xiaobaoaaaaaa/ESPaperPlay-V2/docs/v2/hardware/README.md

# ESPaperPlay v2 硬件设计基线

状态：已完成[r10制造整改](pcb-dfm-r10.md)，160×110mm、236个电气位置加4个机械孔，已完成布线、双内层铺地与原理图一致性核对，0未连接；尚未上电。十一页原理图为[r6模块化绘图](schematic-layout-r6.md)，电气沿用[r5充电与温控](charging-design-r5.md)，774个逻辑引脚保持，ERC为0违规。NTC仍为用户授权的Honeywell曲线假设。更新日期：2026-11-14。

[r10](pcb-dfm-r10.md)已整改64个近焊盘孔、明确11个热孔填平盖帽并补齐官方名义阻抗窗口；203位回流、27位手焊方案保持。当前文件进入板厂生产稿确认与首板准备阶段，尚未下单。r9报告保留历史。

[首批准备r11](first-batch-preparation-r11.md)按5块PCB、先焊2块、280×380×0.10mm无框钢片落实加工要求、64种备料及具体首板工作单。PCB仍r10；工厂真实回复、关键电容来料与维护固件是各阶段的后续输入，尚未对外提交。

用户已经确定复用现有 7.5 英寸屏幕，重做主板；保持 ESP32-S3-WROOM-1-N16R8，暂不增加蓝牙耳机支持。本目录把这些约束转成可用于画原理图和验证样机的设计输入。

## 已确认的范围

| 项目 | 基线 | 实现状态 |
| --- | --- | --- |
| 主控 | ESP32-S3-WROOM-1-N16R8，16 MB Flash、8 MB PSRAM | 固定型号，不迁移到 WROOM-2 |
| 屏幕 | 现有 GDEY075T7-T01、800×480、UC8179，与现有 GT911 触摸总成 | 复用屏幕与纯延长件，以原厂文档针序/机械图设计 |
| 存储 | microSD，SDMMC 4-bit 布线、独立供电、卡检测 | r2已落图；IOX P13独立控制SD_IO_EN，旧固件默认仍为1-bit |
| 音频 | 单扬声器播放、数字麦克风录音、I²S | 用户选3525腔体8Ω/2W；PUI专用声孔封装已有候选，首测48kHz/64fs，声学/贴装待验 |
| 电源 | 单节锂电、带系统电源路径的充电管理、低静态电流 3.3 V 升降压 | 新设计 |
| 电源域 | 屏幕、触摸、SD 和音频分别控制 | 新设计；旧板前三项共轨 |
| 电池管理 | ZON.CELL 755570、1S、标称3.7V、4000mAh，带保护和10kΩ NTC | 按1S/4.2V设计假设、保守容量/负载预算推进；实际CV/NTC及充电仍须验证，R108继续DNP |
| USB | USB-C 供电与 USB 设备模式，保留下载/调试入口 | 首版不提供 USB Host 供电 |
| 操作 | 独立正常电源键、两个可复用的翻页/音量键，另留 BOOT/EN | 新键位与唤醒关系见 GPIO 表 |
| PCB | 四层独立开发板、160×110mm、天线净空、测试点和测流入口 | r10近孔整改、双内层铺地及CAM复核完成；工厂生产稿与实板验证待进行 |

主机接口与内存预算按 N16R8 设计。额外存储通过 SD 提供；16 MB Flash 的分区需给双槽 OTA 和必要离线启动资源留空间，不能直接继承旧版 8 MB 字体分区。完整字体、书籍和媒体放 SD。

## 设计规格与三张设计表

- [首批准备r11](first-batch-preparation-r11.md)：具体加工要求、备料数量、工厂回复模板与两块板独立上电记录。
- [制造整改r10](pcb-dfm-r10.md)：64孔整改、全孔余量检查、11孔明确工艺及官方阻抗窗口。
- [制造装配审查r9](manufacturing-review-r9.md)：工艺能力、Gerber/钻孔回读、自装钢网修正、装配分组及制造放行条件。
- [PCB布线r8](pcb-routing-r8.md)：层叠、USB/SD路径、电源铜阻、回流孔、原生DRC及制造边界。
- [PCB布局r7](pcb-layout-r7.md)：四层独立开发板、接口朝向与机械空间、器件布局、原生检查及后续布线约束。
- [原理图模块化重排r6](schematic-layout-r6.md)：模块内部直连、主件与上下拉/去耦归组，电气与BOM保持r5。

- [2026-11-04设计假设](design-assumptions-2026-11-04.md)：电池保守预算；用户确认纯延长件，以文档针序推进，不再索取额外转接板信息。
- [中顺芯官网电池核查](battery-zoncell-2026-11-04.md)：三线系列4.2V、10–45°C、0.1C充电及175/10kΩ NTC资料；保留精确型号适配和计时验证。

- [充电与温控r5](charging-design-r5.md)：约0.7A、ITERM30mA及独立TS温控的实际原理图、模型和样机验收。
- [开发验证板电源规格](power-design-spec.md)：保留r0工程目标，加入r4反馈/保险丝预算、4000mAh电池和禁充条件。
- [KiCad原理图与当前检查](../../../hardware/devboard-r0/README.md)：十张功能页与一张索引；正式版本与机器检查结果以工程记录为准。
- [条件闭合审查r4](closure-review-r4.md)：30个MLCC候选、7个原空封装、保留的FPC延长链路、反馈/PTC/充电预算及具体剩余门槛。
- [BOM与封装审查r3（历史）](bom-footprint-review-r3.md)：保存当时215个封装、184个MPN和7个封装空缺的审查证据，不覆盖r4选择。
- [外设电路设计r2](peripheral-design-r2.md)：EPD升压/FPC、SD隔离与插座、音频时钟与缓冲，以及尚待验证的电气边界。
- [GPIO 分配与接口约束](gpio-allocation.md)：旧配置事实、新板候选引脚、保留引脚和扩展器取舍。
- [电源域与工作状态](power-domains.md)：供电结构、各状态开关、时序和软硬件契约。
- [功耗与峰值电流预算](power-budget.md)：待填预算、计算方法、测量条件和样机验收。

## 设计环境与原厂资料

- [KiCad 本机环境](kicad-environment.md)：Fedora RPM 安装、标准库配置、命令行检查与重启后的 GUI/3D 检查记录。
- [屏幕与触摸参考](panel-reference.md)：准确型号的原厂资料、接口与机械约束、资料差异及本机下载索引。
- [电源原厂资料](../../../hardware/reference/power/README.md)：电源和控制器件数据手册、修订版本、来源与文件哈希。
- [外设原厂资料](../../../hardware/reference/peripherals/README.md)：r2屏幕驱动、SD隔离/插座与音频候选的资料归档和核对边界。
- [r4闭合资料归档](../../../hardware/reference/closure-r4/README.md)：新增原厂图、精确型号来源、真实文件哈希及在线资料/下载缺口；用户商品截图单独保留。
- [旧版嘉立创工程](legacy-project.md)：原始归档、有效图页、PCB 信息与格式兼容边界。
- [旧板六页静态审查](review/README.md)：已核实的连接、优先修改项、可保留设计与待测项目；包含当前核心板 SD 适配说明。

## 第一块 PCB：开发验证板

先设计一块与最终架构等价、便于测量的开发验证板，再收紧为产品尺寸。它仍使用 N16R8 和现有屏幕，不为测试引入更大的主控或额外内存，以免掩盖资源限制。

- 留出探针与夹具空间，不受最终外壳厚度和按键排布约束；天线、功放、麦克风、开关电源的实际布局约束仍需遵守。
- 每个外设域设置可断开的连接/测流位置，允许分别验证默认状态、上电浪涌、关断漏电和信号倒灌。
- 电池、USB、SYS、主 3.3 V、各外设轨、EN/BOOT、I²C、EPD BUSY、SD 和 I²S 关键节点有标注清楚的测试点；高速支路避免过长测试引出造成信号完整性问题。
- 电源与音频元件周围预留调试替换位置，输入、主稳压和音频支路可独立检查；测试跳线不能让正常使用时绕过电池保护或短接两个电源。
- 验证 USB 插拔与充电运行、低电量瞬态、唤醒与掉电隔离、扩展器复位/总线恢复，以及 SD/音频/Wi-Fi/EPD 并发，再冻结紧凑主板布局。

在验证板前，可以用器件评估板或模块先测充电、稳压与负载开关，这是缩小选型风险的台架工作；模块连线测试不能代替最终 PCB 的功耗、信号完整性与噪声验收。当前交付范围是本地设计文档和固件工程，不包含下单、采购或 PCB 制造。

## 器件候选与尚未冻结的参数

| 功能 | 候选/约束 | 定型前必须确认 |
| --- | --- | --- |
| 充电与电源路径 | **[BQ24074](https://www.ti.com/product/BQ24074) 优先**，BQ25185备选 | r5约0.7A/9.07h和独立NTC温窗已落图；实际曲线、CV及散热待测，RTMR限制18–72kΩ |
| 主 3.3 V | [TPS63802](https://www.ti.com/product/TPS63802) 一类低静态电流升降压 | 最低电池电压时的输出、瞬态、效率、电感/电容与温升 |
| 电量计 | [MAX17048](https://www.analog.com/en/products/max17048.html) | 所选电池与补偿方法，实测荷电状态误差；它不是电池保护电路 |
| 数字功放 | [MAX98357A](https://www.analog.com/en/products/max98357a.html)，受控SYS供电 | 3525腔体8Ω/2W，首轮按输出≤0.5W预算；不加5 V音频升压，实际限幅/功耗/噪声待验 |
| 麦克风 | PUI DMM-4026-B-I2S-R候选；3.3 V、7焊盘、PCB Ø0.60mm声孔 | 专用铜环/声孔/焊膏候选已定义；贴装、声学、生命周期和供货仍待确认，首测48kHz/双32-bit槽/64fs |
| 外设开关与信号隔离 | [TPS22918](https://www.ti.com/product/TPS22918)候选；触摸四线与SD六线使用[TMUX1511](https://www.ti.com/product/TMUX1511)；屏幕/音频使用跨域缓冲 | 默认关断、浪涌、放电与供电过渡逐项验证；音频锁定有Ioff规格的Nexperia 74LVC125APW,118及TI SN74LVC1G14，不能只凭通用型号替换 |
| 低速 GPIO 扩展 | **[TCA9539](https://www.ti.com/product/TCA9539)**，16-bit带RESET | 取代TCA9534候选；GPIO42独立复位、0x74地址，先写安全锁存再方向 |
| 离线时钟 | 低功耗 RTC 可选，不作为第一版必装器件 | 离线精度目标、备份方式、专用唤醒引脚分配 |
| 电池 | 用户选755570、4000mAh、带保护和10kΩ NTC | 商品声明常温2A/低温800mA，瞬时3A时长未给；充电/NTC/保护阈值与线束待核，不批准低温满载 |

ICS-43434 的 [TDK InvenSense 产品页](https://www.invensense.tdk.com/en-us/products/microphone/ics-43434) 在本轮审查时标为 EOL；已有库存可用于参考验证，不进入新版长期默认 BOM，详见音频审查。

下一步按[最新设计假设](design-assumptions-2026-11-04.md)继续制造工艺、插拔空间和线束复核；关键MLCC资料继续核对。电池充电/NTC适配及动态/温升试验在各自阶段完成，不要求所有实测先于测试板制作。F501已选MF-MSMF200/16X-2并按1.08447A输入预算复核高温保持电流；故障保护仍待测。R602已有准确2010候选与电流/端温包络，不能当成升压电流已实测。反馈分压新增约49.34µA的3V3负载须计入P01；默认下拉R215/R223/R306/R416仍为10k，使能高时每个约330µA。

## 资料与验证边界

旧板事实来自提交 `0f6d7c349afdbbeb962a736d84036ce7f8487174` 的 [板级配置](https://github.com/xiaobaoaaaaaa/ESPaperPlay/blob/0f6d7c349afdbbeb962a736d84036ce7f8487174/components/board/include/espaperplay_config.h) 和 [硬件说明](https://github.com/xiaobaoaaaaaa/ESPaperPlay/blob/0f6d7c349afdbbeb962a736d84036ce7f8487174/docs/hardware.md)。这是固件记录，不等同于原理图审查；旧板原理图、PCB、BOM保存在独立的嘉立创EDA Pro工程中，新板原理图位于本仓库的KiCad工程。

屏幕/触摸纯延长链按原厂文档作为设计输入；接触面、方向和尺寸按图纸安排，H01做常规装配检查。供电、触摸选址时序和刷新行为在样机验证。旧版 `docs/storage.md` 的引脚表不能覆盖较新的板级配置。新板候选引脚不应复制进旧板固件，也不能据本目录直接生成生产文件。

硬件发布条件是原理图/ERC、PCB/DRC、GPIO/启动状态核对、器件规格与供货核对、样机电源和功能验证都完成。软件构建通过仅证明固件可以编译，不证明新板已经工作。
