xiaobaoaaaaaa/ESPaperPlay-V2/hardware/reference/charge-r5/README.md

# r5充电电路原厂资料

2026-11-04下载TI TLV1822、BQ24074及Vishay D/CRCW e3原厂PDF；URL、修订说明及SHA256见[sources.json](sources.json)。TLV1822D的8针定义与D0008A示例铜图已经渲染核对，0.25V/4mV表格的12V条件保留为模型限制。

Honeywell曲线复用[先前检索归档](../ntc175-2026-11-04/sources.json)：工程图由经销商镜像提供，不能因此证明电池采用该NTC。中顺芯依据仍为[三线系列官网归档](../zoncell-2026-11-04/)。本轮用户授权将该曲线作为设计假设。

候选型号和封装不等于库存、装配或充电实测结果。详见[设计报告](../../../docs/v2/hardware/charging-design-r5.md)。
