xiaobaoaaaaaa/ESPaperPlay-V2/hardware/reference/closure-r4/README.md

# r4 条件闭合资料索引

日期：2026-11-02。原厂材料保留其原版权；本目录用于开发候选核对，不是制造放行。

索引见 [sources.json](sources.json)，实际文件校验见 [SHA256SUMS](SHA256SUMS)。路径以仓库根为基准。已存在的 r3/电源/屏幕资料复用原文件，不重复保存；新下载的真实 PDF/JPG 放在 `files/`。

- HOAUC、LAILAN 是经销商托管的原厂图；Hirose 是带旧下载水印的原厂旧版图，不冒充 2024 最新版本。
- Phoenix Contact 1751248 型号页与其官方尺寸/孔位图相互对应；2.2mm 焊盘是工程选择，不是原厂孔径要求。
- TDK 精确型号页提供候选身份/规格；没有可归档的有效 DC 偏压曲线数值，因此没有声称最低有效容量已保证。
- PUI 应用指南经官方网页/文档文本核实；原始下载返回验证页面，未保存伪 PDF 或虚构原始文件哈希。
- 电池和扬声器由用户截图选定，另见 [用户资料](../user-selected-r4/selected-components.json)。商品截图不是工厂充电/保护数据表。

完整工程审查见 [r4 报告](../../../docs/v2/hardware/closure-review-r4.md)，逐位候选见 [BOM](../../devboard-r0/review-r4/bom-review.json)。
