xiaobaoaaaaaa/ESPaperPlay-V2/hardware/reference/good-display/README.md

# 大连佳显屏幕与触摸资料

获取日期：2026-11-01。对象是现有 **GDEY075T7-T01** 触摸电子纸总成，来源为大连佳显官方产品页及其指向的 CDN。

- [中文产品页](https://www.good-display.cn/blank7.html?productId=477)
- [英文产品页](https://www.good-display.com/product/483.html)
- [接口核对与待确认事项](../../../docs/v2/hardware/panel-reference.md)
- [完整来源、文件版本与检查记录](sources.json)
- [SHA-256 清单](SHA256SUMS)

| 本机原始文件 | 用途 | 定位 |
| --- | --- | --- |
| `GDEY075T7-T01.pdf` | 总成规格、EPD 接口与参考电路 | p2 版本；p4–8 机械/电气；p38 外置升压外围 |
| `GDEY075T7-T01-CAD.pdf` | 两条 FPC、尺寸、触点厚度与编号方向 | p1 |
| `TP075-Y01.pdf` | GT911 触摸层与 6Pin FPC | p1 |
| `GT911-Datasheet-English-20150625-Rev10.pdf` | 控制器通信、复位、地址选择、电气条件 | p11–12、p22 |
| `T075T7_GT911_Arduino.rar` | 厂商示例，供协议交叉检查 | 内部目录 `T075T7_Arduino_V2.3.5` |

这些 PDF/压缩包是厂商原文件，不属于 ESPaperPlay 的 MIT 授权范围。本目录通过 `.gitignore` 将原文件保留为本机参考；版本库只记录索引、来源和哈希。GT911 文档自身包含 Goodix 的再分发限制。以后克隆仓库时，可按 `sources.json` 的 `asset_url` 从官网下载；不要把下载结果重新授权为本项目代码。

在本目录运行 `sha256sum -c SHA256SUMS` 校验文件。下载需要浏览器 User-Agent / 官网 Referer 时，使用正常浏览器或等效请求头即可。

资料检查记录：

- 总成规格书实际为 13,114,117 字节、45 页，与官网显示的 4.8M 不一致。p2 标为 Rev.1.0 / 2024-03-10，PDF 修改时间为 2025-11-06；保留各字段原意，不将网页更新日期当作新修订号。
- 总成规格书有 PDF xref / `FXE3` 格式警告；未改写原文件，p6、7、8、38 已渲染并目视核对。不能只依赖复制出来的表格文本。
- 总成图纸网页更新于 2025-02-25，图签仍为 2023-05-26。触摸图纸网页也标更新于 2025-02-25，图签仍为 2023-07-12。
- `TP075-Y01.pdf` 中英文官网下载件 SHA-256 相同，仅保留一份。
- RAR5 已通过 libarchive 检查：9 个条目、解压总长 795,521 字节；均为相对路径，无链接和路径穿越。仅在临时目录解包阅读，未执行示例、未写入固件。当前系统的 7z 未包含 RAR 解码支持。
- 网站虽把压缩包分类为 ESP32 示例，内部采用 Arduino A3/A4/A5 等引脚假设，不能直接作为新 ESP32-S3 主板的接线依据。
