xiaobaoaaaaaa/ESPaperPlay-V2/docs/v2/hardware/power-budget.md

# 功耗与峰值电流预算

> 版本说明（2026-11-14）：下文是r4历史预算，包含旧R104=3kΩ/约297mA等值，不是r10现板的充电设置。当前约0.7A/30mA及独立温窗以[r5充电设计](charging-design-r5.md)为准；本批接线和验收使用[r11首板工作单](../../../hardware/devboard-r0/review-r11/first-board-checklist.md)。R108仍DNP、J105开放，实测列仍为空。历史计算保留供追溯。

> 2026-11-04补充：[电池保守预算](design-assumptions-2026-11-04.md)暂用75%可用能量系数、20–30°C、总电池电流≤1A且不另给短峰值余量。低负载例约0.869A；下文r4主轨1A/1.5A数字保留为台架能力目标，不是本阶段实物电池负载许可。

状态：预算与测量模板，保留[电源规格](power-design-spec.md)的首轮台架目标，更新至[r4条件闭合](closure-review-r4.md)。**已有十页原理图r4候选，用户已选755570/4000mAh电池与3525腔体8Ω/2W扬声器，尚无PCB样机、电流或续航实测值，制造BOM未冻结。** `待定`/`未测`不是零，也不是通过。本文区分器件计算包络、商品声明与整机测量。

## 统一计算口径

- 能量使用 Wh，功率使用 W，电流使用 A，时间使用 h；短脉冲记录另外使用 ms/µs。
- 先记录各输出电源轨的负载，再按对应效率换算到电池端；不要把 3.3 V 轨电流与电池电流直接相加。
- 持续额定值、典型平均值、瞬态峰值分别填写。数据手册条件和实测条件必须保留。
- 电池最低工作电压、允许温度范围、扬声器最大音量、Wi-Fi 发射、SD 写入和屏幕启动是峰值验证的重要组合；具体边界由器件规格与最终使用要求确定。

## 器件与电源轨预算表

| 负载/电源路径 | 供电轨 | 持续最大电流预算 | 瞬态峰值及持续时间 | 关断/待机电流 | 当前依据/状态 |
| --- | --- | --- | --- | --- | --- |
| S3 模组，含 Flash/PSRAM | 3V3_AON | 待定 A | 待定 A / ms | 未测 | 按 N16R8 模组与实际 CPU/Wi-Fi 模式核算 |
| EPD 驱动与面板 | EPD | 待定 A | 待定 A / ms | 未测 | r2已按参考电路绘制升压与输出缓冲；全刷/灰阶/上电波形待测 |
| GT911 触摸 | TOUCH | 待定 A | 待定 A / ms | 未测 | 普通扫描与实际待机模式分别测量 |
| microSD与六线隔离 | SD | 待定 A | 待定 A / ms | 未测 | 包括两颗TMUX1511和卡侧上拉；用最终卡型测启动、写入和内部整理脉冲，核对候选插座0.5 A额定值 |
| 数字麦克风与输出缓冲 | MIC | 待定 A | 待定 A / ms | 未测 | PUI DMM-4026-B-I2S-R专用声孔封装候选已定义，首测48kHz/64fs；计入Nexperia 125与TI施密特1G14，贴装/供货待核 |
| 功放与扬声器 | AMP/SYS | 待定 A | 待定 A / ms | 未测 | 已选8Ω/2W商品，首轮按音频输出≤0.5W作预算；实际限幅、效率和电流待测 |
| GPIO 扩展器与 I²C 上拉 | AON | 待定 A | 待定 A / ms | 未测 | 包含静态拉低时的电阻电流和掉电支路漏电 |
| EPD BUSY与麦克风数据返回缓冲 | AON | 待定 A | 待定 A / ms | 未测 | 两颗SN74LVC1G125保持AON供电，计入睡眠静态电流与输入状态影响 |
| 电量计/检测/可选 RTC | BAT/AON | 待定 A | 待定 A / ms | 未测 | 逐项记录供电位置，避免重复计入 |
| 主升降压损耗 | SYS→3V3 | 不作为输出负载重复相加 | 按最差输入检查 | 未测 | 按工作点效率曲线与样机测量换算 |
| 充电芯片/保护/负载开关 | USB/BAT/SYS | 按路径计算 | 待定 | 未测 | 计入静态电流、压降和各器件关断漏电 |

TPS63802 标称输出能力与静态电流可以帮助选型，但不等于整板在最低电池电压和最高温度时仍具备相同供电能力；电感饱和、限流、PCB 散热和瞬态都须核对。[候选稳压器数据](https://www.ti.com/product/TPS63802)

## r4已计算边界

以下来自[电源边界计算](../../../hardware/devboard-r0/review-r4/power/power-bounds.json)和[独立温漂复核](../../../hardware/devboard-r0/review-r4/audio_boost/independent-power-review.json)，全部是指定假设下的预算，**没有填入实测列**。

| 项目 | 当前计算 / 选择 | 适用条件与剩余验证 |
| --- | --- | --- |
| 主轨反馈 | R201=51.1kΩ / TNPW060351K1BEEA；R202=9.10kΩ / TNPW06039K10BEEA，均0.1%/25ppm；PWM包络3.2494–3.3666V | 电阻本体−40～85°C，每颗0.1%老化预算，PWM反馈±1%及保守±100nA输入偏流模型；PFM/瞬态/布局仍待测 |
| 反馈静态负载 | 精确3.3V时分压54.82µA，较旧511kΩ/91kΩ多49.34µA | 这是3V3轨负载，须计转换效率才能与电池端P01比较；不是待机实测 |
| BQ可编程输入档 | R103=1.62kΩ±1%，温漂后约0.91084–1.07947A；加5mA旁路分配为 **1.08447A** | 外阻100ppm/K、−40～85°C、未计老化；BQ电气参数只保证TJ0～125°C，不能外推负温度 |
| F501正常保持 | MF-MSMF200/16X-2；Ihold50°C=1.68A、60°C=1.48A；预算占60°C保持值73.27% | 已解决原110型号的高温正常载流不匹配；短路、TVS、高温阻值/压降及实际温升待测，默认100mA不变 |
| BQ充电与定时 | R104=3kΩ候选为0.26134–0.33043A；R105=68kΩ为6.688–11.521h，名义9.07h | 同上温漂与结温范围；4Ah÷296.67mA约13.48h，现组合不批准充电，R108保持DNP；RTMR只允许18–72kΩ |
| 电池首轮负载 | 20–30°C、主轨1A、音频输出0.5W，估算约1.592A | 假设SYS2.9V、两个效率各85%、其他电池电流50mA；2A只是商品常温连续声明，实际压降/保护/效率待测 |
| 主轨1.5A压力点 | 加相同音频估算约2.261A | 先用台架源；商品瞬时3A未给时长/保护延时，不能据此批准所选电池的100ms测试；10°C以下无满载许可 |

电池截图与边界见[用户配件清单](../../../hardware/reference/user-selected-r4/selected-components.json)。常温/低温声明不能用作充电温区；当前没有已验证的TS到MCU温度测量路径，以上限制尚不是自动执行的固件功能。

关键电容的有效容量验收为：C102在5.0V、C103在4.5V各≥4.7µF（项目保守规则）；C201在5.0V≥4µF、C202在3.6V≥7µF（TPS63802明确有效值）。准确MPN不等于偏压/温度/老化已经通过。CT改为C0G±5%；各域直接并联标称总量为EPD27.8µF、SD32.3µF、TOUCH4.9µF、MIC2.3µF、AMP32.1µF，22µF器件实际为±20%。[电容计算](../../../hardware/devboard-r0/review-r4/capacitors/calculations.json)列出正公差与温度预留情景，用于涌流试验起点；它不是所有偏压/温度组合的保证上界。EPD高压电容充电能量另计，C602按端到端应力、C610按VCOM核验。

## 工作场景预算表

每个场景最终需保存原始仪器数据和固件版本。目标电流与通过阈值必须在样机验收前填写，不能事后按测量结果调整为“通过”。

| 场景 ID | 场景 | 平均电池电流目标 | 平均实测 | 峰值实测/时长 | 占空比或每日时长 | 状态 |
| --- | --- | --- | --- | --- | --- | --- |
| P01 | 软关机：深睡、各外设轨关闭 | ≤200 µA，3.7 V/25±5°C/无USB，稳定后10 min平均 | 未测 | 未测 | 待定 | 未验证 |
| P02 | 静态阅读：触摸可唤醒、无网络任务 | 待定 | 未测 | 未测 | 待定 | 未验证 |
| P03 | 连续翻页：固定书籍、字号、刷新策略 | 待定 | 未测 | 未测 | 待定 | 未验证 |
| P04 | 全刷/灰阶单次刷新 | 待定能量/次 | 未测 | 未测 | 待定次数 | 未验证 |
| P05 | Wi-Fi 连接、TLS 建连、下载写卡 | 待定 | 未测 | 未测 | 待定 | 未验证 |
| P06 | 本地音频，指定文件/音量/扬声器 | 待定 | 未测 | 未测 | 待定 | 未验证 |
| P07 | 网络音频，指定缓冲与信号强度 | 待定 | 未测 | 未测 | 待定 | 未验证 |
| P08 | 录音到 SD，指定采样格式 | 待定 | 未测 | 未测 | 待定 | 未验证 |
| P09 | 阅读翻页 + 音频 + 网络传输 | 待定 | 未测 | 未测 | 压力测试 | 未验证 |
| P10 | USB 插入/拔出、边充边用 | 待定温升/压降 | 未测 | 未测 | 压力测试 | 未验证 |

## 计算方法

电池侧工作点功率估算：

```text
P_bat ≈ Σ(P_rail / η_path) + P_always_on_losses
I_bat ≈ P_bat / V_bat
```

每条路径只计一次损耗。若效率已经包含某静态损耗，不再重复添加。瞬态计算使用同一时刻可能出现的负载组合；并非把所有互斥功能的最大电流相加。

续航估算：

```text
E_usable = C_nominal_Ah × V_nominal × k_usable
P_average = Σ(duty_i × P_bat_i)       # Σ duty_i = 1
t_hours ≈ E_usable / P_average
```

`k_usable` 包含截止电压、温度、老化及实际电池可用容量的影响，必须给出来源；不能默认等于 1。若使用实测电池端平均功率，不再次扣除电源转换效率。

输出保持电容的初步估算：

```text
C_ideal ≥ ΔI × Δt / ΔV_allowed
ΔV_total 包括电容放电、ESR、走线和稳压器动态响应
```

该式只用于确定测试和仿真起点，不能替代稳压器稳定性要求、实际电容偏压降额及示波器测量。

线性充电热预算可用 `(V_input - V_battery) × I_charge` 估算充电支路损耗，再增加系统电源路径等损耗。系统负载占用输入功率后，实际充电电流也可能下降。所选4000mAh电池尚缺允许充电电流/温窗、CV容差和NTC曲线；现有约297mA与9.07h配置未批准，R108保持DNP。DPPM/VIN-DPM/热降流会减慢定时，不能用容量除电流预测完整CC/CV时间，也不能扩大RTMR到72kΩ以上或翻转CE绕过超时。[BQ24074资料](https://www.ti.com/lit/ds/symlink/bq24074.pdf)

整机静态预算须包含：TPS63802反馈分压（r4在3.3V时约54.82µA）、负载开关关断电流、BQ的CE/EN网络、IOX_RESET下拉、VBUS检测、I²C上拉被拉低时的电流、MAX17048模式和EXT0保留的RTC外设。MAX17048位于BAT端，不能只测3V3轨就声称得到整机功耗。新分压增加49.34µA，不降低P01≤200µA工程目标；需由样机确认剩余预算是否充足。

r2的R215/TOUCH_IO_EN、R223/SD_IO_EN、R306/AMP_SHUTDOWN、R416/AUDIO_EN均为10k下拉。各控制为3.3 V高时，每个名义消耗约330µA；按场景统计实际拉高数量，再换算电池侧功率，不把四项一律加到P01软关机。SD_IO_EN来自IOX P13，与P01端口的SD_EN独立；上电等待稳定期间只开SD电源，尚不接通信号。此处IOX P01是端口名，与场景P01不同。

## 台架记录与验收

验证顺序：可选的独立电源/音频模块台架 → 架构等价的开发验证 PCB → 紧凑产品 PCB。第一个阶段用于筛选器件，第二个阶段填写本表中的整板数据；第三个阶段改布局后至少重验电源瞬态、待机电流、RF/音频干扰和总线完整性，不能直接沿用开发板的通过结论。

测试记录至少包含：板修订、器件/BOM 修订、固件 SHA、电池或电源电压、USB 来源及电流限制、环境温度、SD 型号、扬声器负载/音量、屏幕刷新模式、Wi-Fi 条件、测量带宽与采样率。短峰值使用合适带宽的电流测量和示波器，普通万用表平均值不能证明峰值满足要求。

| 检查项 | 验收条件 | 证据 |
| --- | --- | --- |
| 供电稳态与峰值 | 全部电源轨在最终器件工作范围内，峰值组合无 brownout/复位；阈值在定型后填写 | 电压/电流波形、日志 |
| 休眠功耗 | P01/P02 满足预先确定的整机预算，各域漏电可解释 | 电池端与各支路数据 |
| 外设掉电隔离 | 关轨后没有超规格反向注入或导致 AON I²C 锁死 | 各域电压、漏电和总线恢复测试 |
| USB 切换 | 插拔 USB 不造成无意复位或数据损坏；输入限制遵守电源能力 | 供电波形、文件校验 |
| 充电与温度 | 电池/充电芯片/稳压器温度在规格内，NTC 故障路径有效 | 热测量、充电状态记录 |
| 音频/显示并发 | SD、I²S、Wi-Fi 和 EPD 并行时无供电引起的丢流/刷新错误 | P09 波形与日志 |
| 启动与恢复 | 冷启动、MCU 单独复位、欠压、I²C 错误后进入可诊断状态 | 重复测试记录 |
| SD 断电时序 | 正常关机先关闭文件/卸载；异常断电后用户数据按设计恢复 | 文件校验与故障注入记录 |

## 开发板分项执行顺序

所有项目当前均**未执行**。先无真实电池检查，再用限流电源/电子负载验证；涉及回充的BAT仿真必须能吸收充电电流，普通只供电的台式电源不能直接代替电池。

| 编号 | 场景 / 注入条件 | 通过条件（保留r0目标，加入r4约束） |
| --- | --- | --- |
| H01 | 断电检查、GPIO高阻、IOX复位；SYS/3V3注入口互锁；USB在而AON关闭 | 接口极性/封装一致；无USB绕过充电器进入BAT路径；外部注入不并联上游；VBUS检测不倒灌且AMP关闭 |
| H02 | 台架源主稳压独立测试，按3.0–4.2V电池范围及路径压降扫SYS | 主轨1A持续、1.5A/100ms脉冲；稳态±3%、瞬态±5%，同时满足接收器更严格范围；记录效率/热稳态。所选电池未获该脉冲组合许可，反馈计算通过不替代PFM/瞬态测量 |
| H03 | USB100/500/可编程档，空电池、无电池、低电池、ROM下载 | 测包含旁路支路的总输入电流；未知源不升档；无重启循环；自动恢复未通过则保留维护配置限制 |
| H04 | 充电禁用/使能，NTC开路/短路/冷热边界，定时器、重复复位 | 资料齐备且ISET/TMR重新适配后才使能；当前R108 DNP。电流/CV/温窗在电池规格内；RTMR18–72kΩ，跨重启保留故障，未知记录不自动启充；禁止用约13.48h理想比值当充满时间 |
| H05 | USB插拔、PGOOD延迟、主机配置/挂起/恢复 | 无意复位/文件损坏为零；模式遵守供电授权；仅VBUS变化不足的故障由电源维护重试恢复。记录VBUS释放延迟与漏电，沿用r1提出的≤1 s目标，分别测USB/BENCH选源和PTC动作；检测位于USB保护之后、选源之前，不将台架供电认作USB |
| H06 | EPD/TOUCH/SD/MIC/AMP分别开关，AON异常掉电、支路残电 | 浪涌不破坏AON；关轨1 s后低压支路<0.2 V；触摸/SD先隔离再关轨；测TMUX供电过渡和MIC/AMP不同衰减时的注入，不以VDD=0的Ioff代替全过程验证；引脚不超规格，AON I²C可访问 |
| H07 | GT911低/高地址复位及掉电，I²C卡死 | INT双向时序完整；触摸隔离后AON总线可恢复；不能在SD写入时直接复位全部IOX |
| H08 | 冷启动、EN、软件重启、看门狗、brownout、hold遗留 | 进入已知可诊断状态；区分异常写入中断与正常卸载，不把GPIO默认状态当保证 |
| H09 | 正常关机与SD卸载/EPD BUSY超时注入 | 成功才关轨；正常准备失败保留必要轨并恢复业务；验证文件校验 |
| H10 | 无USB软关机、插拔唤醒、充电深睡、触摸阅读待机 | 电源键释放/电平竞态无重复唤醒；充电深睡仅用于批准来源；P01≤200 µA，其余场景实测后填表 |
| H11 | 已批准温区/电源下，低电压、Wi-Fi+SD写入+EPD刷新+语音 | 无供电引起的brownout/丢流；先台架测真实同时峰值，再与所选电池连续/脉冲/保护条件比较，不能以商品3A无时长声明或1A主轨目标代替验收 |
| H12 | 各电源档持续充电+运行至热稳定 | 电芯、电源IC、电感、连接器均满足已批准温度/电流限制；热限流不被当作正常充电能力 |
| H13 | SD上电/卸载/卡检测/拔卡，400kHz初始化与4-bit 20MHz运行起点 | SD_EN开轨且稳定后才开SD_IO_EN；停止SDMMC并隔离后才断轨；卸载超时不直接断电。核对卡峰值、插座额定值、总线波形与文件完整性，速率起点不表示吞吐保证 |
| H14 | 音频48kHz、双32-bit槽、64fs=3.072MHz；静音/录音/播放及两轨异常掉电 | 核对左右槽与软件混音、麦克风稳定数据丢弃、静音和恢复；不只撤WS而保留BCLK。分别测MIC/AMP掉电注入、爆音与负载功耗，不把共用GPIO当成同步衰减保证 |
| H15 | EPD上电、全刷/灰阶与休眠，升压节点及BUSY异常 | C602测FLY−SW差分波形；包含VCOM及所有高压电容的偏压/纹波。R602验证Irms≤1A/Ipeak≤2A/端温≤110°C且服从MOS/电感等更严限制；不将此包络当已测电流，不把低压1s放电目标套到高压节点；超时不得按休眠成功关轨 |

下一步以文档定义FP24/FP6纯延长连接，并按保守电池假设完成布局；继续核对MLCC偏压数据，充电/NTC适配与各项台架记录安排在对应验证阶段。候选封装已补齐，贴装与声学仍需验证；续航目标和允许温升也仍是待确定的设计输入。没有实测前不发布续航承诺，既定目标不得在测试后反向设成“恰好通过”。
