xiaobaoaaaaaa/ESPaperPlay-V2/hardware/devboard-r0/review-r11/factory-capability-review.md

# r11 投板前：工厂能力与生产稿核对

2026-11-14。源板仍为 r10，SHA-256 `e7be650716b6b75f3b8d33ccc13a1d7717db9a022a3d4e6a25f0df748bae1a24`。本次只读检查公开能力和现有文件，没有上传设计、联系工厂、建立订单或付款。用户已决定 **5 块裸板、先焊 2 块、1 张无框钢片、胶带铰链手工定位**。这些是工程准备数量，不是订单结果。

## 新增结论

### 1. 无框钢片可以定为 280 × 380 × 0.10 mm

已在[嘉立创钢网当前计价页面](https://www.jlc-gw.com/quote-online/steelmesh)实际选择“SMT钢片（不带框）→标准尺寸”，读取到 28×38 cm 的可选规格，有效面积为 20×36 / 26×30 cm。160×110 mm 板可居中安排，按板长边沿钢片 280 mm 边时，钢片相对板框两侧各余 60 mm、上下各余 135 mm，足够安排胶带和刮刀起落区。这里的余量是排版计算，不是工厂承诺的定位精度。

选 **一张完整钢片，保留四周余料**，不要选“按PCB外形1:1切割”。只开顶层、锡膏网、不加MARK通孔，保留所有既定膏口；0.10 mm 厚度写入备注并在生产稿确认。板上有 0.5 mm 及更细间距器件，采用电解抛光作为本批工程选择。网站普通钢片和抛光的显示单价不是本项目完整报价，不据此承诺总价。

### 2. 必须阻止钢网厂再做默认膏口修改

[官方钢网制作说明](https://www.jlc.com/portal/server_guide_17856.html)明确，默认会再次处理焊盘，要求原样制作时应只提供一层 Gerber 并备注按文件 1:1 开孔。因此 r10 的单层专用钢网包是正确输入；订购时还应选择“需要确认PDF档”，核对后才放行。单凭 ZIP 正确不能保证工厂不会再次删减或缩放。

核对点：203 个回流位置、636 个膏口；U301 仅外围 40 脚；6 个 DNP、4 个手焊 SMD 接口和所有 THT 均无膏；U803 中心钢岛有四条 0.15 mm 桥。要求同时返回加工 Gerber 或可测量的矢量生产稿，不能只凭低分辨率截图接受。0.10 mm 钢片和麦克风桥宽仍需首板试印/声学验证。

### 3. 阻抗订单必须选 ±10%，随包给出表格

[国内阻抗设计说明](https://www.jlc.com/portal/server_guide_38565.html)区分“阻抗值 ±10%”与只控制线宽线隙的“无要求/±20%”，并要求随工程文件附阻抗表或图。r10 的官方计算器窗口是设计依据，不能代替这项订单选择。

| 网络组 | 信号层 | 相邻参考层 | 类型 | 设计值及允许范围 | 图上主线 W / S |
|---|---|---|---|---|---|
| USB D+/D− 对 | F.Cu / L1 | In1.Cu / L2，GND | 差分 | 90Ω ±10%（81–99Ω） | 0.26 / 0.15 mm |
| USB D+/D− 对 | B.Cu / L4 | In2.Cu / L3，GND | 差分 | 90Ω ±10%（81–99Ω） | 0.26 / 0.15 mm |
| SD CLK/CMD/D0–D3 主线 | F.Cu / L1 | In1.Cu / L2，GND | 单端 | 50Ω ±10%（45–55Ω） | 0.35 mm / 不适用 |
| SD CLK/CMD/D0–D3 主线 | B.Cu / L4 | In2.Cu / L3，GND | 单端 | 50Ω ±10%（45–55Ω） | 0.35 mm / 不适用 |

这是主线几何要求，不能把器件焊盘、局部扇出、过孔和调试支路宣称为均匀传输线；既有 SD 支路和转层仍需实测。实际测试 coupon 的层别/结构、测量结果是否随板提供也应列入确认。

需要特别核对国内生产参数：[国内层叠说明](https://www.jlc.com/portal/q6i36372.html)用于阻抗计算的外层 1 oz 铜厚为 1.6 mil（0.04064 mm），基材/走线上的阻焊厚度为 1.0/0.6 mil；r10 国际计算器记录的外层铜厚为 0.035 mm。两份模型参数并非完全相同，不能仅凭“7628/1oz”名称视为相同计算。生产稿需确认完整 `JLC04161H-7628` 或经复核的等效叠构、介质、铜截面与补偿；不擅自用默认叠层或全板改线宽。此处保留 r10 已通过的名义窗口结论，没有伪造国内模型重新计算结果。

## 裸板基本能力与文件一致性

根据[国内加工能力页](https://www.jlc.com/portal/vtechnology.html)，本板 160×110 mm、四层、1.6 mm、外 1 oz/内 0.5 oz、绿油 ENIG 与 Ø0.20 mm 机械孔均在公开能力范围；11 孔的 Ø0.20 mm 树脂填平盖帽要求也落在其孔径范围内，所选盖帽铜厚≥10µm仍是提交要求。该网页不证明本订单已被接受，也不保证只处理或只收费11孔。四层盘中孔是额外工艺，不能按六层默认免费条件估价。[盘中孔说明](https://www.jlc.com/portal/factoryVisitDetails/38630)

本轮另外从原生板只读提取了实际线宽、孔间距和 USB 槽几何，结果见 [factory-geometry-check.json](factory-geometry-check.json)。这补充检查实际最小值，不修改已有规则或代替 r10 的 DRC/CAM 回读。孔径/阻焊对位/板厚公差仍以订单确认与来料为准，尤其麦克风 Ø0.60 mm NPTH 的畅通程度。

## 工厂回复逐项判定

| 项目 | 应取得的具体回复/资料 | 不能接受的替代说法 |
|---|---|---|
| r10 文件身份 | 确认裸板与钢网分别来自本批附件，CAM 与当前板框、层序、孔数一致 | 复用 r8/r9 生产稿、把160.05×110.05当成板框 |
| 11 个 IC 热孔 | 精确对应附表；树脂填平、铜盖帽≥10µm、ENIG；明确凹陷/凸起控制和实际填孔范围 | 普通盖油、半塞油、把热焊盘盖住 |
| 扩大填孔范围 | 列明扩大至哪些 via，仍保证95个普通组件孔和7个NPTH畅通 | 按孔径把所有小孔一起堵住 |
| 普通过孔 | 按所供阻焊图盖油；承认盖油可能不完全封孔，11热孔除外 | 将本项目0.20mm设计间距说成保证100%塞油条件 |
| 阻焊 | 保留现有局部开窗、U803声孔与绿油桥；任何CAM改动供复核 | 未经核对全板缩成1:1或统一扩窗 |
| 阻抗 | 四行表、±10%订单项、真实层叠与补偿、测试方式及报告 | 只选“无要求/±20%”，却称已做阻抗保证 |
| 钢片 | 完整280×380mm、0.10mm、1张正面、1:1专用膏口、四桥、加工稿确认 | 按PCB外形裁掉定位余料、重新生成默认膏口 |
| 费用/交期 | 数量5板+1钢片，明确填孔、阻抗、ENIG、抛光、运费及适用交期 | 将网页起步价当本项目到手价 |

以上只有真实工厂订单/生产稿能够最终闭合，未将空白回复标为通过。工程输入已可整理成一次完整核对；不需要为相同问题重复创建新的 PCB 版本。
