xiaobaoaaaaaa/ESPaperPlay-V2/hardware/devboard-r0/review-r11/first-board-checklist.md

# r10 首板装配与分域上电工作单（r11 准备）

2026-11-14。对象是 r10 PCB，计划 5 块裸板、先装 2 块，采用无框钢网、胶带铰链定位和自行回流，接口/排针后手焊。**本文件是待执行步骤，未进行制板、焊接、烧录或实测。** 每块板单独复制填写[测量模板](first-board-measurements.json)，不要把第一块的结果当作第二块结果。

连接依据为当前十一页原理图重新导出的 XML：181 个网络、774 个节点，与 r6 归档连接一致。本文用 `J编号.脚号` 和电阻焊盘作探测位置；本板没有另行命名的 `TPxxx`，不要按臆造测试点接线。所有改跳帽、拆测流连接、接排线和换供电均在断电并确认残压后进行。

## 本轮发现的实际前置条件

1. 当前 [`v2/main/main.c`](../../../v2/main/main.c) 仍是 M0 启动骨架，明确不初始化外设 GPIO、总线、显示、音频或休眠；完整分域测试需要另行实现并审查维护固件。GPIO/寄存器建议见下文，不能把本工作单当成固件已实现的证明。
2. J101 提供 5 V，但 BQ24074 默认 EN1/EN2=00，输入仍受 USB100 限制。无电池时 MCU 冷启动不保证成功，不能一遇复位就把 BQ 改高档。本流程先用 J101 测空载输入路径，再改用 J102 的受限电池模拟供电启动 MCU。
3. J401–J405 是各域输出测试口，不是隔离的供电入口。仅拆 R402/R405/R408/R411/R414 后，QOD 路径仍连着负载；本流程不向这些口外部注电。
4. 关键 MLCC 有效容量、实际焊膏/回流温程和贴装可购料必须按对应审查落实。隐藏焊盘/散热孔的焊接完整性不能靠 DRC 或只看外围焊点证明。首板焊接和功能检查仍是验证工作，不是量产验收。

## 装配和断电检查

- 使用当前 [r10 钢网/查位图/BOM](../output/manufacturing/r10-review/README.md)。先在无焊膏状态试放钢网并对光检查对位，确认胶带铰链回落后不会滑移；用余板/垫板支撑钢网，不能让板翘曲。首板试印后放大检查 U101/U201/U802、U301 外围 40 脚、U803 声孔四桥及相邻细间距焊盘，有偏移、连膏或漏印则清洗重印。
- 回流 203 位，后手焊 27 位，6 位 DNP：C501、C502、J301、J302、J303、**R108**。**J105 始终开放**。U301 中心焊盘不印膏；U803 Ø0.60 mm 声孔不得堵塞。不得直接照抄通用 260°C 曲线；用实际焊膏工艺及所有器件耐温约束制定并测量板面温程。
- 用显微镜核对 IC 1 脚、D501/D601–D603 方向、MOS 管和 U803 方向，检查连锡、立碑、FPC 焊点、USB/卡座机械脚与板边干涉。先暂不插电池、屏幕、触摸、SD 卡、扬声器或 USB。
- 核实 J102.1 为电池包保护后正端、J102.2 为公共地；J103.1 为 NTC、J103.2 为地。线色不能代替通断/极性核对。屏幕和触摸纯延长链按原厂编号核对端到端通断、接触面和相邻针无短路。
- 对 VIN_5V、BAT_PROT、SYS、3V3_AON 及五路输出分别测对地电阻/二极管档的两个方向，记录等待电容充电后的值。这里没有统一的“必须大于多少Ω”或蜂鸣判据：芯片结、反馈分压和 QOD 会影响读数；稳定近零值需定位后再上电。
- 对 R101、R102、R203、R402、R405、R408、R411、R414 核实装配连续性；本基础流程均保持实装。确认 R108 焊盘未被连锡短接、J105 无跳帽。两块板均完成这一检查。

## 供电入口和测量位置

| 位置 | 真实网络/用法 |
|---|---|
| J101.1 / .2 | BENCH_5V / GND；只接已知、限流 5 V。没有 USB 支路的 F501/TVS 保护 |
| J502.1 / .2 / .3 | USB_5V_PROTECTED / VIN_5V / BENCH_5V；只能装一个跳帽，1–2 选 USB，2–3 选台架 |
| J102.1 / .2；R102.2 | 电池包正端 / GND；R102.2 是 BAT_PROT，可测到进入 BQ 与电量计的电压 |
| R101.1 / .2；J104.1 / .2 | SYS_RAW / SYS；J104 是 SYS/GND，默认只作测量 |
| R203.1 / .2；J201.1 / .2 | 3V3_REG / 3V3_AON；J201 是 AON/GND，默认只作测量 |
| J202.1 / .2 / .3 | MAIN_EN_PULL / MAIN_EN / GND；1–2 运行，2–3 关闭，开路默认关闭 |
| J203；J204.1 / .2 | J203 默认开放（自动省电模式）；J204 是 REG_PG/GND，3V3_REG 上拉 |
| J205.1…6 | AON、GND、SDA、SCL、IOX_RESET_N、VBUS_SENSE_N；不用外部开发板电源并联 AON |
| J206.1…6 | EPD_EN、SD_EN、TOUCH_EN、TOUCH_IO_EN、SD_CD_N、GND；这里**没有 SD_IO_EN** |
| J401/J402/J403/J404/J405 | 1 脚分别是 EPD_3V3/SD_3V3/TOUCH_3V3/MIC_3V3/AMP_SYS，2 脚均为 GND |
| J105.1；R109.1/R110.1 | CHG_CE_N；USB_EN1/USB_EN2，均只探测，不短接 |
| J801.1 / .2 | 扬声器 SPK_P/SPK_N，两端均非地；用差分测量，示波器地夹不得接任一端 |

除普通低压轨外，EPD 升压和飞跨电容按面板规范单独测量。C602 测的是 FLY−SW 差分；不可用接地探头地夹短接浮动节点。关断后确认储能节点释放，再接插排线。

## 分阶段上电

下列 **50 mA、300 mA 和 500 mA 是工程起始限流设置，不是器件规格或通过阈值**。供电应支持可见的 CC/CV 状态、限流和输出关闭；先在离板状态验证端子电压和极性。限流启动可能造成掉压，遇到异常先关电并判断是短路、浪涌还是限流触发，不能盲目加大电流。每步记录环境、实际供电、电流、轨电压、波形和热点；低负载下快速异常升温即停止排查。

| 步骤 | 断电时设置及操作 | 预期/记录与停止条件 |
|---|---|---|
| B01 输入路径 | 实体电池/USB/全部外设断开；J202=2–3，J203/J105 开放，R108 DNP；J502=2–3。J101 接 5.00 V、50 mA 限流后开启 | 记录 J502.2、R101.1、J104.1、J105.1。轻载且输入余量充足时 SYS_RAW 应在 4.3–4.5 V；CE_N≥1.4 V、EN1/EN2≤0.4 V。AON 无电时 PGOOD/CHG 的上拉也无电，**不能据此判状态高低**。检查无持续限流/异常温升。随后关闭、拔掉 J101 线和 J502 跳帽 |
| B02 电池路径/稳压关闭 | 保持真实电池、USB、J101 断开及 J502 拔除；J202=2–3。把台架输出设为 **3.70 V、50 mA**，接 J102.1 正/.2 负；不是把真实电池并联到电源 | 记录 BAT_PROT、SYS_RAW/SYS。SYS 随模拟电池及路径压降变化，不应套用 4.4 V 判据；3V3_AON 与外设尚不应被激活。输入未被选入，不能进行充电。记录未驱动轨的实际残压，不把主稳压关断当作主动放电保证 |
| B03 主轨，MCU 保持复位 | 关闭台架；J202 改 1–2；按住 SW301 RESET，再开启 3.70 V/50 mA。J203 仍开放 | 测 R203.1、J201.1 和 J204.1。主轨项目稳态目标 **3.201–3.399 V（3.3 V±3%）**；记录爬升/纹波。全部域使能和隔离使能应为低，五路低压输出稳定后目标<0.2 V。若限流不能建立主轨，停止定位，不把电源限流下的电压当稳态结果 |
| B04 MCU/原生 USB | 完成 B03 后断电，把限流设为 300 mA；同时按住 BOOT 与 RESET，再开启3.70V台架，先释放 RESET、随后释放 BOOT 进入 ROM 下载模式；**J502 始终拔除**，J101 仍断开。需要 USB 时再插 J501，仅用于数据及 USB 支路检测 | 在板端量 AON，无意复位为失败。确认为正常启动电流且排除短路后，可记录理由将台架限流改至 500 mA再测。USB 受电被 J502 与 BQ IN 隔离；验证 VBUS_SENSE_N 插入低、拔出高。不能宣称完整 USB 总线供电/挂起规范已通过。只用已经审查的维护固件；现有 M0 只能做自身启动检查 |
| B05 AON 控制/电量计 | 需维护固件，保持模拟电池单源供电；不接外部 I²C 主机争用 | GPIO4/6 保持低；先显式复位 IOX，再按下文写安全锁存/方向并读回。识别 0x74；MAX17048 0x36 的电压与表计比较，仅标模拟源电压，SOC 保持无效。无 BAT 供电下的 I²C/ALRT 漏电属于后续专测，不用 ACK 推断电池存在 |
| B06–B10 单域 | 每次断电插接一项负载；按下表开轨/通信/关闭，其他域关闭 | 记录电压/浪涌/稳定时间/关断残压、跨域注入和功能。先完成单域再进行组合；不能把统一固定延时当所有器件就绪判据 |
| B11 充电/真实电池 | 当前不执行；R108 DNP，J105 开放 | 真正启充需另行完成电池极性/CV/实际NTC曲线、温窗/故障/热/定时验证，并使用合适的电池模拟吸收设备或受控电池测试装置。**普通只能输出的台架不能用来吸收充电电流**；本单源 J102 方案不可直接加上 J502 跳帽变成充电测试 |

B01 的 BQ 电压、电平与电源路径依据来自 [TI BQ24074 Rev.N，§7/8.5/9.3](https://www.ti.com/lit/gpn/bq24074)；50 mA 等测试设置不来自该规格表。B03 稳态窗口和五路关断 1 s 内<0.2 V 是[项目目标](../../../docs/v2/hardware/power-design-spec.md)，不是器件实测结论；主轨瞬态项目目标另为 3.135–3.465 V，按负载端更严范围收紧，不能拿它代替稳态窗口。

## 维护固件需要实现的最小契约（当前缺失）

从新板 GPIO 映射建立独立板型，禁止复用旧板直接驱动。初始应清理遗留 hold、GPIO4 AUDIO_EN=0、GPIO6 AMP_SHUTDOWN=0，GPIO42 IOX_RESET_N 明确拉低再释放；脉宽 10 µs 仅作为项目起点，验证时实际抓取复位波形。先保证这些状态，再初始化 AON I²C。

TCA9539 地址 0x74，复位后方向均为输入，但输出锁存均为 1。因此本轮仅开放五个域控制：先写寄存器 0x02=0x00、0x03=0x00，再写 0x06=0xF8、0x07=0xF6，并逐项读回。这样 P00/P01/P02 是电源控制，P10/P13 是触摸/SD 隔离控制；P06/P07/P11 仍保持输入，USB_EN1、CHARGE_ALLOW、USB_EN2 由硬件下拉保持低。P03/P04/P05/P12 及 P14–P17 为输入。安全掩码由当前网表推导，寄存器规则依据 [TI TCA9539 Rev.C，§8.6](https://www.ti.com/lit/ds/symlink/tca9539.pdf)。初期接口不提供充电使能、高输入档或任意寄存器写命令。

| 域与探测口 | 开启顺序 | 关闭/验收 |
|---|---|---|
| TOUCH：J403、J406 | TOUCH_IO_EN=0；TOUCH_EN=1；实测轨稳定；建立 RESET/INT 选址电平，再接通信号，执行完整 GT911 时序 | 停访问→隔离→关轨；记录 0x5D/0x14 实际地址、触摸、INT、上下拉与 I²C 上升沿 |
| SD：J402 | SD_IO_EN=0；SD_EN=1；实测稳定后接通六线，400 kHz 初始化，再测 4-bit 20 MHz | 关闭文件/卸载→停总线→隔离→关轨；卸载超时保留所需供电。记录真实文件回读/校验，速率不是已验证吞吐 |
| EPD：J401、J601 | 先设 CS 高、CLK/MOSI/DC/RST 安全低态；EPD_EN=1；按面板流程启动 | 完成刷新→休眠→停 SPI→关轨；BUSY 低在断电/拔屏时表示忙或无效。高压节点不套用低压 1 s 放电目标 |
| MIC：J404 | AMP_SHUTDOWN=0，GPIO4=1 同时打开 MIC 与 AMP 供电；稳定后建立 48 kHz、双 32-bit 槽、64fs 时钟 | 验证数据有效前的启动丢弃，录音期间功放维持 shutdown；不能声称两条供电独立开启 |
| AMP：J405、J801 | 同上先静音和零数据时钟，再渐增音量；接所选 8Ω/2W 扬声器 | 首轮电输出≤0.5 W 是测试预算且需实测限幅；淡出→静音→停全部 I²S 时钟→GPIO4=0；用差分测量记录爆音/削顶。低电量不保证 2 W |

使用 MAX17048 时遵守其 [Rev.7 数据手册](https://www.analog.com/media/en/technical-documentation/data-sheets/MAX17048-MAX17049.pdf) 的电压/有效性规则，不能把模拟源读数或 I²C ACK 当电池容量验证。首板之后再实施真实电池、USB 单源启动/挂起、掉电注入、负载/温升及软关机功耗矩阵；所有测量值留空直至有记录。

## 测流与复原记录

串表或分流器必须**替代**对应测流连接，不得跨在仍装着的 0Ω 上再声称测到了该支路电流。断电拆装，并记录表档/负担电压与方向；瞬态测量优先适当分流器加差分测量，避免电流表压降引起假掉电。

R102 覆盖电池输入支路；R101 只覆盖 SYS 下游；R203 覆盖 AON 下游。五路 R402/R405/R408/R411/R414 测下游负载，不含上游负载开关自身静态电流。拆下游测流连接后 QOD 与信号路径仍可能连接负载，不能当完整隔离。若未来确需外注电，必须另审 QOD、信号及所有上游路径；主轨外注也要先处理 R203，SYS 外注先处理 R101。

每个阶段结束记录复原：R101/R102/R203 与五路测流连接状态、J502 选源、J202 主稳压、J203 开放、R108 DNP、J105 开放。没有实测证据的项目均保持 `pending`；第一块通过后第二块重复断电、输入、主轨、默认状态和各域基本功能检查，再保留一块作为未改动对照板。
