xiaobaoaaaaaa/ESPaperPlay-V2/hardware/devboard-r0/review-r10/drill-report.txt

Drill report for ESPaperPlay_Devboard.kicad_pcb
Created on 2026-11-14T20:39:47

Copper Layer Stackup:
    =============================================================
    L1 :  F.Cu                      front
    L2 :  In1.Cu                    in1
    L3 :  In2.Cu                    in2
    L4 :  B.Cu                      back

Drill file 'ESPaperPlay_Devboard-PTH.drl' contains
    plated through holes:
    =============================================================
    T1  0.200mm  0.0079"  (207 holes))
    T2  0.200mm  0.0079"  (12 holes))
    T3  0.300mm  0.0118"  (342 holes))
    T4  0.600mm  0.0236"  (4 holes)  (with 4 slots)
    T5  1.100mm  0.0433"  (91 holes))

    Total plated holes count 656

Drill file 'ESPaperPlay_Devboard-NPTH.drl' contains
    unplated through holes:
    =============================================================
    T1  0.600mm  0.0236"  (1 hole)
    T2  0.650mm  0.0256"  (2 holes))
    T3  3.200mm  0.1260"  (4 holes))

    Total unplated holes count 7
