xiaobaoaaaaaa/ESPaperPlay-V2/hardware/devboard-r0/review-r10/impedance-review-r10.md

# r10 官方名义阻抗窗口复核

2026-11-14。本轮通过 [JLCPCB 官方计算器](https://jlcpcb.com/pcb-impedance-calculator)实际取得 r9 缺失的四点结果；本计算步骤未修改 PCB，也未上传、联系厂家或下单。对照的主线宽与间距在最终r10中保持。来源与参数见 [机器记录](impedance-window-r10.json)和[界面转录](official-ui-transcription.txt)。截图在会话中目视核验，没有声称存在本地截图文件。

选择 Rigid、4层、1.6mm、外1oz/内0.5oz、mm，指定 JLC04161H-7628 标准叠层，成品1.59mm±10%。L1信号/L2参考，使用带阻焊的非共面模型，Width/Spacing Complement 不勾选。PP为0.2104mm、外铜0.035mm、内铜0.0152mm，与r9记录一致。

| 网络模型 | 目标下界及线宽 | 目标上界及线宽 | 现板主线宽 | 窗口检查 |
|---|---|---|---:|---|
| SD单端 | 45Ω → 0.4295mm | 55Ω → 0.2951mm | 0.3500mm | 位于0.2951–0.4295mm内 |
| USB差分，输入S=0.1500mm | 81Ω → 0.3195mm | 99Ω → 0.1897mm | 0.2600mm | 位于0.1897–0.3195mm内 |

USB两行输出间距均显示0.1501mm，保留这一工具换算/舍入差异，不写成完全精确的0.1500mm输出。以上是官方名义模型的线宽窗口检查；结合该模型随线宽增大阻抗下降的关系，可确认当前两种主线宽不需要仅因r9缺少端点结果而修改。现有几何到最近窗口端点的宽度余量为SD 0.0549mm、USB 0.0595mm；这不是成品阻抗裕量。

没有取得现有宽度的精确官方反求阻抗，故不赋予其新的具体Ω数值，也不把宽度差百分数当阻抗误差。官方求解容差±0.5%不等于制造公差；名义模型窗口通过不代表实际整板的90Ω±10%/50Ω±10%已由工厂保证。实际材料/阻焊/铜截面、蚀刻补偿、焊盘引出、分叉、过孔及局部参考平面仍需相应审核。L4/L3只按对称层叠作对应推断，未独立重复计算。

建议本轮移地孔与阻焊调整时维持USB主线W/S=.26/.15、SD主线W=.35，不为追逐工具50Ω/90Ω中心推荐宽度贸然重走线。后续制板资料仍指定USB差分90Ω±10%、SD单端50Ω±10%，由板厂按指定叠层/生产补偿审核。
