xiaobaoaaaaaa/ESPaperPlay-V2/hardware/devboard-r0/review-r9/process-review.md

# r9 制造工艺与叠层审查（r8 PCB 只读）

审查日：2026-11-11。r9 是对 r8 源板的制造和自行装配审查，正式 PCB 保持不变；本记录及配套 CAM/钢网资料为 review-only，尚非制造放行。对象：`hardware/devboard-r0/ESPaperPlay_Devboard.kicad_pcb`，SHA-256 `1a4556d866cc1352a2c45b674c94d2f233edf28c3e003bd96c8f6caf1e630681`。装配方式：用户钢网回流，接口/排针手焊。本记录不是厂商签核、报价或订单；未上传 CAD，未联系厂商。

## 结论

基本板材、钻孔和线路几何可采用常规四层 FR4 工艺；没有必须升级 HDI、盲埋孔或六层的证据。现有 CAD 孔分布本身并不等同于“23 个孔全部必须树脂塞孔”。真正未闭合的是：11 个 IC 焊区内孔的焊膏/堵孔方案，以及 44 个贴近 SMT 焊盘的普通过孔；它们不能靠 KiCad 的 tented 标记保证不吸锡。U301 模块 EPAD 可独立降低装配复杂度，见下文。

JLC 官方计算器已给出同一标准叠层的目标线宽，消除了 r8 仅用闭式公式的来源缺口。但这是通用横截面计算，尚未取得对本板实际几何的工厂阻抗承诺。

## 设计实测与工艺能力

原生几何清单见 [native-process-inventory.json](native-process-inventory.json)，官方来源见 [process-sources.json](process-sources.json)。本次以只读 `pcbnew` 提取线路、过孔、PTH/NPTH 与孔间距。孔尺寸采用 CAD 标称值，未模拟钻偏、电镀或成品孔径误差。铜间距/板边距离援引项目规则及 r8 原生 DRC，未在此重复实现完整 DRC。

| 项目 | r8 实测/设计值 | 官方公开能力 | 判断 |
|---|---:|---:|---|
| 外形/层数 | 160×110 mm，4L | 4L 常规最大 663×593 mm | 普通尺寸，适合独立板 |
| 板厚/铜厚 | 1.6 mm，外 1 oz，内 0.5 oz | 可选；板厚通常 ±10% | 指定叠层，勿只填写“1.6 四层” |
| 最窄线 | 0.18 mm，共 23 段 | 多层 1 oz 0.09 mm | 有制造余量 |
| 铜净距 | 项目最小 0.15 mm，r8 DRC 无错误 | 线距 0.09 mm；普通 pad-to-track 0.10 mm | 可行，实际阻焊桥由装配审查覆盖 |
| 小孔 | 205 个 via：D0.45/d0.20 mm，焊环 0.125 mm | 推荐孔 ≥0.20；外径至少大 0.10，推荐大 0.15 mm | 常规；不是 0.15 mm 非常规孔 |
| 大孔 | 344 个 via：D0.60/d0.30 mm，焊环 0.15 mm | 同上 | 常规 |
| 最小 via 孔边距 | 0.272150 mm，USB_VBUS 两孔 | 最小 0.20 mm | 通过；也高于项目 0.25 mm 规则 |
| 普通组件 PTH | 95 个，最小焊环 0.20 mm | 多层建议 0.20、极限 0.15 mm | 最小值在 USB 壳体槽孔 |
| PTH-PTH 孔边距 | 含模块孔最小 0.789949 mm | 插件孔最小 0.45 mm | 通过 |
| USB 壳体槽 | 2×0.60×1.40、2×0.60×1.70 mm | 多层槽宽 ≥0.35，槽长 ≥0.70，建议长 ≥2×宽 | 满足 |
| NPTH | 4×3.20 mm，2×0.65 mm，麦克风 1×0.60 mm | 国际页最小 0.50 mm | 满足；麦克风孔不得被塞孔处理 |
| 铜到锣边 | 项目规则 0.30 mm，r8 DRC 无错误 | ≥0.20 mm | 应保留普通锣边而非擅改 V 割 |

来源：[国内 PCB 能力表](https://www.jlc.com/portal/vtechnology.html)、[国际 PCB 能力表](https://jlcpcb.com/capabilities/pcb-capabilities)。国内报价能力优先；不把国际页面的价格/默认项直接视为国内订单承诺。

## 官方叠层和阻抗计算

只读访问 [官方计算器](https://jlcpcb.com/pcb-impedance-calculator) 并输入几何参数，无需登录、上传或下单。2026-11-11 页面结果已由浏览器文字与截图共同核验；截图在会话工具记录中，[impedance-calculator-review.json](impedance-calculator-review.json) 保存手工转录的参数/输出，未声称本地存在截图文件。

- Rigid，4 层，1.6 mm，外 1 oz / 内 0.5 oz，单位 mm。
- 非共面、带阻焊模型；L1 为信号层，L2 为下方参考平面，无上方参考。
- 选择 **JLC04161H-7628**，工具标为标准叠层、成品厚 1.59 mm ±10%。
- 横截面：外铜 0.0350 / PP 0.2104 / 内铜 0.0152 / core 1.0650 / 内铜 0.0152 / PP 0.2104 / 外铜 0.0350 mm，与 r8 记录一致。

| 网络目标 | r8 当前尺寸 | 官网求解输出 | 当前宽度相对求解值 |
|---|---|---|---:|
| SD 单端 50 Ω | W0.3500 mm | W0.3586 mm | -2.40% |
| USB 差分 90 Ω | W0.2600 / S0.1500 mm | W0.2474 / S0.1501 mm（输入 S0.1500） | +5.09% |

此处百分数是**线宽差**，不是阻抗误差，不能把 +5.09% 换成 -5.09% 阻抗，也不能直接宣布超出 90 Ω±10%。工具的求解容差界面是 ±0.5%，并非厂商板级保证；厂商公开受控阻抗公差为 ±10%。没有反求得到当前 .26/.15 和 .35 的官方模型阻抗值；45/55 Ω 单端与 81/99 Ω 差分的四点线宽容差窗口也尚未取得。因此本次没有证明现有几何位于官方名义模型的 ±10% 窗口内，更不代表成品实测或工厂对本单签核。

建议继续保持 r8 几何供审核；制造释放时将两种网络和参考层写入阻抗表，要求按指定叠层审核现有宽度是否落入目标范围，若不满足再做局部线宽/间距修订和 DRC。勿未经几何复核把 USB 全部改成 .2474：窄引出、Type-C 并联支路、转层及相邻铜对真实信号仍有影响。SD 在 B.Cu 的段应以 L3 作参考；本叠层上下对称，模型结果可作对应依据但未单独重复计算。

r8 记录“计算器外铜按 1.6 mil”的说法来自先前工具模型描述；本次结果层叠表实际显示 1.38 mil / .0350 mm。应以这次实际界面数据更新来源说明，而不是继续称官方计算器未取到结果。

## 23 个焊区内孔的分组处理

| 区域 | 孔数 | 所有权 / 类型 | 工艺重点 |
|---|---:|---|---|
| U101 BQ24074 EPAD | 4 | native via，.20 mm | 充电器热焊盘，不能照搬模块“EPAD 可不焊”结论 |
| U201 TPS63802 PGND | 2 | native via，.20 mm | 功率回流焊盘，保留接地和散热路径 |
| U203 MAX17048 EPAD | 1 | native via，.20 mm | 按其封装装配要求审查膏口 |
| U802 MAX98357A EPAD | 4 | native via，.20 mm | 音频功放热焊盘，须控制空洞/膏量 |
| U301 WROOM-1 pad 41 | 12 | footprint PTH，d.20/D.60 mm | 模块推荐布局有 thermal via，需独立分类 |

r8 的 native via 均标作双面 tented，但 SMT 焊盘大开窗可以覆盖孔口；这是 CAD 合成掩模问题，单个 via 标记不能证明成品孔被封住。还有 44 个 via 仅铜环触及 SMT 铜、实际孔未相交，孔边至焊盘铜仅 .025001–.125 mm，不能把它们算进“23 盘中孔”，但应检查开窗合并和吸锡风险。

[国内五种过孔工艺说明](https://www.jlc.com/portal/server_guide_15544.html)区分盖油、塞油、树脂/铜浆填孔后盖帽；双面开窗孔不能油墨塞孔，半开窗可能只能半塞油、依文件评估。[国际现行帮助页](https://jlcpcb.com/help/article/pcb-via-covering)对焊盘邻近孔的塞油限制更严。因此不能预先承诺“选择普通塞油就解决 23 孔”。盖帽工艺为保留焊区内孔并提供平整可焊表面的路径，但不是凡有 thermal via 即强制的设计法则。

**可降低复杂度的具体选择：**

1. **本次 DIY 钢网省略模块 EPAD 膏口。** [Espressif WROOM-1/1U v1.8，第 41/45 页](https://www.espressif.com/sites/default/files/documentation/esp32-s3-wroom-1_wroom-1u_datasheet_en.pdf)明确 EPAD 焊接不是必须、焊接改善散热，且膏量过多影响外侧脚接合；推荐 land pattern 本身包含 thermal via。本次 DIY 钢网候选已删除 U301 的 9 个中心 EPAD 膏口，EPAD 区域 paste 面积为 0；保留所有铜、12 个热孔和外圈 GND 电气连接。正式 r8 源板没有修改；独立钢网候选仅承担印膏图设计。此方案不改变网表，但减少模块底部散热耦合，需要 Wi-Fi/CPU 连续负载温升验证。该安排不意味着其余 IC EPAD 可不焊。
2. **11 个 IC 孔保留时，按焊膏图和回流方案选择。** 可考虑避孔分窗、合适膏量和经确认的孔处理后试焊；未经试焊/工艺确认不承诺普通盖油足够可靠。若希望用较确定的平整可焊孔口降低 DIY 回流风险，选择这些孔的树脂填孔+电镀封帽，并审核实际生产稿。该选择是成本/装配风险取舍，不是电气必须项。
3. **不希望使用盖帽工艺时再做局部几何优化。** 对非必要的焊区/近焊盘孔可移到焊区外、保留短连接和足够地铜；功率芯片热孔的移除/外移须重新检查布局与热路径。不能仅为了少一种工艺删掉电源焊盘下全部地孔。

国际公开说明称 4L POFV 收费，6–20L 可默认包含；[来源](https://jlcpcb.com/blog/via-filling-guide)。尚无本项目或国内具体报价；**不建议仅为免工艺费改六层**，因为会改变叠层、阻抗、工艺和总成本。

## 拟制造规格（待装配审查合并，非已下单规格）

- 4 层 FR4；指定 JLC04161H-7628；1.6 mm；外 1 oz，内 0.5 oz；普通锣边单板 160×110 mm。
- 优先绿色阻焊；表面处理建议 ENIG，以获得回流焊盘平整度。ENIG 不等于过孔已经填平；若换 HASL，另核露铜邻近孔和细间距焊盘。
- USB 差分 90 Ω±10%，SD 单端 50 Ω±10%；指定层/参考层及现有 W/S，请工程审核，不能只凭“固定叠层”声称受控阻抗验收通过。
- 普通远离焊盘过孔可采用覆盖/塞油；23 孔按分组方案单独标识，工厂须依据最终 mask/paste 回读及 DIY 工序判断可用孔处理，不能仅按孔径或个数统一升级 POFV。若选择 POFV，使用 UUID/坐标/孔径清单确认具体孔及要求，不要笼统写“所有孔塞树脂”。保留 95 个插件孔、7 个 NPTH，尤其麦克风声孔完全贯通。
- 用户自行钢网回流：203 个普通贴片器件（含 U301 外周焊脚）回流；4 个 SMD 接口 J406/J501/J601/J701 与 23 个 THT 排针、端子、按钮后手焊。实装共 230，另 6 个 DNP 不装不印膏；U301 中心 EPAD 不印膏。钢网来自单独审查后的 paste 图，不直接使用正式 r8 原始 paste，也不把裸板资料作为工厂 PCBA 委托。
- 发布前审生产稿的层序、开窗、塞孔选择和阻抗补偿；本次没有外发文件或订单动作。

## 电阻估计边界

r8 用孔铜 20 µm；[当前国际能力页](https://jlcpcb.com/capabilities/pcb-capabilities)列平均 18 µm，而非 20 µm 保证最小值。同样圆柱模型下，.20/.30 孔单孔电阻会比 20 µm 假设高约 12%，整条路径升幅取决于孔电阻占比。这不是已发现过热，也不能用平均 18 µm 当每孔最低厚度。应将模型改为敏感性估计或取得实际工艺要求，再与温升/压降实测闭合。
