xiaobaoaaaaaa/ESPaperPlay-V2/hardware/devboard-r0/review-r8/power-routing-review.md

# r8 PCB电源布线审查

审查对象：[ESPaperPlay_Devboard.kicad_pcb](../ESPaperPlay_Devboard.kicad_pcb)，2026-11-07。21条预设电源路径全部连通；两项线宽审查例外按下述条件保留。此结论覆盖静态铜路径和已检查的局部拓扑；整板DRC见[drc.json](drc.json)，制造与热性能仍按下述条件验收。

- PCB SHA-256：`1a4556d866cc1352a2c45b674c94d2f233edf28c3e003bd96c8f6caf1e630681`。
- 原始审查规则：[power-path-rules.json](power-path-rules.json)；未为消除告警修改门限。
- 独立计算证据：[power-paths.json](power-paths.json)；USB全部VBUS焊盘补充证据：[usb-power-paths.json](usb-power-paths.json)，对应[规则](usb-power-path-rules.json)。
- 本轮电源优化UUID差分：[power-optimization-delta.json](power-optimization-delta.json)，36删除/42新增；只改电源铜，不改器件位置/值/封装或网络。优化源与输出哈希、每段宽度和理由均在差分中。

## 路径结果

按外层35µm铜、过孔孔壁20µm、板厚1.6mm估计。R20是20°C铜电阻；数值单位mΩ，也等于该路径在1A下的mV压降。1A只是归一化计算，不赋予各外设1A负载能力。窄段长度为低于该路径预定干线宽度的累计长度。

| 路径（起点→终点） | 长度 mm | 最窄 mm | 过孔数 | R20 mΩ | 窄段 mm |
|---|---:|---:|---:|---:|---:|
| USB插座→PTC（J501.A4→F501.1） | 15.133 | 0.40 | 2 | 12.866 | 2.786 |
| PTC→输入选择器（F501.2→J502.1） | 32.730 | 0.80 | 0 | 20.152 | 0.000 |
| 台架输入→选择器（J101.1→J502.3） | 59.222 | 0.80 | 0 | 36.464 | 0.000 |
| 选择器→充电输入电容（J502.2→C101.1） | 44.439 | 0.80 | 2 | 30.105 | 0.000 |
| 充电器输入局部（C101.1→U101.13） | 1.186 | 0.20 | 0 | 2.393 | 0.900 |
| 充电器SYS局部（U101.10→R101.1） | 10.900 | 0.20 | 0 | 7.999 | 0.600 |
| SYS→主稳压输入（R101.2→C201.1） | 38.023 | 0.80 | 1 | 19.840 | 5.983 |
| SYS→功放负载开关（R101.2→U405.1） | 69.985 | 0.60 | 1 | 42.507 | 0.000 |
| 电池接口→电流测量链接（J102.1→R102.1） | 9.766 | 0.80 | 1 | 5.836 | 1.918 |
| 电池链接→充电旁路（R102.2→C103.1） | 35.131 | 1.00 | 2 | 18.949 | 0.000 |
| 充电器BAT局部（C103.1→U101.2） | 1.475 | 0.20 | 0 | 2.196 | 0.600 |
| 主稳压输入局部（C201.1→U201.10） | 1.848 | 0.20 | 0 | 2.253 | 0.500 |
| 主稳压输出局部（U201.6→R203.1） | 10.273 | 0.20 | 0 | 7.441 | 0.500 |
| 3V3_AON→MCU（R203.2→U301.2） | 137.437 | 0.80 | 8 | 78.387 | 0.000 |
| 3V3_AON→EPD开关（R203.2→U401.1） | 84.984 | 0.80 | 2 | 53.095 | 0.000 |
| 3V3_AON→SD开关（R203.2→U402.1） | 108.596 | 0.60 | 4 | 61.084 | 0.000 |
| EPD开关输出→升压输入电容（R402.2→C603.1） | 33.382 | 0.60 | 0 | 26.992 | 0.000 |
| SD开关输出→卡座（R405.2→J701.4） | 56.344 | 0.60 | 2 | 49.000 | 0.000 |
| 触摸开关输出→FPC（R408.2→J406.2） | 23.760 | 0.30 | 0 | 36.180 | 0.000 |
| 麦克风开关输出→器件（R411.2→U803.3） | 28.016 | 0.20 | 0 | 44.205 | 1.492 |
| 功放开关输出→器件（R414.2→U802.2） | 11.412 | 0.30 | 0 | 12.099 | 3.325 |

## 审查例外与接受条件

1. **SYS→主稳压输入**：5.983mm累计0.8/0.9mm段超过“1.0mm干线、窄段≤3mm”的内部审查目标。保留这些段以避开USB_EN、PGOOD、CHG及相邻3V3铜；其余长中段已加宽。整段R20=19.840mΩ，在1A算例下铜降19.84mV、铜损19.84mW。该静态结果支持在现有电池端总电流≤1A预算下作为样机候选；更高台架输入电流须另测压降、局部温升和瞬态，不能直接用1A算例覆盖主稳压1.5A输出目标。
2. **AMP_SYS末端**：局部0.3mm短颈累计3.325mm，比3mm目标多0.325mm，用于释放U802.4控制信号的逃线空间；8mm级供电主干保留0.6mm。整段R20=12.099mΩ；在0.5A算例下铜降约6.05mV、铜损3.02mW。可作为已定低功耗提示音/有声书目标的样机候选；不据此承诺扬声器额定2W连续输出。
3. **USB补充审查**：21条规则固定以J501.A4为起点，因此另外逐个检查A4/A9/B4/B9至F501.1，四者均连通。A4/B9约12.866mΩ；A9/B4约14.835mΩ、最窄0.3mm、低于0.8mm的累计5.704mm，超过4mm短颈目标。该例外限于插座焊盘逃线和就近转层。以既有输入最坏边界1.08447A归一计算，最差路径铜降约16.09mV、铜损17.45mW；不含插座/PTC/选择跳线接触损失，也不声称多焊盘均流。未知USB供电仍维持既有100mA策略，高档仅用于能力已确认的源。

这些是保留可追踪告警后的工程判断，不是将规则改宽后宣称“全部通过”。样机仍需在电池/输入预算内测量负载端电压、纹波、温升及并发负载瞬态。

## 已保留的关键拓扑

- BQ24074的IN、SYS、BAT局部旁路与重复电流引脚先在本地短接，再进入干线；EP和VSS均接GND。
- TPS63802的电感两端与VIN/VOUT电容维持短局部回路；反馈从C202正极、R203之前取样，不从长距离3V3_AON负载端回取。AGND和PGND各有地连接。
- BAT_PROT主干已绕开C204正极落点；C204/MAX17048保留为安静电量计支路。预算脚本除路径节点外，还检查路径铜直接接触的禁用电量计焊盘，避免“经过焊盘铜却没有经过图节点”的漏检。
- EPD输出原被自动布线复用为负载主通路的6.2mm、0.2mm支路已升为0.6mm。
- 两内层用于GND，关键功率回路留在外层；热孔连接内层地。全板参考平面完整性、EMI和信号回流审查由整板审查另列，不由DC连通性代替。

## 焊盘内过孔和制造条件

以下7个仅为电源局部清单，并非全板总数；全板补充清单见后文。这7个GND焊盘内孔为外径0.45mm/成品孔径0.20mm。当前KiCad数据设置双面盖油，这只是阻焊属性，**不得将“仅盖油/帐篷孔”当作填孔盖镀工艺的替代**。

| 器件 | 数量 | 位置（mm） | 用途 |
|---|---:|---|---|
| U101 BQ24074 | 4 | (74.6,114.6)、(75.4,114.6)、(74.6,115.4)、(75.4,115.4) | EP散热/地回流 |
| U201 TPS63802 | 2 | (101.2,113.0)、(101.8,113.0) | PGND回流 |
| U203 MAX17048 | 1 | (70.0,138.0) | EP地连接 |

制造释放时须在制板及贴装资料中明确焊盘内过孔填孔、平整化及盖镀要求，并取得对应板厂的工艺确认；阻焊Gerber中的盖油标志不足以传达该要求。若不采用受认可的填孔盖镀工艺，应重新移孔至焊盘外并复核热/回流和DRC后再投板，不能直接将当前孔当普通过孔交付。上述孔数不证明BQ24074可以持续耗散设计压力算例约1.63–1.93W。

## 全板焊盘内钻孔补充清单

本补充独立只读检查[正式PCB](../ESPaperPlay_Devboard.kicad_pcb)，PCB SHA-256：`1a4556d866cc1352a2c45b674c94d2f233edf28c3e003bd96c8f6caf1e630681`。本次全板清单与上述电源预算使用同一冻结PCB，不将电源局部范围中的7个孔当作全板总数。完整逐孔坐标、UUID、网络、交叠面积和间隔见[vip-manufacturing-inventory.json](vip-manufacturing-inventory.json)。

按钻孔实际名义圆面与F/B面SMD铜面是否相交分类，而非以过孔中心、焊环或庭院相交代替：

| 原生对象/位置 | 数量 | 名义孔径 mm | 钻孔与SMD铜关系 |
|---|---:|---:|---|
| PCB_VIA：U101.17 | 4 | 0.20 | 全部在EP铜内 |
| PCB_VIA：U201.8 | 2 | 0.20 | 全部在PGND铜内 |
| PCB_VIA：U203.9 | 1 | 0.20 | 全部在EP铜内 |
| PCB_VIA：U802.17 | 4 | 0.20 | 全部在EP铜内；中心(87.65/88.35,64.65/65.35) |
| U301封装自带PTH、pad 41 | 12 | 0.20 | 全部与模块散热SMD铜重叠；属于PAD对象，不是PCB_VIA |

该快照合计**11个PCB_VIA钻孔交叠 + 12个模块自带PTH散热孔，共23个焊接区域内孔**。11个PCB_VIA均来自电源和音频的局部热/地连接。已将两处非散热意图的钻孔移出SMD铜：C603.2的GND孔从(178.25,141.6)移至(178.9,141.6)，R714.1的SD_D2孔从(170.5,59.11)移至(170.0,59.11)，各只延伸/调整相邻线段。正式板原生DRC为0错误、0未连，仅保留已知模块封装差异警告；SD_D2总长49.5414mm、相对CLK为−0.80624mm，满足±1.27mm目标，USB匹配不变。详见[vip-remediation-delta.json](vip-remediation-delta.json)、[drc.json](drc.json)与[signal-paths.json](signal-paths.json)。U301的12孔已嵌入封装，同样需要明确填孔盖镀/平整化工艺处置；若不采用该工艺，需要审查后的封装/布局变更，不能因其来自库封装就认定无需验证。

另有**44个PCB_VIA仅焊环铜与SMD铜搭接，钻孔圆本体未相交**，独立列在JSON的`native_vias_annular_contact_only`中，不计入上述23个孔。其名义钻孔边缘到SMD铜的最小间隔约0.025mm（五组TPS22918的GND端邻孔），最大约0.125mm；这不等于具备可制造的阻焊桥。需结合实际孔位/孔径公差、阻焊扩展及对位公差检查锡流路径，不能只靠DRC同网允许接近而免除装配审查。

全板另有95个普通连接器/按键等封装PTH焊盘及7个NPTH孔，分别用于元件插脚/固定、板安装、USB定位和麦克风声孔；不得将“填孔工艺”笼统应用到这些孔上。特别是麦克风声孔必须保持通畅。最终板已有549个原生PCB_VIA；新增148个GND回流孔后已重新运行全板清单，未新增孔-SMD交叠。后续改板仍须重跑此清单，不能直接沿用当前总数。

## 计算边界和待实测项目

- 原生连通图选择一条最低估算电阻路径；中途接入仍按整段长度收费，未合并并联电阻。结果可检查、偏保守，但不是场求解或完整电路仿真。
- 未计入器件、0Ω链接、保护MOS、焊锡、端子、焊盘扩展和GND回流电阻；分支共享干线须叠加实际同时电流，不能把表中每条路径单独的满负载算例并行套用。
- 报告附带的85°C电阻只是温度敏感性算例，不能扩展电池、芯片或整机允许温区。铜厚、孔铜与最终叠层须以制造确认值重算。
- MCU路径仍长137.437mm且含8个过孔：78.387mΩ静态估算达审查目标，但在0.5A时仅正极铜降即约39.2mV；本地去耦、Wi-Fi/SD/刷新并发、低电池brownout及负载阶跃仍须示波器实测。
- 充电约0.7A目标、DPPM/热降流、CV/终止/超时、实际NTC曲线和温窗仍按现有r5验证要求；R108 DNP、J105默认开放状态不因PCB布线审查改变。

设计依据：[电源设计规格](../../../docs/v2/hardware/power-design-spec.md)、[r5充电设计](../../../docs/v2/hardware/charging-design-r5.md)、[设计假设](../../../docs/v2/hardware/design-assumptions-2026-11-04.md)，以及[r7归档布局约束](../review-r7/)。该文档没有新增实物电流、温升、阻抗或制造合格声明。
