xiaobaoaaaaaa/ESPaperPlay-V2/hardware/devboard-r0/review-r8/signal-integrity-review.md

# R8 USB / SD 信号布线审查

本记录针对已冻结的正式 PCB：[ESPaperPlay_Devboard.kicad_pcb](../ESPaperPlay_Devboard.kicad_pcb)。测量直接读取该文件中的实际走线、焊盘和过孔，未使用自动布线器的预计线长。

- PCB SHA-256：`1a4556d866cc1352a2c45b674c94d2f233edf28c3e003bd96c8f6caf1e630681`
- 路径及逐段证据：[signal-paths.json](signal-paths.json)
- 检查工具：[analyze_signal_paths.py](../tools/analyze_signal_paths.py)
- 正式板原生 DRC：[drc.json](drc.json)，0 个错误、0 个未连接项目，保留 1 个 U301 与库封装不一致的已知警告。

六路 SD 主干满足本次采用的 **≤50.8 mm、相对 CLK 偏差 ≤±1.27 mm** 几何目标；USB 两种插向的 D+/D− 路径分别匹配。长调试支线、信号换层和未经工厂确认的阻抗仍是明确保留的限制。DRC 和线长检查不代表已完成信号完整性认证或实板验证。

## 测量方法

工具建立铜线连接图，寻找实际连通的最短中心线路径，将 MCU→串联电阻、电阻→TMUX 输入、TMUX 输出→卡座三段相加。焊盘中心到走线的接入距离计入；每次 F.Cu/B.Cu 贯通换层按名义板厚 1.6 mm 计入，经过调试排针的通孔换层也计入。

该模型不包含电阻、TMUX、ESP32 模组及连接器内部的导电路径和传播延迟，也不模拟过孔寄生、介质传播速度、蛇形耦合或实际加工公差。因此表格描述的是 **PCB 铜线与名义过孔长度**，不是完整电气传播延迟。小数位用于复核设计数据，不代表制造精度。

调试支线采用树形连接下的路径差估算：`(MCU→调试针 + 调试针→串阻 − MCU→串阻) / 2`。CMD、D3 的支线估算为零，是因为其主路径经过调试排针焊盘，不表示这些焊盘和可选排针没有寄生参数。

## SD 最终路径

| 信号 | 铜线＋名义过孔长度 / mm | 相对 CLK / mm | 主干换层次数 | J302 调试支线估算 / mm |
|---|---:|---:|---:|---:|
| CLK | 50.348 | 0.000 | 2 | 7.832 |
| CMD | 50.394 | +0.047 | 4 | 0.000 |
| D0 | 50.358 | +0.011 | 4 | 19.213 |
| D1 | 50.381 | +0.033 | 4 | 13.546 |
| D2 | 49.541 | −0.806 | 4 | 6.608 |
| D3 | 50.697 | +0.350 | 4 | 0.000 |

六路主干均连通，实际主路径上的走线段宽度均为 **0.35 mm**；最大相对 CLK 偏差为 **0.806237 mm**。最终 D2 过孔移至 `(170.0, 59.11) mm` 后重新测量，上表使用修正后的正式板数值。

D0 中段先去除不必要的绕行和两次换层；R711 小幅移动、旋转以缩短 CMD；U703 旋转后消除了卡侧 D0/D1 的不必要交叉。随后以 45° 转角补偿较短路径。CLK 蛇形段多数平行线的中心距为 0.9 mm；几何长度相等仍不能证明耦合蛇形段的传播延迟完全相等。变更记录见 [sd-optimization-delta.json](sd-optimization-delta.json) 和 [vip-remediation-delta.json](vip-remediation-delta.json)。

**D0、D1 的 J302 支线仍分别为 19.213 mm、13.546 mm。** 尝试的缩短方案未纳入正式板，本版没有把这两条支线标为已解决。J302 不装配只能去掉排针，不能去掉板上的支线铜。这些支线需要结合实际 SD 时钟、驱动强度、卡片负载及边沿测量评估；不能仅凭主干等长判定最高时钟稳定。

Espressif 建议 SDIO 避免信号换层。本板主路径仍有 **2–4 次 F/B 换层**，因此没有完整满足这一布线建议。连续内层 GND 及回流过孔用于改善参考路径，不能消除信号过孔本身的不连续性。

## USB 最终路径

| Type-C 对应触点 | D+ 到 MCU / mm | D− 到 MCU / mm |
|---|---:|---:|
| B6 / B7 | 49.866 | 49.866 |
| A6 / A7 | 56.662 | 56.662 |

两种插向分别计算的 D+/D− 路径差均小于 **0.001 mm**；这只是设计数据的数值匹配。主差分段位于 F.Cu，名义线宽/边缘间距为 **0.26/0.15 mm**；A6/A7 的重复触点各经过两只相同尺寸的过孔和等长 B.Cu 短分支。保护器件、串联电阻附近的接入及 DNP 电容支线不属于均匀传输线。这里也没有将数值等长解释为 USB 电气合规测试通过。

## 叠层、阻抗与回流

采用 JLC04161H-7628 名义 1.6 mm 叠层，层序为 F.Cu 信号 / In1.Cu GND / In2.Cu GND / B.Cu 信号；内层不布置信号。实际参考面仍受反焊盘、安装孔和封装禁布区影响，不能用“连续 GND”忽略这些几何结构。

外层到邻近地平面的介质厚度采用 0.2104 mm、名义介电常数 4.4、外层铜厚 0.035 mm。闭式微带近似得到 SD 0.35 mm 线宽约 **49.98 Ω**，USB 0.26 mm 线宽 / 0.15 mm 边缘间距约 **89.96 Ω 差分**。计算依据及原厂资料链接见 [stackup-impedance.json](stackup-impedance.json)。

这些数值未计入完整阻焊层、蚀刻梯形、相邻铜及耦合场分布，**不是工厂场求解结果、阻抗测试结果或受控阻抗承诺**。生产前仍需由厂家对实际叠层和成品线宽/间距复核；本次未取得工厂阻抗实测数据。

[ground-return-vias.json](ground-return-vias.json) 记录了 **148 个新增 GND 回流过孔**，并验证新增过孔可接入两层实际填充的内层 GND。搜索同时考虑已有 GND 过孔和 GND 通孔焊盘，以距离信号换层处 **≤2.0 mm** 作为本次工程几何目标。

唯一未达到该距离目标的记录是 `/USB_INPUT/USB_DP_PORT` 在 **(108.25, 57.6) mm** 的过孔，最近现有地回流距离为 **2.29 mm**；其余被检查的换层处满足目标。该检查只说明地回流导体的几何邻近和连接条件，不等同于回流电感、眼图、EMI 或信号完整性认证。回流增补记录中的源文件散列属于增补前的输入，正式信号路径与本页顶部的冻结 PCB 散列对应。

## 后续验证边界

首次上板应由较低 SD 时钟开始，逐步验证四线读写与连续读取、不同卡片和目标时钟的稳定性，并结合测试点观察边沿、振铃/过冲及卡电源扰动。USB 应验证两种插向的枚举和连续传输。以上工作与实际工厂阻抗确认尚未由本次布线检查完成。

## 原厂参考资料

- [Espressif ESP32-S3 PCB Layout Design — USB / SDIO](https://docs.espressif.com/projects/esp-hardware-design-guidelines/en/latest/esp32s3/pcb-layout-design.html)：USB 90 Ω、SDIO 50 Ω、SDIO 长度和匹配建议，以及避免换层和参考地要求。
- [JLCPCB 阻抗计算与叠层](https://jlcpcb.com/impedance)：JLC04161H-7628 叠层参数。
- [JLCPCB 阻抗计算器使用说明](https://jlcpcb.com/help/article/user-guide-to-the-jlcpcb-impedance-calculator)：实际计算所需的材料、铜厚、阻焊及蚀刻形状参数。
- [嘉立创原厂阻抗说明](https://www.jlc.com/portal/q6i36372.html)：工艺线宽/线距控制与阻抗精度控制的区别。
