xiaobaoaaaaaa/ESPaperPlay-V2/docs/v2/hardware/closure-review-r4.md

# 开发验证板条件闭合审查 r4

> 后续决策（2026-11-04）：[电池保守假设与纯延长连接](design-assumptions-2026-11-04.md)更新了设计依据。本文及r4 BOM/PDF保留2026-11-02审查时状态；转接件型号/照片/逐针证明不再是继续布局的前置输入，电池按保守预算推进，初装仍禁充。

日期：2026-11-02。状态：**开发板候选进一步闭合，制造BOM尚未冻结**。本轮把可由原厂资料和计算决定的型号、封装及预算落实，把仍需实物或台架证明的条件列成验收项。尚未进行PCB布局、贴装、充电或上电验证。

主控继续使用 **ESP32-S3-WROOM-1-N16R8**，复用现有GDEY075T7-T01屏幕与GT911触摸，暂不支持蓝牙耳机。[r3 BOM与封装审查](bom-footprint-review-r3.md)保留为历史记录；其7个空封装、38个空MPN和旧F501等统计不再代表r4的候选选择。

正式入口：[KiCad工程](../../../hardware/devboard-r0/ESPaperPlay_Devboard.kicad_pro)、[r4原理图PDF](../../../hardware/devboard-r0/output/pdf/ESPaperPlay_Devboard_BOM_r4.pdf)、[逐位号BOM](../../../hardware/devboard-r0/review-r4/bom-review.json)。工程目录仍保留`devboard-r0`名称。

| 检查项目 | r4实际结果 |
| --- | --- |
| 位号 / 网络 | 222个位置、178条网络；6个DNP保持 |
| 封装 | 222个位置均有候选；补齐7处空缺、变更4处既有指派；共37种，其中19种本地封装 |
| MPN / 审查条件 | 220个位置已指定；仅C501/C502调谐DNP留空；50个位置保留专项闭合条件，包括R104/R105/R108充电适配 |
| 电气 / 元数据 | 660项关键引脚检查通过；器件UUID和DNP保持 |
| 差异 | 28项显式Value变更：25个电容只调整耐压标注、容量不变，另有R201/R202/F501；仅新增J601.SH与J406.SH接GND，剥除这两节点后原网络连接分组保持 |
| 原生封装 / ERC | 222个位置、37种封装加载及编号焊盘集合匹配通过；当前ERC配置下错误/警告/排除违规均为0 |

证据：[封装/BOM检查](../../../hardware/devboard-r0/review-r4/bom-footprint-check-r4.json)、[关键引脚网表检查](../../../hardware/devboard-r0/review-r4/netlist-check-r4.json)、[允许差异清单](../../../hardware/devboard-r0/review-r4/allowed-r3-r4-delta.json)、[ERC记录](../../../hardware/devboard-r0/review-r4/erc-r4.json)。原厂资料的真实文件、来源层级与哈希见[r4归档索引](../../../hardware/reference/closure-r4/README.md)和[来源清单](../../../hardware/reference/closure-r4/sources.json)。计数包含DNP，不是采购数量；上述静态检查不验证FPC插接、MLCC偏压容量、故障保护或焊接工艺。

## 已确定的实际配件与边界

| 项目 | 用户选择及当前输入 | 尚须取得的证据 |
| --- | --- | --- |
| 电池 | ZON.CELL 755570、1S、标称3.7V，4000mAh，带保护与三线10kΩ NTC；**4.2V充电体系待电池规格确认** | 允许充电电流/温窗/CV容差，NTC参考温度、β或完整R–T及公差，保护阈值/延时，3A脉冲持续时间，真实线束极性/线径 |
| 扬声器 | 3525腔体、8Ω、商品标称2W，标称1.25mm连接器 | 实际外形/安装空间、极性与线径、阻抗公差及功率测试条件；1.25mm间距不能确定连接器家族 |
| EPD/触摸转接 | 保留当前通用0.5mm FP24/FP6转接与延长链路 | 实际端到端脚序、同/反面接点、主板侧尾端厚度/宽度/露铜与加强板长度 |

来源为[用户截图清单](../../../hardware/reference/user-selected-r4/selected-components.json)，它记录的是商品页面声明，不是原厂保证。电池截图给出10–55°C下2A、−10–10°C下800mA，以及10–45°C下瞬时3A但未给时长；“4.2～5V”模糊文字不作为电芯CV终止电压。无需再反复索要通用FPC延长件型号，后续对现有链路做实物核对。

## 原7个空封装的条件候选

| 位号 | 本轮准确候选 | 已闭合内容 | 布局/装配前保留条件 |
| --- | --- | --- | --- |
| J102/J103/J801 | Phoenix Contact **1751248 / MKDS 1/2-3.5** | 3.5mm节距、1.1mm孔、7.5×7.3mm本体及8.5mm高度；开发板使用可拆线束过渡 | 原线束可能小于端子最低0.14mm²导线范围；需合适过渡、极性标识、应力释放和拧紧支撑，不能直接夹不合规格细线 |
| J601 | HOAUC **HYCW3D-05FPC24-200B** | 24信号焊盘与2固定焊盘按原厂图重建；与旧工程铜几何相符 | 核对完整延长链路、尾端及锁扣操作空间；沿用旧脚序约定不等于实物脚序已经证明 |
| J406 | LAILAN **LAIL-FPC-CDX01-6P0.5-GW** | 6信号焊盘与2固定焊盘，闭合高度1.00±0.10mm | 同样核对链路与插入尺寸；双面接触结构不能证明转接板脚序 |
| R602 | Vishay Dale **WFMB2010R4700FEA** | 0.47Ω±1%、低电感金属板2010，原厂专用land | Kelvin取样，检查实际峰值/RMS电流和端子温度，并服从MOS、电感、二极管及面板更严格的限制 |
| U803 | PUI **DMM-4026-B-I2S-R** 专用7焊盘封装 | 明确PCB Ø0.60±0.05mm非金属声孔、GND铜环、所有铜层声孔避让和贴装候选开口 | 贴装厂确认钢网/孔公差与声学密封；真实供货及最终声道仍待核验 |

两只FPC符号新增 **SH接GND**，对应各自两块固定金属焊盘，不占用24/6个信号引脚。其余信号脚序及N16R8 GPIO分配保持；正式网表已核对只增加这两个SH连接。

[机械分项审查](../../../hardware/devboard-r0/review-r4/mechanical/review.json)包含各尾端的尺寸窗口和可复查几何。实物验收只需围绕保留的链路执行：断电逐线导通并标明两端1脚，记录主板侧接触面，测厚度/宽度/露铜和加强板长度。FP24要求的典型尾宽12.5±0.07mm、厚0.30±0.03mm、露铜4mm、加强板5mm；FP6对应3.5±0.05mm、0.30±0.03mm、露铜1.5±0.3mm、加强板至少2.5mm。0.5mm节距本身不足以放行。

## 音频与升压器件

Q601继续用Vishay Si1308EDL-T1-GE3，改用AN826专用SC70焊盘，保留1G/2S/3D；原通用焊盘短边不足原厂最小示例的问题已闭合。

R602验证包络定义为 **Irms≤1A、Ipeak≤2A、端子温度≤110°C**。含初始公差与TCR后的电阻上界约0.47672Ω，对应平均≤0.47672W、峰时瞬时≤1.90687W，低于该端子温度下2W额定，因此该包络内不借用过载脉冲曲线。原厂所示脉冲曲线只适用于33mΩ，不用于0.47Ω。这些是电阻选型的待测条件，不是系统允许的升压电流或样机测量值。[音频与升压审查](../../../hardware/devboard-r0/review-r4/audio_boost/review.json)

麦克风PCB声孔与器件Ø0.25±0.05mm声孔是不同尺寸。当前选择Ø0.60mm PCB孔、连续GND环和85%线性焊膏候选开口；钢网0.10–0.12mm、环形密封及孔公差交给贴装确认。不要水洗或超声清洗回流后的麦克风。开发板裸露声孔测试不能替代外壳声道验证。

音频仍由SYS供电，不新增5V升压。8Ω/2W是扬声器商品标称，首轮预算采用**音频输出≤0.5W的设计测试上限**，并非已实现的软件限幅或已测声功率。首测仍为48kHz、双32-bit槽、64fs；BTL扬声器两根输出均不接地。

## 30个MLCC候选与有效容量

32个原空MLCC料号中，30个默认装配位已选定以下8种TDK准确候选；C501/C502保持USB调谐DNP并留空MPN。检查日官方产品页显示Production，不构成库存/交期承诺。

| 位号 | MPN | 标称规格 / 封装 |
| --- | --- | --- |
| C402/C405/C408/C411/C414 | C1608C0G1H472J080AA | 4.7nF50V C0G±5%，0603 |
| C704 | C1608C0G1H103J080AA | 10nF50V C0G±5%，0603 |
| C303/C401/C404/C407/C410/C412/C413/C805 | C1608X7R1C105K080AC | 1µF16V X7R±10%，0603 |
| C101/C409/C603 | C2012X7R1E475K125AB | 4.7µF25V X7R±10%，0805 |
| C102/C103/C201 | C3216X5R1C106K160AA | 10µF16V X5R±10%，由0805增为1206 |
| C301/C702/C803 | C2012X7R1A106K125AC | 10µF10V X7R±10%，0805 |
| C202/C403/C406/C415 | C3216X5R1C226M160AB | 22µF16V X5R **±20%**，1206 |
| C605/C606/C610 | C2012X7R1H105K125AB | 1µF50V X7R±10%，0805 |

准确MPN、介质、公差和封装已经定义，偏压下保证容量尚未全部闭合。特别是22µF型号为±20%，X5R本体上限85°C。升高额定电压或增大封装不能直接证明有效容量。

| 位号 / 用途 | 电容资格检查电压 | 最低有效容量验收门槛 | 门槛性质 |
| --- | ---: | ---: | --- |
| C102 / BQ OUT | 5.0V | 4.7µF | 项目保守规则，依据BQ推荐标称4.7–47µF，不冒充TI明确偏压下限 |
| C103 / BAT | 4.5V | 4.7µF | 同上；BQ充电稳态最大4.23V |
| C201 / TPS63802输入 | 5.0V | 4µF | TI明确有效容量下限 |
| C202 / TPS63802输出 | 3.6V | 7µF | TI在输出>2.3V时的明确有效容量下限 |

BQ OUT稳态最大4.5V，5.0V是电容检查留量，不是实测峰值。对初始负公差后的容量，以上要求的联合保持率分别至少52.22%、52.22%、44.44%、39.77%；还须覆盖偏压下温度、老化及测试条件。典型偏压曲线不能当保证极限，X5R/X7R的±15%温度分类也不保证与偏压独立相乘。[电容审查](../../../hardware/devboard-r0/review-r4/capacitors/review.json)、[计算明细](../../../hardware/devboard-r0/review-r4/capacitors/calculations.json)

六只高压4.7µF保留Murata GRM31CR71H475KA12L。C601/C604/C607/C608/C609各节点，以及 **C602两端的 `V(EPD_FLY)−V(EPD_SW)`**，须取得启动、刷新、关断的真实应力包络后核偏压容量、峰值和纹波温升。C610接VCOM，也属于此门槛；C606只接屏内部VDD，不能接外部3V3。屏参考图的4.7µF/25V标称值不能反推出最低有效容量必须等于4.7µF。

TDK原始特性PDF下载受403限制，网页只提取到部分图轴，未取得可核验的曲线数值。来源记录明确保留这一缺口，没有编造保持率或文件哈希。[电容来源清单](../../../hardware/devboard-r0/review-r4/capacitors/sources.json)

## 主稳压、输入保护和电池预算

R201/R202改为 **51.1kΩ/9.10kΩ，0.1%、25ppm/K**，准确型号分别为Vishay **TNPW060351K1BEEA / TNPW06039K10BEEA**。在电阻本体−40～85°C、初始公差、每颗0.1%老化预算、PWM反馈±1%与保守±100nA输入偏流模型下，计算输出为 **3.2494–3.3666V**，落在3.3V±3%内。PFM纹波、线/负载瞬态及布局误差仍未通过；0.1%老化预算也不是无限寿命保证。[计算](../../../hardware/devboard-r0/review-r4/power/power-bounds.json)、[独立复核](../../../hardware/devboard-r0/review-r4/audio_boost/independent-power-review.json)

代价是在精确3.3V处，分压电流从5.48µA增为54.82µA，增加约49.34µA，需按转换效率计入电池端P01预算。不能直接从≤200µA整机目标扣成一个已测余量。

F501改为 **Bourns MF-MSMF200/16X-2**，仍用1812 Style2候选焊盘，最大高度1.60mm。50°C/60°C目录保持电流分别为1.68A/1.48A。R103=1.62kΩ、±1%、100ppm/K加入−40～85°C电阻温漂后，BQ可编程档为约0.91084–1.07947A；再加5mA未测旁路分配，PTC负载预算上界 **1.08447A**，为60°C保持值的73.27%。**BQ该电气表只保证TJ=0～125°C**，不能把外部电阻的−40°C预算延伸成BQ负温度工作保证；此组计算尚未加入电阻老化。

原F501与高档正常工作电流的高温不匹配已在目录选型层面解决，短路动作、TVS配合、高温电阻、连接器/线束温升仍需实测。**默认100mA输入档不变**，F501换型不授予电脑USB大电流权限，也不是精确电流限制。

首轮20–30°C预算假设SYS最低2.9V、主稳压和功放效率各85%、主轨1A、音频输出0.5W、其他电池电流50mA，估算电池约1.592A。主轨增到1.5A/100ms且带相同音频时约2.261A，超过商品2A连续声明；在3A脉冲时长和保护延时未确认前，该目标保留为**台架源测试**。10°C以下没有整机满载许可。上述电流是设计估算，不是真实需求或效率测量。

## 充电继续禁止

**R108 `CHG_ARM`保持DNP。** 4000mAh÷296.67mA约13.48h，而现有68kΩ TMR名义快充时间约9.07h，现有组合不批准给所选电池充电。这只是理想容量/电流比值，不是CC/CV充满时间；DPPM、VIN-DPM或热降流会按芯片规则减慢计时，不能据此跳过验证。

采用现有±1%/100ppm电阻温漂模型后，ISET范围约0.26134–0.33043A，68kΩ定时范围约6.688–11.521h，适用同样的BQ结温限制。RTMR允许范围 **18–72kΩ**；不能为4000mAh任意增大到72kΩ以上，也不能停用计时器或周期翻转CE规避超时。先取得充电温窗、允许电流、CV容差及NTC曲线，再选择ISET/TMR并记录完整充电曲线。

10kΩ NTC还缺参考温度/公差/β或R–T表，保护前后地回路也须确定。当前没有TS到MCU的已验证温度采样链路，不能声称固件已经具备电池低温满载限制。BQ参考103AT-2温窗不能自动等同于实际电芯允许温窗。

## 后续验收按具体门槛执行

| 门槛 | 所需证据 / 通过条件 |
| --- | --- |
| 延长链路与接插件 | FP24/FP6全链路导通、接触面与端部尺寸；电池/NTC/扬声器适配线极性与应力释放；FPC锁扣、microSD退卡和端子工具操作空间 |
| USB与microSD结构 | GCT USB4105-GF-A是0.95mm固定脚版本；PCB厚度/工艺需验证焊接和强度。Hirose DM3AT-SF-PEJM5的旧版准确图已核，较新图尚未取得；push-push及禁布区、退卡空间按实物核验 |
| 电容与电源动态 | 关键低压有效容量达到上表条件；高压各端应力/纹波温升有记录；负载开关涌流、关轨残压和信号倒灌通过H02/H06/H15 |
| 音频/升压工艺 | PUI声孔、铜环及钢网确认；Q601专用焊盘和R602 Kelvin布线落实；实际电流/端子温度落在包括MOS、电感在内的最严格边界 |
| 电池/充电 | 原厂或供方完整充电与NTC/保护条件，ISET/TMR重新适配，H04/H12热稳态及故障注入通过后才考虑装R108 |
| 整板验证 | 预布局和布线审查、DRC、四层回流/天线净空、H01–H15台架记录；ERC和“每颗有封装”不替代这些测试 |

台架记录与阈值入口为[电源规格](power-design-spec.md)和[功耗预算](power-budget.md)。当前可继续开发板设计与预布局审查，不生成制造放行结论。
