xiaobaoaaaaaa/ESPaperPlay-V2/docs/v2/hardware/panel-reference.md

# GDEY075T7-T01 屏幕与触摸参考

状态：原厂资料已归档并核对关键页。2026-11-04用户确认FP24/FP6转接件仅作被动延长，设计以本页原厂文档为准，不另行要求转接功能、型号或照片证明。实物检查保留为常规装配验收。

[本地资料索引](../../../hardware/reference/good-display/README.md) 和 [来源/版本/哈希清单](../../../hardware/reference/good-display/sources.json) 是后续绘制原理图的证据入口。页码均指 PDF 页码。

## 型号边界

当前复用对象是 **GDEY075T7-T01**：7.5 英寸、800×480、UC8179 电子纸与 GT911 触摸总成。`GDEY075T7` 是不带 `-T01` 后缀的基础屏型号，不能用其厚度和机械图替代触摸总成。`TP075-Y01` 是该产品页关联的触摸层图纸。

总成规格书 p4 给出显示有效区 163.20×97.92 mm、外形 170.20×111.20×2.13 mm；总成机械图 p1 对厚度标注为 2.13±0.5 mm。最终外壳和连接器位置仍以样品及机械公差核验。官网页面：[总成](https://www.good-display.cn/blank7.html?productId=477)、[基础屏](https://www.good-display.com/product/396.html)。

## 两条独立 FPC

已目视核对 `GDEY075T7-T01-CAD.pdf` p1 与 `TP075-Y01.pdf` p1：

| 接口 | 图纸事实 | 主板意义 |
| --- | --- | --- |
| 电子纸 | 24Pin，0.5 mm 间距，触点厚度 0.30±0.03 mm | 需要 EPD 专用接口与驱动外围 |
| 触摸 | 6Pin，0.5 mm 间距，触点厚度 0.30±0.03 mm | 独立电源、I²C、RESET 和 INT |

图纸已标注触点面和Pin1方向；连接器的接触面、插入方向、锁扣、接触长度和封装按图纸配置。延长件按文档对应针号/同名信号连续连接，不增加电气功能。采用r4已指定的J601/J406候选及SH接地；不再把额外转接件型号或实测针序作为设计前置。装配时按图纸检查方向，不声称本轮已经完成实物测量。

触摸 FPC 的引脚事实：

| Pin | 原图定义 | 原理图网络建议名称 |
| --- | --- | --- |
| 1 | GND | GND |
| 2 | VCC / VDD | TOUCH_3V3 |
| 3 | RESET / RST | TP_RESET_N（隔离后） |
| 4 | INT | TP_INT（隔离后） |
| 5 | SDA | TP_SDA（隔离后） |
| 6 | SCL | TP_SCL（隔离后） |

总成图将 2–6 脚标为 3.3 V 电源或信号。GT911 的 INT 在上电选址期间需要 MCU 驱动，正常运行时再作为中断输入；不能把它画成只能输入到 MCU 的固定单向链路。GT911 Rev.10 p11–12 给出 I²C 建议速率不高于 400 kbit/s、RESET/INT 时序，以及含读写位的地址对 `0xBA/0xBB`、`0x28/0x29`。换算为常用 7-bit I²C 地址分别是 **0x5D、0x14**，实际选址须由复位时序和上板读取共同确认。

## EPD 控制与外部电路

总成规格书 p6–7 核对的主机控制脚如下；表中的 SCL/SDA 是 **SPI**，与触摸 I²C 不是同一接口。

| EPD Pin | 功能 | 约束 |
| --- | --- | --- |
| 8 BS1 | 总线选择 | 低为 4-wire SPI；高为 3-wire / 9-bit SPI |
| 9 BUSY | 面板忙状态 | 低有效；忙时不发下一条普通命令 |
| 10 RES | 复位 | 低有效 |
| 11 D/C | 命令/数据选择 | 低为命令，高为数据 |
| 12 CS | 片选 | 低有效 |
| 13 SCL | SPI 时钟 | 与触摸 SCL 分开命名 |
| 14 SDA | SPI 数据 | 原厂参考图标作 SDI |
| 15 VDDIO、16 VCI | 逻辑与芯片供电 | p6 要求 VDDIO 与 VCI 相连；参考电路使用 3.3 V |
| 17 VSS | 地 | 接公共地 |

EPD 的 6/7 脚 TSCL/TSDA 是控制器外部温度传感器接口，不能当作触摸 I²C。完整 24Pin 表见原文件 p6；1/4 脚 NC 保持未连接，不能将所有 NC 短接。

总成规格书 p38 明确给出**屏外升压外围**，含电感、MOSFET、二极管、采样电阻和高压储能电容。因此，裸屏的 24Pin 不能简化成“3.3 V 加几根 SPI 线”。参考图标注 10 µH 电感和 0.47 Ω 采样电阻；这些是原厂参考值，不是已经冻结的本项目 BOM。最终需核对电感饱和、器件耐压、电容偏压降额、走线回路和刷新波形。

特别注意 p6 将第 18 脚 VDD 描述为内部调节节点、外接去耦电容；p38 也按此连接。不可仅凭名称或 p8 的概括电压表就把 VDD 与主 3.3 V 短接。电源域关断和信号倒灌仍按 [电源域设计](power-domains.md) 单独验证。

## 资料差异与尚未确认的项目

| 项目 | 证据差异 | 当前处理 |
| --- | --- | --- |
| 触摸点数 | 中文产品页写双点，英文产品页写五点；GT911 芯片本身支持五点 | 不据此保证现有总成五点能力；读取实际配置并测试 |
| 触摸电流 | 产品页写工作 8 mA、待机 100 µA；总成规格书 p7 写 4.32 mA、55 µA | 不替代整板功耗预算，待实测并记录模式 |
| 触摸供电范围 | 总成资料写 2.8–3.6 V；GT911 裸芯片 Rev.10 p22 推荐 AVDD28 为 2.8–3.3 V | 维持 3.3 V 名义设计，确认稳压误差及总成接口条件；不以 3.6 V 为常规工作目标 |
| 原厂示例适配 | 官网归类为 ESP32，RAR 内目录为 Arduino V2.3.5，使用 A3/A4/A5 等假设 | 仅作为协议参考，不照搬新板 GPIO 或初始化代码 |
| 版本标识 | 网页更新时间、PDF 元数据、图签/正文版本不完全相同 | 全部保留于来源清单，以哈希固定本次资料 |

已按资料完成[EPD_DISPLAY原理图](../../../hardware/devboard-r0/EPD_DISPLAY.kicad_sch)，含升压外围、24针功能接口、五路写入缓冲及BUSY回传。J601的VDD18独立去耦，未接3.3 V；当前SDI缓冲为单向，不支持从SDI回读。连接器候选及文档针序已进入设计基线；升压器件供货、电容有效值与刷新波形继续核验。本页不代表实物装配或刷新已通过，设计输入更新见[2026-11-04补充](design-assumptions-2026-11-04.md)。
