xiaobaoaaaaaa/ESPaperPlay-V2/hardware/devboard-r0/review-r4/capacitors/review.md

# r4 电容候选闭合记录

2026-11-02。仅写本子任务 scratch 目录，没有编辑原理图、采购或运行 KiCad CLI。

原 BOM 的 32 个 MLCC 空料号位置中，30 个默认装配位已经选定准确候选；C501/C502 是 USB 调谐 DNP，继续留空。下表八个 TDK 型号的官方产品页均显示 Production，价格和库存未作承诺。

| 位号 | 候选料号 | 标称规格 | 封装决定 |
|---|---|---|---|
| C402/C405/C408/C411/C414 | C1608C0G1H472J080AA | 4.7nF50V C0G ±5% | 保留0603 |
| C704 | C1608C0G1H103J080AA | 10nF50V C0G ±5% | 保留0603 |
| C303/C401/C404/C407/C410/C412/C413/C805 | C1608X7R1C105K080AC | 1µF16V X7R ±10% | 保留0603 |
| C101/C409/C603 | C2012X7R1E475K125AB | 4.7µF25V X7R ±10% | 保留0805 |
| C102/C103/C201 | C3216X5R1C106K160AA | 10µF16V X5R ±10% | **建议0805改1206** |
| C301/C702/C803 | C2012X7R1A106K125AC | 10µF10V X7R ±10% | 保留0805 |
| C202/C403/C406/C415 | C3216X5R1C226M160AB | 22µF16V X5R **±20%** | 保留1206 |
| C605/C606/C610 | C2012X7R1H105K125AB | 1µF50V X7R ±10% | 保留0805 |

部件外形与封装族匹配，但标准 KiCad 焊盘不宣称与每家原厂推荐焊盘完全相同；制程审查仍需保留。X5R 本体最高85°C，不能套用芯片125°C结温上限。增大额定电压与封装是候选设计决定，本身不能证明偏压容量。

## 有效容量的可核验门槛

| 位号 | 电容资格检查电压 | 最低有效容量 | 扣除初始负公差后需要的联合保持率 |
|---|---:|---:|---:|
| C102 BQ OUT | 5.0V | 4.7µF | 52.22% |
| C103 BAT | 4.5V | 4.7µF | 52.22% |
| C201 TPS63802 VIN | 5.0V | 4.0µF | 44.44% |
| C202 TPS63802 VOUT | 3.6V | 7.0µF | 39.77% |

公式：`Ceff = Cnom × (1 − 初始负公差) × 联合保持率`。联合项必须覆盖偏压、偏压下温度、老化和相应 AC 测试条件。上表是验收阈值，**不是选定料号已达到的实测或保证容量**。

TI 明确给出 TPS63802 有效输入至少4µF、输出电压>2.3V时有效输出至少7µF。BQ 的4.7–47µF是推荐旁路标称值；这里把4.7µF作为剩余容量，是项目自行采用的保守检查规则，不能写成 TI 明确保证的偏压下限。BQ OUT 稳态最大4.5V，BAT充电稳态最大4.23V；5.0V/4.5V资格检查分别增加0.5V/0.27V工程余量，不代表实测峰值。

电子部分的候选验证温度点为−40/25/85°C，屏的实际工作范围仍为0–50°C；离散点测量不能代替整个温区的供应商保证。偏压时间、测试 AC 幅度/频率及回流焊后去老化历史须记录。未确定全寿命容量下限。

TDK交付规格中的X5R/X7R温度±15%是在未施加直流电压条件下的分类限值。因此不能把典型DC偏压曲线直接乘0.85再乘假定0.90老化系数，称为原厂保证下限。`calculations.json`保留这一乘积作为明确标注的工程情景：所需DC保持率分别68.26%、68.26%、58.10%、51.99%，不判通过。

其他电源旁路没有从现有芯片资料获得统一的有效容量数值下限，不编造一个。C803遵照MAX98357A的10µF与0.1µF就近旁路要求，并以真实音频负载的供电跌落/纹波检查；C303按EN复位时序检查。

## 高压电容的剩余条件

C601/C602/C604/C607/C608/C609保留Murata **GRM31CR71H475KA12L**，4.7µF50V X7R ±10%1206。原厂数据和In Production系列状态已复核。屏厂参考第38页给4.7µF/25V以及X5R/X7R，未给出各高压节点全条件电压或最低有效容量，不能由此反推有效容量必须等于4.7µF。

具体缺口是：每个节点在启动、完整/局部刷新、关闭时的直流偏压与瞬时端到端峰值；相应精确型号的TCBias/老化容量证据；飞跨电容的纹波和本体温升。**C602应测 `V(EPD_FLY)−V(EPD_SW)`**，不能按某一端对地电压评估。C610接VCOM，也属于此高压门槛；C606接屏内VDD，不能与外部3V3相连。

取得屏厂对准确候选的适用性确认、或建立真实电压包络后取得电容供应商条件数据，再结合样机验证，才可关闭此项。实物样本通过不是全批量/全寿命保证。此阶段没有理由向用户追问普通MLCC料号。

## 涌流预算和证据边界

真实网表直接并在各域的标称容量合计为EPD27.8µF、SD32.3µF、TOUCH4.9µF、MIC2.3µF、AMP32.1µF。22µF已经按实际±20%重新计算正公差；`calculations.json`包含每颗明细。负载开关输入电容、EN/CT电容不计入这些下游合计；EPD升压高压电容的充电能量须另计。单纯加15%温度的最大容量情景不是组合TCBias上界保证。

官方TDK产品页面可以读取型号、尺寸、电气额定和Production状态；其PDF/模型文件从本机下载均遇Akamai403。部分官方特性PDF的文本可读，但只提取到坐标轴，未能获取可检查的实际偏压曲线数字；web截图接口也没有提供可查看图像。因此没有伪造原文件、哈希或从坐标轴猜测保持率。`sources.json`明确区分在线事实、既有本地原厂PDF及不可取得的原始文件；`SHA256SUMS.sources`只列实际存在的原厂文件。

复现：在仓库根目录执行 `python3 build/closure-r4/capacitors/build_review.py`。脚本从r3 BOM和真实网表重新生成结构化审查与计算，断言32个空MLCC位置均已归类，输出仅限本目录。
