xiaobaoaaaaaa/ESPaperPlay-V2/hardware/devboard-r0/review-r5/temperature/review.md

# r5 温窗电路独立复核

日期：2026-11-04。对象：用户授权按 Honeywell 175-103LAE-301 曲线先行设计的开发验证板。该曲线是明确设计假设，尚未证实就是所购电池内部的 NTC。本文只覆盖温窗电路；不替代电池、布板、充电散热及台架验收。

## 落图连接

U901 选 **TLV1822DR，SOIC-8**，不要以 TLV1812 推挽版本代换。引脚为 1 OUT1、2 IN1−、3 IN1+、4 GND、5 IN2+、6 IN2−、7 OUT2、8 VCC。

| 连接 | 元件值/作用 |
| --- | --- |
| VIN_5V → pin8；pin4 → GND | 与 BQ24074 的 IN 同一选定输入源；VCC 对地 100 nF |
| VIN_5V → BAT_NTC | 47 kΩ 上拉；真实 NTC 从 BAT_NTC 接 GND |
| HOT_REF | VIN_5V 经 100 kΩ、对地 12 kΩ；接 pin2 |
| BAT_NTC | 同接 pin3、pin6 |
| COLD_REF | VIN_5V 经 100 kΩ、对地 33 kΩ；接 pin5 |
| CHG_TS | pin1、pin7、BQ24074 TS 三者相连；10 kΩ 对地 |
| CHG_TS → BAT_NTC | 330 kΩ 正反馈 |
| CHG_TS → COLD_REF | 330 kΩ 正反馈 |
| BAT_NTC、HOT_REF、COLD_REF 对地 | 各 10 nF 滤波；CHG_TS 不加大电容 |

电阻按 1%、100 ppm/°C 或更好规格。温控比较器和分压均由 VIN_5V 供电，拔除输入后不从 SYS_RAW 持续消耗分压电流。NTC 高温电阻下降，使热比较器拉低 TS；NTC 低温电阻上升，使冷比较器拉低 TS。两个故障输出均通过 BQ 的 TS 功能暂停充电，保留其暂停/恢复定时器的行为。J105 仅控制 CE，无法越过此 TS 温窗。

原厂依据：[TI TLV1822 Rev E](https://www.ti.com/lit/ds/symlink/tlv1822.pdf) 的引脚、轨到轨输入、开漏输出和 POR；[TI BQ24074 Rev N](https://www.ti.com/lit/ds/symlink/bq24074.pdf) 的 TS 电流、阈值及暂停行为。

## 耦合计算

记 N = BAT_NTC，C = COLD_REF，S = CHG_TS，V = VIN_5V，I = BQ TS 偏置电流。

```text
(V-N)/47k + (S-N)/330k = N/R_NTC
(V-C)/100k + (S-C)/330k = C/33k
I = S/10k + (S-N)/330k + (S-C)/330k
HOT_REF = V × 12k/(100k+12k)
```

正常态同时解三个节点，不能固定 S=0.75 V，因为两条反馈会加载 TS。故障态以 S=0…0.25 V 作为低电平模型，求恢复温度。冷端的阈值反馈强于其通过 BAT_NTC 引入的反向耦合，因此冷、热两处都有正滞回；脚本按同一组器件、偏置和曲线分别检查两条边，不能把不同角点的上下界相减来判断滞回方向。

脚本直接读取已归档原厂 PDF 的 Rmin/Rnom/Rmax 表，按相邻温度线性插值，没有用单个 Beta 公式替换整张曲线。

| 条件 | 冷端暂停 | 冷端恢复 | 热端暂停 | 热端恢复 |
| --- | ---: | ---: | ---: | ---: |
| 5 V、标称电阻、75 µA、无失调；恢复示例 S=0.1 V | 14.82°C | 15.49°C | 40.05°C | 39.49°C |
| 5 V ±5% 运行区模型角点 | 12.39…17.12°C | 12.93…17.89°C | 37.25…43.10°C | 36.64…42.60°C |
| 2.9…10.8 V 扩展敏感度分析 | 11.86…17.42°C | 12.70…17.96°C | 37.08…43.72°C | 36.49…42.92°C |

0.1 V 是恢复点的演示输入，不是 TLV1822 的典型 VOL。扩展输入范围仅用于敏感度检查，板子仍按 **5 V 输入**使用。

角点模型使用：8 个电阻各 ±1.6565%（包含 1% 初差和板级 −40…85°C 范围内 100 ppm/°C 保守温漂）、I=72…78 µA、比较差分误差预算 ±4.2 mV、NTC 原厂 min/max 包络，以及故障输出 S=0…0.25 V。运行区同角滞回热端 0.354…0.774°C、冷端 0.403…0.961°C；扩展分析热端 0.192…1.222°C、冷端 0.230…1.503°C，均为正。

正常充电状态的 TS 在运行区约 0.713…0.823 V，扩展分析约 0.696…0.901 V，处于 BQ 的正常温测区。这里计算的是比较器窗口边界，窗口内部的节点值位于其间。

## 断短路、掉电及启动

脚本分别在“比较器输出释放”和“输出故障低电平”状态验证 NTC 开路、短路，并覆盖 I=0 的可能禁充偏置状态。开路始终为冷故障，扣除比较器误差后的最小差分余量约 1.837 V；短路始终为热故障，最小余量约 0.297 V。最大输出吸流分别约 115 µA、85.9 µA，远小于 4 mA 的 VOL 测试负载。

共同 VIN_5V 掉电时 BQ 本身没有有效充电输入。TLV1822 的最低工作电压为 2.4 V，低于 BQ 的 UVLO；因此正常慢降电源在 BQ 退出充电前温窗仍有供电。设计不声称覆盖比较器 VCC 单独断线、芯片损坏或 TS 焊接短路等单点故障。

BQ 数据手册称“充电时”向 TS 提供偏置。CE 禁止时不要假定仍有 75 µA。若偏置为零且输出释放，5 V 标称模型的窗口启动边约为冷 15.53°C、热 39.45°C，TS 约 0.066/0.048 V；启充并出现偏置后进入上述耦合窗口。这意味着边界处可能要求先回到恢复侧，不能把停充时测到的低 TS 直接判成电池高温。固件应据此区分 CHARGE_ALLOW 状态；台架应覆盖 CE 翻转和温度边界恢复。

TLV1822 的 200 µs PON 在参数表中是典型值；BQ 的 TS 50 ms 去抖也是典型值。POR 期间 TLV1822 输出高阻，本电路不据此声称上电瞬间必然无充电脉冲，也不拿两个典型时间作严格时序证明。保留 CE 的默认禁充机制；在受控首测中测量插电、慢升压、断电重插、CE 使能的实际时序。

## 模型边界与验收

TLV1822 的 ±4 mV 全温失调和 0.25 V 最大 VOL 表格默认 VS=12 V、VCM=VS/2；PSRR 的 100 dB 是典型值。数据手册另有 2.4 V/5 V 输出典型曲线，支持本设计低至约 0.1 mA 的负载具有充足余量，但并未给出覆盖所有 VIN、VCM 的完整保证矩阵。故本脚本的 ±4.2 mV 和低输出 0…0.25 V 是**明确工程预算**，角点结果不应描述为厂家对所有供电/共模条件的严格保证。输出 0.25 V 对 BQ 最低热阈值 0.27 V 仅有 20 mV 的表格余量；台架测量实际 TS 低电平及地偏移，主板布线应使用短、安静的共地回路。

优先台架检查：用精密电阻替代 NTC，跨越约 5.6 kΩ 和 15.2 kΩ 的阈值，测双向迟滞；验证 NTC 开路/短路都暂停且接回能恢复；在 MCU 无电及 J105 维护使能时重复；再验证 5 V 输入上下限、CE 翻转、输入启动及温窗暂停后定时器不重启。最后用实际电池 NTC 至少校核室温及冷热点，确认曲线假设与实物一致。

复算命令：

```sh
python hardware/devboard-r0/review-r5/temperature/analyze_temperature_window.py
```

机器结果：[temperature-window-results.json](temperature-window-results.json)。计算断言覆盖温窗边界、同角滞回为正、开路/短路故障稳定、输出吸流及 TS 正常电压范围。
