xiaobaoaaaaaa/ESPaperPlay-V2/THIRD_PARTY_NOTICES.md

# 第三方内容说明

本仓库从 ESPaperPlay 的 V2 工作目录迁移，保留原项目 MIT 许可证。

- KiCad 标准库的嵌入符号、封装及基于它们制作的项目库遵循上游库的 CC-BY-SA 4.0 与电子设计例外。随附 [KiCad 库许可证说明](LICENSES/KiCad-libraries.md)，项目库和原厂脚序核对记录位于 `hardware/devboard-r0/`。
- 厂商数据手册、网页、图纸、示例压缩包和商品截图不作为本项目 MIT 内容发布。`hardware/reference/` 保留来源、版本、文件哈希和审查索引；原始文件仅在本地参考目录保存。
- 历史嘉立创工程归档也沿用本地保存规则。公开仓库保留来源和静态审查记录。
- 本仓库自己导出的 KiCad 图纸、布局图、网表和 BOM 工作簿作为设计评审成果收录；历史生成物代表各自记录的版本，当前状态以开发板 README 和当前校验清单为准。
