xiaobaoaaaaaa/ESPaperPlay-V2/hardware/reference/power/README.md

# 开发板电源原厂资料

检索日期：2026-11-01。用于[电源设计规格r0](../../../docs/v2/hardware/power-design-spec.md)，不代表BOM已冻结或器件已上板。

本目录保存原厂PDF的本地参考副本，二进制不进入Git；[sources.json](sources.json)记录精确来源、修订、页数、大小和SHA-256，[SHA256SUMS](SHA256SUMS)用于核对。数据手册版权属于原厂，不适用本仓库MIT许可。文件不作改写；如后续官网下载版本变化，保留当前哈希并重新评审影响。

| 文件 | 本轮用途 |
| --- | --- |
| bq24074.pdf | 优先充电/电源路径候选；固定4.2 V、输入限流、NTC、可调定时器 |
| bq25185.pdf | 比较候选；核对当前360 min定时器及NTC/档位限制 |
| tps63802.pdf | 3.3 V升降压、低输入功率预算、关断与反向能流 |
| max17048.pdf | 保护后电池接法、SOC/温度补偿与低功耗模式 |
| tca9539.pdf | 16-bit I/O、独立RESET、安全输出和地址 |
| tmux1511.pdf | GT911四线双向信号掉电隔离 |
| tps22918.pdf | 负载开关、CT上升时间和QOD放电 |
| max98357a.pdf | SYS供电音频、shutdown/信号电平与输出条件 |
| ao3400a.pdf | 落图新增：充电使能与VBUS开漏检测NMOS，准确制造商与G/S/D脚序 |

核对命令：在本目录运行 `sha256sum -c SHA256SUMS`。若刚从Git克隆且无PDF，可按sources中的原厂URL重新取得；哈希不一致时不要直接覆盖旧的验证结论。
