xiaobaoaaaaaa/ESPaperPlay-V2/docs/v2/hardware/battery-zoncell-2026-11-04.md

# 中顺芯官网电池资料核查

日期：2026-11-04。对象为用户选定的ZON.CELL 755570、4000mAh、3.7V三线保护电池。本次补充原厂系列资料，未更改r4原理图、BOM及装配状态。

## 来源与适用范围

官网[带NTC保护三线系列](https://www.zoncell.com/product/lp1s-ntc/)网页直接访问返回403，但其[公开产品接口](https://www.zoncell.com/wp-json/wp/v2/product/3002)可正常读取正文和产品摘要。产品记录修改时间为2024-11-20；这是网页记录时间，不是规格书修订号。原始JSON及官方图片已归档于[资料索引](../../../hardware/reference/zoncell-2026-11-04/sources.json)。

本次官网公开产品及媒体检索未找到755570专用规格书。官方2000～4000mAh图片有4000mAh、3.7V三线产品，但标签小字不足以可靠确认755570。页面同时覆盖普通、高温、低温、宽温、高压和动力版本；下表作为**普通4.2V系列的暂用设计依据**，不是所购SKU的逐项保证。4.35V高压版本不属于本项目选定体系。

## 新取得的系列参数

| 项目 | 官网系列资料 | 对4000mAh的换算/边界 |
| --- | --- | --- |
| 标准充电 | 0.1C恒流至4.2V，随后恒压至电流低于0.01C | 0.4A，终止参考40mA；网页未给CV容差 |
| 标准/快速充电 | 0.1C/0.2C；参考时间15h/7.5h | 0.4A/0.8A；不是整机充满时长保证 |
| 充电温区 | 10–45°C | 作为温控适配目标，须计入温敏器件和检测电路误差 |
| 普通系列最大充电 | 0.5C；20°C以下0.2C | 2A/0.8A；不据此增加本板充电电流 |
| 普通系列连续放电 | 0.5C；10°C以下0.1C | 2A/0.4A；低温连续值比商品截图800mA更低 |
| 普通系列最大放电 | 1C；10°C以下0.2C | 4A/0.8A，但未给持续时间，不作为峰值额度 |
| 普通系列放电温区 | −10～55°C | 不表示整个温区都能以2A连续放电 |
| NTC | 标配“175”型号、10kΩ | 未提供完整厂家料号、参考温度/容差、B值或R–T曲线 |

数据来自上述官方产品接口的`excerpt.rendered`与`content.rendered`。官方[2000～4000mAh图片](https://www.zoncell.com/wp-content/uploads/2024/10/LP1S20004000NTC1a.jpg)也注明175和10kΩ。图片关于可当两线电池使用的说明，不作为省略充电温度检测的依据；网页文字也不能证明保护板已实现独立过温断充。

## 对现有设计的影响

1. **4.2V体系获得原厂系列资料支持。** 商品“4.2～5V”仍不作为电芯CV设定。BQ24074的4.20V典型、4.23V上界还须与实际电池容差相容；本次没有找到这项容差。
2. **保留保守测试预算。** 20–30°C、总电池电流不超过1A（包括瞬态）、75%可用能量预算继续有效，均为设计假设。官网没有提供新的实测续航、保护阈值、过流延时或脉冲时长，不提高负载额度；不采用低温800mA连续能力。
3. **温控需要适配10–45°C。** “175、10kΩ”不能认定等同103AT-2。BQ24074对103AT-2的参考窗是0–50°C，其Rs/Rp扩窗方法不能收窄该窗口。因此不能把现有TS连接直接视为满足官网温区。后续取得阻温数据后计算最坏边界；必要时增加独立温窗/禁充路径或调整充电器选型。布局可推进，充电区须保留修改空间。
4. **低倍率与安全计时仍不匹配。** 现有R104=3kΩ约0.297A，低于系列标准0.4A；R105=68kΩ典型计时约9.07h。4Ah/0.297A已约13.48h，且不包含完整CV阶段。BQ动态计时会在特定降流模式放慢，不能据此承诺充满，也不能停用计时或反复重启CE。以后调整ISET时须同步复核ITERM、TMR、输入余量与温升；官网0.8A快充值不是可直接写入的板级设定。

充电器依据：[TI BQ24074 Rev.N](https://www.ti.com/lit/ds/symlink/bq24074.pdf)，电气表、§9.3.5及§9.3.6。本轮**R108仍DNP、J105仍开放**，没有启充或实际温度采样验证。

## 尚未取得的资料

剩余重点是755570具体版本/批次的CV容差、NTC完整阻温数据与接地关系、保护阈值/延时，以及线束极性。它们影响实际充电和样机验收，不再作为继续开发板布局的前置资料请求。屏幕与触摸仍按用户确认的纯延长连接及原厂文档设计，见[设计假设](design-assumptions-2026-11-04.md)。

## 同日后续：175型NTC网络检索

找到Honeywell **175-103LAE-301** 的原厂工程图镜像，Rev.B、2006-09-08，附完整R–T表；[PDF本地归档](../../../hardware/reference/ntc175-2026-11-04/honeywell-175-103lae-301.pdf)及[来源与候选数据](../../../hardware/reference/ntc175-2026-11-04/sources.json)已保存。该版本为1206，R25=10kΩ±3%，B25/85=3750K±3%。下列值属于这个完整料号及文档版本，**尚不能视为中顺芯电池内NTC的已确认曲线**。

| 温度 | 最小/kΩ | 标称/kΩ | 最大/kΩ |
| --- | ---: | ---: | ---: |
| 10°C | 17.83 | 18.73 | 19.66 |
| 25°C | 9.700 | 10.00 | 10.30 |
| 40°C | 5.350 | 5.611 | 5.881 |
| 45°C | 4.425 | 4.667 | 4.918 |

Honeywell[官方产品指南](https://prod-edam.honeywell.com/content/dam/honeywell-edam/sps/siot/en-us/products/sensors/temperature-sensors/common/documents/sps-siot-temperature-sensors-line-gui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)确认175为1206系列并有10kΩ版本，但未发现Zoncell与该完整料号的对应证据。官网175/10kΩ文字本身不能确定厂商、后缀或版本。

另外，旧目录175-103LAF-301标为曲线16，部分经销商又将LAE标成B0/50=3887K；这与所归档LAE表不能直接混用。由LAE表的R0/R50计算B0/50约3568.6K，差异不能单靠Beta温区不同解释。暂以带版本的原厂图表作为候选对照，不往固件或原理图写入未经确认的曲线。

这为保留现有三线电池提供了具体对照资料，不要求立即更换电池。后续可在预定充电温区做多温点实测，建立该样品的阻温关系并校核停充边界；测量能支持样机标定，不等于确认厂商身份或整个批次公差。本次未做电池实测，也未改变充电使能状态。
