xiaobaoaaaaaa/ESPaperPlay-V2/docs/v2/hardware/review/legacy-power.md

# 旧板 POWER 页与电源域审查

日期：2026-11-01。范围为用户提供的 `.epro2` 归档及原 ESPaperPlay 仓库的参考固件；不改电路，不冻结新版 BOM。**这份归档不自动等同于用户目前使用的核心板接线或实板装配。**

## 证据与判定口径

原件、SHA-256 及有效图页的识别方法见 [旧工程接收记录](../legacy-project.md)。本页只使用未删除的 `POWER`，UUID `04311314e3f2f32d`，不使用归档中的已删除 POWER/POWER_BACKUP/POWER_REDRAW。以下 `E:行号` 均指归档内 `ESPaperPlay.epru` 的物理行号；原件来源和哈希见[归档记录](../../../../hardware/reference/legacy/README.md)。

已目视检查归档内的 POWER 页预览 `IMAGE/04311314e3f2f32d.webp`（原件位于上述本机归档，临时解包缓存未纳入独立仓库），并对照最终 COMPONENT/ATTR、嵌入符号引脚和 PCB `PAD_NET` 记录。预览属于归档缓存，PCB 网名也不能独立证明所有当前原理图与 PCB 已同步；关键结论同时列出多种证据。未运行嘉立创原生 ERC/DRC，未测量实板电流、温度或波形。

- **事实**：归档记录、可读图纸或固件直接显示的内容。
- **风险推断**：由已确认拓扑与原厂规格推导，尚非实测故障。
- **待验证**：需要原软件、实物、仪器或电池规格才能闭合。
- P0 表示新设计/后续带电验证前必须先处理的电池供电路径问题；P1 表示定稿前必须解决；P2 表示参数、测量或文档完善。

## 电源结构与器件事实

| 子电路 | 归档事实 | 证据 |
| --- | --- | --- |
| 充电 | U1 为 **UMW TP4056**（C725790），不是仅按同名型号假定为其他厂商版本；VCC=VBUS、BAT=VBAT、TEMP=GND；R17=1.2 kΩ 接 PROG 到地；CE 经 R14=10 kΩ 接 VBUS | U1 元件 E:15335，厂商/型号属性及嵌入器件记录；PCB E:19743–19752；R17 E:19609–19611；预览 PWR_CHG |
| USB/电池供电切换 | D6 SS34 从 VBUS 向 VRAW；Q3 AO3401A 的 S/2=VBAT、D/3=VRAW，G/1 经 R18=1 kΩ 接 VBUS、R19=22 kΩ 接地 | Q3 E:15559、19506–19509；D6 E:19390–19392；R18/R19 E:19615–19623；预览 PWR_SHARE |
| 主 3.3 V | U2 TPS62840DLCR 输入 VRAW，EN 直接 VRAW，MODE/STOP 接地；L2=2.2 µH，C21=4.7 µF，C22=10 µF，R21=267 kΩ 接 VSET 到地 | U2 E:15624、19756–19764；R21 E:19633–19635；预览 PWR_BUCK |
| 外设轨 | Q2 AO3401A 的 S/2=3V3、D/3=3V3_PER；R20=100 kΩ 从源极上拉门极，C23=1 µF 从门极到地，R22=**4.7 kΩ** 从 POWER_EN 接门极 | Q2 E:19499–19502；C23 E:19243–19245；R20/R22 E:19627–19641；预览 PWR_SW |
| 电池入口 | H1 的电气连接为 VBAT/GND 两线；附加焊盘为 GND | E:19453–19457；预览 PWR_BAT |
| 电池测量 | R23=10 MΩ 从 VBAT 到 BAT_SENSE，R24=3.3 MΩ 和 C24=100 nF 从 BAT_SENSE 到地 | E:19645–19653、19249–19251；预览 PWR_SENSE |
| 充电状态 | CHRG_STAT、STANDBY_STAT 各有 100 kΩ 上拉到常供 3V3；CHRG_STAT 同时接 VBUS→R13→LED1 指示支路 | E:19585–19605、19486–19488、19749–19750；预览 PWR_CHG |

主轨与音频轨的负载不能混算：音频页有独立的 VRAW→音频稳压路径，具体见音频审查。`3V3_PER` 则为 EPD、触摸、SD 共用轨；其独立关断目标与新版架构尚不一致。

## P0-PWR-01：Q3 形成绕过充电器的回灌路径

**已确认事实。** Q3 的 PCB 网络为 S/2=VBAT、D/3=VRAW；嵌入符号 E:7918–7919 定义 D=3，E:7928–7929 定义 S=2，E:7923–7924 定义 G=1。POWER 预览 PWR_SHARE 的源漏朝向与这些记录一致。AOS 的 [AO3401A 原厂手册](https://www.aosmd.com/sites/default/files/res/data_sheets/AO3401A.pdf) Rev.3.1（2023-12）p1 的器件图和体二极管图已渲染核对：该 PMOS 关断时，体二极管仍允许 **D→S** 的电流。

**风险推断。** USB 供电时，即使 R18/R19 将 Q3 门极拉高使沟道关断，仍存在：

`VBUS → D6 → VRAW → Q3 的体二极管 → VBAT`

当 `VBUS − VF(D6) > VBAT + VF(Q3体二极管)` 时，该支路可能正向导通。它不经过 U1 的受控充电通道，因此充电电流或终止状态不能仅由 TP4056 保证。这里确认的是**设计中的电流路径和成立条件**，并未证明某块实板已经回灌、过充或损坏；电流大小取决于实际压差、二极管特性、源阻抗、走线和电池保护状态。

**修改。** 不将此供电切换单元直接迁入新版；按已批准的系统电源路径方案重画并验证反向电流阻断。若复核旧板，应先核实实际装配器件和引脚、PCB 铜线及是否已有飞线改动，再用限流供电和电池模拟负载确认电流方向；不能只看栅极高电平或 CHRG 指示就认定电池已经隔离。

## P1-PWR-02：电池温度、保护与充电条件未闭合

**已确认事实。** U1 TEMP/1 接地，H1 只提供电池正负极；当前主板归档未识别出串在电池充放电回路的专用保护 IC/背靠背保护 MOS。R17=1.2 kΩ 对应的标称充电设置约为 1 A。

对应器件应使用 [UMW TP4056 原厂手册](https://www.umw-ic.com/static/pdf/fc94ef2c75a185f3e66737ebb4fd777c.pdf)（2025-05），p3、p6、p12–13：TEMP 接地禁用电池温度监测，RPROG=1.2 kΩ 的标称电流为 1 A。芯片自身热调节不等同于电池温度保护。

**待验证。** 两线电池包内部是否已有过充、过放、过流保护，尚无证据；不能据主板无保护 IC 就断言实际电池没有保护。电池容量、允许充电电流、温度范围、连接器极性、保护阈值也未提供。

**修改。** 新版继续保留已确定的“带保护与 NTC 的单节电池”要求，并把接口和充电参数写成明确约束。1 A 只能视为旧图设置，不能直接成为新版参数。在 5 V 输入、3.0 V 电池、1 A 设定下，线性充电的理想耗散约 `(5−3)×1=2 W`，实际电流可能被热调节降低；需核对散热铜皮、壳内温度、输入能力及边充边用负载，而不是据这一估算宣称已经过热。

## P1-PWR-03：纯降压主轨不能保证完整电池区间的 3.3 V

**已确认事实。** U2 为 TPS62840DLCR，属于降压器，原厂额定输出电流上限 750 mA。R21=267 kΩ 对应 3.3 V，MODE/STOP 的连接与基本省电运行用法相符。2.2 µH/10 µF 是原厂支持的滤波组合；这不代替具体电感饱和电流、电容偏压降额和 PCB 布局检查。

**风险推断。** 当 VRAW 接近 3.3 V 时，器件进入 100% 占空比模式；输出近似为输入扣除开关、电感和前级压降，不能升压补偿低电量区间。Wi-Fi、SD 和刷新并发时的最低轨电压与峰值余量均未知，不能仅凭“750 mA”判定够用或不足。[TI TPS62840 原厂手册](https://www.ti.com/lit/ds/symlink/tps62840.pdf)，p1、§8.3.4/Table 1、§8.4.3、§9.2.2。

**保留/修改。** 保留低静态电流主轨的设计目标；新版按已批准的升降压方向评估实际电池范围及负载。旧板需测 VRAW、3V3、3V3_PER 在低电池与并发峰值下的波形，并确认 MCU/屏幕/SD 的各自下限。

## P1-PWR-04：外设“复位默认关断”描述只适用于稳态

**已确认事实。** Q2 门极的 C23=1 µF 接地，而 R20=100 kΩ 上拉到源极 3V3。POWER_EN 低有效的逻辑正确，但 R22 实际为 **4.7 kΩ**，当前固件 [板级初始化](https://github.com/xiaobaoaaaaaa/ESPaperPlay/blob/0f6d7c349afdbbeb962a736d84036ce7f8487174/components/board/src/espaperplay_board.c) 第 28 行及 [板级配置](https://github.com/xiaobaoaaaaaa/ESPaperPlay/blob/0f6d7c349afdbbeb962a736d84036ce7f8487174/components/board/include/espaperplay_config.h) 的 470R 注释与图纸不一致。

**风险推断。** 3V3 冷上电时，门极电容初始为低电位，Q2 可能先导通，再随 R20 充电关断；MCU 从低电平输出切换到高阻时，也存在延迟。理想浮空门极 RC 为 `100 kΩ×1 µF≈100 ms`；主动 GPIO 驱动下的等效 RC 约 `(100 kΩ∥4.7 kΩ)×1 µF≈4.49 ms`。这些只是线性 RC 估算，MOS 阈值、稳压上升斜率和负载浪涌决定实际轨波形。

**修改/待验证。** 新版分别给 EPD、触摸、SD 建立确定的硬件默认状态和上电斜率；不要把 C23/R20/R22 组合称为有状态的“锁存”。用示波器核对冷启动、EN 复位、看门狗复位、掉电和深睡过程的 3V3、门极与 3V3_PER，并据实设置等待时间。当前代码的 20 ms 开轨等待不能独立证明所有上述场景已满足。

## P1-PWR-05：断外设电源前缺少完整的停止与引脚隔离契约

**已确认事实。** [espaperplay_power_enter_sleep](https://github.com/xiaobaoaaaaaa/ESPaperPlay/blob/0f6d7c349afdbbeb962a736d84036ce7f8487174/components/services/power/src/espaperplay_power.c) 第 850–873 行执行音频停止、GUI 冻结、EPD sleep、Wi-Fi suspend，然后关闭共用轨并进入深睡。这个函数没有显式卸载 SD、停止触摸/I²C，或将与失电域连接的信号全部切换到明确状态。EPD/触摸驱动仍有推挽高电平和内部上拉的配置，具体网络见显示/触摸审查。

**风险推断。** 外设关电时可能经信号保护结构或上拉产生倒灌；共用轨也不能实现“只保留触摸唤醒但关闭屏幕/SD”。未测量漏电和故障电流，不能把风险写成已发生。还需对照关机入口与上层调用，确认存储写回是否已在别处完成。

**修改。** 新版将停止任务、存储同步/卸载、总线静止、GPIO/隔离器状态、断轨、唤醒恢复做成可验证顺序；关电失败应回滚。软件高阻与硬件隔离各自承担明确责任，不能互相假定对方已完成。

## P2-PWR-06：BAT_SENSE 的省电取舍需要整链路校准

**已确认事实。** 10 MΩ/3.3 MΩ 分压与固件宏相符。理想分压比约 0.24812；4.2 V 电池对应约 1.042 V ADC 电压、0.316 µA 静态分压电流。戴维南电阻约 2.481 MΩ，与 C24=100 nF 构成约 248 ms 时间常数，冷接入约 1.24 s 才达到理想五个时间常数。

**风险推断。** 高阻有利于低功耗，但对输入漏电、板面污染、测量仪器负载和 ADC 采样更敏感。以额外 10 nA 的节点漏电为例，线性估算可形成约 24.8 mV 节点误差、约 100 mV 电池换算误差；这是假设灵敏度计算，不是已测得的 ESP32 漏电值。并联电容可缓解瞬时采样扰动，但不能消除直流漏电误差。

固件第 297–327 行连续取 16 次均值并反算；校准不可用时退回 `raw×3300/4095`。第 276–289 行仅按电压曲线映射百分比。这些措施不能替代实际电池、温度、负载、ADC 衰减与整板误差标定。

**保留/修改/待验证。** 保留电池电压作为独立诊断量；新版电量计方向不变。对旧板分别测试冷接入、静置、充电和大负载时的 ADC 与高输入阻抗基准仪器差值，记录电阻误差、采样时机与校准失败表现。

## P2-PWR-07：充电状态不能完整代表 USB 在位

**已确认事实。** 固件第 338–346 行使用 `charging || full` 得出 `usb_present`；旧板没有独立 VBUS 检测 GPIO。UMW 手册 p13 的状态说明中，两个输出均未拉低还可能对应欠压或故障等状态，不能唯一解释为 USB 未接入。

**修改。** 新版使用独立、适配 MCU 电压的 VBUS 在位检测；充电状态保留为充电器状态。对无电池、低输入电压、插拔和充满后的状态做表格验收，避免把同一电平组合解释为唯一物理状态。LED1 与 CHRG 回读共用节点的启动电平，也应在 3V3 尚未建立时测量。

## 本页交付给下一阶段的清单

| 处理 | 内容 |
| --- | --- |
| 保留 | 单节电池、低静态电流主轨目标；常供电 MCU 与可控外设轨的分域思路；充电状态回读和独立电池电压诊断 |
| 修改 | Q3 电池/系统隔离路径；完善 Power Path、NTC 与电池保护约束；低电量升降压能力；分开 EPD/触摸/SD 电源；默认状态与上电斜率；独立 VBUS 检测；修正 R22 注释；建立断轨前的停止/隔离顺序 |
| 待验证 | 实物是否与归档一致；Q3 有无改线；电池包保护/NTC/允许电流；充电热设计与输入能力；峰值电流/低压波形；Q2 启动浪涌和复位状态；失电域倒灌；BAT_SENSE 整链路误差 |

本次没有连接真实电池做试验，没有修改固件、原理图或 PCB。原厂资料核对日期为 2026-11-01；来源链接用于规格依据，实际装配批次和器件版本仍应随旧板实物核对。
