xiaobaoaaaaaa/ESPaperPlay-V2/hardware/devboard-r0/output/pcb/ESPaperPlay_Placement_r7.png

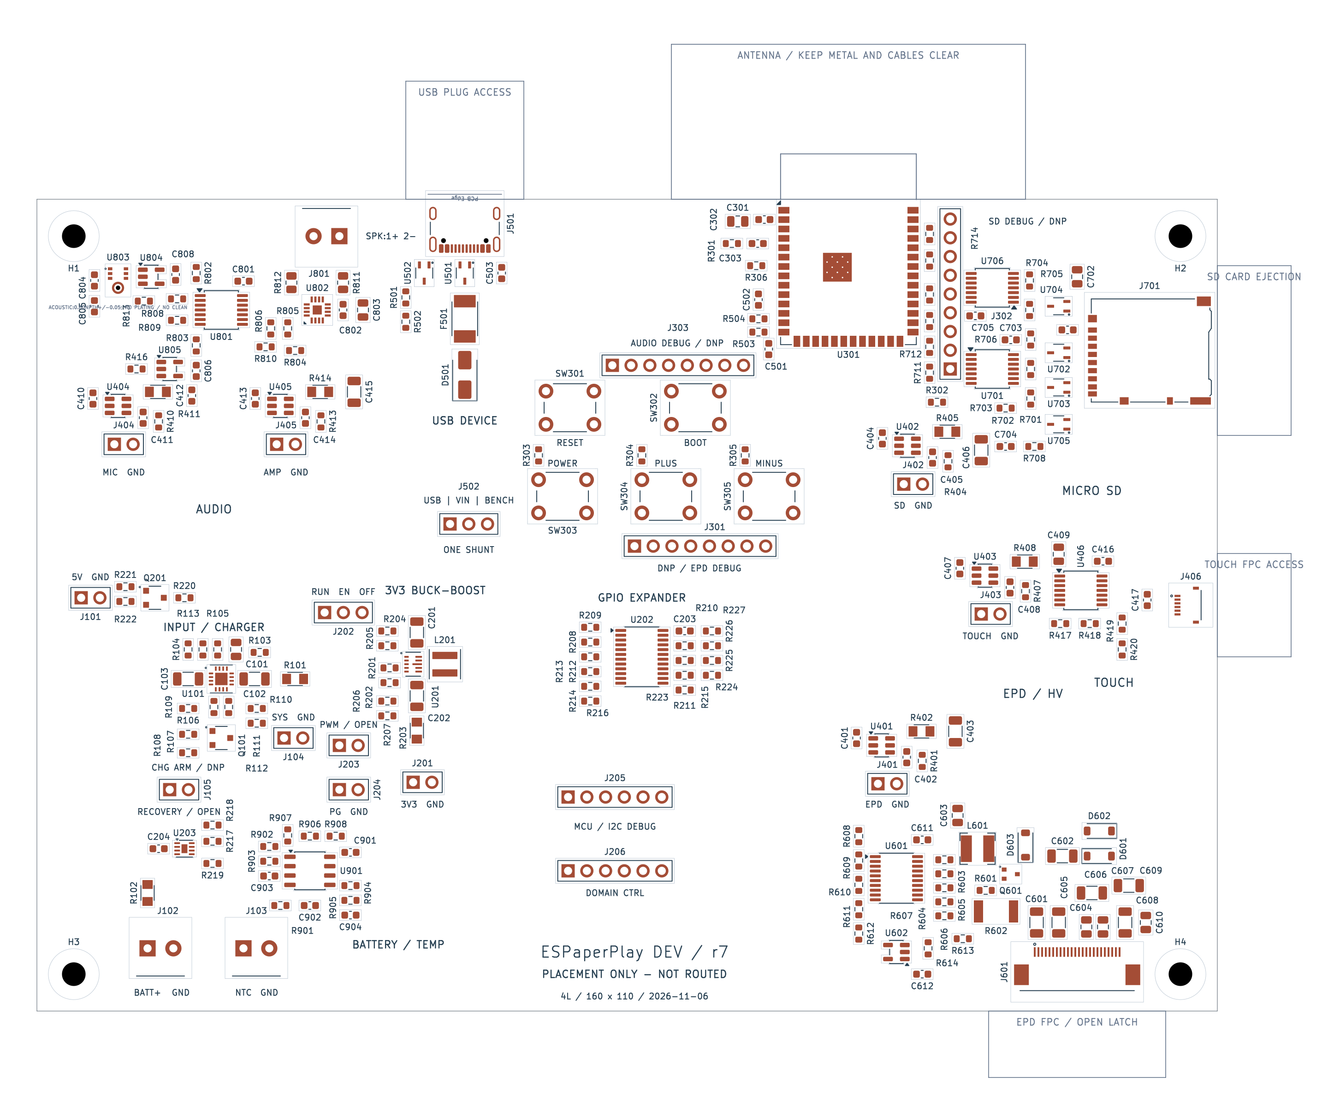
hardware/devboard-r0/output/pcb/ESPaperPlay_Placement_r7.png
