xiaobaoaaaaaa/ESPaperPlay-V2/hardware/devboard-r0/output/pcb/ESPaperPlay_Placement_r7_3D.png

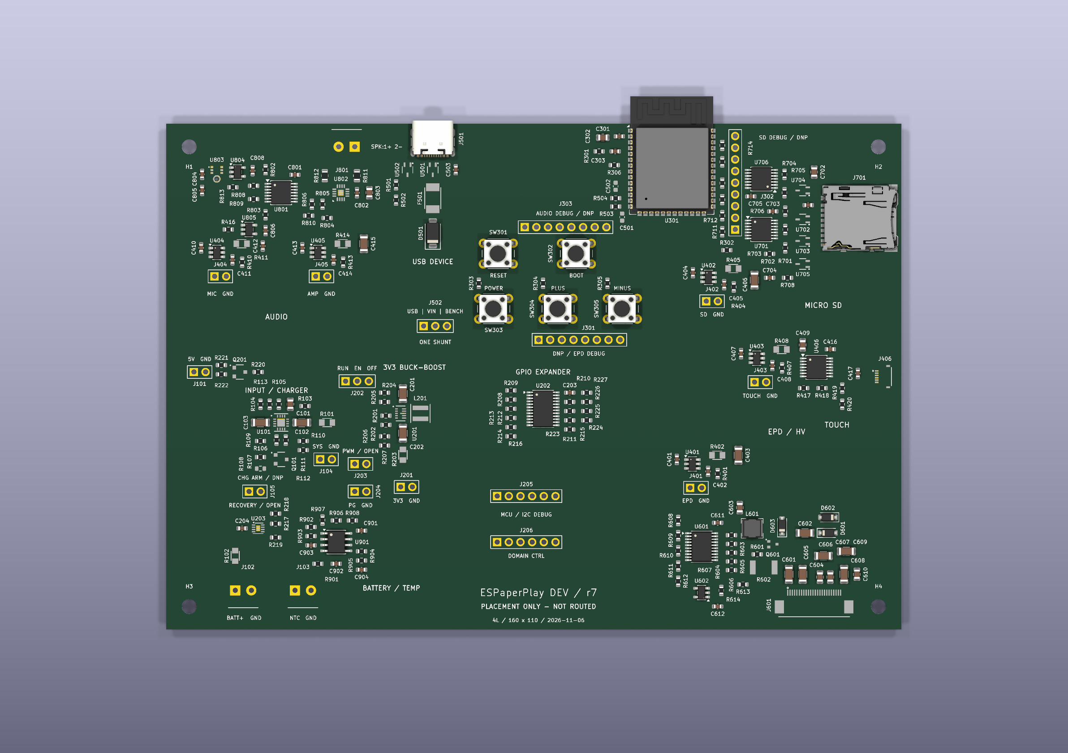
hardware/devboard-r0/output/pcb/ESPaperPlay_Placement_r7_3D.png
