xiaobaoaaaaaa/ESPaperPlay-V2/hardware/devboard-r0/output/pcb/ESPaperPlay_Routing_r8_ground1.png

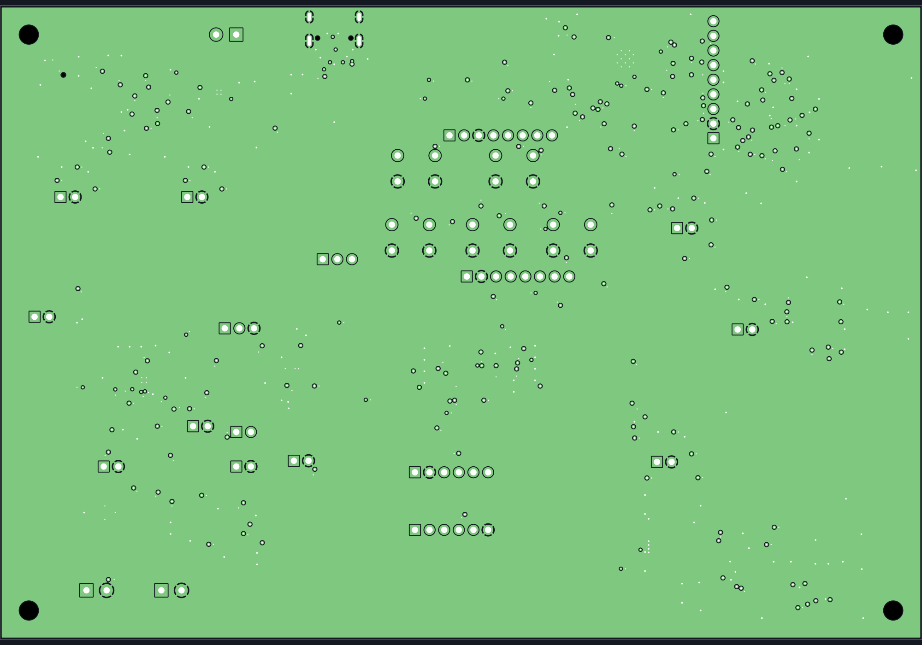
hardware/devboard-r0/output/pcb/ESPaperPlay_Routing_r8_ground1.png
