xiaobaoaaaaaa/ESPaperPlay-V2/hardware/devboard-r0/output/pcb/ESPaperPlay_Routing_r8_ground2.png

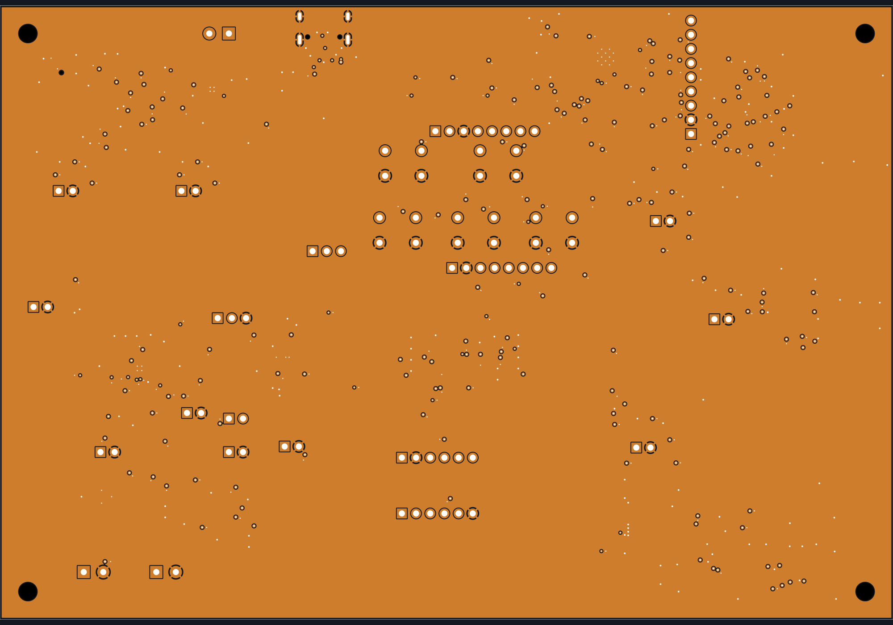
hardware/devboard-r0/output/pcb/ESPaperPlay_Routing_r8_ground2.png
