xiaobaoaaaaaa/ESPaperPlay-V2/hardware/devboard-r0/review-r11/component-closure.md

# r11：首板物料与关键电容闭合路径

2026-11-14。审查对象为 r10 PCB、r6 网表及 r10 实装 BOM；文件哈希、56 个实装电容的位置/网络/10 种准确料号见 [机器记录](component-closure.json)。本轮没有换料、改封装、购货或上电。

**建议保留现有候选料号和封装推进裸板工艺审核。** 本轮没有查到足以要求立即改板或指定替换料号的证据；也没有取得四个关键位置在联合偏压、温度、老化下的保证容量。将剩余事项落实到来料与首板验证，不能把整份 BOM 标成“已采购冻结”或“所有有效容量合格”。

## 当前能确定的内容

- TPS63802 的有效输入下限为 **4 µF**，输出高于 2.3 V 时有效输出下限为 **7 µF**。芯片推荐的 10 µF/22 µF 标称搭配与现板一致，但仍须核实际降容。[TI，§8.3、§10.2.2](https://www.ti.com/lit/ds/symlink/tps63802.pdf)
- BQ24074 对 IN 的标称旁路建议为 1–10 µF，对 OUT/BAT 为 4.7–47 µF。C101=4.7 µF、C102/C103=10 µF 满足该标称搭配；项目另定的 OUT/BAT **偏压后≥4.7 µF** 继续作为保守验收值，不能冒充 TI 明文保证。[TI，pin functions、§10.2.2.5](https://www.ti.com/lit/ds/symlink/bq24074.pdf)
- MAX98357A 供电旁路建议 0.1 µF+10 µF；实际对应 **C802+C803**，均在 AMP_SYS，另外 C415=22 µF 位于同一受控域。此搭配名义上吻合，远端 C415 不能替代本地 C803 的高频去耦和动态实测。C804 在 MIC_3V3，不能计入功放旁路。[ADI，Rev16，p33](https://www.analog.com/media/en/technical-documentation/data-sheets/MAX98357A-MAX98357B.pdf)
- TDK 四个重点候选的官方索引页仍标为 Production：10 µF/16 V 的 C3216X5R1C106K160AA、22 µF/16 V 的 C3216X5R1C226M160AB、10 µF/10 V 的 C2012X7R1A106K125AC、4.7 µF/25 V 的 C2012X7R1E475K125AB。这是产品状态，**不是现货、价格或交期确认**；各链接已记入 JSON。

## 四个关键位置的明确验收值

| 位置 | 原候选料号 / 封装 | 测量偏压 | 最低有效容量 | 对初始负公差后的最低联合保持率 |
|---|---|---:|---:|---:|
| C102，SYS_RAW | C3216X5R1C106K160AA / 1206 | 5.0 V | 4.7 µF，项目规则 | 52.22% |
| C103，BAT_PROT | 同上 | 4.5 V | 4.7 µF，项目规则 | 52.22% |
| C201，SYS | 同上 | 5.0 V | 4.0 µF，TI 下限 | 44.44% |
| C202，3V3_REG | C3216X5R1C226M160AB / 1206 | 3.6 V | 7.0 µF，TI 下限 | 39.77% |

保持率仅是 `最低有效容量÷[标称容量×(1−初始容差)]` 的门槛计算，**不是已测保持率**。若测量的是实际样品容量，不得再重复扣除其初始容差。电压为已有资格检查包络，不表示允许把整板或电池施加到该电压；测量对象应为离板电容或专用夹具。

TDK 当前公开交付规范 GC11010030（2026-09）把容量测试的 AC 条件指向厂商确认；温度分类的 ±15% 明确属于未施加电压条件。因此不能凭一条通用的“1 kHz/1 Vrms”规则判定这些准确型号的标称容差，也不能把独立典型偏压曲线与 ±15%/自选老化比例直接相乘后称为最坏保证。[TDK，p6–7、p17](https://product.tdk.com/system/files/dam/doc/product/capacitor/ceramic/mlcc/specification/mlccspec_commercial_general_midvoltage_en.pdf)

本轮访问现状：原厂产品页/特性 PDF 的直接下载和浏览器访问均返回 403；搜索服务可返回特性表及部分图形的索引转录，但未取得可独立查看的原始曲线图。因此 JSON 没有把索引中的近似曲线读数写进任何通过判据，也没有伪造下载文件或哈希。继续向供货渠道取得准确料号数据，或采用下述实物路径即可推进，不必将下一轮工作重复为同样的网页搜索。

## 首批来料如何实际闭合

1. 采购准备按准确完整 MPN 和当前封装保留，不接受仅写“10 µF 16 V 1206”的无品牌等值替代。记录供应渠道、标签、批次和日期码；每种关键电容保留未装配样品用于核验。数量由首批装配量及备料规则确定，本报告不指定采购数量。
2. 用支持 DC bias 的 LCR 表/厂家指定夹具测试离板样品；测试记录必须含 AC 频率/幅度、实际 DC 电压、偏压稳定时间、温度、夹具开短路补偿、仪器不确定度、回流/热处理与存放历史。不要把直流源直接并到不支持偏压的 LCR 测量端。
3. 首板室温筛查须在计划的室温范围内完成上述四点，判据为 **读数减去测量不确定度仍高于表内下限**；测试条件须适合实际工作中的小信号容量。缺少厂商标称容量测试条件时，可用于工程筛查，但不能据此声称厂家容差不合格或全温度/全寿命合格。拿不到适当仪表时，委托器件渠道提供同条件数据或测量服务，而不是改用无偏压读数放行。
4. 样品通过后，首板仍需做限流供电、启动及负载阶跃/纹波检查。C102 与 C201 虽位于经测流链路连通的系统电源附近，不能仅把两者容量相加当作每个 IC 的本地去耦已合格。
5. 若任一关键位置不通过，先寻找 **同封装、同介质或更合适介质、达到相同偏压下限的准确料号**；重新审查高度、容量上限、浪涌、钢网与回流。需要增加并联位或更大封装时再回到 CAD 改版。当前没有足够证据指定某一替代料号必然优于现型号，所以不预填替代件。

室温样品记录只放行该轮样板条件。X5R 电容本体仍不得超过 85°C；扩展工作温度、长期老化及批量供货仍须取得相应数据或验证。此处没有新增整机温度、续航或充电能力承诺。

## 屏幕高压和音频单独在对应阶段验证

| 对象 | 保留候选与需要记录的量 | 能否仅靠额定值闭合 |
|---|---|---|
| C601/C604/C607/C608/C609 | GRM31CR71H475KA12L，1206，4.7 µF/50 V；各自端到端电压峰值、工作偏压、纹波及本体温度 | 不能。屏厂参考标称容量不能转写为最低有效容量 |
| C602 飞跨电容 | 同上；测 `V(EPD_FLY)−V(EPD_SW)`，含启动、刷新、关断 | 不能用单端对地峰值代替 |
| C610，VCOM | C2012X7R1H105K125AB，0805，1 µF/50 V；VCOM 端到端应力与波形 | 不能从“50 V”推定有效容量 |
| C606，面板内部 VDD | 同型号；保持 EPD_VDD_INT，不连接外部 3V3 | 先按面板资料核其内部轨，不借用外部 3.6 V 假设 |
| C803/C415，功放旁路 | 原 0805 的10 µF与1206的22 µF；AMP_SYS启动/播放压降、纹波、本体温度 | 标称搭配通过；待实测供电与声学性能 |

高压测量应采用合适额定的差分测量方法，尤其 C602 两端；示波器地夹不能接开关节点。保持原有首测音频输出≤0.5 W测试上限、R108 DNP、J105 开放。上述缺口属于器件和对应上电阶段验收，**不必扩大为与之无关的裸板文件重导或整板重布线**。

本轮完成的是候选复核、门槛与取证路径；尚未获得器件批次实测或原厂联合保证，因此四个有效容量门槛仍明确标记 OPEN。
