xiaobaoaaaaaa/ESPaperPlay-V2/outputs/espaperplay-bom-r3/ESPaperPlay_BOM_Review_r3.xlsx

Sheet: 审查总览
ESPaperPlay 开发板 r3 BOM 审查
审查日期：2026-11-02
候选审查表，非生产 / 采购放行 BOM。尚无报价、库存承诺或实物装配结论。
统计项 | 位号数 | 口径
全部位置 | 222 | 包含所有默认装配与 DNP 位置
DNP 位置 | 6 | DNP 始终独立保留，选定封装不代表改为装配
默认装配候选 | 216 | 仅表示原理图默认装配状态
有封装候选 | 215 | 已指定候选不等于通过钢网、焊接或机械装配验收
未指定封装 | 7 | 电池 / NTC / 屏与触摸 / 扬声器 / EPD 采样 / 麦克风
有准确料号候选 | 184 | 含 DNP 候选，不能据此直接下单
未指定准确料号 | 38 | 继续核实有效容量、负载、结构与供应要求
需专项闭合 | 51 | 逐项待闭合事项见 BOM 表
下一阶段重点 | 涉及位置 | 需要补齐的依据
屏幕与触摸插座 | J601 / J406 | 沿旧板 HYCW3D-05FPC24-200B、LAIL-FPC-CDX01-6P0.5-GW 继续取得原厂图或样品。核接触面、端部插入长度、加强板及折弯方向。
电池、NTC、扬声器线束 | J102 / J103 / J801 | 确认实际组件、连接器及极性。电池容量 / 充电边界与 NTC 曲线未定。扬声器为 BTL 输出，两线均不接地。
EPD 采样电阻 | R602 | 保留 0.47Ω 电气目标。取得峰值、RMS、占空比与脉冲能量后定额定值与封装。
麦克风声学与封装 | U803 | 候选 DMM-4026-B-I2S-R。确认生命周期、声孔、钢网 / 阻焊与声道。器件声孔直径不能直接充当 PCB 孔径。
电源器件及大容量 MLCC | 电源与音频 | 补齐偏压后的有效容量、温度 / 公差 / 老化、浪涌、脉冲与热条件，安排限流上电和实际负载验证。
连接器及装配工艺 | USB / SD / 按键 | USB 板边与壳体插脚；SD 推推机构、检测触点及禁布区；按键低电流接触可靠性；暴露焊盘的钢网与过孔工艺。
100nF 候选已改为 TDK C1608X7R1H104K080AA（50V、X7R、0603），原厂在产状态已核对。
原 Murata GRM188R71C104KA01D 因厂商标记将停产而退出本轮候选。
数字由 BOM 明细公式统计。更改 DNP 后统计随之更新；未指定项可通过表头筛选定位。

Sheet: BOM
ESPaperPlay r3 候选 BOM
一行一个位号，数量为单板位置数。空白料号 / 封装表示尚未选定。
DNP：是 = 默认不装。灰色提示 DNP，红色提示缺封装，黄色提示缺准确料号。
位号 | 原理图页 | 数值 / 功能 | 数量 | DNP | 制造商候选 | 准确料号候选 | KiCad 封装候选 | 审查状态 | 待闭合事项 | 封装状态 | 料号状态 | 原厂资料
C101 | 电源输入与充电 | 4.7u / 16V | 1 | 否 |  |  | Capacitor_SMD:C_0805_2012Metric | 需专项闭合 | 准确料号/工作偏压有效容量及容差、温度、老化待闭合。 | 候选已指定 | 未指定 | https://www.ti.com/lit/ds/symlink/bq24074.pdf
C102 | 电源输入与充电 | 10u / 10V | 1 | 否 |  |  | Capacitor_SMD:C_0805_2012Metric | 需专项闭合 | 准确料号/工作偏压有效容量及容差、温度、老化待闭合。 | 候选已指定 | 未指定 | https://www.ti.com/lit/ds/symlink/bq24074.pdf
C103 | 电源输入与充电 | 10u / 10V | 1 | 否 |  |  | Capacitor_SMD:C_0805_2012Metric | 需专项闭合 | 准确料号/工作偏压有效容量及容差、温度、老化待闭合。 | 候选已指定 | 未指定 | https://www.ti.com/lit/ds/symlink/bq24074.pdf
J101 | 电源输入与充电 | 5V_BENCH_IN | 1 | 否 | Würth Elektronik | 61300211121 | ESPaperPlay:WR_PHD_1x02_P2.54_Drill1.10 | 资料核对候选 | 针座/线束/短路帽适配及额定待确认；DNP状态按原理图执行。 | 候选已指定 | 候选已指定 | https://www.we-online.com/components/products/datasheet/61300211121.pdf
J102 | 电源输入与充电 | BAT_PACK_PROTECTED | 1 | 否 |  |  |  | 需专项闭合 | 电池连接器、极性和线束额定待定。 | 未指定 | 未指定
J103 | 电源输入与充电 | PACK_NTC | 1 | 否 |  |  |  | 需专项闭合 | NTC连接器、曲线和温区待定。 | 未指定 | 未指定
J104 | 电源输入与充电 | SYS_TEST | 1 | 否 | Würth Elektronik | 61300211121 | ESPaperPlay:WR_PHD_1x02_P2.54_Drill1.10 | 资料核对候选 | 针座/线束/短路帽适配及额定待确认；DNP状态按原理图执行。 | 候选已指定 | 候选已指定 | https://www.we-online.com/components/products/datasheet/61300211121.pdf
J105 | 电源输入与充电 | RECOVERY_CE | 1 | 否 | Würth Elektronik | 61300211121 | ESPaperPlay:WR_PHD_1x02_P2.54_Drill1.10 | 资料核对候选 | 针座/线束/短路帽适配及额定待确认；DNP状态按原理图执行。 | 候选已指定 | 候选已指定 | https://www.we-online.com/components/products/datasheet/61300211121.pdf
Q101 | 电源输入与充电 | AO3400A | 1 | 否 | Alpha and Omega Semiconductor | AO3400A | ESPaperPlay:AOS_SOT23_PO00001N | 资料核对候选 | 候选规格/引脚核对；装配工艺、实际负载与供货仍需确认。 | 候选已指定 | 候选已指定 | https://www.aosmd.com/sites/default/files/res/data_sheets/AO3400A.pdf https://www.aosmd.com/sites/default/files/res/package/SOT23.pdf
Q201 | 电源输入与充电 | AO3400A | 1 | 否 | Alpha and Omega Semiconductor | AO3400A | ESPaperPlay:AOS_SOT23_PO00001N | 资料核对候选 | 候选规格/引脚核对；装配工艺、实际负载与供货仍需确认。 | 候选已指定 | 候选已指定 | https://www.aosmd.com/sites/default/files/res/data_sheets/AO3400A.pdf https://www.aosmd.com/sites/default/files/res/package/SOT23.pdf
R101 | 电源输入与充电 | 0R / I_SYS | 1 | 否 | Bourns | CRF0805-J/-000ELF | ESPaperPlay:Bourns_CRF0805_Jumper | 资料核对候选 | 候选规格/引脚核对；装配工艺、实际负载与供货仍需确认。 | 候选已指定 | 候选已指定 | https://www.bourns.com/docs/product-datasheets/crf-j.pdf?sfvrsn=da3727f6_4
R102 | 电源输入与充电 | 0R / I_BAT | 1 | 否 | Bourns | CRF0805-J/-000ELF | ESPaperPlay:Bourns_CRF0805_Jumper | 资料核对候选 | 候选规格/引脚核对；装配工艺、实际负载与供货仍需确认。 | 候选已指定 | 候选已指定 | https://www.bourns.com/docs/product-datasheets/crf-j.pdf?sfvrsn=da3727f6_4
R103 | 电源输入与充电 | 1.62k / 1% | 1 | 否 | Vishay | CRCW06031K62FKEA | Resistor_SMD:R_0603_1608Metric | 资料核对候选 | 候选规格/引脚核对；装配工艺、实际负载与供货仍需确认。 | 候选已指定 | 候选已指定 | https://www.vishay.com/docs/20035/dcrcwe3.pdf
R104 | 电源输入与充电 | 3.00k / 1% | 1 | 否 | Vishay | CRCW06033K00FKEA | Resistor_SMD:R_0603_1608Metric | 资料核对候选 | 候选规格/引脚核对；装配工艺、实际负载与供货仍需确认。 | 候选已指定 | 候选已指定 | https://www.vishay.com/docs/20035/dcrcwe3.pdf
R105 | 电源输入与充电 | 68k / 1% | 1 | 否 | Vishay | CRCW060368K0FKEA | Resistor_SMD:R_0603_1608Metric | 资料核对候选 | 候选规格/引脚核对；装配工艺、实际负载与供货仍需确认。 | 候选已指定 | 候选已指定 | https://www.vishay.com/docs/20035/dcrcwe3.pdf
R106 | 电源输入与充电 | 47k / 1% | 1 | 否 | Vishay | CRCW060347K0FKEA | Resistor_SMD:R_0603_1608Metric | 资料核对候选 | 候选规格/引脚核对；装配工艺、实际负载与供货仍需确认。 | 候选已指定 | 候选已指定 | https://www.vishay.com/docs/20035/dcrcwe3.pdf
R107 | 电源输入与充电 | 100k | 1 | 否 | Vishay | CRCW0603100KFKEA | Resistor_SMD:R_0603_1608Metric | 资料核对候选 | 候选规格/引脚核对；装配工艺、实际负载与供货仍需确认。 | 候选已指定 | 候选已指定 | https://www.vishay.com/docs/20035/dcrcwe3.pdf
R108 | 电源输入与充电 | 0R CHG_ARM | 1 | 是 | Vishay | CRCW06030000Z0EA | Resistor_SMD:R_0603_1608Metric | 资料核对候选 | 候选规格/引脚核对；装配工艺、实际负载与供货仍需确认。 | 候选已指定 | 候选已指定 | https://www.vishay.com/docs/20035/dcrcwe3.pdf
R109 | 电源输入与充电 | 100k | 1 | 否 | Vishay | CRCW0603100KFKEA | Resistor_SMD:R_0603_1608Metric | 资料核对候选 | 候选规格/引脚核对；装配工艺、实际负载与供货仍需确认。 | 候选已指定 | 候选已指定 | https://www.vishay.com/docs/20035/dcrcwe3.pdf
R110 | 电源输入与充电 | 100k | 1 | 否 | Vishay | CRCW0603100KFKEA | Resistor_SMD:R_0603_1608Metric | 资料核对候选 | 候选规格/引脚核对；装配工艺、实际负载与供货仍需确认。 | 候选已指定 | 候选已指定 | https://www.vishay.com/docs/20035/dcrcwe3.pdf
R111 | 电源输入与充电 | 100k | 1 | 否 | Vishay | CRCW0603100KFKEA | Resistor_SMD:R_0603_1608Metric | 资料核对候选 | 候选规格/引脚核对；装配工艺、实际负载与供货仍需确认。 | 候选已指定 | 候选已指定 | https://www.vishay.com/docs/20035/dcrcwe3.pdf
R112 | 电源输入与充电 | 100k | 1 | 否 | Vishay | CRCW0603100KFKEA | Resistor_SMD:R_0603_1608Metric | 资料核对候选 | 候选规格/引脚核对；装配工艺、实际负载与供货仍需确认。 | 候选已指定 | 候选已指定 | https://www.vishay.com/docs/20035/dcrcwe3.pdf
R220 | 电源输入与充电 | 100k | 1 | 否 | Vishay | CRCW0603100KFKEA | Resistor_SMD:R_0603_1608Metric | 资料核对候选 | 候选规格/引脚核对；装配工艺、实际负载与供货仍需确认。 | 候选已指定 | 候选已指定 | https://www.vishay.com/docs/20035/dcrcwe3.pdf
R221 | 电源输入与充电 | 10k | 1 | 否 | Vishay | CRCW060310K0FKEA | Resistor_SMD:R_0603_1608Metric | 资料核对候选 | 候选规格/引脚核对；装配工艺、实际负载与供货仍需确认。 | 候选已指定 | 候选已指定 | https://www.vishay.com/docs/20035/dcrcwe3.pdf
R222 | 电源输入与充电 | 47k | 1 | 否 | Vishay | CRCW060347K0FKEA | Resistor_SMD:R_0603_1608Metric | 资料核对候选 | 候选规格/引脚核对；装配工艺、实际负载与供货仍需确认。 | 候选已指定 | 候选已指定 | https://www.vishay.com/docs/20035/dcrcwe3.pdf
U101 | 电源输入与充电 | BQ24074RGT | 1 | 否 | Texas Instruments | BQ24074RGTR | ESPaperPlay:TI_RGT0016C_VQFN_3x3mm_P0.5mm_EP1.68mm | 需专项闭合 | 约0.297A典型充电仅为候选；电池容量、NTC、允许电流未定，R108保持DNP。 | 候选已指定 | 候选已指定 | https://www.ti.com/lit/ds/symlink/bq24074.pdf
C201 | 3.3V 电源控制 | 10u / 10V | 1 | 否 |  |  | Capacitor_SMD:C_0805_2012Metric | 需专项闭合 | 准确料号/工作偏压有效容量及容差、温度、老化待闭合。 | 候选已指定 | 未指定 | https://www.ti.com/lit/ds/symlink/tps63802.pdf
C202 | 3.3V 电源控制 | 22u / 10V | 1 | 否 |  |  | Capacitor_SMD:C_1206_3216Metric | 需专项闭合 | 准确料号/工作偏压有效容量及容差、温度、老化待闭合。 | 候选已指定 | 未指定 | https://www.ti.com/lit/ds/symlink/tps63802.pdf
C203 | 3.3V 电源控制 | 100n | 1 | 否 | TDK | C1608X7R1H104K080AA | Capacitor_SMD:C_0603_1608Metric | 资料核对候选 | 原厂在产候选；成本/供货与贴装工艺待确认。 | 候选已指定 | 候选已指定 | https://product.tdk.com/en/search/capacitor/ceramic/mlcc/info?part_no=C1608X7R1H104K080AA
C204 | 3.3V 电源控制 | 100n | 1 | 否 | TDK | C1608X7R1H104K080AA | Capacitor_SMD:C_0603_1608Metric | 资料核对候选 | 原厂在产候选；成本/供货与贴装工艺待确认。 | 候选已指定 | 候选已指定 | https://product.tdk.com/en/search/capacitor/ceramic/mlcc/info?part_no=C1608X7R1H104K080AA
J201 | 3.3V 电源控制 | 3V3_AON_TEST | 1 | 否 | Würth Elektronik | 61300211121 | ESPaperPlay:WR_PHD_1x02_P2.54_Drill1.10 | 资料核对候选 | 针座/线束/短路帽适配及额定待确认；DNP状态按原理图执行。 | 候选已指定 | 候选已指定 | https://www.we-online.com/components/products/datasheet/61300211121.pdf
J202 | 3.3V 电源控制 | MAIN_RUN_SELECT | 1 | 否 | Würth Elektronik | 61300311121 | ESPaperPlay:WR_PHD_1x03_P2.54_Drill1.10 | 资料核对候选 | 针座/线束/短路帽适配及额定待确认；DNP状态按原理图执行。 | 候选已指定 | 候选已指定 | https://www.we-online.com/components/products/datasheet/61300311121.pdf
J203 | 3.3V 电源控制 | PWM_TEST_OPEN | 1 | 否 | Würth Elektronik | 61300211121 | ESPaperPlay:WR_PHD_1x02_P2.54_Drill1.10 | 资料核对候选 | 针座/线束/短路帽适配及额定待确认；DNP状态按原理图执行。 | 候选已指定 | 候选已指定 | https://www.we-online.com/components/products/datasheet/61300211121.pdf
J204 | 3.3V 电源控制 | REG_PG_TEST | 1 | 否 | Würth Elektronik | 61300211121 | ESPaperPlay:WR_PHD_1x02_P2.54_Drill1.10 | 资料核对候选 | 针座/线束/短路帽适配及额定待确认；DNP状态按原理图执行。 | 候选已指定 | 候选已指定 | https://www.we-online.com/components/products/datasheet/61300211121.pdf
J205 | 3.3V 电源控制 | MCU_BRINGUP | 1 | 否 | Würth Elektronik | 61300611121 | ESPaperPlay:WR_PHD_1x06_P2.54_Drill1.10 | 资料核对候选 | 针座/线束/短路帽适配及额定待确认；DNP状态按原理图执行。 | 候选已指定 | 候选已指定 | https://www.we-online.com/components/products/datasheet/61300611121.pdf
J206 | 3.3V 电源控制 | DOMAINS_CONTROL | 1 | 否 | Würth Elektronik | 61300611121 | ESPaperPlay:WR_PHD_1x06_P2.54_Drill1.10 | 资料核对候选 | 针座/线束/短路帽适配及额定待确认；DNP状态按原理图执行。 | 候选已指定 | 候选已指定 | https://www.we-online.com/components/products/datasheet/61300611121.pdf
L201 | 3.3V 电源控制 | 0.47uH | 1 | 否 | Coilcraft | XFL4015-471MEC | ESPaperPlay:Coilcraft_XFL4015_4x4mm | 需专项闭合 | 0.47uH候选；最低电池电压/负载峰值下饱和、纹波、温升待核。 | 候选已指定 | 候选已指定 | https://www.ti.com/lit/ds/symlink/tps63802.pdf https://www.coilcraft.com/getmedia/84927b8b-f089-421b-a7f4-a0fa23afe908/xfl4015.pdf
R201 | 3.3V 电源控制 | 511k / 1% | 1 | 否 | Vishay | CRCW0603511KFKEA | Resistor_SMD:R_0603_1608Metric | 资料核对候选 | 候选规格/引脚核对；装配工艺、实际负载与供货仍需确认。 | 候选已指定 | 候选已指定 | https://www.vishay.com/docs/20035/dcrcwe3.pdf
R202 | 3.3V 电源控制 | 91k / 1% | 1 | 否 | Vishay | CRCW060391K0FKEA | Resistor_SMD:R_0603_1608Metric | 资料核对候选 | 候选规格/引脚核对；装配工艺、实际负载与供货仍需确认。 | 候选已指定 | 候选已指定 | https://www.vishay.com/docs/20035/dcrcwe3.pdf
R203 | 3.3V 电源控制 | 0R / I_3V3 | 1 | 否 | Bourns | CRF0805-J/-000ELF | ESPaperPlay:Bourns_CRF0805_Jumper | 资料核对候选 | 候选规格/引脚核对；装配工艺、实际负载与供货仍需确认。 | 候选已指定 | 候选已指定 | https://www.bourns.com/docs/product-datasheets/crf-j.pdf?sfvrsn=da3727f6_4
R204 | 3.3V 电源控制 | 100k | 1 | 否 | Vishay | CRCW0603100KFKEA | Resistor_SMD:R_0603_1608Metric | 资料核对候选 | 候选规格/引脚核对；装配工艺、实际负载与供货仍需确认。 | 候选已指定 | 候选已指定 | https://www.vishay.com/docs/20035/dcrcwe3.pdf
R205 | 3.3V 电源控制 | 1M | 1 | 否 | Vishay | CRCW06031M00FKEA | Resistor_SMD:R_0603_1608Metric | 资料核对候选 | 候选规格/引脚核对；装配工艺、实际负载与供货仍需确认。 | 候选已指定 | 候选已指定 | https://www.vishay.com/docs/20035/dcrcwe3.pdf
R206 | 3.3V 电源控制 | 100k | 1 | 否 | Vishay | CRCW0603100KFKEA | Resistor_SMD:R_0603_1608Metric | 资料核对候选 | 候选规格/引脚核对；装配工艺、实际负载与供货仍需确认。 | 候选已指定 | 候选已指定 | https://www.vishay.com/docs/20035/dcrcwe3.pdf
R207 | 3.3V 电源控制 | 100k | 1 | 否 | Vishay | CRCW0603100KFKEA | Resistor_SMD:R_0603_1608Metric | 资料核对候选 | 候选规格/引脚核对；装配工艺、实际负载与供货仍需确认。 | 候选已指定 | 候选已指定 | https://www.vishay.com/docs/20035/dcrcwe3.pdf
R208 | 3.3V 电源控制 | 10k | 1 | 否 | Vishay | CRCW060310K0FKEA | Resistor_SMD:R_0603_1608Metric | 资料核对候选 | 候选规格/引脚核对；装配工艺、实际负载与供货仍需确认。 | 候选已指定 | 候选已指定 | https://www.vishay.com/docs/20035/dcrcwe3.pdf
R209 | 3.3V 电源控制 | 100k | 1 | 否 | Vishay | CRCW0603100KFKEA | Resistor_SMD:R_0603_1608Metric | 资料核对候选 | 候选规格/引脚核对；装配工艺、实际负载与供货仍需确认。 | 候选已指定 | 候选已指定 | https://www.vishay.com/docs/20035/dcrcwe3.pdf
R210 | 3.3V 电源控制 | 4.7k | 1 | 否 | Vishay | CRCW06034K70FKEA | Resistor_SMD:R_0603_1608Metric | 资料核对候选 | 候选规格/引脚核对；装配工艺、实际负载与供货仍需确认。 | 候选已指定 | 候选已指定 | https://www.vishay.com/docs/20035/dcrcwe3.pdf
R211 | 3.3V 电源控制 | 4.7k | 1 | 否 | Vishay | CRCW06034K70FKEA | Resistor_SMD:R_0603_1608Metric | 资料核对候选 | 候选规格/引脚核对；装配工艺、实际负载与供货仍需确认。 | 候选已指定 | 候选已指定 | https://www.vishay.com/docs/20035/dcrcwe3.pdf
R212 | 3.3V 电源控制 | 100k | 1 | 否 | Vishay | CRCW0603100KFKEA | Resistor_SMD:R_0603_1608Metric | 资料核对候选 | 候选规格/引脚核对；装配工艺、实际负载与供货仍需确认。 | 候选已指定 | 候选已指定 | https://www.vishay.com/docs/20035/dcrcwe3.pdf
R213 | 3.3V 电源控制 | 100k | 1 | 否 | Vishay | CRCW0603100KFKEA | Resistor_SMD:R_0603_1608Metric | 资料核对候选 | 候选规格/引脚核对；装配工艺、实际负载与供货仍需确认。 | 候选已指定 | 候选已指定 | https://www.vishay.com/docs/20035/dcrcwe3.pdf
R214 | 3.3V 电源控制 | 100k | 1 | 否 | Vishay | CRCW0603100KFKEA | Resistor_SMD:R_0603_1608Metric | 资料核对候选 | 候选规格/引脚核对；装配工艺、实际负载与供货仍需确认。 | 候选已指定 | 候选已指定 | https://www.vishay.com/docs/20035/dcrcwe3.pdf
R215 | 3.3V 电源控制 | 10k | 1 | 否 | Vishay | CRCW060310K0FKEA | Resistor_SMD:R_0603_1608Metric | 资料核对候选 | 候选规格/引脚核对；装配工艺、实际负载与供货仍需确认。 | 候选已指定 | 候选已指定 | https://www.vishay.com/docs/20035/dcrcwe3.pdf
R216 | 3.3V 电源控制 | 100k | 1 | 否 | Vishay | CRCW0603100KFKEA | Resistor_SMD:R_0603_1608Metric | 资料核对候选 | 候选规格/引脚核对；装配工艺、实际负载与供货仍需确认。 | 候选已指定 | 候选已指定 | https://www.vishay.com/docs/20035/dcrcwe3.pdf
R217 | 3.3V 电源控制 | 0R | 1 | 否 | Vishay | CRCW06030000Z0EA | Resistor_SMD:R_0603_1608Metric | 资料核对候选 | 候选规格/引脚核对；装配工艺、实际负载与供货仍需确认。 | 候选已指定 | 候选已指定 | https://www.vishay.com/docs/20035/dcrcwe3.pdf
R218 | 3.3V 电源控制 | 0R | 1 | 否 | Vishay | CRCW06030000Z0EA | Resistor_SMD:R_0603_1608Metric | 资料核对候选 | 候选规格/引脚核对；装配工艺、实际负载与供货仍需确认。 | 候选已指定 | 候选已指定 | https://www.vishay.com/docs/20035/dcrcwe3.pdf
R219 | 3.3V 电源控制 | 100k | 1 | 否 | Vishay | CRCW0603100KFKEA | Resistor_SMD:R_0603_1608Metric | 资料核对候选 | 候选规格/引脚核对；装配工艺、实际负载与供货仍需确认。 | 候选已指定 | 候选已指定 | https://www.vishay.com/docs/20035/dcrcwe3.pdf
R223 | 3.3V 电源控制 | 10k | 1 | 否 | Vishay | CRCW060310K0FKEA | Resistor_SMD:R_0603_1608Metric | 资料核对候选 | 候选规格/引脚核对；装配工艺、实际负载与供货仍需确认。 | 候选已指定 | 候选已指定 | https://www.vishay.com/docs/20035/dcrcwe3.pdf
R224 | 3.3V 电源控制 | 100k | 1 | 否 | Vishay | CRCW0603100KFKEA | Resistor_SMD:R_0603_1608Metric | 资料核对候选 | 候选规格/引脚核对；装配工艺、实际负载与供货仍需确认。 | 候选已指定 | 候选已指定 | https://www.vishay.com/docs/20035/dcrcwe3.pdf
R225 | 3.3V 电源控制 | 100k | 1 | 否 | Vishay | CRCW0603100KFKEA | Resistor_SMD:R_0603_1608Metric | 资料核对候选 | 候选规格/引脚核对；装配工艺、实际负载与供货仍需确认。 | 候选已指定 | 候选已指定 | https://www.vishay.com/docs/20035/dcrcwe3.pdf
R226 | 3.3V 电源控制 | 100k | 1 | 否 | Vishay | CRCW0603100KFKEA | Resistor_SMD:R_0603_1608Metric | 资料核对候选 | 候选规格/引脚核对；装配工艺、实际负载与供货仍需确认。 | 候选已指定 | 候选已指定 | https://www.vishay.com/docs/20035/dcrcwe3.pdf
R227 | 3.3V 电源控制 | 100k | 1 | 否 | Vishay | CRCW0603100KFKEA | Resistor_SMD:R_0603_1608Metric | 资料核对候选 | 候选规格/引脚核对；装配工艺、实际负载与供货仍需确认。 | 候选已指定 | 候选已指定 | https://www.vishay.com/docs/20035/dcrcwe3.pdf
U201 | 3.3V 电源控制 | TPS63802DLA | 1 | 否 | Texas Instruments | TPS63802DLAR | ESPaperPlay:TI_DLA0010A_VSON-HR_2x3mm_P0.5mm | 资料核对候选 | 候选规格/引脚核对；装配工艺、实际负载与供货仍需确认。 | 候选已指定 | 候选已指定 | https://www.ti.com/lit/ds/symlink/tps63802.pdf
U202 | 3.3V 电源控制 | TCA9539PW / 0x74 | 1 | 否 | Texas Instruments | TCA9539PWR | Package_SO:TSSOP-24_4.4x7.8mm_P0.65mm | 资料核对候选 | 候选规格/引脚核对；装配工艺、实际负载与供货仍需确认。 | 候选已指定 | 候选已指定 | https://www.ti.com/lit/ds/symlink/tca9539.pdf
U203 | 3.3V 电源控制 | MAX17048G+ / 0x36 | 1 | 否 | Analog Devices / Maxim Integrated | MAX17048G+T10 | Package_DFN_QFN:TDFN-8-1EP_2x2mm_P0.5mm_EP0.8x1.2mm | 资料核对候选 | 候选规格/引脚核对；装配工艺、实际负载与供货仍需确认。 | 候选已指定 | 候选已指定 | https://www.analog.com/media/en/technical-documentation/data-sheets/MAX17048-MAX17049.pdf https://mds.analog.com/api/public/content/tdfn-cu_21-0168.pdf https://www.analog.com/media/en/pcn/pcn_2571d.pdf
C301 | 主控 | 10u / 10V | 1 | 否 |  |  | Capacitor_SMD:C_0805_2012Metric | 需专项闭合 | 准确料号/工作偏压有效容量及容差、温度、老化待闭合。 | 候选已指定 | 未指定
C302 | 主控 | 100n / 10V | 1 | 否 | TDK | C1608X7R1H104K080AA | Capacitor_SMD:C_0603_1608Metric | 资料核对候选 | 原厂在产候选；成本/供货与贴装工艺待确认。 | 候选已指定 | 候选已指定 | https://product.tdk.com/en/search/capacitor/ceramic/mlcc/info?part_no=C1608X7R1H104K080AA
C303 | 主控 | 1u / 10V | 1 | 否 |  |  | Capacitor_SMD:C_0603_1608Metric | 需专项闭合 | 准确料号/工作偏压有效容量及容差、温度、老化待闭合。 | 候选已指定 | 未指定
J301 | 主控 | EPD_DEBUG | 1 | 是 | Würth Elektronik | 61300811121 | ESPaperPlay:WR_PHD_1x08_P2.54_Drill1.10 | 资料核对候选 | 针座/线束/短路帽适配及额定待确认；DNP状态按原理图执行。 | 候选已指定 | 候选已指定 | https://www.we-online.com/components/products/datasheet/61300811121.pdf
J302 | 主控 | SD_DEBUG | 1 | 是 | Würth Elektronik | 61300911121 | ESPaperPlay:WR_PHD_1x09_P2.54_Drill1.10 | 资料核对候选 | 针座/线束/短路帽适配及额定待确认；DNP状态按原理图执行。 | 候选已指定 | 候选已指定 | https://www.we-online.com/components/products/datasheet/61300911121.pdf
J303 | 主控 | AUDIO_DEBUG | 1 | 是 | Würth Elektronik | 61300811121 | ESPaperPlay:WR_PHD_1x08_P2.54_Drill1.10 | 资料核对候选 | 针座/线束/短路帽适配及额定待确认；DNP状态按原理图执行。 | 候选已指定 | 候选已指定 | https://www.we-online.com/components/products/datasheet/61300811121.pdf
R301 | 主控 | 10k | 1 | 否 | Vishay | CRCW060310K0FKEA | Resistor_SMD:R_0603_1608Metric | 资料核对候选 | 候选规格/引脚核对；装配工艺、实际负载与供货仍需确认。 | 候选已指定 | 候选已指定 | https://www.vishay.com/docs/20035/dcrcwe3.pdf
R302 | 主控 | 10k | 1 | 否 | Vishay | CRCW060310K0FKEA | Resistor_SMD:R_0603_1608Metric | 资料核对候选 | 候选规格/引脚核对；装配工艺、实际负载与供货仍需确认。 | 候选已指定 | 候选已指定 | https://www.vishay.com/docs/20035/dcrcwe3.pdf
R303 | 主控 | 47k | 1 | 否 | Vishay | CRCW060347K0FKEA | Resistor_SMD:R_0603_1608Metric | 资料核对候选 | 候选规格/引脚核对；装配工艺、实际负载与供货仍需确认。 | 候选已指定 | 候选已指定 | https://www.vishay.com/docs/20035/dcrcwe3.pdf
R304 | 主控 | 47k | 1 | 否 | Vishay | CRCW060347K0FKEA | Resistor_SMD:R_0603_1608Metric | 资料核对候选 | 候选规格/引脚核对；装配工艺、实际负载与供货仍需确认。 | 候选已指定 | 候选已指定 | https://www.vishay.com/docs/20035/dcrcwe3.pdf
R305 | 主控 | 47k | 1 | 否 | Vishay | CRCW060347K0FKEA | Resistor_SMD:R_0603_1608Metric | 资料核对候选 | 候选规格/引脚核对；装配工艺、实际负载与供货仍需确认。 | 候选已指定 | 候选已指定 | https://www.vishay.com/docs/20035/dcrcwe3.pdf
R306 | 主控 | 10k | 1 | 否 | Vishay | CRCW060310K0FKEA | Resistor_SMD:R_0603_1608Metric | 资料核对候选 | 候选规格/引脚核对；装配工艺、实际负载与供货仍需确认。 | 候选已指定 | 候选已指定 | https://www.vishay.com/docs/20035/dcrcwe3.pdf
SW301 | 主控 | RESET | 1 | 否 | Omron | B3F-1002-G | Button_Switch_THT:SW_PUSH_6mm | 资料核对候选 | EN/BOOT约330µA；镀金触点候选，需按钮孔位/高度及实物验证。 | 候选已指定 | 候选已指定 | https://omronfs.omron.com/en_US/ecb/products/pdf/en-b3f.pdf
SW302 | 主控 | BOOT | 1 | 否 | Omron | B3F-1002-G | Button_Switch_THT:SW_PUSH_6mm | 资料核对候选 | EN/BOOT约330µA；镀金触点候选，需按钮孔位/高度及实物验证。 | 候选已指定 | 候选已指定 | https://omronfs.omron.com/en_US/ecb/products/pdf/en-b3f.pdf
SW303 | 主控 | POWER / IO21 | 1 | 否 | Omron | B3F-1002-G | Button_Switch_THT:SW_PUSH_6mm | 资料核对候选 | 47k普通键约70µA，需镀金触点低电流接触可靠性验证。 | 候选已指定 | 候选已指定 | https://omronfs.omron.com/en_US/ecb/products/pdf/en-b3f.pdf
SW304 | 主控 | PLUS / IO44 | 1 | 否 | Omron | B3F-1002-G | Button_Switch_THT:SW_PUSH_6mm | 资料核对候选 | 47k普通键约70µA，需镀金触点低电流接触可靠性验证。 | 候选已指定 | 候选已指定 | https://omronfs.omron.com/en_US/ecb/products/pdf/en-b3f.pdf
SW305 | 主控 | MINUS / IO5 | 1 | 否 | Omron | B3F-1002-G | Button_Switch_THT:SW_PUSH_6mm | 资料核对候选 | 47k普通键约70µA，需镀金触点低电流接触可靠性验证。 | 候选已指定 | 候选已指定 | https://omronfs.omron.com/en_US/ecb/products/pdf/en-b3f.pdf
U301 | 主控 | ESP32-S3-WROOM-1-N16R8 | 1 | 否 | Espressif Systems | ESP32-S3-WROOM-1-N16R8 | RF_Module:ESP32-S3-WROOM-1 | 需专项闭合 | 模组焊盘/编号核对；EP通孔填塞/钢网工艺和天线15mm净空待布局审查。 | 候选已指定 | 候选已指定 | https://www.espressif.com/sites/default/files/documentation/esp32-s3-wroom-1_wroom-1u_datasheet_en.pdf
C501 | USB 输入 | TUNE / DNP | 1 | 是 |  |  | Capacitor_SMD:C_0603_1608Metric | 待定准确料号 | DNP调谐位置，默认不装。 | 候选已指定 | 未指定
C502 | USB 输入 | TUNE / DNP | 1 | 是 |  |  | Capacitor_SMD:C_0603_1608Metric | 待定准确料号 | DNP调谐位置，默认不装。 | 候选已指定 | 未指定
C503 | USB 输入 | 100n / 16V | 1 | 否 | TDK | C1608X7R1H104K080AA | Capacitor_SMD:C_0603_1608Metric | 资料核对候选 | 原厂在产候选；成本/供货与贴装工艺待确认。 | 候选已指定 | 候选已指定 | https://product.tdk.com/en/search/capacitor/ceramic/mlcc/info?part_no=C1608X7R1H104K080AA
D501 | USB 输入 | AOS SMAJ6.0A | 1 | 否 | Alpha and Omega Semiconductor | SMAJ6.0A | Diode_SMD:D_SMA | 资料核对候选 | 候选规格/引脚核对；装配工艺、实际负载与供货仍需确认。 | 候选已指定 | 候选已指定 | https://www.aosmd.com/sites/default/files/res/datasheets/SMAJ6.0A.pdf https://www.aosmd.com/sites/default/files/res/packaging_information/DO-214AC.pdf
F501 | USB 输入 | MF-MSMF110/16X-2 | 1 | 否 | Bourns | MF-MSMF110/16X-2 | ESPaperPlay:Bourns_MF-MSMF_1812_Style2 | 需专项闭合 | 50°C保持0.85A，低于可编程输入限流约0.917–1.072A；需热/输入电流预算。 | 候选已指定 | 候选已指定 | https://www.bourns.com/docs/product-datasheets/mf-msmf.pdf?sfvrsn=4a75e5c0_69
J501 | USB 输入 | USB-C USB2 16P | 1 | 否 | Global Connector Technology (GCT) | USB4105-GF-A | Connector_USB:USB_C_Receptacle_GCT_USB4105-xx-A_16P_TopMnt_Horizontal | 需专项闭合 | GCT USB4105-GF-A候选，板厚、外壳空间及焊接工艺待机械确认。 | 候选已指定 | 候选已指定 | https://gct.co/connector/usb4105
J502 | USB 输入 | ONE SHUNT: USB / BENCH | 1 | 否 | Würth Elektronik | 61300311121 | ESPaperPlay:WR_PHD_1x03_P2.54_Drill1.10 | 资料核对候选 | 针座/线束/短路帽适配及额定待确认；DNP状态按原理图执行。 | 候选已指定 | 候选已指定 | https://www.we-online.com/components/products/datasheet/61300311121.pdf
R501 | USB 输入 | 5.1k 1% | 1 | 否 | Vishay | CRCW06035K10FKEA | Resistor_SMD:R_0603_1608Metric | 资料核对候选 | 候选规格/引脚核对；装配工艺、实际负载与供货仍需确认。 | 候选已指定 | 候选已指定 | https://www.vishay.com/docs/20035/dcrcwe3.pdf
R502 | USB 输入 | 5.1k 1% | 1 | 否 | Vishay | CRCW06035K10FKEA | Resistor_SMD:R_0603_1608Metric | 资料核对候选 | 候选规格/引脚核对；装配工艺、实际负载与供货仍需确认。 | 候选已指定 | 候选已指定 | https://www.vishay.com/docs/20035/dcrcwe3.pdf
R503 | USB 输入 | 22R | 1 | 否 | Vishay | CRCW060322R0FKEA | Resistor_SMD:R_0603_1608Metric | 资料核对候选 | 候选规格/引脚核对；装配工艺、实际负载与供货仍需确认。 | 候选已指定 | 候选已指定 | https://www.vishay.com/docs/20035/dcrcwe3.pdf
R504 | USB 输入 | 22R | 1 | 否 | Vishay | CRCW060322R0FKEA | Resistor_SMD:R_0603_1608Metric | 资料核对候选 | 候选规格/引脚核对；装配工艺、实际负载与供货仍需确认。 | 候选已指定 | 候选已指定 | https://www.vishay.com/docs/20035/dcrcwe3.pdf
U501 | USB 输入 | TI TPD2E2U06DCKR | 1 | 否 | Texas Instruments | TPD2E2U06DCKR | ESPaperPlay:TI_DCK0003A_SC70_3_Recommended | 资料核对候选 | 候选规格/引脚核对；装配工艺、实际负载与供货仍需确认。 | 候选已指定 | 候选已指定 | https://www.ti.com/product/TPD2E2U06/part-details/TPD2E2U06DCKR
U502 | USB 输入 | TI TPD2E2U06DCKR | 1 | 否 | Texas Instruments | TPD2E2U06DCKR | ESPaperPlay:TI_DCK0003A_SC70_3_Recommended | 资料核对候选 | 候选规格/引脚核对；装配工艺、实际负载与供货仍需确认。 | 候选已指定 | 候选已指定 | https://www.ti.com/product/TPD2E2U06/part-details/TPD2E2U06DCKR
C401 | 电源域 | 1u / 10V | 1 | 否 |  |  | Capacitor_SMD:C_0603_1608Metric | 需专项闭合 | 准确料号/工作偏压有效容量及容差、温度、老化待闭合。 | 候选已指定 | 未指定 | https://www.ti.com/lit/ds/symlink/tps22918.pdf
C402 | 电源域 | 4.7n / 25V | 1 | 否 |  |  | Capacitor_SMD:C_0603_1608Metric | 需专项闭合 | 准确料号/工作偏压有效容量及容差、温度、老化待闭合。 | 候选已指定 | 未指定 | https://www.ti.com/lit/ds/symlink/tps22918.pdf
C403 | 电源域 | 22u / 10V | 1 | 否 |  |  | Capacitor_SMD:C_1206_3216Metric | 需专项闭合 | 准确料号/工作偏压有效容量及容差、温度、老化待闭合。 | 候选已指定 | 未指定 | https://www.ti.com/lit/ds/symlink/tps22918.pdf
C404 | 电源域 | 1u / 10V | 1 | 否 |  |  | Capacitor_SMD:C_0603_1608Metric | 需专项闭合 | 准确料号/工作偏压有效容量及容差、温度、老化待闭合。 | 候选已指定 | 未指定 | https://www.ti.com/lit/ds/symlink/tps22918.pdf
C405 | 电源域 | 4.7n / 25V | 1 | 否 |  |  | Capacitor_SMD:C_0603_1608Metric | 需专项闭合 | 准确料号/工作偏压有效容量及容差、温度、老化待闭合。 | 候选已指定 | 未指定 | https://www.ti.com/lit/ds/symlink/tps22918.pdf
C406 | 电源域 | 22u / 10V | 1 | 否 |  |  | Capacitor_SMD:C_1206_3216Metric | 需专项闭合 | 准确料号/工作偏压有效容量及容差、温度、老化待闭合。 | 候选已指定 | 未指定 | https://www.ti.com/lit/ds/symlink/tps22918.pdf
C407 | 电源域 | 1u / 10V | 1 | 否 |  |  | Capacitor_SMD:C_0603_1608Metric | 需专项闭合 | 准确料号/工作偏压有效容量及容差、温度、老化待闭合。 | 候选已指定 | 未指定 | https://www.ti.com/lit/ds/symlink/tps22918.pdf
C408 | 电源域 | 4.7n / 25V | 1 | 否 |  |  | Capacitor_SMD:C_0603_1608Metric | 需专项闭合 | 准确料号/工作偏压有效容量及容差、温度、老化待闭合。 | 候选已指定 | 未指定 | https://www.ti.com/lit/ds/symlink/tps22918.pdf
C409 | 电源域 | 4.7u / 10V | 1 | 否 |  |  | Capacitor_SMD:C_0805_2012Metric | 需专项闭合 | 准确料号/工作偏压有效容量及容差、温度、老化待闭合。 | 候选已指定 | 未指定 | https://www.ti.com/lit/ds/symlink/tps22918.pdf
C410 | 电源域 | 1u / 10V | 1 | 否 |  |  | Capacitor_SMD:C_0603_1608Metric | 需专项闭合 | 准确料号/工作偏压有效容量及容差、温度、老化待闭合。 | 候选已指定 | 未指定 | https://www.ti.com/lit/ds/symlink/tps22918.pdf
C411 | 电源域 | 4.7n / 25V | 1 | 否 |  |  | Capacitor_SMD:C_0603_1608Metric | 需专项闭合 | 准确料号/工作偏压有效容量及容差、温度、老化待闭合。 | 候选已指定 | 未指定 | https://www.ti.com/lit/ds/symlink/tps22918.pdf
C412 | 电源域 | 1u / 10V | 1 | 否 |  |  | Capacitor_SMD:C_0603_1608Metric | 需专项闭合 | 准确料号/工作偏压有效容量及容差、温度、老化待闭合。 | 候选已指定 | 未指定 | https://www.ti.com/lit/ds/symlink/tps22918.pdf
C413 | 电源域 | 1u / 10V | 1 | 否 |  |  | Capacitor_SMD:C_0603_1608Metric | 需专项闭合 | 准确料号/工作偏压有效容量及容差、温度、老化待闭合。 | 候选已指定 | 未指定 | https://www.ti.com/lit/ds/symlink/tps22918.pdf
C414 | 电源域 | 4.7n / 25V | 1 | 否 |  |  | Capacitor_SMD:C_0603_1608Metric | 需专项闭合 | 准确料号/工作偏压有效容量及容差、温度、老化待闭合。 | 候选已指定 | 未指定 | https://www.ti.com/lit/ds/symlink/tps22918.pdf
C415 | 电源域 | 22u / 10V | 1 | 否 |  |  | Capacitor_SMD:C_1206_3216Metric | 需专项闭合 | 准确料号/工作偏压有效容量及容差、温度、老化待闭合。 | 候选已指定 | 未指定 | https://www.ti.com/lit/ds/symlink/tps22918.pdf
J401 | 电源域 | EPD_PWR | 1 | 否 | Würth Elektronik | 61300211121 | ESPaperPlay:WR_PHD_1x02_P2.54_Drill1.10 | 资料核对候选 | 针座/线束/短路帽适配及额定待确认；DNP状态按原理图执行。 | 候选已指定 | 候选已指定 | https://www.we-online.com/components/products/datasheet/61300211121.pdf
J402 | 电源域 | SD_PWR | 1 | 否 | Würth Elektronik | 61300211121 | ESPaperPlay:WR_PHD_1x02_P2.54_Drill1.10 | 资料核对候选 | 针座/线束/短路帽适配及额定待确认；DNP状态按原理图执行。 | 候选已指定 | 候选已指定 | https://www.we-online.com/components/products/datasheet/61300211121.pdf
J403 | 电源域 | TOUCH_PWR | 1 | 否 | Würth Elektronik | 61300211121 | ESPaperPlay:WR_PHD_1x02_P2.54_Drill1.10 | 资料核对候选 | 针座/线束/短路帽适配及额定待确认；DNP状态按原理图执行。 | 候选已指定 | 候选已指定 | https://www.we-online.com/components/products/datasheet/61300211121.pdf
J404 | 电源域 | MIC_PWR | 1 | 否 | Würth Elektronik | 61300211121 | ESPaperPlay:WR_PHD_1x02_P2.54_Drill1.10 | 资料核对候选 | 针座/线束/短路帽适配及额定待确认；DNP状态按原理图执行。 | 候选已指定 | 候选已指定 | https://www.we-online.com/components/products/datasheet/61300211121.pdf
J405 | 电源域 | AMP_PWR | 1 | 否 | Würth Elektronik | 61300211121 | ESPaperPlay:WR_PHD_1x02_P2.54_Drill1.10 | 资料核对候选 | 针座/线束/短路帽适配及额定待确认；DNP状态按原理图执行。 | 候选已指定 | 候选已指定 | https://www.we-online.com/components/products/datasheet/61300211121.pdf
R401 | 电源域 | 330R / 1% | 1 | 否 | Vishay | CRCW0603330RFKEA | Resistor_SMD:R_0603_1608Metric | 资料核对候选 | QOD 330Ω/0.1W候选；按实际轨电压、电容能量、重复放电和温度校核脉冲。 | 候选已指定 | 候选已指定 | https://www.vishay.com/docs/20035/dcrcwe3.pdf https://www.ti.com/lit/ds/symlink/tps22918.pdf
R402 | 电源域 | 0R / I_EPD | 1 | 否 | Bourns | CRF0805-J/-000ELF | ESPaperPlay:Bourns_CRF0805_Jumper | 资料核对候选 | 候选规格/引脚核对；装配工艺、实际负载与供货仍需确认。 | 候选已指定 | 候选已指定 | https://www.bourns.com/docs/product-datasheets/crf-j.pdf?sfvrsn=da3727f6_4
R404 | 电源域 | 330R / 1% | 1 | 否 | Vishay | CRCW0603330RFKEA | Resistor_SMD:R_0603_1608Metric | 资料核对候选 | QOD 330Ω/0.1W候选；按实际轨电压、电容能量、重复放电和温度校核脉冲。 | 候选已指定 | 候选已指定 | https://www.vishay.com/docs/20035/dcrcwe3.pdf https://www.ti.com/lit/ds/symlink/tps22918.pdf
R405 | 电源域 | 0R / I_SD | 1 | 否 | Bourns | CRF0805-J/-000ELF | ESPaperPlay:Bourns_CRF0805_Jumper | 资料核对候选 | 候选规格/引脚核对；装配工艺、实际负载与供货仍需确认。 | 候选已指定 | 候选已指定 | https://www.bourns.com/docs/product-datasheets/crf-j.pdf?sfvrsn=da3727f6_4
R407 | 电源域 | 330R / 1% | 1 | 否 | Vishay | CRCW0603330RFKEA | Resistor_SMD:R_0603_1608Metric | 资料核对候选 | QOD 330Ω/0.1W候选；按实际轨电压、电容能量、重复放电和温度校核脉冲。 | 候选已指定 | 候选已指定 | https://www.vishay.com/docs/20035/dcrcwe3.pdf https://www.ti.com/lit/ds/symlink/tps22918.pdf
R408 | 电源域 | 0R / I_TOUCH | 1 | 否 | Bourns | CRF0805-J/-000ELF | ESPaperPlay:Bourns_CRF0805_Jumper | 资料核对候选 | 候选规格/引脚核对；装配工艺、实际负载与供货仍需确认。 | 候选已指定 | 候选已指定 | https://www.bourns.com/docs/product-datasheets/crf-j.pdf?sfvrsn=da3727f6_4
R410 | 电源域 | 330R / 1% | 1 | 否 | Vishay | CRCW0603330RFKEA | Resistor_SMD:R_0603_1608Metric | 资料核对候选 | QOD 330Ω/0.1W候选；按实际轨电压、电容能量、重复放电和温度校核脉冲。 | 候选已指定 | 候选已指定 | https://www.vishay.com/docs/20035/dcrcwe3.pdf https://www.ti.com/lit/ds/symlink/tps22918.pdf
R411 | 电源域 | 0R / I_MIC | 1 | 否 | Bourns | CRF0805-J/-000ELF | ESPaperPlay:Bourns_CRF0805_Jumper | 资料核对候选 | 候选规格/引脚核对；装配工艺、实际负载与供货仍需确认。 | 候选已指定 | 候选已指定 | https://www.bourns.com/docs/product-datasheets/crf-j.pdf?sfvrsn=da3727f6_4
R413 | 电源域 | 330R / 1% | 1 | 否 | Vishay | CRCW0603330RFKEA | Resistor_SMD:R_0603_1608Metric | 资料核对候选 | QOD 330Ω/0.1W候选；按实际轨电压、电容能量、重复放电和温度校核脉冲。 | 候选已指定 | 候选已指定 | https://www.vishay.com/docs/20035/dcrcwe3.pdf https://www.ti.com/lit/ds/symlink/tps22918.pdf
R414 | 电源域 | 0R / I_AMP | 1 | 否 | Bourns | CRF0805-J/-000ELF | ESPaperPlay:Bourns_CRF0805_Jumper | 资料核对候选 | 候选规格/引脚核对；装配工艺、实际负载与供货仍需确认。 | 候选已指定 | 候选已指定 | https://www.bourns.com/docs/product-datasheets/crf-j.pdf?sfvrsn=da3727f6_4
R416 | 电源域 | 10k | 1 | 否 | Vishay | CRCW060310K0FKEA | Resistor_SMD:R_0603_1608Metric | 资料核对候选 | 候选规格/引脚核对；装配工艺、实际负载与供货仍需确认。 | 候选已指定 | 候选已指定 | https://www.vishay.com/docs/20035/dcrcwe3.pdf
U401 | 电源域 | TPS22918DBV | 1 | 否 | Texas Instruments | TPS22918DBVR | Package_TO_SOT_SMD:SOT-23-6 | 资料核对候选 | 候选规格/引脚核对；装配工艺、实际负载与供货仍需确认。 | 候选已指定 | 候选已指定 | https://www.ti.com/lit/ds/symlink/tps22918.pdf
U402 | 电源域 | TPS22918DBV | 1 | 否 | Texas Instruments | TPS22918DBVR | Package_TO_SOT_SMD:SOT-23-6 | 资料核对候选 | 候选规格/引脚核对；装配工艺、实际负载与供货仍需确认。 | 候选已指定 | 候选已指定 | https://www.ti.com/lit/ds/symlink/tps22918.pdf
U403 | 电源域 | TPS22918DBV | 1 | 否 | Texas Instruments | TPS22918DBVR | Package_TO_SOT_SMD:SOT-23-6 | 资料核对候选 | 候选规格/引脚核对；装配工艺、实际负载与供货仍需确认。 | 候选已指定 | 候选已指定 | https://www.ti.com/lit/ds/symlink/tps22918.pdf
U404 | 电源域 | TPS22918DBV | 1 | 否 | Texas Instruments | TPS22918DBVR | Package_TO_SOT_SMD:SOT-23-6 | 资料核对候选 | 候选规格/引脚核对；装配工艺、实际负载与供货仍需确认。 | 候选已指定 | 候选已指定 | https://www.ti.com/lit/ds/symlink/tps22918.pdf
U405 | 电源域 | TPS22918DBV | 1 | 否 | Texas Instruments | TPS22918DBVR | Package_TO_SOT_SMD:SOT-23-6 | 资料核对候选 | 候选规格/引脚核对；装配工艺、实际负载与供货仍需确认。 | 候选已指定 | 候选已指定 | https://www.ti.com/lit/ds/symlink/tps22918.pdf
C416 | 触摸隔离 | 100n / 10V | 1 | 否 | TDK | C1608X7R1H104K080AA | Capacitor_SMD:C_0603_1608Metric | 资料核对候选 | 原厂在产候选；成本/供货与贴装工艺待确认。 | 候选已指定 | 候选已指定 | https://product.tdk.com/en/search/capacitor/ceramic/mlcc/info?part_no=C1608X7R1H104K080AA
C417 | 触摸隔离 | 100n / 10V | 1 | 否 | TDK | C1608X7R1H104K080AA | Capacitor_SMD:C_0603_1608Metric | 资料核对候选 | 原厂在产候选；成本/供货与贴装工艺待确认。 | 候选已指定 | 候选已指定 | https://product.tdk.com/en/search/capacitor/ceramic/mlcc/info?part_no=C1608X7R1H104K080AA
J406 | 触摸隔离 | GT911_FUNCTIONAL_6PIN | 1 | 否 |  |  |  | 需专项闭合 | 触摸FPC接触面、插入长度、旧型号原厂机械图待核。 | 未指定 | 未指定 | https://www.good-display.cn/blank7.html?productId=477 https://www.hirose.com/en/product/p/CL0586-0582-5-55
R417 | 触摸隔离 | 10k | 1 | 否 | Vishay | CRCW060310K0FKEA | Resistor_SMD:R_0603_1608Metric | 资料核对候选 | 候选规格/引脚核对；装配工艺、实际负载与供货仍需确认。 | 候选已指定 | 候选已指定 | https://www.vishay.com/docs/20035/dcrcwe3.pdf
R418 | 触摸隔离 | 10k | 1 | 否 | Vishay | CRCW060310K0FKEA | Resistor_SMD:R_0603_1608Metric | 资料核对候选 | 候选规格/引脚核对；装配工艺、实际负载与供货仍需确认。 | 候选已指定 | 候选已指定 | https://www.vishay.com/docs/20035/dcrcwe3.pdf
R419 | 触摸隔离 | 100k | 1 | 否 | Vishay | CRCW0603100KFKEA | Resistor_SMD:R_0603_1608Metric | 资料核对候选 | 候选规格/引脚核对；装配工艺、实际负载与供货仍需确认。 | 候选已指定 | 候选已指定 | https://www.vishay.com/docs/20035/dcrcwe3.pdf
R420 | 触摸隔离 | 100k | 1 | 否 | Vishay | CRCW0603100KFKEA | Resistor_SMD:R_0603_1608Metric | 资料核对候选 | 候选规格/引脚核对；装配工艺、实际负载与供货仍需确认。 | 候选已指定 | 候选已指定 | https://www.vishay.com/docs/20035/dcrcwe3.pdf
U406 | 触摸隔离 | TMUX1511PW | 1 | 否 | Texas Instruments | TMUX1511PWR | Package_SO:TSSOP-14_4.4x5mm_P0.65mm | 资料核对候选 | 候选规格/引脚核对；装配工艺、实际负载与供货仍需确认。 | 候选已指定 | 候选已指定 | https://www.ti.com/product/TMUX1511/part-details/TMUX1511PWR
C601 | 电子纸驱动 | 4.7u / 50V | 1 | 否 | Murata | GRM31CR71H475KA12L | Capacitor_SMD:C_1206_3216Metric | 需专项闭合 | 准确料号/工作偏压有效容量及容差、温度、老化待闭合。 | 候选已指定 | 候选已指定 | https://www.murata.com/en-eu/api/pdfdownloadapi?cate=luCeramicCapacitorsSMD&partno=GRM31CR71H475KA12L
C602 | 电子纸驱动 | 4.7u / 50V | 1 | 否 | Murata | GRM31CR71H475KA12L | Capacitor_SMD:C_1206_3216Metric | 需专项闭合 | 准确料号/工作偏压有效容量及容差、温度、老化待闭合。 | 候选已指定 | 候选已指定 | https://www.murata.com/en-eu/api/pdfdownloadapi?cate=luCeramicCapacitorsSMD&partno=GRM31CR71H475KA12L
C603 | 电子纸驱动 | 4.7u / 25V | 1 | 否 |  |  | Capacitor_SMD:C_0805_2012Metric | 需专项闭合 | 准确料号/工作偏压有效容量及容差、温度、老化待闭合。 | 候选已指定 | 未指定
C604 | 电子纸驱动 | 4.7u / 50V | 1 | 否 | Murata | GRM31CR71H475KA12L | Capacitor_SMD:C_1206_3216Metric | 需专项闭合 | 准确料号/工作偏压有效容量及容差、温度、老化待闭合。 | 候选已指定 | 候选已指定 | https://www.murata.com/en-eu/api/pdfdownloadapi?cate=luCeramicCapacitorsSMD&partno=GRM31CR71H475KA12L
C605 | 电子纸驱动 | 1u / 25V | 1 | 否 |  |  | Capacitor_SMD:C_0805_2012Metric | 需专项闭合 | 准确料号/工作偏压有效容量及容差、温度、老化待闭合。 | 候选已指定 | 未指定
C606 | 电子纸驱动 | 1u / 25V | 1 | 否 |  |  | Capacitor_SMD:C_0805_2012Metric | 需专项闭合 | 准确料号/工作偏压有效容量及容差、温度、老化待闭合。 | 候选已指定 | 未指定
C607 | 电子纸驱动 | 4.7u / 50V | 1 | 否 | Murata | GRM31CR71H475KA12L | Capacitor_SMD:C_1206_3216Metric | 需专项闭合 | 准确料号/工作偏压有效容量及容差、温度、老化待闭合。 | 候选已指定 | 候选已指定 | https://www.murata.com/en-eu/api/pdfdownloadapi?cate=luCeramicCapacitorsSMD&partno=GRM31CR71H475KA12L
C608 | 电子纸驱动 | 4.7u / 50V | 1 | 否 | Murata | GRM31CR71H475KA12L | Capacitor_SMD:C_1206_3216Metric | 需专项闭合 | 准确料号/工作偏压有效容量及容差、温度、老化待闭合。 | 候选已指定 | 候选已指定 | https://www.murata.com/en-eu/api/pdfdownloadapi?cate=luCeramicCapacitorsSMD&partno=GRM31CR71H475KA12L
C609 | 电子纸驱动 | 4.7u / 50V | 1 | 否 | Murata | GRM31CR71H475KA12L | Capacitor_SMD:C_1206_3216Metric | 需专项闭合 | 准确料号/工作偏压有效容量及容差、温度、老化待闭合。 | 候选已指定 | 候选已指定 | https://www.murata.com/en-eu/api/pdfdownloadapi?cate=luCeramicCapacitorsSMD&partno=GRM31CR71H475KA12L
C610 | 电子纸驱动 | 1u / 50V | 1 | 否 |  |  | Capacitor_SMD:C_0805_2012Metric | 需专项闭合 | 准确料号/工作偏压有效容量及容差、温度、老化待闭合。 | 候选已指定 | 未指定
C611 | 电子纸驱动 | 100n / 10V | 1 | 否 | TDK | C1608X7R1H104K080AA | Capacitor_SMD:C_0603_1608Metric | 资料核对候选 | 原厂在产候选；成本/供货与贴装工艺待确认。 | 候选已指定 | 候选已指定 | https://product.tdk.com/en/search/capacitor/ceramic/mlcc/info?part_no=C1608X7R1H104K080AA
C612 | 电子纸驱动 | 100n / 10V | 1 | 否 | TDK | C1608X7R1H104K080AA | Capacitor_SMD:C_0603_1608Metric | 资料核对候选 | 原厂在产候选；成本/供货与贴装工艺待确认。 | 候选已指定 | 候选已指定 | https://product.tdk.com/en/search/capacitor/ceramic/mlcc/info?part_no=C1608X7R1H104K080AA
D601 | 电子纸驱动 | onsemi MBR0530T1G | 1 | 否 | onsemi | MBR0530T1G | Diode_SMD:D_SOD-123 | 资料核对候选 | 候选规格/引脚核对；装配工艺、实际负载与供货仍需确认。 | 候选已指定 | 候选已指定 | https://www.onsemi.com/download/data-sheet/pdf/mbr0530t1-d.pdf https://www.onsemi.com/products/discrete-power-modules/schottky-diodes-schottky-rectifiers/mbr0530 https://www.onsemi.com/products/discrete-power-modules/schottky-diodes-schottky-rectifiers/mbr0530t1g
D602 | 电子纸驱动 | onsemi MBR0530T1G | 1 | 否 | onsemi | MBR0530T1G | Diode_SMD:D_SOD-123 | 资料核对候选 | 候选规格/引脚核对；装配工艺、实际负载与供货仍需确认。 | 候选已指定 | 候选已指定 | https://www.onsemi.com/download/data-sheet/pdf/mbr0530t1-d.pdf https://www.onsemi.com/products/discrete-power-modules/schottky-diodes-schottky-rectifiers/mbr0530 https://www.onsemi.com/products/discrete-power-modules/schottky-diodes-schottky-rectifiers/mbr0530t1g
D603 | 电子纸驱动 | onsemi MBR0530T1G | 1 | 否 | onsemi | MBR0530T1G | Diode_SMD:D_SOD-123 | 资料核对候选 | 候选规格/引脚核对；装配工艺、实际负载与供货仍需确认。 | 候选已指定 | 候选已指定 | https://www.onsemi.com/download/data-sheet/pdf/mbr0530t1-d.pdf https://www.onsemi.com/products/discrete-power-modules/schottky-diodes-schottky-rectifiers/mbr0530 https://www.onsemi.com/products/discrete-power-modules/schottky-diodes-schottky-rectifiers/mbr0530t1g
J601 | 电子纸驱动 | EPD FPC 24 x 0.5mm | 1 | 否 |  |  |  | 需专项闭合 | 屏幕FPC接触面、插入长度/加强板与插座适配待核。 | 未指定 | 未指定 | https://www.good-display.cn/blank7.html?productId=477 https://www.hirose.com/product/p/CL0586-0521-0-55 https://www.hirose.com/product/document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
L601 | 电子纸驱动 | 10uH / >=1A target | 1 | 否 | Bourns | SRN4018-100M | Inductor_SMD:L_Bourns-SRN4018 | 需专项闭合 | 10uH/Irms1.3A/Isat1.4A候选；需刷新/启动峰值和温升验证。 | 候选已指定 | 候选已指定 | https://www.bourns.com/docs/product-datasheets/srn4018.pdf
Q601 | 电子纸驱动 | Vishay Si1308EDL-T1-GE3 | 1 | 否 | Vishay Siliconix | Si1308EDL-T1-GE3 | Package_TO_SOT_SMD:SOT-323_SC-70 | 需专项闭合 | 标准SC70焊盘宽0.45mm小于Vishay示例最小0.559mm；贴装前需决定专用焊盘。 | 候选已指定 | 候选已指定 | https://www.vishay.com/docs/63399/si1308edl.pdf https://www.vishay.com/docs/72601/landpatternsc-70-3lead.pdf https://www.vishay.com/en/product/63399/
R601 | 电子纸驱动 | 1M / 1% | 1 | 否 | Vishay | CRCW06031M00FKEA | Resistor_SMD:R_0603_1608Metric | 资料核对候选 | 候选规格/引脚核对；装配工艺、实际负载与供货仍需确认。 | 候选已指定 | 候选已指定 | https://www.vishay.com/docs/20035/dcrcwe3.pdf
R602 | 电子纸驱动 | 0.47R / 1% | 1 | 否 |  |  |  | 需专项闭合 | 0.47Ω采样电阻需峰值/RMS/占空比与脉冲功率证据后选择封装。 | 未指定 | 未指定
R603 | 电子纸驱动 | 33R | 1 | 否 | Vishay | CRCW060333R0FKEA | Resistor_SMD:R_0603_1608Metric | 资料核对候选 | 候选规格/引脚核对；装配工艺、实际负载与供货仍需确认。 | 候选已指定 | 候选已指定 | https://www.vishay.com/docs/20035/dcrcwe3.pdf
R604 | 电子纸驱动 | 33R | 1 | 否 | Vishay | CRCW060333R0FKEA | Resistor_SMD:R_0603_1608Metric | 资料核对候选 | 候选规格/引脚核对；装配工艺、实际负载与供货仍需确认。 | 候选已指定 | 候选已指定 | https://www.vishay.com/docs/20035/dcrcwe3.pdf
R605 | 电子纸驱动 | 33R | 1 | 否 | Vishay | CRCW060333R0FKEA | Resistor_SMD:R_0603_1608Metric | 资料核对候选 | 候选规格/引脚核对；装配工艺、实际负载与供货仍需确认。 | 候选已指定 | 候选已指定 | https://www.vishay.com/docs/20035/dcrcwe3.pdf
R606 | 电子纸驱动 | 33R | 1 | 否 | Vishay | CRCW060333R0FKEA | Resistor_SMD:R_0603_1608Metric | 资料核对候选 | 候选规格/引脚核对；装配工艺、实际负载与供货仍需确认。 | 候选已指定 | 候选已指定 | https://www.vishay.com/docs/20035/dcrcwe3.pdf
R607 | 电子纸驱动 | 33R | 1 | 否 | Vishay | CRCW060333R0FKEA | Resistor_SMD:R_0603_1608Metric | 资料核对候选 | 候选规格/引脚核对；装配工艺、实际负载与供货仍需确认。 | 候选已指定 | 候选已指定 | https://www.vishay.com/docs/20035/dcrcwe3.pdf
R608 | 电子纸驱动 | 100k | 1 | 否 | Vishay | CRCW0603100KFKEA | Resistor_SMD:R_0603_1608Metric | 资料核对候选 | 候选规格/引脚核对；装配工艺、实际负载与供货仍需确认。 | 候选已指定 | 候选已指定 | https://www.vishay.com/docs/20035/dcrcwe3.pdf
R609 | 电子纸驱动 | 100k | 1 | 否 | Vishay | CRCW0603100KFKEA | Resistor_SMD:R_0603_1608Metric | 资料核对候选 | 候选规格/引脚核对；装配工艺、实际负载与供货仍需确认。 | 候选已指定 | 候选已指定 | https://www.vishay.com/docs/20035/dcrcwe3.pdf
R610 | 电子纸驱动 | 100k | 1 | 否 | Vishay | CRCW0603100KFKEA | Resistor_SMD:R_0603_1608Metric | 资料核对候选 | 候选规格/引脚核对；装配工艺、实际负载与供货仍需确认。 | 候选已指定 | 候选已指定 | https://www.vishay.com/docs/20035/dcrcwe3.pdf
R611 | 电子纸驱动 | 100k | 1 | 否 | Vishay | CRCW0603100KFKEA | Resistor_SMD:R_0603_1608Metric | 资料核对候选 | 候选规格/引脚核对；装配工艺、实际负载与供货仍需确认。 | 候选已指定 | 候选已指定 | https://www.vishay.com/docs/20035/dcrcwe3.pdf
R612 | 电子纸驱动 | 100k | 1 | 否 | Vishay | CRCW0603100KFKEA | Resistor_SMD:R_0603_1608Metric | 资料核对候选 | 候选规格/引脚核对；装配工艺、实际负载与供货仍需确认。 | 候选已指定 | 候选已指定 | https://www.vishay.com/docs/20035/dcrcwe3.pdf
R613 | 电子纸驱动 | 100k | 1 | 否 | Vishay | CRCW0603100KFKEA | Resistor_SMD:R_0603_1608Metric | 资料核对候选 | 候选规格/引脚核对；装配工艺、实际负载与供货仍需确认。 | 候选已指定 | 候选已指定 | https://www.vishay.com/docs/20035/dcrcwe3.pdf
R614 | 电子纸驱动 | 100k | 1 | 否 | Vishay | CRCW0603100KFKEA | Resistor_SMD:R_0603_1608Metric | 资料核对候选 | 候选规格/引脚核对；装配工艺、实际负载与供货仍需确认。 | 候选已指定 | 候选已指定 | https://www.vishay.com/docs/20035/dcrcwe3.pdf
U601 | 电子纸驱动 | TI SN74LVC541APWR | 1 | 否 | Texas Instruments | SN74LVC541APWR | Package_SO:TSSOP-20_4.4x6.5mm_P0.65mm | 资料核对候选 | 候选规格/引脚核对；装配工艺、实际负载与供货仍需确认。 | 候选已指定 | 候选已指定 | https://www.ti.com/lit/ds/symlink/sn74lvc541a.pdf https://www.ti.com/product/SN74LVC541A
U602 | 电子纸驱动 | TI SN74LVC1G125DBVR | 1 | 否 | Texas Instruments | SN74LVC1G125DBVR | Package_TO_SOT_SMD:SOT-23-5 | 资料核对候选 | 候选规格/引脚核对；装配工艺、实际负载与供货仍需确认。 | 候选已指定 | 候选已指定 | https://www.ti.com/lit/ds/symlink/sn74lvc1g125.pdf https://www.ti.com/product/SN74LVC1G125
C701 | 存储卡 | 100n / 10V | 1 | 否 | TDK | C1608X7R1H104K080AA | Capacitor_SMD:C_0603_1608Metric | 资料核对候选 | 原厂在产候选；成本/供货与贴装工艺待确认。 | 候选已指定 | 候选已指定 | https://product.tdk.com/en/search/capacitor/ceramic/mlcc/info?part_no=C1608X7R1H104K080AA
C702 | 存储卡 | 10u / 10V | 1 | 否 |  |  | Capacitor_SMD:C_0805_2012Metric | 需专项闭合 | 准确料号/工作偏压有效容量及容差、温度、老化待闭合。 | 候选已指定 | 未指定
C703 | 存储卡 | 100n / 10V | 1 | 否 | TDK | C1608X7R1H104K080AA | Capacitor_SMD:C_0603_1608Metric | 资料核对候选 | 原厂在产候选；成本/供货与贴装工艺待确认。 | 候选已指定 | 候选已指定 | https://product.tdk.com/en/search/capacitor/ceramic/mlcc/info?part_no=C1608X7R1H104K080AA
C704 | 存储卡 | 10n / 10V | 1 | 否 |  |  | Capacitor_SMD:C_0603_1608Metric | 需专项闭合 | 准确料号/工作偏压有效容量及容差、温度、老化待闭合。 | 候选已指定 | 未指定
C705 | 存储卡 | 100n / 10V | 1 | 否 | TDK | C1608X7R1H104K080AA | Capacitor_SMD:C_0603_1608Metric | 资料核对候选 | 原厂在产候选；成本/供货与贴装工艺待确认。 | 候选已指定 | 候选已指定 | https://product.tdk.com/en/search/capacitor/ceramic/mlcc/info?part_no=C1608X7R1H104K080AA
J701 | 存储卡 | Hirose DM3AT-SF-PEJM5 | 1 | 否 | Hirose Electric | DM3AT-SF-PEJM5 | Connector_Card:microSD_HC_Hirose_DM3AT-SF-PEJM5 | 需专项闭合 | DM3AT为push-push；原厂A/B检测触点位置、金属壳及卡退出空间尚待机械图/样品核对。 | 候选已指定 | 候选已指定 | https://www.hirose.com/en/product/p/CL0609-0031-0-00 https://www.hirose.com/product/download/?distributor=chip1&lang=en&num=DM3AT-SF-PEJM5&type=2d https://www.hirose.com/en/product/document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 https://support.hirose.com/en/support/solutions/articles/68000029780-what-is-the-difference-between-dm3at-sf-pejm5-and-dm3at-sf-pejm5-40-
R701 | 存储卡 | 10k / 1% | 1 | 否 | Vishay | CRCW060310K0FKEA | Resistor_SMD:R_0603_1608Metric | 资料核对候选 | 候选规格/引脚核对；装配工艺、实际负载与供货仍需确认。 | 候选已指定 | 候选已指定 | https://www.vishay.com/docs/20035/dcrcwe3.pdf
R702 | 存储卡 | 10k / 1% | 1 | 否 | Vishay | CRCW060310K0FKEA | Resistor_SMD:R_0603_1608Metric | 资料核对候选 | 候选规格/引脚核对；装配工艺、实际负载与供货仍需确认。 | 候选已指定 | 候选已指定 | https://www.vishay.com/docs/20035/dcrcwe3.pdf
R703 | 存储卡 | 10k / 1% | 1 | 否 | Vishay | CRCW060310K0FKEA | Resistor_SMD:R_0603_1608Metric | 资料核对候选 | 候选规格/引脚核对；装配工艺、实际负载与供货仍需确认。 | 候选已指定 | 候选已指定 | https://www.vishay.com/docs/20035/dcrcwe3.pdf
R704 | 存储卡 | 10k / 1% | 1 | 否 | Vishay | CRCW060310K0FKEA | Resistor_SMD:R_0603_1608Metric | 资料核对候选 | 候选规格/引脚核对；装配工艺、实际负载与供货仍需确认。 | 候选已指定 | 候选已指定 | https://www.vishay.com/docs/20035/dcrcwe3.pdf
R705 | 存储卡 | 10k / 1% | 1 | 否 | Vishay | CRCW060310K0FKEA | Resistor_SMD:R_0603_1608Metric | 资料核对候选 | 候选规格/引脚核对；装配工艺、实际负载与供货仍需确认。 | 候选已指定 | 候选已指定 | https://www.vishay.com/docs/20035/dcrcwe3.pdf
R706 | 存储卡 | 100k | 1 | 否 | Vishay | CRCW0603100KFKEA | Resistor_SMD:R_0603_1608Metric | 资料核对候选 | 候选规格/引脚核对；装配工艺、实际负载与供货仍需确认。 | 候选已指定 | 候选已指定 | https://www.vishay.com/docs/20035/dcrcwe3.pdf
R708 | 存储卡 | 100R | 1 | 否 | Vishay | CRCW0603100RFKEA | Resistor_SMD:R_0603_1608Metric | 资料核对候选 | 候选规格/引脚核对；装配工艺、实际负载与供货仍需确认。 | 候选已指定 | 候选已指定 | https://www.vishay.com/docs/20035/dcrcwe3.pdf
R710 | 存储卡 | 22R | 1 | 否 | Vishay | CRCW060322R0FKEA | Resistor_SMD:R_0603_1608Metric | 资料核对候选 | 候选规格/引脚核对；装配工艺、实际负载与供货仍需确认。 | 候选已指定 | 候选已指定 | https://www.vishay.com/docs/20035/dcrcwe3.pdf
R711 | 存储卡 | 0R | 1 | 否 | Vishay | CRCW06030000Z0EA | Resistor_SMD:R_0603_1608Metric | 资料核对候选 | 候选规格/引脚核对；装配工艺、实际负载与供货仍需确认。 | 候选已指定 | 候选已指定 | https://www.vishay.com/docs/20035/dcrcwe3.pdf
R712 | 存储卡 | 0R | 1 | 否 | Vishay | CRCW06030000Z0EA | Resistor_SMD:R_0603_1608Metric | 资料核对候选 | 候选规格/引脚核对；装配工艺、实际负载与供货仍需确认。 | 候选已指定 | 候选已指定 | https://www.vishay.com/docs/20035/dcrcwe3.pdf
R713 | 存储卡 | 0R | 1 | 否 | Vishay | CRCW06030000Z0EA | Resistor_SMD:R_0603_1608Metric | 资料核对候选 | 候选规格/引脚核对；装配工艺、实际负载与供货仍需确认。 | 候选已指定 | 候选已指定 | https://www.vishay.com/docs/20035/dcrcwe3.pdf
R714 | 存储卡 | 0R | 1 | 否 | Vishay | CRCW06030000Z0EA | Resistor_SMD:R_0603_1608Metric | 资料核对候选 | 候选规格/引脚核对；装配工艺、实际负载与供货仍需确认。 | 候选已指定 | 候选已指定 | https://www.vishay.com/docs/20035/dcrcwe3.pdf
R715 | 存储卡 | 0R | 1 | 否 | Vishay | CRCW06030000Z0EA | Resistor_SMD:R_0603_1608Metric | 资料核对候选 | 候选规格/引脚核对；装配工艺、实际负载与供货仍需确认。 | 候选已指定 | 候选已指定 | https://www.vishay.com/docs/20035/dcrcwe3.pdf
U701 | 存储卡 | TI TMUX1511PW | 1 | 否 | Texas Instruments | TMUX1511PWR | Package_SO:TSSOP-14_4.4x5mm_P0.65mm | 资料核对候选 | 候选规格/引脚核对；装配工艺、实际负载与供货仍需确认。 | 候选已指定 | 候选已指定 | https://www.ti.com/product/TMUX1511/part-details/TMUX1511PWR
U702 | 存储卡 | TI TPD2E2U06DCKR | 1 | 否 | Texas Instruments | TPD2E2U06DCKR | ESPaperPlay:TI_DCK0003A_SC70_3_Recommended | 资料核对候选 | 候选规格/引脚核对；装配工艺、实际负载与供货仍需确认。 | 候选已指定 | 候选已指定 | https://www.ti.com/product/TPD2E2U06/part-details/TPD2E2U06DCKR
U703 | 存储卡 | TI TPD2E2U06DCKR | 1 | 否 | Texas Instruments | TPD2E2U06DCKR | ESPaperPlay:TI_DCK0003A_SC70_3_Recommended | 资料核对候选 | 候选规格/引脚核对；装配工艺、实际负载与供货仍需确认。 | 候选已指定 | 候选已指定 | https://www.ti.com/product/TPD2E2U06/part-details/TPD2E2U06DCKR
U704 | 存储卡 | TI TPD2E2U06DCKR | 1 | 否 | Texas Instruments | TPD2E2U06DCKR | ESPaperPlay:TI_DCK0003A_SC70_3_Recommended | 资料核对候选 | 候选规格/引脚核对；装配工艺、实际负载与供货仍需确认。 | 候选已指定 | 候选已指定 | https://www.ti.com/product/TPD2E2U06/part-details/TPD2E2U06DCKR
U705 | 存储卡 | TI TPD2E2U06DCKR | 1 | 否 | Texas Instruments | TPD2E2U06DCKR | ESPaperPlay:TI_DCK0003A_SC70_3_Recommended | 资料核对候选 | 候选规格/引脚核对；装配工艺、实际负载与供货仍需确认。 | 候选已指定 | 候选已指定 | https://www.ti.com/product/TPD2E2U06/part-details/TPD2E2U06DCKR
U706 | 存储卡 | TI TMUX1511PW | 1 | 否 | Texas Instruments | TMUX1511PWR | Package_SO:TSSOP-14_4.4x5mm_P0.65mm | 资料核对候选 | 候选规格/引脚核对；装配工艺、实际负载与供货仍需确认。 | 候选已指定 | 候选已指定 | https://www.ti.com/product/TMUX1511/part-details/TMUX1511PWR
C801 | 音频 | 100n / 10V | 1 | 否 | TDK | C1608X7R1H104K080AA | Capacitor_SMD:C_0603_1608Metric | 资料核对候选 | 原厂在产候选；成本/供货与贴装工艺待确认。 | 候选已指定 | 候选已指定 | https://product.tdk.com/en/search/capacitor/ceramic/mlcc/info?part_no=C1608X7R1H104K080AA
C802 | 音频 | 100n / 10V | 1 | 否 | TDK | C1608X7R1H104K080AA | Capacitor_SMD:C_0603_1608Metric | 资料核对候选 | 原厂在产候选；成本/供货与贴装工艺待确认。 | 候选已指定 | 候选已指定 | https://product.tdk.com/en/search/capacitor/ceramic/mlcc/info?part_no=C1608X7R1H104K080AA
C803 | 音频 | 10u / 10V | 1 | 否 |  |  | Capacitor_SMD:C_0805_2012Metric | 需专项闭合 | 准确料号/工作偏压有效容量及容差、温度、老化待闭合。 | 候选已指定 | 未指定
C804 | 音频 | 100n / 10V | 1 | 否 | TDK | C1608X7R1H104K080AA | Capacitor_SMD:C_0603_1608Metric | 资料核对候选 | 原厂在产候选；成本/供货与贴装工艺待确认。 | 候选已指定 | 候选已指定 | https://product.tdk.com/en/search/capacitor/ceramic/mlcc/info?part_no=C1608X7R1H104K080AA
C805 | 音频 | 1u / 10V | 1 | 否 |  |  | Capacitor_SMD:C_0603_1608Metric | 需专项闭合 | 准确料号/工作偏压有效容量及容差、温度、老化待闭合。 | 候选已指定 | 未指定
C806 | 音频 | 100n / 10V | 1 | 否 | TDK | C1608X7R1H104K080AA | Capacitor_SMD:C_0603_1608Metric | 资料核对候选 | 原厂在产候选；成本/供货与贴装工艺待确认。 | 候选已指定 | 候选已指定 | https://product.tdk.com/en/search/capacitor/ceramic/mlcc/info?part_no=C1608X7R1H104K080AA
C808 | 音频 | 100n / 10V | 1 | 否 | TDK | C1608X7R1H104K080AA | Capacitor_SMD:C_0603_1608Metric | 资料核对候选 | 原厂在产候选；成本/供货与贴装工艺待确认。 | 候选已指定 | 候选已指定 | https://product.tdk.com/en/search/capacitor/ceramic/mlcc/info?part_no=C1608X7R1H104K080AA
J801 | 音频 | SPEAKER / 8R CANDIDATE | 1 | 否 |  |  |  | 需专项闭合 | 8Ω扬声器及线束连接器待定；BTL两线均不接地。 | 未指定 | 未指定
R802 | 音频 | 100k | 1 | 否 | Vishay | CRCW0603100KFKEA | Resistor_SMD:R_0603_1608Metric | 资料核对候选 | 候选规格/引脚核对；装配工艺、实际负载与供货仍需确认。 | 候选已指定 | 候选已指定 | https://www.vishay.com/docs/20035/dcrcwe3.pdf
R803 | 音频 | 100k | 1 | 否 | Vishay | CRCW0603100KFKEA | Resistor_SMD:R_0603_1608Metric | 资料核对候选 | 候选规格/引脚核对；装配工艺、实际负载与供货仍需确认。 | 候选已指定 | 候选已指定 | https://www.vishay.com/docs/20035/dcrcwe3.pdf
R804 | 音频 | 100k | 1 | 否 | Vishay | CRCW0603100KFKEA | Resistor_SMD:R_0603_1608Metric | 资料核对候选 | 候选规格/引脚核对；装配工艺、实际负载与供货仍需确认。 | 候选已指定 | 候选已指定 | https://www.vishay.com/docs/20035/dcrcwe3.pdf
R805 | 音频 | 100k | 1 | 否 | Vishay | CRCW0603100KFKEA | Resistor_SMD:R_0603_1608Metric | 资料核对候选 | 候选规格/引脚核对；装配工艺、实际负载与供货仍需确认。 | 候选已指定 | 候选已指定 | https://www.vishay.com/docs/20035/dcrcwe3.pdf
R806 | 音频 | 2.00k / 1% | 1 | 否 | Vishay | CRCW06032K00FKEA | Resistor_SMD:R_0603_1608Metric | 资料核对候选 | 候选规格/引脚核对；装配工艺、实际负载与供货仍需确认。 | 候选已指定 | 候选已指定 | https://www.vishay.com/docs/20035/dcrcwe3.pdf
R808 | 音频 | 22R | 1 | 否 | Vishay | CRCW060322R0FKEA | Resistor_SMD:R_0603_1608Metric | 资料核对候选 | 候选规格/引脚核对；装配工艺、实际负载与供货仍需确认。 | 候选已指定 | 候选已指定 | https://www.vishay.com/docs/20035/dcrcwe3.pdf
R809 | 音频 | 22R | 1 | 否 | Vishay | CRCW060322R0FKEA | Resistor_SMD:R_0603_1608Metric | 资料核对候选 | 候选规格/引脚核对；装配工艺、实际负载与供货仍需确认。 | 候选已指定 | 候选已指定 | https://www.vishay.com/docs/20035/dcrcwe3.pdf
R810 | 音频 | 22R | 1 | 否 | Vishay | CRCW060322R0FKEA | Resistor_SMD:R_0603_1608Metric | 资料核对候选 | 候选规格/引脚核对；装配工艺、实际负载与供货仍需确认。 | 候选已指定 | 候选已指定 | https://www.vishay.com/docs/20035/dcrcwe3.pdf
R811 | 音频 | 0R / SPK_P | 1 | 否 | Vishay | CRCW08050000Z0EA | Resistor_SMD:R_0805_2012Metric | 资料核对候选 | 0805 0Ω/2.5A/≤20mΩ候选；结合扬声器电流和温升验证。 | 候选已指定 | 候选已指定 | https://www.vishay.com/docs/20035/dcrcwe3.pdf
R812 | 音频 | 0R / SPK_N | 1 | 否 | Vishay | CRCW08050000Z0EA | Resistor_SMD:R_0805_2012Metric | 资料核对候选 | 0805 0Ω/2.5A/≤20mΩ候选；结合扬声器电流和温升验证。 | 候选已指定 | 候选已指定 | https://www.vishay.com/docs/20035/dcrcwe3.pdf
R813 | 音频 | 100k | 1 | 否 | Vishay | CRCW0603100KFKEA | Resistor_SMD:R_0603_1608Metric | 资料核对候选 | 候选规格/引脚核对；装配工艺、实际负载与供货仍需确认。 | 候选已指定 | 候选已指定 | https://www.vishay.com/docs/20035/dcrcwe3.pdf
U801 | 音频 | Nexperia 74LVC125APW | 1 | 否 | Nexperia | 74LVC125APW,118 | Package_SO:TSSOP-14_4.4x5mm_P0.65mm | 资料核对候选 | 候选规格/引脚核对；装配工艺、实际负载与供货仍需确认。 | 候选已指定 | 候选已指定 | https://assets.nexperia.com/documents/data-sheet/74LVC125A.pdf https://www.nexperia.com/product/74LVC125APW https://assets.nexperia.com/documents/package-information/SOT402-1.pdf
U802 | 音频 | MAX98357AETE+T | 1 | 否 | Analog Devices / Maxim Integrated | MAX98357AETE+T | ESPaperPlay:Analog_MAX98357A_T1633-4_3x3mm_P0.5mm_EP1.23mm | 资料核对候选 | 候选规格/引脚核对；装配工艺、实际负载与供货仍需确认。 | 候选已指定 | 候选已指定 | https://www.analog.com/media/en/technical-documentation/data-sheets/MAX98357A-MAX98357B.pdf https://mds.analog.com/api/public/content/90-0031.pdf https://www.analog.com/en/products/max98357a.html
U803 | 音频 | DMM-4026-B-I2S-R | 1 | 否 | PUI Audio | DMM-4026-B-I2S-R |  | 需专项闭合 | 需PCB声孔、阻焊/钢网、声道及生命周期确认；器件声孔直径不能直接当PCB孔径。 | 未指定 | 候选已指定 | https://api.puiaudio.com/filename/DMM-4026-B-I2S-R.pdf https://puiaudio.com/product/microphones/dmm-4026-b-i2s-r
U804 | 音频 | TI SN74LVC1G125DBVR | 1 | 否 | Texas Instruments | SN74LVC1G125DBVR | Package_TO_SOT_SMD:SOT-23-5 | 资料核对候选 | 候选规格/引脚核对；装配工艺、实际负载与供货仍需确认。 | 候选已指定 | 候选已指定 | https://www.ti.com/lit/ds/symlink/sn74lvc1g125.pdf https://www.ti.com/product/SN74LVC1G125
U805 | 音频 | TI SN74LVC1G14DBVR | 1 | 否 | Texas Instruments | SN74LVC1G14DBVR | Package_TO_SOT_SMD:SOT-23-5 | 资料核对候选 | 候选规格/引脚核对；装配工艺、实际负载与供货仍需确认。 | 候选已指定 | 候选已指定 | https://www.ti.com/lit/ds/symlink/sn74lvc1g14.pdf https://www.ti.com/product/SN74LVC1G14

Sheet: 封装核对
封装候选分组核对
按 KiCad 封装分组，位号数量读取 BOM；“未指定”集中保留尚未定型的位置。
KiCad 封装候选 | 位号数 | 对应位号 | 器件候选示例 | 资料核对与待闭合要点
未指定 | 7 | J102–J103、J406、J601、J801、R602、U803 | DMM-4026-B-I2S-R | J102：电池连接器、极性和线束额定待定。 J103：NTC连接器、曲线和温区待定。 J406：触摸FPC接触面、插入长度、旧型号原厂机械图待核。 J601：屏幕FPC接触面、插入长度/加强板与插座适配待核。 R602：0.47Ω采样电阻需峰值/RMS/占空比与脉冲功率证据后选择封装。 J801：8Ω扬声器及线束连接器待定；BTL两线均不接地。 U803：需PCB声孔、阻焊/钢网、声道及生命周期确认；器件声孔直径不能直接当PCB孔径。
Button_Switch_THT:SW_PUSH_6mm | 5 | SW301–SW305 | B3F-1002-G | 6.5×4.5mm 孔距，1.10mm 孔。两行各为一个常通接点组，按下跨组接通。普通键 47k 上拉约 70µA；EN / BOOT 约 330µA。低电流可靠性仍待实测。
Capacitor_SMD:C_0603_1608Metric | 32 | C203–C204、C302–C303、C401–C402、C404–C405 C407–C408、C410–C414、C416–C417、C501–C503 C611–C612、C701、C703–C705、C801–C802 C804–C806、C808 | C1608X7R1H104K080AA | 标准尺寸候选。100nF 采用 TDK 在产替代型号。准确 MLCC 型号仍需按电压、有效容量、公差、温度与老化确认。封装尺寸不代表电气额定合格。
Capacitor_SMD:C_0805_2012Metric | 12 | C101–C103、C201、C301、C409、C603、C605–C606 C610、C702、C803 |  | 标准尺寸候选。准确 MLCC 型号仍需按电压、有效容量、公差、温度与老化确认。封装尺寸不代表电气额定合格。
Capacitor_SMD:C_1206_3216Metric | 10 | C202、C403、C406、C415、C601–C602、C604 C607–C609 | GRM31CR71H475KA12L | 标准尺寸候选。准确 MLCC 型号仍需按电压、有效容量、公差、温度与老化确认。封装尺寸不代表电气额定合格。
Connector_Card:microSD_HC_Hirose_DM3AT-SF-PEJM5 | 1 | J701 | DM3AT-SF-PEJM5 | Hirose DM3AT-SF-PEJM5 为推推式。库 9/10 是机械检测编号，SH 为屏蔽外壳。检测 A/B 位置、退卡行程、禁布区仍待完整机械签核。
Connector_USB:USB_C_Receptacle_GCT_USB4105-xx-A_16P_TopMnt_Horizontal | 1 | J501 | USB4105-GF-A | GCT USB4105-GF-A：16 个逻辑触点映射至 12 个物理 SMT 焊区，4 个接地外壳孔、2 个定位孔。板厚、板边与插脚工艺待验证。
Diode_SMD:D_SMA | 1 | D501 | SMAJ6.0A | 按准确订货号与资料建立候选。需结合本表位号与 BOM 中待闭合事项确认焊接、负载及实际装配条件，不能直接视为生产放行。
Diode_SMD:D_SOD-123 | 3 | D601–D603 | MBR0530T1G | 按准确订货号与资料建立候选。需结合本表位号与 BOM 中待闭合事项确认焊接、负载及实际装配条件，不能直接视为生产放行。
ESPaperPlay:Analog_MAX98357A_T1633-4_3x3mm_P0.5mm_EP1.23mm | 1 | U802 | MAX98357AETE+T | MAX98357A 的 T1633-4 3×3mm 封装候选，中心焊盘按资料核对。EP 钢网、散热与功率 / 实际扬声器负载待验证。
ESPaperPlay:AOS_SOT23_PO00001N | 2 | Q101、Q201 | AO3400A | 按准确订货号与资料建立候选。需结合本表位号与 BOM 中待闭合事项确认焊接、负载及实际装配条件，不能直接视为生产放行。
ESPaperPlay:Bourns_CRF0805_Jumper | 8 | R101–R102、R203、R402、R405、R408、R411、R414 | CRF0805-J/-000ELF | 电源零欧采用 Bourns CRF0805 专用跳线候选，依据原厂几何建立本地封装。电流、温升与走线条件仍需实测。
ESPaperPlay:Bourns_MF-MSMF_1812_Style2 | 1 | F501 | MF-MSMF110/16X-2 | 按准确订货号与资料建立候选。需结合本表位号与 BOM 中待闭合事项确认焊接、负载及实际装配条件，不能直接视为生产放行。
ESPaperPlay:Coilcraft_XFL4015_4x4mm | 1 | L201 | XFL4015-471MEC | 按准确订货号与资料建立候选。需结合本表位号与 BOM 中待闭合事项确认焊接、负载及实际装配条件，不能直接视为生产放行。
ESPaperPlay:TI_DCK0003A_SC70_3_Recommended | 6 | U501–U502、U702–U705 | TPD2E2U06DCKR | TPD2E2U06DCKR：引脚 1/2 为 IO，3 为 GND。按原厂 DCK0003A 推荐焊盘 0.95×0.40mm，跨距 2.20mm、间距 0.65mm。
ESPaperPlay:TI_DLA0010A_VSON-HR_2x3mm_P0.5mm | 1 | U201 | TPS63802DLAR | TPS63802DLAR 对应 DLA0010A VSON-HR，含非对称功率焊盘。依原厂焊盘图建本地候选，短电流环路与热 / 钢网仍待布局审查。
ESPaperPlay:TI_RGT0016C_VQFN_3x3mm_P0.5mm_EP1.68mm | 1 | U101 | BQ24074RGTR | BQ24074RGT 对应 RGT0016C。暴露焊盘、焊盘编号已按原厂图核对；钢网、热设计、NTC 与电池充电边界待验证。
ESPaperPlay:WR_PHD_1x02_P2.54_Drill1.10 | 11 | J101、J104–J105、J201、J203–J204、J401–J405 | 61300211121 | 原厂 2.54mm 节距、1.10mm 通孔。5 款封装已由 KiCad 原生载入，编号与 18 个符号实例匹配。配对线束 / 跳帽及焊接配合待确认。
ESPaperPlay:WR_PHD_1x03_P2.54_Drill1.10 | 2 | J202、J502 | 61300311121 | 原厂 2.54mm 节距、1.10mm 通孔。5 款封装已由 KiCad 原生载入，编号与 18 个符号实例匹配。配对线束 / 跳帽及焊接配合待确认。
ESPaperPlay:WR_PHD_1x06_P2.54_Drill1.10 | 2 | J205–J206 | 61300611121 | 原厂 2.54mm 节距、1.10mm 通孔。5 款封装已由 KiCad 原生载入，编号与 18 个符号实例匹配。配对线束 / 跳帽及焊接配合待确认。
ESPaperPlay:WR_PHD_1x08_P2.54_Drill1.10 | 2 | J301、J303 | 61300811121 | 原厂 2.54mm 节距、1.10mm 通孔。5 款封装已由 KiCad 原生载入，编号与 18 个符号实例匹配。配对线束 / 跳帽及焊接配合待确认。
ESPaperPlay:WR_PHD_1x09_P2.54_Drill1.10 | 1 | J302 | 61300911121 | 原厂 2.54mm 节距、1.10mm 通孔。5 款封装已由 KiCad 原生载入，编号与 18 个符号实例匹配。配对线束 / 跳帽及焊接配合待确认。
Inductor_SMD:L_Bourns-SRN4018 | 1 | L601 | SRN4018-100M | 按准确订货号与资料建立候选。需结合本表位号与 BOM 中待闭合事项确认焊接、负载及实际装配条件，不能直接视为生产放行。
Package_DFN_QFN:TDFN-8-1EP_2x2mm_P0.5mm_EP0.8x1.2mm | 1 | U203 | MAX17048G+T10 | 按准确订货号与资料建立候选。需结合本表位号与 BOM 中待闭合事项确认焊接、负载及实际装配条件，不能直接视为生产放行。
Package_SO:TSSOP-14_4.4x5mm_P0.65mm | 4 | U406、U701、U706、U801 | TMUX1511PWR 74LVC125APW,118 | TMUX1511PWR，TSSOP-14，0.65mm 间距。编号已核对。现用 IPC 焊盘与 TI 示例存在小差异，作为工艺候选保留。
Package_SO:TSSOP-20_4.4x6.5mm_P0.65mm | 1 | U601 | SN74LVC541APWR | 按准确订货号与资料建立候选。需结合本表位号与 BOM 中待闭合事项确认焊接、负载及实际装配条件，不能直接视为生产放行。
Package_SO:TSSOP-24_4.4x7.8mm_P0.65mm | 1 | U202 | TCA9539PWR | 按准确订货号与资料建立候选。需结合本表位号与 BOM 中待闭合事项确认焊接、负载及实际装配条件，不能直接视为生产放行。
Package_TO_SOT_SMD:SOT-23-5 | 3 | U602、U804–U805 | SN74LVC1G125DBVR SN74LVC1G14DBVR | 按准确订货号与资料建立候选。需结合本表位号与 BOM 中待闭合事项确认焊接、负载及实际装配条件，不能直接视为生产放行。
Package_TO_SOT_SMD:SOT-23-6 | 5 | U401–U405 | TPS22918DBVR | 按准确订货号与资料建立候选。需结合本表位号与 BOM 中待闭合事项确认焊接、负载及实际装配条件，不能直接视为生产放行。
Package_TO_SOT_SMD:SOT-323_SC-70 | 1 | Q601 | Si1308EDL-T1-GE3 | 按准确订货号与资料建立候选。需结合本表位号与 BOM 中待闭合事项确认焊接、负载及实际装配条件，不能直接视为生产放行。
Resistor_SMD:R_0603_1608Metric | 91 | R103–R112、R201–R202、R204–R227、R301–R306 R401、R404、R407、R410、R413、R416–R420 R501–R504、R601、R603–R614、R701–R706、R708 R710–R715、R802–R806、R808–R810、R813 | CRCW06031K62FKEA CRCW06033K00FKEA CRCW060368K0FKEA | Vishay CRCW 阻值代码与网表核对通过。0603 普通电阻 1% / 100ppm；零欧需按实际通流和温升核验，0805 扬声器跳线单独核额定。
Resistor_SMD:R_0805_2012Metric | 2 | R811–R812 | CRCW08050000Z0EA | Vishay CRCW 阻值代码与网表核对通过。0603 普通电阻 1% / 100ppm；零欧需按实际通流和温升核验，0805 扬声器跳线单独核额定。
RF_Module:ESP32-S3-WROOM-1 | 1 | U301 | ESP32-S3-WROOM-1-N16R8 | ESP32-S3-WROOM-1-N16R8，40 个周边焊盘及 EP41。保留库 EP41 铜面 / 过孔设计，需另核钢网、过孔工艺及天线净空。
