xiaobaoaaaaaa/ESPaperPlay-V2/hardware/devboard-r0/review-r9/special-hole-register.csv

source_sha256 | classification | object_kind | uuid | x_mm | y_mm | drill_x_mm | drill_y_mm | associated_pads | net | explicit_footprint_F_Mask | explicit_footprint_B_Mask | native_via_tenting_setting_F | native_via_tenting_setting_B | actual_F_Mask_open_hole_fraction | actual_B_Mask_open_hole_fraction | drill_to_F_Mask_opening_gap_mm | drill_to_B_Mask_opening_gap_mm | raw_F_Paste_overlap_hole_mm2 | DIY_F_Paste_overlap_hole_mm2 | process_status
1a4556d866cc1352a2c45b674c94d2f233edf28c3e003bd96c8f6caf1e630681 | annular_contact_only | native_via | 0e746ec6-285c-4e9c-ac8c-e31313c3ea42 | 57.8 | 59.5 | 0.3 | 0.3 | C804.2 | GND |  |  | True | True | 0.0 | 0.0 | 0.125 | 3.55001379 | 0.0 | 0.0 | CAM_hole_treatment_and_actual_assembly_pending; mask_tenting_is_not_fill_and_copper_cap
1a4556d866cc1352a2c45b674c94d2f233edf28c3e003bd96c8f6caf1e630681 | annular_contact_only | native_via | 2b2edb3c-db2e-4f95-aca6-9798f97b703a | 60.3 | 61.325 | 0.2 | 0.2 | U803.4 | GND |  |  | True | True | 0.0 | 0.0 | 0.02624402 | 0.57243784 | 0.0 | 0.0 | CAM_hole_treatment_and_actual_assembly_pending; mask_tenting_is_not_fill_and_copper_cap
1a4556d866cc1352a2c45b674c94d2f233edf28c3e003bd96c8f6caf1e630681 | annular_contact_only | native_via | df049a2f-7086-4182-acb0-5f9b337b8d6f | 60.7 | 78.0 | 0.3 | 0.3 | U404.2 | GND |  |  | True | True | 0.0 | 0.0 | 0.025 | 4.15 | 0.0 | 0.0 | CAM_hole_treatment_and_actual_assembly_pending; mask_tenting_is_not_fill_and_copper_cap
1a4556d866cc1352a2c45b674c94d2f233edf28c3e003bd96c8f6caf1e630681 | annular_contact_only | native_via | 19a3fe98-d833-4d8a-9e87-4d3e3699e9a7 | 63.3553 | 105.0303 | 0.3 | 0.3 | R222.2 | GND |  |  | True | True | 0.0 | 0.0 | 0.06747847 | 3.87429066 | 0.0 | 0.0 | CAM_hole_treatment_and_actual_assembly_pending; mask_tenting_is_not_fill_and_copper_cap
1a4556d866cc1352a2c45b674c94d2f233edf28c3e003bd96c8f6caf1e630681 | annular_contact_only | native_via | a2d57b52-1a92-47a0-bf58-e74d4f744612 | 64.2697 | 104.4197 | 0.3 | 0.3 | Q201.2 | GND |  |  | True | True | 0.0 | 0.0 | 0.00498271 | 4.69505105 | 0.0 | 0.0 | CAM_hole_treatment_and_actual_assembly_pending; mask_tenting_is_not_fill_and_copper_cap
1a4556d866cc1352a2c45b674c94d2f233edf28c3e003bd96c8f6caf1e630681 | annular_contact_only | native_via | 9ab5cbf6-5b10-4429-ac2b-93543bff7008 | 64.8553 | 73.5303 | 0.3 | 0.3 | R416.2 | GND |  |  | True | True | 0.0 | 0.0 | 0.06747847 | 8.78862005 | 0.0 | 0.0 | CAM_hole_treatment_and_actual_assembly_pending; mask_tenting_is_not_fill_and_copper_cap
1a4556d866cc1352a2c45b674c94d2f233edf28c3e003bd96c8f6caf1e630681 | annular_contact_only | native_via | 4b2e7eac-4728-486f-ae9e-36fd0b6e75a7 | 65.8553 | 64.330299 | 0.3 | 0.3 | R813.2 | GND |  |  | True | True | 0.0 | 0.0 | 0.06747786 | 4.93556659 | 0.0 | 0.0 | CAM_hole_treatment_and_actual_assembly_pending; mask_tenting_is_not_fill_and_copper_cap
1a4556d866cc1352a2c45b674c94d2f233edf28c3e003bd96c8f6caf1e630681 | annular_contact_only | native_via | 5c47344a-8fc0-44b2-8e0b-0cc83d939846 | 71.0697 | 58.6447 | 0.3 | 0.3 | R802.2 | GND |  |  | True | True | 0.0 | 0.0 | 0.06746641 | 10.16399997 | 0.0 | 0.0 | CAM_hole_treatment_and_actual_assembly_pending; mask_tenting_is_not_fill_and_copper_cap
1a4556d866cc1352a2c45b674c94d2f233edf28c3e003bd96c8f6caf1e630681 | annular_contact_only | native_via | 06e6bf69-a48b-4988-9813-2e3ffc19a0c5 | 71.0697 | 68.4447 | 0.3 | 0.3 | R803.2 | GND |  |  | True | True | 0.0 | 0.0 | 0.06746641 | 11.50546782 | 0.0 | 0.0 | CAM_hole_treatment_and_actual_assembly_pending; mask_tenting_is_not_fill_and_copper_cap
1a4556d866cc1352a2c45b674c94d2f233edf28c3e003bd96c8f6caf1e630681 | annular_contact_only | native_via | 5caaa0de-8a7f-4d2c-a15e-f3ab3ae0b84a | 76.5303 | 117.4447 | 0.3 | 0.3 | R110.2 | GND |  |  | True | True | 0.0 | 0.0 | 0.06746641 | 7.49938518 | 0.0 | 0.0 | CAM_hole_treatment_and_actual_assembly_pending; mask_tenting_is_not_fill_and_copper_cap
1a4556d866cc1352a2c45b674c94d2f233edf28c3e003bd96c8f6caf1e630681 | annular_contact_only | native_via | 9f72957f-19d9-4cec-b5f8-57fd57972f6d | 82.7 | 78.0 | 0.3 | 0.3 | U405.2 | GND |  |  | True | True | 0.0 | 0.0 | 0.025 | 4.15 | 0.0 | 0.0 | CAM_hole_treatment_and_actual_assembly_pending; mask_tenting_is_not_fill_and_copper_cap
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
