xiaobaoaaaaaa/ESPaperPlay-V2/hardware/devboard-r0/review-r2/audio-pin-net-review.csv

reference | physical_pin | expected_net | actual_net | electrical_type | result
U801 | 14 | MIC_3V3 | MIC_3V3 | power_in | PASS
U801 | 7 | GND | GND | power_in | PASS
U801 | 2 | I2S_BCLK | I2S_BCLK | input | PASS
U801 | 3 | AUDIO_BCLK_BUF | AUDIO_BCLK_BUF | tri_state | PASS
U801 | 5 | I2S_WS | I2S_WS | input | PASS
U801 | 6 | AUDIO_WS_BUF | AUDIO_WS_BUF | tri_state | PASS
U801 | 9 | SPEAKER_DATA | SPEAKER_DATA | input | PASS
U801 | 8 | AUDIO_DIN_BUF | AUDIO_DIN_BUF | tri_state | PASS
U801 | 12 | AMP_SHUTDOWN | AMP_SHUTDOWN | input | PASS
U801 | 11 | AUDIO_SD_BUF | AUDIO_SD_BUF | tri_state | PASS
U801 | 1 | AUDIO_OE_N | AUDIO_OE_N | input | PASS
U801 | 4 | AUDIO_OE_N | AUDIO_OE_N | input | PASS
U801 | 10 | AUDIO_OE_N | AUDIO_OE_N | input | PASS
U801 | 13 | AUDIO_OE_N | AUDIO_OE_N | input | PASS
R808 | 1 | AUDIO_BCLK_BUF | AUDIO_BCLK_BUF | passive | PASS
R808 | 2 | I2S_BCLK_AUDIO | I2S_BCLK_AUDIO | passive | PASS
R809 | 1 | AUDIO_WS_BUF | AUDIO_WS_BUF | passive | PASS
R809 | 2 | I2S_WS_AUDIO | I2S_WS_AUDIO | passive | PASS
R810 | 1 | AUDIO_DIN_BUF | AUDIO_DIN_BUF | passive | PASS
R810 | 2 | I2S_DIN_AUDIO | I2S_DIN_AUDIO | passive | PASS
U805 | 1 | NC | unconnected-(U805-NC-Pad1) | no_connect | PASS
U805 | 2 | AUDIO_EN | AUDIO_EN | input | PASS
U805 | 3 | GND | GND | power_in | PASS
U805 | 4 | AUDIO_OE_N | AUDIO_OE_N | output | PASS
U805 | 5 | MIC_3V3 | MIC_3V3 | power_in | PASS
C806 | 1 | MIC_3V3 | MIC_3V3 | passive | PASS
C806 | 2 | GND | GND | passive | PASS
C801 | 1 | MIC_3V3 | MIC_3V3 | passive | PASS
C801 | 2 | GND | GND | passive | PASS
U802 | 1 | I2S_DIN_AUDIO | I2S_DIN_AUDIO | input | PASS
U802 | 2 | AMP_SYS | AMP_SYS | passive | PASS
U802 | 3 | GND | GND | power_in | PASS
U802 | 4 | AMP_SD_MODE | AMP_SD_MODE | input | PASS
U802 | 5 | NC | unconnected-(U802-NC-Pad5) | no_connect | PASS
U802 | 6 | NC | unconnected-(U802-NC-Pad6) | no_connect | PASS
U802 | 7 | AMP_SYS | AMP_SYS | power_in | PASS
U802 | 8 | AMP_SYS | AMP_SYS | passive | PASS
U802 | 9 | AMP_OUTP | AMP_OUTP | output | PASS
U802 | 10 | AMP_OUTN | AMP_OUTN | output | PASS
U802 | 11 | GND | GND | passive | PASS
U802 | 12 | NC | unconnected-(U802-NC-Pad12) | no_connect | PASS
U802 | 13 | NC | unconnected-(U802-NC-Pad13) | no_connect | PASS
U802 | 14 | I2S_WS_AUDIO | I2S_WS_AUDIO | input | PASS
U802 | 15 | GND | GND | passive | PASS
U802 | 16 | I2S_BCLK_AUDIO | I2S_BCLK_AUDIO | input | PASS
U802 | 17 | GND | GND | passive | PASS
C802 | 1 | AMP_SYS | AMP_SYS | passive | PASS
C802 | 2 | GND | GND | passive | PASS
C803 | 1 | AMP_SYS | AMP_SYS | passive | PASS
C803 | 2 | GND | GND | passive | PASS
R806 | 1 | AUDIO_SD_BUF | AUDIO_SD_BUF | passive | PASS
R806 | 2 | AMP_SD_MODE | AMP_SD_MODE | passive | PASS
R802 | 1 | I2S_BCLK_AUDIO | I2S_BCLK_AUDIO | passive | PASS
R802 | 2 | GND | GND | passive | PASS
R803 | 1 | I2S_WS_AUDIO | I2S_WS_AUDIO | passive | PASS
R803 | 2 | GND | GND | passive | PASS
R804 | 1 | I2S_DIN_AUDIO | I2S_DIN_AUDIO | passive | PASS
R804 | 2 | GND | GND | passive | PASS
R805 | 1 | AMP_SD_MODE | AMP_SD_MODE | passive | PASS
R805 | 2 | GND | GND | passive | PASS
R811 | 1 | AMP_OUTP | AMP_OUTP | passive | PASS
R811 | 2 | SPK_P | SPK_P | passive | PASS
R812 | 1 | AMP_OUTN | AMP_OUTN | passive | PASS
R812 | 2 | SPK_N | SPK_N | passive | PASS
J801 | 1 | SPK_P | SPK_P | passive | PASS
J801 | 2 | SPK_N | SPK_N | passive | PASS
U803 | 1 | GND | GND | input | PASS
U803 | 2 | GND | GND | input | PASS
U803 | 3 | MIC_3V3 | MIC_3V3 | power_in | PASS
U803 | 4 | GND | GND | power_in | PASS
U803 | 5 | I2S_WS_AUDIO | I2S_WS_AUDIO | input | PASS
U803 | 6 | I2S_BCLK_AUDIO | I2S_BCLK_AUDIO | input | PASS
U803 | 7 | MIC_SD_RAW | MIC_SD_RAW | tri_state | PASS
C804 | 1 | MIC_3V3 | MIC_3V3 | passive | PASS
C804 | 2 | GND | GND | passive | PASS
C805 | 1 | MIC_3V3 | MIC_3V3 | passive | PASS
C805 | 2 | GND | GND | passive | PASS
U804 | 1 | GND | GND | input | PASS
U804 | 2 | MIC_SD_RAW | MIC_SD_RAW | input | PASS
U804 | 3 | GND | GND | power_in | PASS
U804 | 4 | MIC_DATA | MIC_DATA | tri_state | PASS
U804 | 5 | 3V3_AON | 3V3_AON | power_in | PASS
R813 | 1 | MIC_SD_RAW | MIC_SD_RAW | passive | PASS
R813 | 2 | GND | GND | passive | PASS
C808 | 1 | 3V3_AON | 3V3_AON | passive | PASS
C808 | 2 | GND | GND | passive | PASS
