xiaobaoaaaaaa/ESPaperPlay-V2/hardware/devboard-r0/output/manufacturing/r10-review/board/README.md

# r10 裸板工艺要求 — REVIEW ONLY

160×110mm，普通锣边，4层FR4，名义1.6mm；指定JLC04161H-7628，外1oz/内0.5oz，绿油、ENIG。层序F.Cu / In1.Cu(GND) / In2.Cu(GND) / B.Cu。板框取Edge.Cuts线中心，不能按含线宽包围盒扩大。

9个图层文件、PTH/NPTH两份Excellon DRL、2张SVG钻孔图、KiCad job；本包不含焊膏层。单位mm，同绝对原点；CAM Y=−KiCadY。PTH为656孔（549原生via＋12模块孔＋95普通组件孔，含4个USB槽），NPTH为7孔（4个安装孔、2个USB定位孔、1个麦克风声孔）。槽采用route格式，SVG钻孔图只供查看。

**热孔处理为明确设计要求：**附表 `thermal-via-fill-spec.csv` 中11个Ø0.20mm IC孔，需树脂填充、平整化、电镀铜封帽至少10µm，并保留可焊ENIG表面。保留孔铜/热焊盘/接地及指定阻焊开窗；不能用普通塞油或涂阻焊遮住热焊盘替代。请提供与0.10mm钢网相容的实际凹陷/凸起及平整度规格。表中坐标是KiCad绝对坐标、Y向下，UUID关联源板；不能直接当成CAM负Y。

该表是最小必要填孔集合，不承诺选择性加工/收费。若工艺需扩大到更多或全部via，应在生产稿明确范围；95个普通组件孔和7个NPTH必须保持畅通，麦克风Ø0.60mm声孔不可封堵。U301可选中心EPAD不印膏，其12孔不新增强制填孔要求。

538个普通native via孔边到两面实际阻焊开口≥0.20mm，为布局目标，不等于已获厂商对位保证或满足≥0.35mm的油墨塞孔条件。按提交文件盖油；11热孔采用上面的填孔盖帽路线。

阻焊按提供文件保留。637个编号SMD焊盘零扩展；53个+0.05mm（U101/U201、Q101/Q201、L201、F501、R101/R102/R203/R402/R405/R408/R411/R414）；U803的7个+0.025mm。LDI支持1:1不代表可以擅自缩掉局部开窗，亦不可全板统一扩大。设计最窄异网开窗间隙0.150mm。

USB主线W/S=.26/.15mm、差分90Ω±10%；SD主线W=.35mm、单端50Ω±10%。F.Cu参考In1、B.Cu参考In2。现尺寸通过官方名义模型窗口检查；实际层叠、铜截面与补偿仍需生产稿确认。job的ImpedanceControlled=true只是设计要求。

以上为工厂审核输入，未上传、询价或下单；请勿把原始默认F.Paste作为钢网。自装钢网另包。
