xiaobaoaaaaaa/ESPaperPlay-V2/docs/v2/hardware/manufacturing-review-r9.md

# 开发验证板制造与自行装配审查 r9

日期：2026-11-11。r9 审查对象是已经完成布线的 [r8 正式 PCB](../../../hardware/devboard-r0/ESPaperPlay_Devboard.kicad_pcb)。**本轮保持正式 PCB、原理图和电气网络不变，整理制造与 DIY 装配方案；交付状态为 review-only，尚非制造放行。** 未向板厂上传文件、询价、委托贴装或下单。

源板 SHA-256：`1a4556d866cc1352a2c45b674c94d2f233edf28c3e003bd96c8f6caf1e630681`。历史设计入口见 [r8 布线说明](pcb-routing-r8.md)。

## 基本工艺结论

160 × 110 mm 独立四层 FR4 开发板，名义厚度 1.6 mm，JLC04161H-7628 叠层：F.Cu / In1.GND / In2.GND / B.Cu；外铜 1 oz、内铜 0.5 oz，元件均在正面。当前原生 PCB **实际最窄线为 0.18 mm**；项目允许最小线宽 0.15 mm，默认/最小铜间距 0.15 mm，这些是不同指标。

实际有 205 个 0.45/0.20 mm 过孔和 344 个 0.60/0.30 mm 过孔，均为通孔；最小过孔孔边距 0.27215 mm。普通组件孔最小焊环 0.20 mm，USB 壳体槽为 0.60×1.40 / 0.60×1.70 mm。所核对的外形、线宽、孔与槽尺寸在嘉立创公开常规四层能力内，无需因为这些尺寸升级 HDI 或六层。具体数值和来源见 [工艺审查](../../../hardware/devboard-r0/review-r9/process-review.md) 与 [原生几何清单](../../../hardware/devboard-r0/review-r9/native-process-inventory.json)。

公开能力说明“该工艺能做”，不等于已经取得本板报价、生产稿确认或制造放行。阻焊/焊膏开窗、隐藏焊点和焊盘附近孔的处理仍须按实际文件评估。

## 阻抗：已取得官方目标线宽，仍待本板确认

本次使用 [JLCPCB 官方计算器](https://jlcpcb.com/pcb-impedance-calculator)，选择 4 层、1.6 mm、外 1 oz/内 0.5 oz、JLC04161H-7628、L1 对 L2、带阻焊非共面模型。页面将该叠层标作标准叠层，成品厚度 1.59 mm±10%；计算得到：

| 网络 | 正式 r8 尺寸 | 官方模型目标线宽 | 当前宽度相对该值 |
|---|---|---|---:|
| SD，单端 50 Ω | W0.3500 mm | W0.3586 mm | -2.40% |
| USB，差分 90 Ω | W0.2600 / S0.1500 mm | W0.2474 / S0.1501 mm，输入间距0.1500 | +5.09% |

**线宽偏差不等于阻抗误差。** 本次没有取得现有几何的官方反求阻抗，也没有取得 45/55 Ω 单端、81/99 Ω 差分的四点线宽窗口；不能据上表宣布当前铜线满足或不满足 ±10% 阻抗公差。计算器显示的 ±0.5% 求解容差也不是制造验收公差。参数和真实输出见 [计算器记录](../../../hardware/devboard-r0/review-r9/impedance-calculator-review.json)。

制造资料中继续指定 USB 90 Ω±10%、SD 50 Ω±10%，明确参考层和现有 W/S，要求板厂依据指定叠层、实际铜截面及生产补偿确认。若需要修改线宽/间距，应先局部改板、重新 DRC 和连通核查；本轮未修改正式走线。r8 闭式公式约 89.96/49.98 Ω 仍只是历史名义估算，不替代本次官方结果或工厂确认。

## 焊区内孔与钢网方案

必须分开处理两组孔：**11 个 IC 焊区内孔**（U101 四个、U201 两个、U203 一个、U802 四个），以及 **U301 可选中心 EPAD 下的 12 个模块热孔**。另有 44 个过孔仅铜环触及 SMT 铜，其孔边到焊盘铜间距为 0.025001–0.125 mm，实际Gerber中这些44孔口均名义盖住且没有直接印膏，但到阻焊开口的最小余量只有0.00498mm，不能据此保证实际盖油可靠；需要明确填孔/盖帽或局部移孔方案，不能混称为另外44个盘中孔。逐孔位置见[67孔登记表](../../../hardware/devboard-r0/review-r9/special-hole-register.csv)。

本次 DIY 钢网候选 **不印 U301 中心 EPAD**，仅回流外周焊脚；正式源板的铜、热孔、焊盘与网络保持。[Espressif 数据手册第41页](https://www.espressif.com/sites/default/files/documentation/esp32-s3-wroom-1_wroom-1u_datasheet_en.pdf)允许模块 EPAD 不焊，并说明焊接可改善散热。因此不把 U301 的12孔一概判为必须采用树脂填孔加封帽。留空 EPAD 后的 Wi-Fi/CPU 连续负载温升仍需样机验证；这条依据不适用于其余 IC 的电源地/散热焊盘。

11 个 IC 焊区孔及近焊盘孔要结合最终 mask/paste 回读、避孔分窗、膏量和回流条件确定工艺。KiCad tented 标记不能保证焊盘大开窗覆盖处的孔口已经封闭；普通盖油、塞油、树脂填孔加封帽也不是同一种处理。工厂应按具体孔位与开窗确认可生产方式；需要平整可焊孔口时可选 POFV，不能仅凭“存在23个孔”统一指定昂贵工艺。保留95个普通插件孔和7个NPTH，尤其麦克风声孔不可堵塞。

DIY 钢网是独立的审查候选：去除手焊接口和 DNP 的膏口、去除 U301 EPAD 膏口，并将 U803 麦克风原环形膏口分段以支撑钢网中心区域。其尺寸属于工程方案，须验证印膏、回流和声学密封；正式 r8 PCB 未被该候选覆盖。

## 自行装配工序

| 分组 | 数量 | 工序 |
|---|---:|---|
| 普通贴片器件，含 U301 外周脚 | 203 | 按审查后的 DIY 钢网印膏、贴装、回流 |
| SMD 接口 J406/J501/J601/J701 | 4 | 回流后手焊，不印膏 |
| THT 排针、端子、按钮 | 23 | 回流后手焊 |
| DNP：C501/C502/J301/J302/J303/R108 | 6 | 不装、不印膏 |
| H1—H4 机械孔 | 4 | 不计入电气 BOM，不印膏 |

203+4+23=230 个实装电气位号；另6个DNP，共236个电气位号。R108 保持 DNP，初装仍禁充。屏幕、触摸保留现有纯延长连接，按原厂功能针序；首次连接时核对端到端通断、极性和无邻针短路。电池、扬声器外接，扬声器两端为BTL输出，负端不能接地。

四只 SMD 接口的细脚与壳体固定点需检查桥连、虚焊、共面和塑料损伤。USB 壳脚在1.6mm板上未必从底面露出，应确认壳脚实际润湿和机械固定，不能仅凭底面有锡判断合格。

## 制板前工艺确认与首板验收

本地交付检查已完成：9个制板图层、663个钻孔逐一回读，板框与源板一致；203位钢网、27位手焊和6位DNP互相核对。KiCad 10.0.8复查仍为0错误、0未连接、0原理图差异，保留1条既有U301绘图警告。

制板/钢网加工前还需确认：

1. 板厂确认指定叠层下现有 USB/SD 尺寸和目标阻抗，审核最终生产稿；若修改，重新验证正式板。
2. 按最终铜、mask、paste确认11个IC焊区内孔及近焊盘孔的防吸锡工艺，U301的12孔按本次中心不印膏单独处理；不用统一孔径备注误封插件孔/声孔。
3. 多数SMT阻焊扩展为0，只有U101/U201局部+.05mm、U803+.025mm。关键不同网络的最窄设计桥为U201 .150mm、U101 .160mm、U802 .17678mm；工厂需核实开窗补偿和对位公差，不能直接全板+.05mm，因为U802对角桥会降至约.0768mm。
4. 确认0.10mm钢网及麦克风0.15mm桥的加工能力、实际手印夹具和锡膏方案；确认精确候选器件可购及已有MLCC有效容量等选型条件。若换料/封装/孔处理导致CAD变化，重新导出和核验。当前BOM未采购冻结。

首批样板制作后，检查印膏偏移/释放、回流桥连、热焊盘润湿与空洞、模块温升和麦克风声学密封。以上物理验证属于首板验收，**不要求在尚未制板时先完成回流测试**。之后按样机计划验证充电/NTC温窗、供电瞬态、深睡电流、电子纸高压、USB/SD和音频；静态审查不代替实测。

## 本轮工艺证据

- [详细工艺审查与拟制造规格](../../../hardware/devboard-r0/review-r9/process-review.md)
- [官方资料与访问日期](../../../hardware/devboard-r0/review-r9/process-sources.json)
- [官方计算器真实参数/输出及未完成边界](../../../hardware/devboard-r0/review-r9/impedance-calculator-review.json)
- [原生板尺寸、线宽和钻孔几何清单](../../../hardware/devboard-r0/review-r9/native-process-inventory.json)

- [总审查证据与复现命令](../../../hardware/devboard-r0/review-r9/README.md)
- [制板/钢网/装配审查包](../../../hardware/devboard-r0/output/manufacturing/r9-review/README.md)
- [CAM回读](../../../hardware/devboard-r0/review-r9/cam-readback.json)、[钢网审查](../../../hardware/devboard-r0/review-r9/stencil-review.md)、[机械与装配说明](../../../hardware/devboard-r0/review-r9/mechanical-assembly-review.md)

PCB、电气和默认禁充状态未改。历史r8的23孔工艺笼统结论由本次分组审查补充；历史文件保留原样。
