xiaobaoaaaaaa/ESPaperPlay-V2/hardware/devboard-r0/review-r9/mechanical-assembly-review.md

# r8 开发板：机械复核与自行装配说明草案

日期：2026-11-11。对象：正式 `hardware/devboard-r0/ESPaperPlay_Devboard.kicad_pcb`，SHA-256 `1a4556d866cc1352a2c45b674c94d2f233edf28c3e003bd96c8f6caf1e630681`。本轮只读检查，未改正式 CAD。量化结果见 `mechanical-review.json`，完整实装位号、候选料号、原生坐标与转角见 `mechanical-population.json`。

平面机械几何通过复核。尚未检验实物焊点、线束、电池、插拔手感或热性能；本结论不代替电气首次上电和整板制造放行。这里按用户选择制定工序：钢网印膏后自行回流，连接器和排针后手焊；屏幕、电池、扬声器外接，没有固定外壳。

## 1. 实测板框、安装孔与器件间距

- 外形为一个闭合矩形：X=50…210、Y=50…160 mm，160×110 mm，面积 17,600 mm²；四层，CAD 名义板厚 1.6 mm，无板框内部铣槽。
- H1=(55,55)、H2=(205,55)、H3=(55,155)、H4=(205,155) mm。全部为 Ø3.2 mm NPTH，孔中心距相邻两板边各 5 mm，孔壁至板边 3.4 mm。H1—H4 是孔位，排除 BOM 和贴装坐标，不是待焊元件。
- 240 个封装均有顶层 courtyard。28,680 对交集检查为 0 重叠；最近一对是 DNP 的 C501 与 R503，缓存边界间距 0.100 mm。KiCad 缓存多边形可能比图形中心线内缩 0.005 mm，因此不要将这一数值直接当作元件本体或焊盘间距。
- 仅两处 courtyard 越过板框：U301 的天线及其预留区、J501 的 USB 外壳。这两处与既定布局相符。其余 courtyard 都在板内；靠边的 J701、J406、J801、J601 分别距板框至少 0.325、0.605、0.905、1.205 mm。
- H1—H4 中心至最近其他封装 courtyard 的距离分别约 4.978、7.625、7.505、5.005 mm。该值不是已选定螺钉/垫片的承诺；开发测试先用绝缘支柱，装金属大垫片前另查其直径和焊盘间距。

## 2. 接口方向与可操作空间

以下均为从元件面看 PCB，图上方为北，X 向右、Y 向下；坐标单位 mm。原生旋转角只用于查 CAD，不是人工目视的另一种坐标系。

| 接口 | 焊盘/封装定位与出线方向 | 板边关系及操作空间 |
|---|---|---|
| J501 USB-C | 封装锚点 (108,53)，180°，开口朝北 | 壳体口部 Y=49.325，比北板边外伸 0.675。原布局预留外部 X=100…116、Y=34…50 的插头区域；壳体至该区域的通道未碰其他 courtyard。实际电缆注塑壳仍应试插。 |
| J701 microSD | (200.8,70.5)，90°，卡向东插拔 | 这是 DM3AT **按压自弹 push-push**。封装中锁定位置卡外端 X=210.525，弹出位置 X=214.525，分别超出板边 0.525、4.525；原厂过压位置比锁定再向内 0.8，推算为 X=209.725。板边无外壳阻挡，但实际按压/弹出仍要试装。原预留外部 X=210…220、Y=59…82。 |
| J601 屏幕 24P | (191,152)，0°，从南侧插入，向南出线 | 本体前端 Y=157.08，至南板边 2.92；原预留板外 X=179…203、Y=160…169。从本体口部到板外的路径无其他 courtyard。开锁、插线、合锁操作从南边进行。 |
| J406 触摸 6P | (204.6,105)，90°，从东侧插入，向东出线 | 本体前端 X=207.65，距东板边 2.35；原预留板外 X=210…220、Y=98…112。通道无其他 courtyard；翻盖还需上方自由空间，不能压在屏幕背面。 |
| J102 电池 | (65,151.5)，0°，线向南 | 接线口至南板边 4.9；出线路径无其他 courtyard。 |
| J103 NTC | (78,151.5)，0°，线向南 | 接线口至南板边 4.9；出线路径无其他 courtyard。 |
| J801 扬声器 | (91,55)，180°，线向北 | 接线口至北板边 1.4；出线路径无其他 courtyard。 |

上述七条通道按当前 CAD courtyard 逐一计算，均为零障碍。该检查覆盖板上平面障碍，不代表已测试手指、工具、插头高度或某个未来外壳。保留现有外接屏幕方式；不用 170.2×111.2 mm 的屏体外形替换这块 160×110 mm 开发板的板框。

## 3. 屏幕与触摸：保持文档针序

用户已确认现有 FP24/FP6 连接只是 0.5 mm 间距的纯延长。设计继续以原厂屏幕/触摸文档和现有功能针序为准，不添加转接功能，也不为迁就布线而反转针号。以下是主板端的确切条件；通用间距本身不意味着任意插座外形或排线厚度都相同。

| 项目 | J601：HYCW3D-05FPC24-200B | J406：LAIL-FPC-CDX01-6P0.5-GW |
|---|---|---|
| 针距/芯数 | 0.5 mm / 24 | 0.5 mm / 6 |
| PCB 元件面针 1 | (185.25,152)，焊盘排左端 | (204.6,103.75)，焊盘排上端 |
| 末针 | 24=(196.75,152) | 6=(204.6,106.25) |
| 原厂连接器排线条件 | 宽 12.5±0.07，厚 0.30±0.03，露铜长度 4.0，补强长度 5.0，插入深度 2.10 mm | 宽 3.5±0.05，厚 0.30±0.03，露铜 1.5±0.3，补强至少 2.5 mm |
| 开合/触点信息 | 2.0H 前插后压结构；原图给出剖视，但未独立标接点编号，也未用明确文字定义单一“上接/下接”规格。当前编号沿用已审查的旧板约定，不把翻面当作修正针序的办法。 | 原图明确标注双侧触点、上下接；合盖高 1.00±0.10、开盖参考高 1.75、开盖参考深度 3.8 mm。双侧触点也不能保证延长件必然不反序。 |

J406 的主板针序严格为 **1 GND、2 TOUCH_3V3、3 TP_RESET_N、4 TP_INT、5 TP_SDA、6 TP_SCL**。J601 的完整 24 针网络逐项记在 JSON 中，包含原设计的 NC、屏驱高压与地，不适合凭排线颜色或视觉顺序猜测。

这是文档设计条件，不是再次索要排线型号或照片。在首次连接实物的普通验收步骤中，断开 USB/电池，用万用表确认现有整条延长链每个针号的一一对应、无邻针短路、接触面正确，再插接屏幕/触摸。24P 接触面的文字证据尚不足以在装配图上无条件写成“铜面朝上”或“铜面朝下”；本次不杜撰这一方向。若实物延长件反序，调整线束连接方式而非改主板功能针序。

## 4. 电池、NTC、扬声器的极性

三只端子都是 **Phoenix Contact MKDS 1/2-3.5，1751248，2 位 3.5 mm 间距 THT**，不是淘宝扬声器自带的 1.25 mm 小插座，也不是 FPC 接口。必要时用线束转接，保留电池包自身的保护板。

| 接口 | 针 1 / 世界坐标 | 针 2 / 世界坐标 | 当前板上丝印 |
|---|---|---|---|
| J102 | 电池保护后正极 BAT_PACK_P，(65,151.5) | GND，(68.5,151.5) | BATT+ / GND，分别对应各针 |
| J103 | BAT_NTC，(78,151.5) | GND，(81.5,151.5) | NTC / GND，分别对应各针 |
| J801 | SPK_P，(91,55)，元件面右侧 | SPK_N，(87.5,55)，元件面左侧 | SPK:1+ 2-，与焊盘编号一致 |

扬声器是 BTL 输出，两根线都不是地，不能把负端接到电池 GND。选用 8 Ω / 2 W 3525 腔体扬声器；电池为用户选定的带保护/NTC 单节 755570，整板充电/温度配置沿用电气设计，此机械审查不提高充电电流。

Phoenix 原厂接线条件为剥线 5 mm、紧固扭矩 0.22…0.25 N·m，普通线截面 0.14…1.5 mm²；细到范围以外的扬声器线可用合适过渡线束，不能按外皮粗细判断导体截面。拧紧两位端子时从下方支撑端子/PCB，避免把螺丝刀力矩全施加到焊盘。厂商给出的可装线/紧固条件不等于已经测过所购线束。

## 5. 自行回流与后手焊：实装 230 个电气位号

| 分组 | 数量 | 本次工序 |
|---|---:|---|
| 顶层普通贴片器件 | 203 | 按本次经过独立复核的钢网印膏、贴装、回流；完整位号见下附清单及 JSON。 |
| SMD 连接器 | 4 | **J406、J501、J601、J701** 后手焊。默认钢网不为它们的信号脚或 SH 固定脚开窗，但 BOM 仍实装。这四只不是 THT 排针。 |
| THT 排针、端子和按钮 | 23 | J101、J102、J103、J104、J105、J201、J202、J203、J204、J205、J206、J401、J402、J403、J404、J405、J502、J801、SW301、SW302、SW303、SW304、SW305；回流之后手焊。 |
| DNP | 6 | **C501、C502、J301、J302、J303、R108 不装且不印膏**。尤其不能因位号在 BOM 或封装带 paste 层而自动印膏；R108 保持禁充装配状态。 |
| 机械孔 | 4 | H1—H4，不装元件、不印膏。 |

203 + 4 + 23 = 230 实装；另 6 个 DNP，共 236 电气位号。U301 是实装模块：本次按允许省略中心 EPAD 的装配方案，仅外周焊脚回流、中心 EPAD 不印膏，之后实测模块温升。这条仅适用于 U301 的选定工艺，不能套用于 U101/U201 等其他裸露焊盘器件。

建议依序完成钢网对位/印膏检查、贴装回流、显微检查、四只 SMD 接口手焊、THT 手焊、清理和断电验收。USB/FPC/SD 的细脚手焊先确认方向和共面，少量固定后复查全排，再焊余脚与固定脚；检查桥连、虚焊、塑料熔伤和翻盖活动。温度、时间按实际器件与焊料的工艺条件，不用未核实的统一手焊温度替代器件规范。

**J501 壳脚注意：**GCT USB4105-GF-A 图纸的壳脚长度为 0.95±0.15 mm，在名义 1.6 mm 板上，脚尖名义缩进底面 0.65 mm。四个 SH 固定点的孔槽分别为 0.6×1.7 / 0.6×1.4 mm，因此不能期待四脚像普通长 THT 引脚一样露出底面。后手焊要确认顶部焊盘和孔槽内壳脚实际润湿、固定壳稳固；从底面看到焊锡不等于已证明壳脚结合。完成后再做轻力试插与焊点复查。不要把 060/120 后缀的不同壳脚长度变体当作当前 GF-A 的同一采购料号。

USB 共用电源/地的物理焊盘与双编号对应，不能按“16 针必须看到 16 个独立细焊脚”判缺脚。J601/J406 的 SH 固定片都接地；检查 SH 与信号脚之间无焊桥。

CAD 辅助原点和网格原点都为 (0,0)，本报告坐标是原生封装锚点，不能假装都是封装几何重心。JSON 中的角度/位置供人工查位；本轮没有代贴需求，不生成未经适配的厂家 CPL，也不提交外部 PCBA。

## 6. 麦克风与天线

U803 在正面安装，声从板底通过 **(61,62) mm 的 Ø0.60 mm NPTH** 进入。孔周 Ø1.0 mm 禁铜区覆盖 F.Cu、In1.Cu、In2.Cu、B.Cu；逐项检查焊盘、导线、过孔及已填铜，无侵入。声孔是钻孔，不能误当普通过孔塞住；钢网是否避让声道另由本次 paste 审查确认。板底不能贴胶、堵泡棉、压线，或直接平放在实心垫板上封住声口。当前没有机壳，故没有声孔对应机壳尺寸；以后加壳时在此位置留畅通声道，并按实际孔对准/密封方式验证声学表现。

U301 天线禁布边界为 X=136…184、Y=29…50 mm，天线位于北板边外。四层铜和五类布置限制保留。外接屏幕金属背板、电池、线束、支架不要盖在这个区域；“PCB 内没有铜”不能代替整机装配时的天线周边净空。

## 7. 样板到手后的实物检查项

这些是装配验收事项，不阻止按已经批准的接口条件继续生成制造文件：

1. 对照板框/孔位置检查板件；绝缘支柱托起板底声孔，确认插拔通道和天线周边未被外接件占用。
2. 检查所有已焊器件方向、0.5 mm 信号脚、USB 四个壳脚、SD 卡座固定片；FPC 翻盖和 microSD 按压弹出应能正常动作。隐藏焊点不能仅凭外观宣称已充分润湿。
3. DNP 六个位号为空、无锡膏/锡桥，J501/J701/J601/J406 已在后手焊工序实装；U301 外周焊点良好，EPAD 留空工艺有记录。
4. USB/电池都断开时，确认现有 24P/6P 延长链的针号、接触面、无邻针短路。接线后再次确认 J102 极性、J103 NTC 与地、J801 两个 BTL 输出，没有把扬声器负极接地。
5. 确认端子实际线径、插入深度和拉脱保持，确认壳体固定脚在轻力插拔后不松动，再进入独立的限流首次上电流程。电池充电/NTC、供电峰值、U301 留空 EPAD 的温升等都在实物电气测试中验证。

## 8. 图纸证据

- 当前正式 r8 PCB 和自定义 `.kicad_mod`；与 r4 机械图纸、r7 布局证据交叉核对，不用历史报告替代本次实测。
- HOAUC HYC-2601201033 / HYCW3D-05FPCXX-200B，2014-02-23，原厂图纸由 LCSC 镜像保存：<https://datasheet.lcsc.com/datasheet/pdf/56a886dce77cc08fa7b5dcd104301290.pdf?productCode=C53436608>。
- LAILAN LAIL-FPC-CDX01-6P0.5-GW Rev A 原厂图纸：<https://datasheet.lcsc.com/datasheet/pdf/17379face50f319b31662f0dda9f609b.pdf?productCode=C55172961>。
- Hirose EDC3-325165-00（2010-06-22 修订、2016 下载归档），DM3AT-SF-PEJM5；本次检查的是已归档原厂图页，不能称为获取了最新修订。原归档镜像：<https://static.chipdip.ru/lib/505/DOC014505249.pdf>。
- GCT USB4105 图纸 B4（2023-12-18），本地 `hardware/reference/bom-r3/files/gct-usb4105.pdf`。
- Phoenix Contact 1751248 官方产品页及其尺寸图：<https://www.phoenixcontact.com/en-pc/products/pcb-terminal-block-mkds-1-2-35-1751248>。
- 大连佳显原图 GDEY075T7-T01-CAD / TP075-Y01，本地 `hardware/reference/good-display/`；PUI DMM-4026-B-I2S-R 原图，本地 `hardware/reference/peripherals/DMM-4026-B-I2S-R.pdf`。

## 附：203 个回流位号（按当前实装标志提取）

- C（56）：C101、C102、C103、C201、C202、C203、C204、C301、C302、C303、C401、C402、C403、C404、C405、C406、C407、C408、C409、C410、C411、C412、C413、C414、C415、C416、C417、C503、C601、C602、C603、C604、C605、C606、C607、C608、C609、C610、C611、C612、C701、C702、C703、C704、C705、C801、C802、C803、C804、C805、C806、C808、C901、C902、C903、C904。
- D（4）：D501、D601、D602、D603。
- F（1）：F501。
- L（2）：L201、L601。
- Q（3）：Q101、Q201、Q601。
- R（110）：R101、R102、R103、R104、R105、R106、R107、R109、R110、R111、R112、R113、R201、R202、R203、R204、R205、R206、R207、R208、R209、R210、R211、R212、R213、R214、R215、R216、R217、R218、R219、R220、R221、R222、R223、R224、R225、R226、R227、R301、R302、R303、R304、R305、R306、R401、R402、R404、R405、R407、R408、R410、R411、R413、R414、R416、R417、R418、R419、R420、R501、R502、R503、R504、R601、R602、R603、R604、R605、R606、R607、R608、R609、R610、R611、R612、R613、R614、R701、R702、R703、R704、R705、R706、R708、R710、R711、R712、R713、R714、R715、R802、R803、R804、R805、R806、R808、R809、R810、R811、R812、R813、R901、R902、R903、R904、R905、R906、R907、R908。
- U（27）：U101、U201、U202、U203、U301、U401、U402、U403、U404、U405、U406、U501、U502、U601、U602、U701、U702、U703、U704、U705、U706、U801、U802、U803、U804、U805、U901。

## 复现方式

在仓库根目录运行：

```sh
/usr/bin/python3 hardware/devboard-r0/review-r9/mechanical-check.py
/usr/bin/python3 tools/export_assembly_r9.py
```

机械几何脚本使用本机 KiCad `pcbnew` 与现有 Shapely；当前本地 Shapely 位于 `build/dfm-r9/stencil/python`（不随 Git 分发），可用 `--python-deps /已有依赖目录` 指定，或由系统 Python 提供同版本模块。`--output-directory /临时输出目录` 可在不覆盖审查 JSON 的情况下复查。脚本对正式 PCB 的固定 r8 SHA-256 先校验再只读检查；源文件发生变化会拒绝沿用本次结果。

正式装配导出 `tools/export_assembly_r9.py` 只使用 Python 标准库及系统 `pcbnew`，不依赖 Shapely。其输出目录为 `hardware/devboard-r0/output/manufacturing/r9-review/assembly/`：population.csv、reflow-positions.csv、hand-solder.csv、bom-fitted.csv、dnp.csv、assembly-summary.json。CSV 坐标统一按板左下角换算 `X=KiCadX−50, Y=160−KiCadY`，旋转仍是 KiCad 原生角度而非供料角度；候选 MPN 不代表采购冻结。CSV 提供 240 个完整位号、203 个回流定位、27 个后手焊位号、230 个实装的分组 BOM 和 6 个 DNP。
