xiaobaoaaaaaa/ESPaperPlay-V2/hardware/devboard-r0/output/manufacturing/r10-first-batch/procurement-plan.html

2026-11-14 · 准备记录 r11 / PCB 保持 r10

# 首批备料：5 块 PCB，先焊 2 块

按相同厂商、完整候选料号与封装合并采购行，保留所有位号。库存、单价、最小起订量尚未核实；以下为需求和可选备料，不是采购订单。

64种候选物料

460件装配净需求

198件可选备料

658件含备料总量

R108、C501/C502、J301/J302/J303 不装；J105 不装跳帽。先焊一块验证印膏与焊接，再做第二块。关键 MLCC 的有效容量、来料和首板验证仍需按审查记录落实。

无框钢网，胶带铰链定位；仅使用 r10 独立 DIY 钢网文件。装配查位图 · 物料闭合审查 · 首板检查 · 完整数据及来源 · 本批准备说明

搜索料号、位号、厂商或备注：
打印全部物料

显示 64 / 64 种物料

候选料号 / 厂商 | 位号 / 封装 | 单板 | 2板净需 | 可选备料 | 含备料 | 来料与装配备注
C2012X7R1E475K125AB TDK | C101 / C409 / C603 Capacitor_SMD:C_0805_2012Metric | 3 | 6 | 5 | 11 | 关键MLCC：按关键电容审查落实有效容量；不能仅凭标称容量替代偏压审核
C3216X5R1C106K160AA TDK | C102 / C103 / C201 Capacitor_SMD:C_1206_3216Metric | 3 | 6 | 5 | 11 | 关键MLCC：按关键电容审查落实有效容量；不能仅凭标称容量替代偏压审核
C3216X5R1C226M160AB TDK | C202 / C403 / C406 / C415 Capacitor_SMD:C_1206_3216Metric | 4 | 8 | 5 | 13 | 关键MLCC：按关键电容审查落实有效容量；不能仅凭标称容量替代偏压审核
C1608X7R1H104K080AA TDK | C203 / C204 / C302 / C416 / C417 / C503 / C611 / C612 / C701 / C703 / C705 / C801 / C802 / C804 / C806 / C808 / C901 Capacitor_SMD:C_0603_1608Metric | 17 | 34 | 5 | 39 | 核对准确料号、封装及来料状态
C2012X7R1A106K125AC TDK | C301 / C702 / C803 Capacitor_SMD:C_0805_2012Metric | 3 | 6 | 5 | 11 | 核对准确料号、封装及来料状态
C1608X7R1C105K080AC TDK | C303 / C401 / C404 / C407 / C410 / C412 / C413 / C805 Capacitor_SMD:C_0603_1608Metric | 8 | 16 | 5 | 21 | 核对准确料号、封装及来料状态
C1608C0G1H472J080AA TDK | C402 / C405 / C408 / C411 / C414 Capacitor_SMD:C_0603_1608Metric | 5 | 10 | 5 | 15 | 核对准确料号、封装及来料状态
GRM31CR71H475KA12L Murata | C601 / C602 / C604 / C607 / C608 / C609 Capacitor_SMD:C_1206_3216Metric | 6 | 12 | 5 | 17 | 关键MLCC：按关键电容审查落实有效容量；不能仅凭标称容量替代偏压审核
C2012X7R1H105K125AB TDK | C605 / C606 / C610 Capacitor_SMD:C_0805_2012Metric | 3 | 6 | 5 | 11 | 关键MLCC：按关键电容审查落实有效容量；不能仅凭标称容量替代偏压审核
C1608C0G1H103J080AA TDK | C704 / C902 / C903 / C904 Capacitor_SMD:C_0603_1608Metric | 4 | 8 | 5 | 13 | 核对准确料号、封装及来料状态
SMAJ6.0A Alpha and Omega Semiconductor | D501 Diode_SMD:D_SMA | 1 | 2 | 1 | 3 | 核对准确料号、封装及来料状态
MBR0530T1G onsemi | D601 / D602 / D603 Diode_SMD:D_SOD-123 | 3 | 6 | 1 | 7 | 核对准确料号、封装及来料状态
MF-MSMF200/16X-2 Bourns | F501 ESPaperPlay:Bourns_MF-MSMF_1812_Style2 | 1 | 2 | 1 | 3 | 核对准确料号、封装及来料状态
61300211121 Würth Elektronik | J101 / J104 / J105 / J201 / J203 / J204 / J401 / J402 / J403 / J404 / J405 ESPaperPlay:WR_PHD_1x02_P2.54_Drill1.10 | 11 | 22 | 1 | 23 | J105可焊排针但不得装跳帽；J104也保持开放
1751248 Phoenix Contact | J102 / J103 / J801 ESPaperPlay:PhoenixContact_MKDS-1-2-3.5_1751248_1x02_P3.50mm_Horizontal | 3 | 6 | 1 | 7 | 核对准确料号、封装及来料状态
61300311121 Würth Elektronik | J202 / J502 ESPaperPlay:WR_PHD_1x03_P2.54_Drill1.10 | 2 | 4 | 1 | 5 | 核对准确料号、封装及来料状态
61300611121 Würth Elektronik | J205 / J206 ESPaperPlay:WR_PHD_1x06_P2.54_Drill1.10 | 2 | 4 | 1 | 5 | 核对准确料号、封装及来料状态
LAIL-FPC-CDX01-6P0.5-GW LAILAN | J406 ESPaperPlay:LAILAN_LAIL-FPC-CDX01-6P0.5-GW_1x06_P0.50mm_SH | 1 | 2 | 1 | 3 | 实物核对0.5mm间距、接触面、1脚和延长排线通断；回流后手焊
USB4105-GF-A GCT | J501 Connector_USB:USB_C_Receptacle_GCT_USB4105-xx-A_16P_TopMnt_Horizontal | 1 | 2 | 1 | 3 | 核对准确料号、封装及来料状态
HYCW3D-05FPC24-200B HOAUC | J601 ESPaperPlay:HOAUC_HYCW3D-05FPC24-200B_1x24_P0.50mm_SH | 1 | 2 | 1 | 3 | 实物核对0.5mm间距、接触面、1脚和延长排线通断；回流后手焊
DM3AT-SF-PEJM5 Hirose | J701 Connector_Card:microSD_HC_Hirose_DM3AT-SF-PEJM5 | 1 | 2 | 1 | 3 | 核对准确料号、封装及来料状态
XFL4015-471MEC Coilcraft | L201 ESPaperPlay:Coilcraft_XFL4015_4x4mm | 1 | 2 | 1 | 3 | 核对准确料号、封装及来料状态
SRN4018-100M Bourns | L601 Inductor_SMD:L_Bourns-SRN4018 | 1 | 2 | 1 | 3 | 核对准确料号、封装及来料状态
AO3400A Alpha and Omega Semiconductor | Q101 / Q201 ESPaperPlay:AOS_SOT23_PO00001N | 2 | 4 | 1 | 5 | 核对准确料号、封装及来料状态
Si1308EDL-T1-GE3 Vishay Siliconix | Q601 ESPaperPlay:Vishay_SC70_3_AN826_72601 | 1 | 2 | 1 | 3 | 核对准确料号、封装及来料状态
CRF0805-J/-000ELF Bourns | R101 / R102 / R203 / R402 / R405 / R408 / R411 / R414 ESPaperPlay:Bourns_CRF0805_Jumper | 8 | 16 | 5 | 21 | 测流断点用金属低阻跳线；不可按普通0603零欧替换
CRCW06031K62FKEA Vishay | R103 Resistor_SMD:R_0603_1608Metric | 1 | 2 | 5 | 7 | 核对准确料号、封装及来料状态
CRCW06031K27FKEA Vishay | R104 / R113 Resistor_SMD:R_0603_1608Metric | 2 | 4 | 5 | 9 | 核对准确料号、封装及来料状态
CRCW060368K0FKEA Vishay | R105 Resistor_SMD:R_0603_1608Metric | 1 | 2 | 5 | 7 | 核对准确料号、封装及来料状态
CRCW060347K0FKEA Vishay | R106 / R222 / R303 / R304 / R305 / R901 Resistor_SMD:R_0603_1608Metric | 6 | 12 | 5 | 17 | 核对准确料号、封装及来料状态
CRCW0603100KFKEA Vishay | R107 / R109 / R110 / R111 / R112 / R204 / R206 / R207 / R209 / R212 / R213 / R214 / R216 / R219 / R220 / R224 / R225 / R226 / R227 / R419 / R420 / R608 / R609 / R610 / R611 / R612 / R613 / R614 / R706 / R802 / R803 / R804 / R805 / R813 / R902 / R904 Resistor_SMD:R_0603_1608Metric | 36 | 72 | 8 | 80 | 核对准确料号、封装及来料状态
TNPW060351K1BEEA Vishay | R201 Resistor_SMD:R_0603_1608Metric | 1 | 2 | 5 | 7 | 保持0.1% / 25ppm反馈精度，不以普通1%替换
TNPW06039K10BEEA Vishay | R202 Resistor_SMD:R_0603_1608Metric | 1 | 2 | 5 | 7 | 保持0.1% / 25ppm反馈精度，不以普通1%替换
CRCW06031M00FKEA Vishay | R205 / R601 Resistor_SMD:R_0603_1608Metric | 2 | 4 | 5 | 9 | 核对准确料号、封装及来料状态
CRCW060310K0FKEA Vishay | R208 / R215 / R221 / R223 / R301 / R302 / R306 / R416 / R417 / R418 / R701 / R702 / R703 / R704 / R705 / R906 Resistor_SMD:R_0603_1608Metric | 16 | 32 | 5 | 37 | 核对准确料号、封装及来料状态
CRCW06034K70FKEA Vishay | R210 / R211 Resistor_SMD:R_0603_1608Metric | 2 | 4 | 5 | 9 | 核对准确料号、封装及来料状态
CRCW06030000Z0EA Vishay | R217 / R218 / R711 / R712 / R713 / R714 / R715 Resistor_SMD:R_0603_1608Metric | 7 | 14 | 5 | 19 | 核对准确料号、封装及来料状态
CRCW0603330RFKEA Vishay | R401 / R404 / R407 / R410 / R413 Resistor_SMD:R_0603_1608Metric | 5 | 10 | 5 | 15 | 核对准确料号、封装及来料状态
CRCW06035K10FKEA Vishay | R501 / R502 Resistor_SMD:R_0603_1608Metric | 2 | 4 | 5 | 9 | 核对准确料号、封装及来料状态
CRCW060322R0FKEA Vishay | R503 / R504 / R710 / R808 / R809 / R810 Resistor_SMD:R_0603_1608Metric | 6 | 12 | 5 | 17 | 核对准确料号、封装及来料状态
WFMB2010R4700FEA Vishay Dale | R602 ESPaperPlay:Vishay_WFM2010_5.08x2.54mm | 1 | 2 | 5 | 7 | 核对准确料号、封装及来料状态
CRCW060333R0FKEA Vishay | R603 / R604 / R605 / R606 / R607 Resistor_SMD:R_0603_1608Metric | 5 | 10 | 5 | 15 | 核对准确料号、封装及来料状态
CRCW0603100RFKEA Vishay | R708 Resistor_SMD:R_0603_1608Metric | 1 | 2 | 5 | 7 | 核对准确料号、封装及来料状态
CRCW06032K00FKEA Vishay | R806 Resistor_SMD:R_0603_1608Metric | 1 | 2 | 5 | 7 | 核对准确料号、封装及来料状态
CRCW08050000Z0EA Vishay | R811 / R812 Resistor_SMD:R_0805_2012Metric | 2 | 4 | 5 | 9 | 核对准确料号、封装及来料状态
CRCW060312K0FKEA Vishay | R903 Resistor_SMD:R_0603_1608Metric | 1 | 2 | 5 | 7 | 核对准确料号、封装及来料状态
CRCW060333K0FKEA Vishay | R905 Resistor_SMD:R_0603_1608Metric | 1 | 2 | 5 | 7 | 核对准确料号、封装及来料状态
CRCW0603330KFKEA Vishay | R907 / R908 Resistor_SMD:R_0603_1608Metric | 2 | 4 | 5 | 9 | 核对准确料号、封装及来料状态
B3F-1002-G Omron | SW301 / SW302 / SW303 / SW304 / SW305 Button_Switch_THT:SW_PUSH_6mm | 5 | 10 | 1 | 11 | 核对准确料号、封装及来料状态
BQ24074RGTR Texas Instruments | U101 ESPaperPlay:TI_RGT0016C_VQFN_3x3mm_P0.5mm_EP1.68mm | 1 | 2 | 1 | 3 | 核对准确料号、封装及来料状态
TPS63802DLAR Texas Instruments | U201 ESPaperPlay:TI_DLA0010A_VSON-HR_2x3mm_P0.5mm | 1 | 2 | 1 | 3 | 核对准确料号、封装及来料状态
TCA9539PWR Texas Instruments | U202 Package_SO:TSSOP-24_4.4x7.8mm_P0.65mm | 1 | 2 | 1 | 3 | 核对准确料号、封装及来料状态
MAX17048G+T10 Analog Devices / Maxim Integrated | U203 Package_DFN_QFN:TDFN-8-1EP_2x2mm_P0.5mm_EP0.8x1.2mm | 1 | 2 | 1 | 3 | 核对准确料号、封装及来料状态
ESP32-S3-WROOM-1-N16R8 Espressif Systems | U301 RF_Module:ESP32-S3-WROOM-1 | 1 | 2 | 0 | 2 | 核对准确料号、封装及来料状态
TPS22918DBVR Texas Instruments | U401 / U402 / U403 / U404 / U405 Package_TO_SOT_SMD:SOT-23-6 | 5 | 10 | 1 | 11 | 核对准确料号、封装及来料状态
TMUX1511PWR Texas Instruments | U406 / U701 / U706 Package_SO:TSSOP-14_4.4x5mm_P0.65mm | 3 | 6 | 1 | 7 | 核对准确料号、封装及来料状态
TPD2E2U06DCKR Texas Instruments | U501 / U502 / U702 / U703 / U704 / U705 ESPaperPlay:TI_DCK0003A_SC70_3_Recommended | 6 | 12 | 1 | 13 | 核对准确料号、封装及来料状态
SN74LVC541APWR Texas Instruments | U601 Package_SO:TSSOP-20_4.4x6.5mm_P0.65mm | 1 | 2 | 1 | 3 | 核对准确料号、封装及来料状态
SN74LVC1G125DBVR Texas Instruments | U602 / U804 Package_TO_SOT_SMD:SOT-23-5 | 2 | 4 | 1 | 5 | 核对准确料号、封装及来料状态
74LVC125APW,118 Nexperia | U801 Package_SO:TSSOP-14_4.4x5mm_P0.65mm | 1 | 2 | 1 | 3 | 固定Nexperia 74LVC125APW,118；不能直接按同名TI系列代换
MAX98357AETE+T Analog Devices / Maxim Integrated | U802 ESPaperPlay:Analog_MAX98357A_T1633-4_3x3mm_P0.5mm_EP1.23mm | 1 | 2 | 1 | 3 | 核对准确料号、封装及来料状态
DMM-4026-B-I2S-R PUI Audio | U803 ESPaperPlay:PUI_DMM_4026_B_I2S_R_7Pad_NPTH0.60 | 1 | 2 | 1 | 3 | 核对生命周期、可采购原包装及干燥/回流条件；首测48kHz/64fs
SN74LVC1G14DBVR Texas Instruments | U805 Package_TO_SOT_SMD:SOT-23-5 | 1 | 2 | 1 | 3 | 核对准确料号、封装及来料状态
TLV1822DR Texas Instruments | U901 ESPaperPlay:TI_D0008A_SOIC8 | 1 | 2 | 1 | 3 | 核对准确料号、封装及来料状态

备料规则：电阻/电容取 max(5，需求量的10%向上取整)；其他每种加1件，ESP32模组不预加。均可按库存调整，未计供应商MOQ。两板另需4个2.54mm跳帽，可备2个；现有屏幕/延长件与扬声器可逐板复用。首测所需仪器、线材和锡膏见完整数据。合计不含DNP、机械孔、跳帽及外接件。
