xiaobaoaaaaaa/ESPaperPlay-V2/hardware/devboard-r0/output/manufacturing/r10-review/assembly/assembly-map.html

# ESPaperPlay r10 · 装配查位

240 位号 · 203 回流 · 27 后手焊 · 6 DNP · 4 安装孔｜元件面顶视图

用于查找封装锚点，不是 1:1 装配定位模板，也不是贴片机文件。候选料号尚未采购冻结；角度保留 KiCad 原生定义。

搜索 工序 清除条件

缩放 100% 显示全部位号

回流SMD 接口手焊THT 手焊DNP安装孔

点为原生封装锚点，不一定是元件几何中心。网格 10 mm；实际焊盘、器件外形及针 1 标记请对照正式 PCB。点击地图或右侧位号查看详情。

## 位号详情

点选地图或下方清单中的位号。

## 匹配清单

来源：冻结 r10 PCB SHA-256 e7be650716b6b75f3b8d33ccc13a1d7717db9a022a3d4e6a25f0df748bae1a24。全部数据嵌入本文件，可离线打开。完整 population.csv · 手焊清单 · DNP 清单
本图不替代钢网、机械尺寸、焊点及首次上电检查；U301 外围回流，中心 EPAD 按本次工艺不印膏。
