xiaobaoaaaaaa/ESPaperPlay-V2/hardware/devboard-r0/output/manufacturing/r10-review/previews/cam-bottom.png

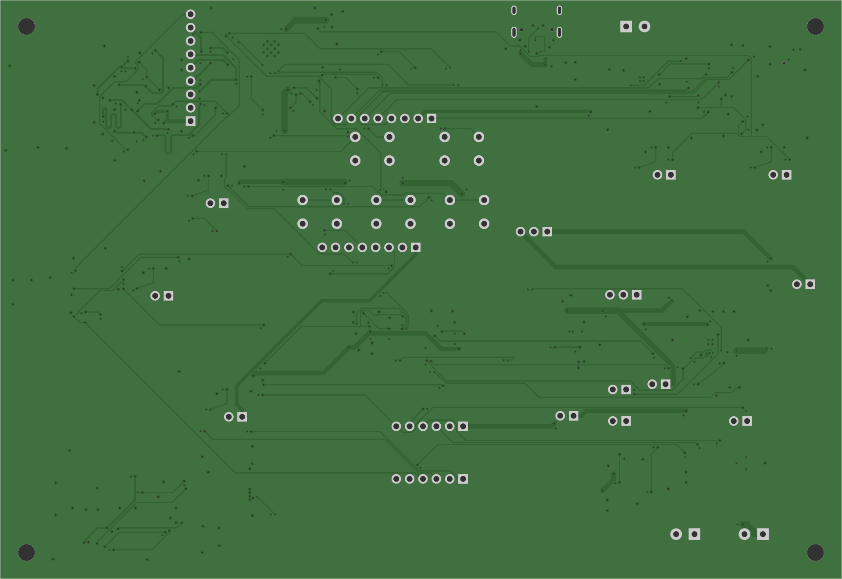
hardware/devboard-r0/output/manufacturing/r10-review/previews/cam-bottom.png
