xiaobaoaaaaaa/ESPaperPlay-V2/hardware/devboard-r0/output/manufacturing/r10-review/previews/cam-top.png

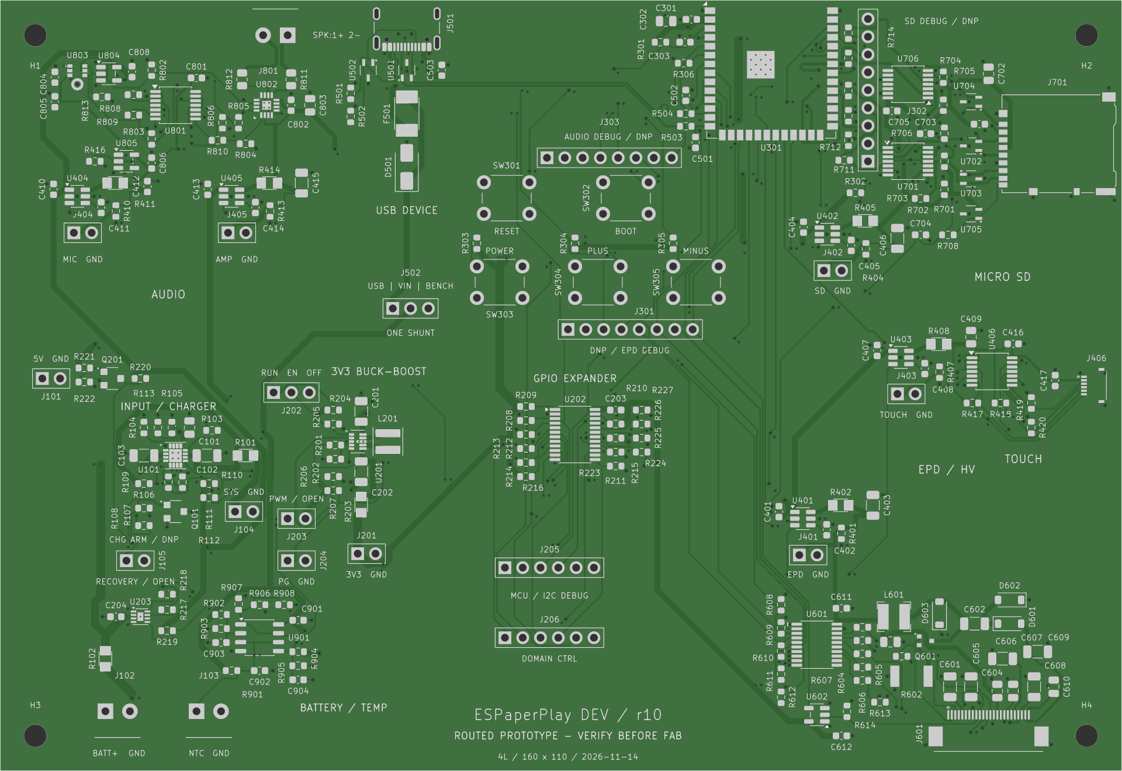
hardware/devboard-r0/output/manufacturing/r10-review/previews/cam-top.png
