xiaobaoaaaaaa/ESPaperPlay-V2/hardware/devboard-r0/review-r10/validation-summary.md

# r10 独立几何、信号与电源复核

对象为正式PCB，SHA-256 `e7be650716b6b75f3b8d33ccc13a1d7717db9a022a3d4e6a25f0df748bae1a24`。对比r8基线`1a4556d866cc1352a2c45b674c94d2f233edf28c3e003bd96c8f6caf1e630681`。

`check_r10_delta.py`未导入布线生成器。它逐UUID解析原生坐标、形状、层、孔径、网络、焊膏/阻焊、字段与属性，以数值语义比较而非仅文件哈希比较。240个封装及全部焊盘/属性/UUID完整保持；64个过孔和原来精确与它们连接的67段导线调整，没有新增/删除段或过孔。只允许R213/R214对应两孔从.60/.30改.45/.20；其余via除位置外不变。11个IC热孔、U301十二个热孔、原理图/项目/库文件均受固定来源合同保护。

板级只允许指定标题/日期/修订、第一条说明和两处r10丝印文本；其他丝印和板框不变。两内层仍各自单一连续GND填铜区。重铺铜差异局限于目标孔旧/新反焊盘邻域；邻域外极小折线舍入同时受面积≤1e-6mm²、距原/新边界≤2nm约束。额外0.1×0.1mm远离改动区的挖孔会被几何负对照拒绝；额外0.01mm USB段移动的实际PCB副本也被UUID/几何负对照拒绝。

信号路径复算：USB完整结果与r8相同；SD只有D0主路径从50.358461mm缩短至50.302006mm（-0.056455mm），转层次数和调试支路长度不变。全部SD主路径在50.8mm内部目标内，最大相对CLK偏差仍0.806237mm。D0/D1原有19.212656/13.545741mm调试支路没有被此次工艺优化修复；此结论不是信号完整性或时序认证。

21条电源路径的完整计算结果及假设与r8一致，无新断路或新线宽发现；SYS与AMP两条原有短窄段长度提示继续保留，不能把REVIEW_REQUIRED隐藏成热/功率验证通过。孔铜20µm仍是既有预算假设。

对219个非GND过孔逐一计算最近GND过孔的中心距。最终没有新超过内部2mm目标的点；仅既有IOX_RESET_N约2.1464mm、USB_DP_PORT约2.28965mm保留，距离未变。中间候选新增的EPD_EN及3V3_AON超标在最终版已通过调整既有GND via消除，没有新增过孔。详见return-via-comparison.csv与delta-check.json。中心距只检查几何，不是回流电感或阻抗保证。

原生结构检查通过236电气器件、181网络、774逻辑引脚、804编号焊盘、38封装库。该报告未带入root单独运行的最终DRC，因此其中native_drc.checked=false是如实的职责分离，最终DRC以主检查记录为准。
