xiaobaoaaaaaa/ESPaperPlay-V2/hardware/devboard-r0/output/pdf/ESPaperPlay_Devboard_Modules_r6.pdf

1 | 2 | 3 | 4 | 5 | 6 | 7 | 8

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
Size: A3 | Rev: r6 DRAWING | F Date: 2026-11-05
KiCad E.D.A. 10.0.7 | Id: 1/11

# Title: ESPaperPlay DEVELOPMENT BOARD - PERIPHERAL DRAFT

## File: ESPaperPlay_Devboard.kicad_sch

## Sheet: /

## ESPaperPlay / xiaobaoaaaaaa

## DESIGN REVIEW ONLY - NO PCB RELEASE / NO BATTERY CHARGE APPROVAL

CHARGE_TEMP 文件: CHARGE_TEMP.kicad_sch

POWER_INPUT_CHARGER 文件: POWER_INPUT_CHARGER.kicad_sch | POWER_3V3_CONTROL 文件: POWER_3V3_CONTROL.kicad_sch | MCU_CORE 文件: MCU_CORE.kicad_sch STORAGE_SD 文件: STORAGE_SD.kicad_sch

TOUCH_ISOLATION 文件: TOUCH_ISOLATION.kicad_sch

EPD_DISPLAY 文件: EPD_DISPLAY.kicad_sch

# AUDIO 文件: AUDIO.kicad_sch

POWER_DOMAINS 文件: POWER_DOMAINS.kicad_sch USB_INPUT 文件: USB_INPUT.kicad_sch | Five switched power domains NTC window / hardware TS pause

Regulator / IO expander / gauge

0.70A nominal; external NTC window uses an assumed Honeywell curve. R108 stays DNP; J105 open. No charging or manufacturing release. J502 and J202 each use ONE shunt. Actual pack R-T / thermal tests pending. r6 redraw preserves r5 values, candidate parts, UUIDs and all pin connections. microSD / bus isolation / detect ASSEMBLY / REVIEW BOUNDARIES

## ESPaperPlay / DEVELOPMENT BOARD r6

hardware/devboard-r0/README.md / docs/v2/hardware/power-design-spec.md

UC8179 / boost / 24-pin FPC USB-C / protection / source select

# I2S amplifier / microphone GT911 four-signal isolation

Input / charger / battery | N16R8 / reset / user keys Ten functional sheets. Wired functional modules; r5 electrical design unchanged. ESP32-S3-WROOM-1-N16R8 / GDEY075T7-T01 / protected 1-cell battery

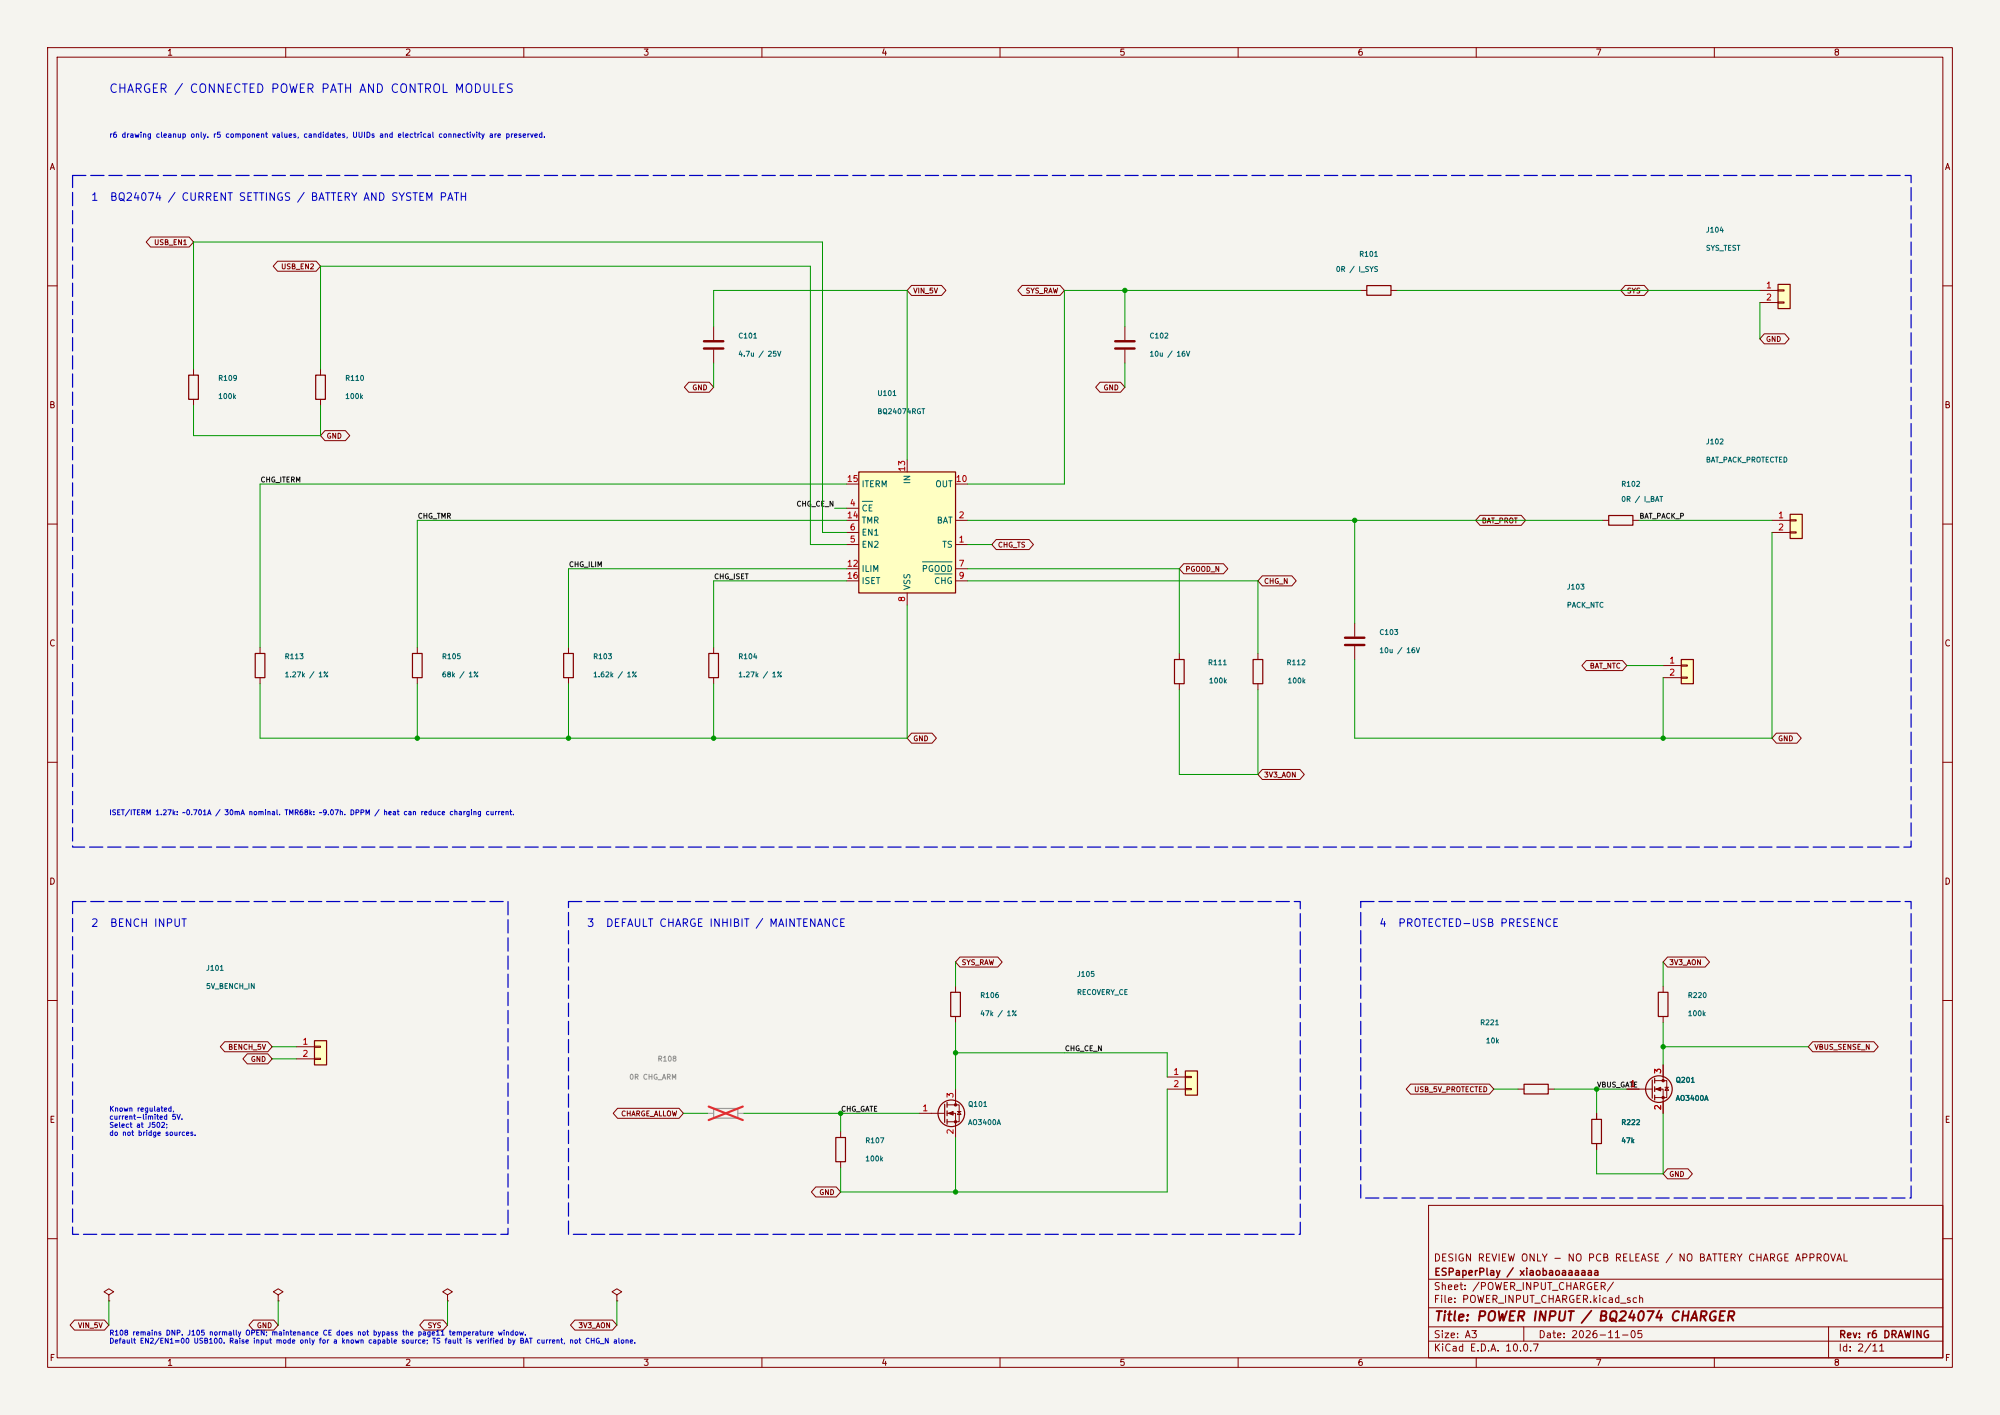
[picture p37: page 2]

CHARGER / CONNECTED POWER PATH AND CONTROL MODULES

r6 drawing cleanup only. r5 component values, candidates, UUIDs and electrical connectivity are preserved.

1 BQ24074 / CURRENT SETTINGS / BATTERY AND SYSTEM PATH

BAT_PACK_P 3 DEFAULT CHARGE INHIBIT / MAINTENANCE

DESIGN REVIEW ONLY - NO PCB RELEASE / NO BATTERY CHARGE APPROVAL
ESPaperPlay / xiaobaoaaaaaa
Sheet: /POWER_INPUT_CHARGER/
File: POWER_INPUT_CHARGER.kicad_sch
Title: POWER INPUT / BQ24074 CHARGER

R108 remains DNP. J105 normally OPEN; maintenance CE does not bypass the page11 temperature window. Default EN2/EN1=00 USB100. Raise input mode only for a known capable source; TS fault is verified by BAT current, not CHG_N alone.

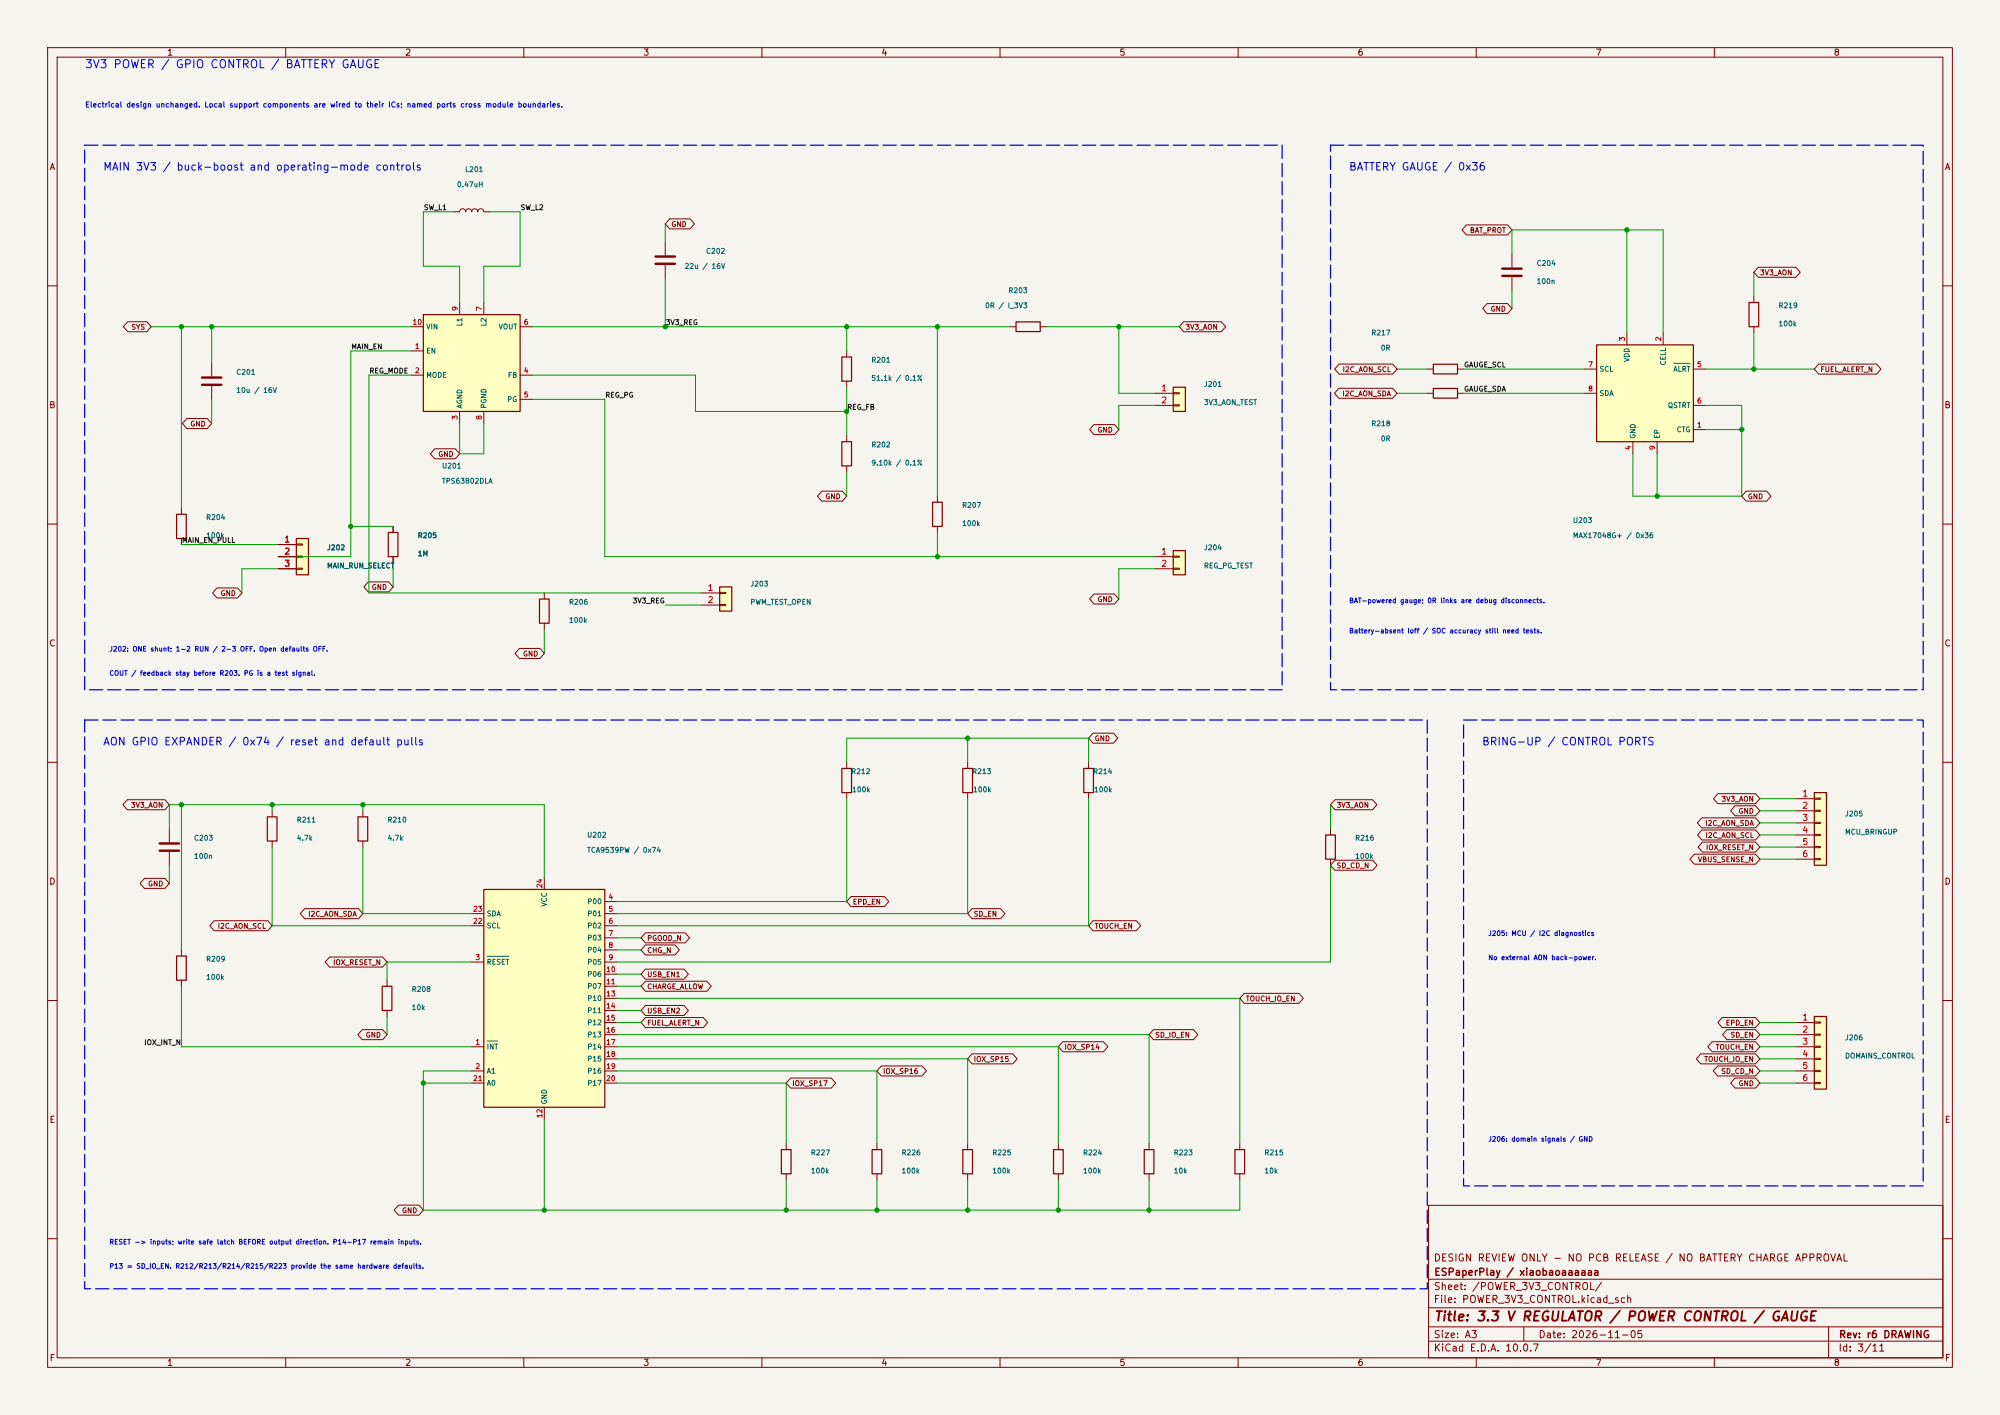
[picture p38: page 3]

3V3 POWER / GPIO CONTROL / BATTERY GAUGE

Electrical design unchanged. Local support components are wired to their ICs; named ports cross module boundaries. MAIN 3V3 / buck-boost and operating-mode controls

BAT-powered gauge; 0R links are debug disconnects. Battery-absent Ioff / SOC accuracy still need tests. J202 MAIN_RUN_SELECT 1

COUT / feedback stay before R203. PG is a test signal. AON GPIO EXPANDER / 0x74 / reset and default pulls

RESET -> inputs; write safe latch BEFORE output direction. P14-P17 remain inputs. P13 = SD_IO_EN. R212/R213/R214/R215/R223 provide the same hardware defaults.

DESIGN REVIEW ONLY - NO PCB RELEASE / NO BATTERY CHARGE APPROVAL
ESPaperPlay / xiaobaoaaaaaa
Sheet: /POWER_3V3_CONTROL/
File: POWER_3V3_CONTROL.kicad_sch
Title: 3.3 V REGULATOR / POWER CONTROL / GAUGE

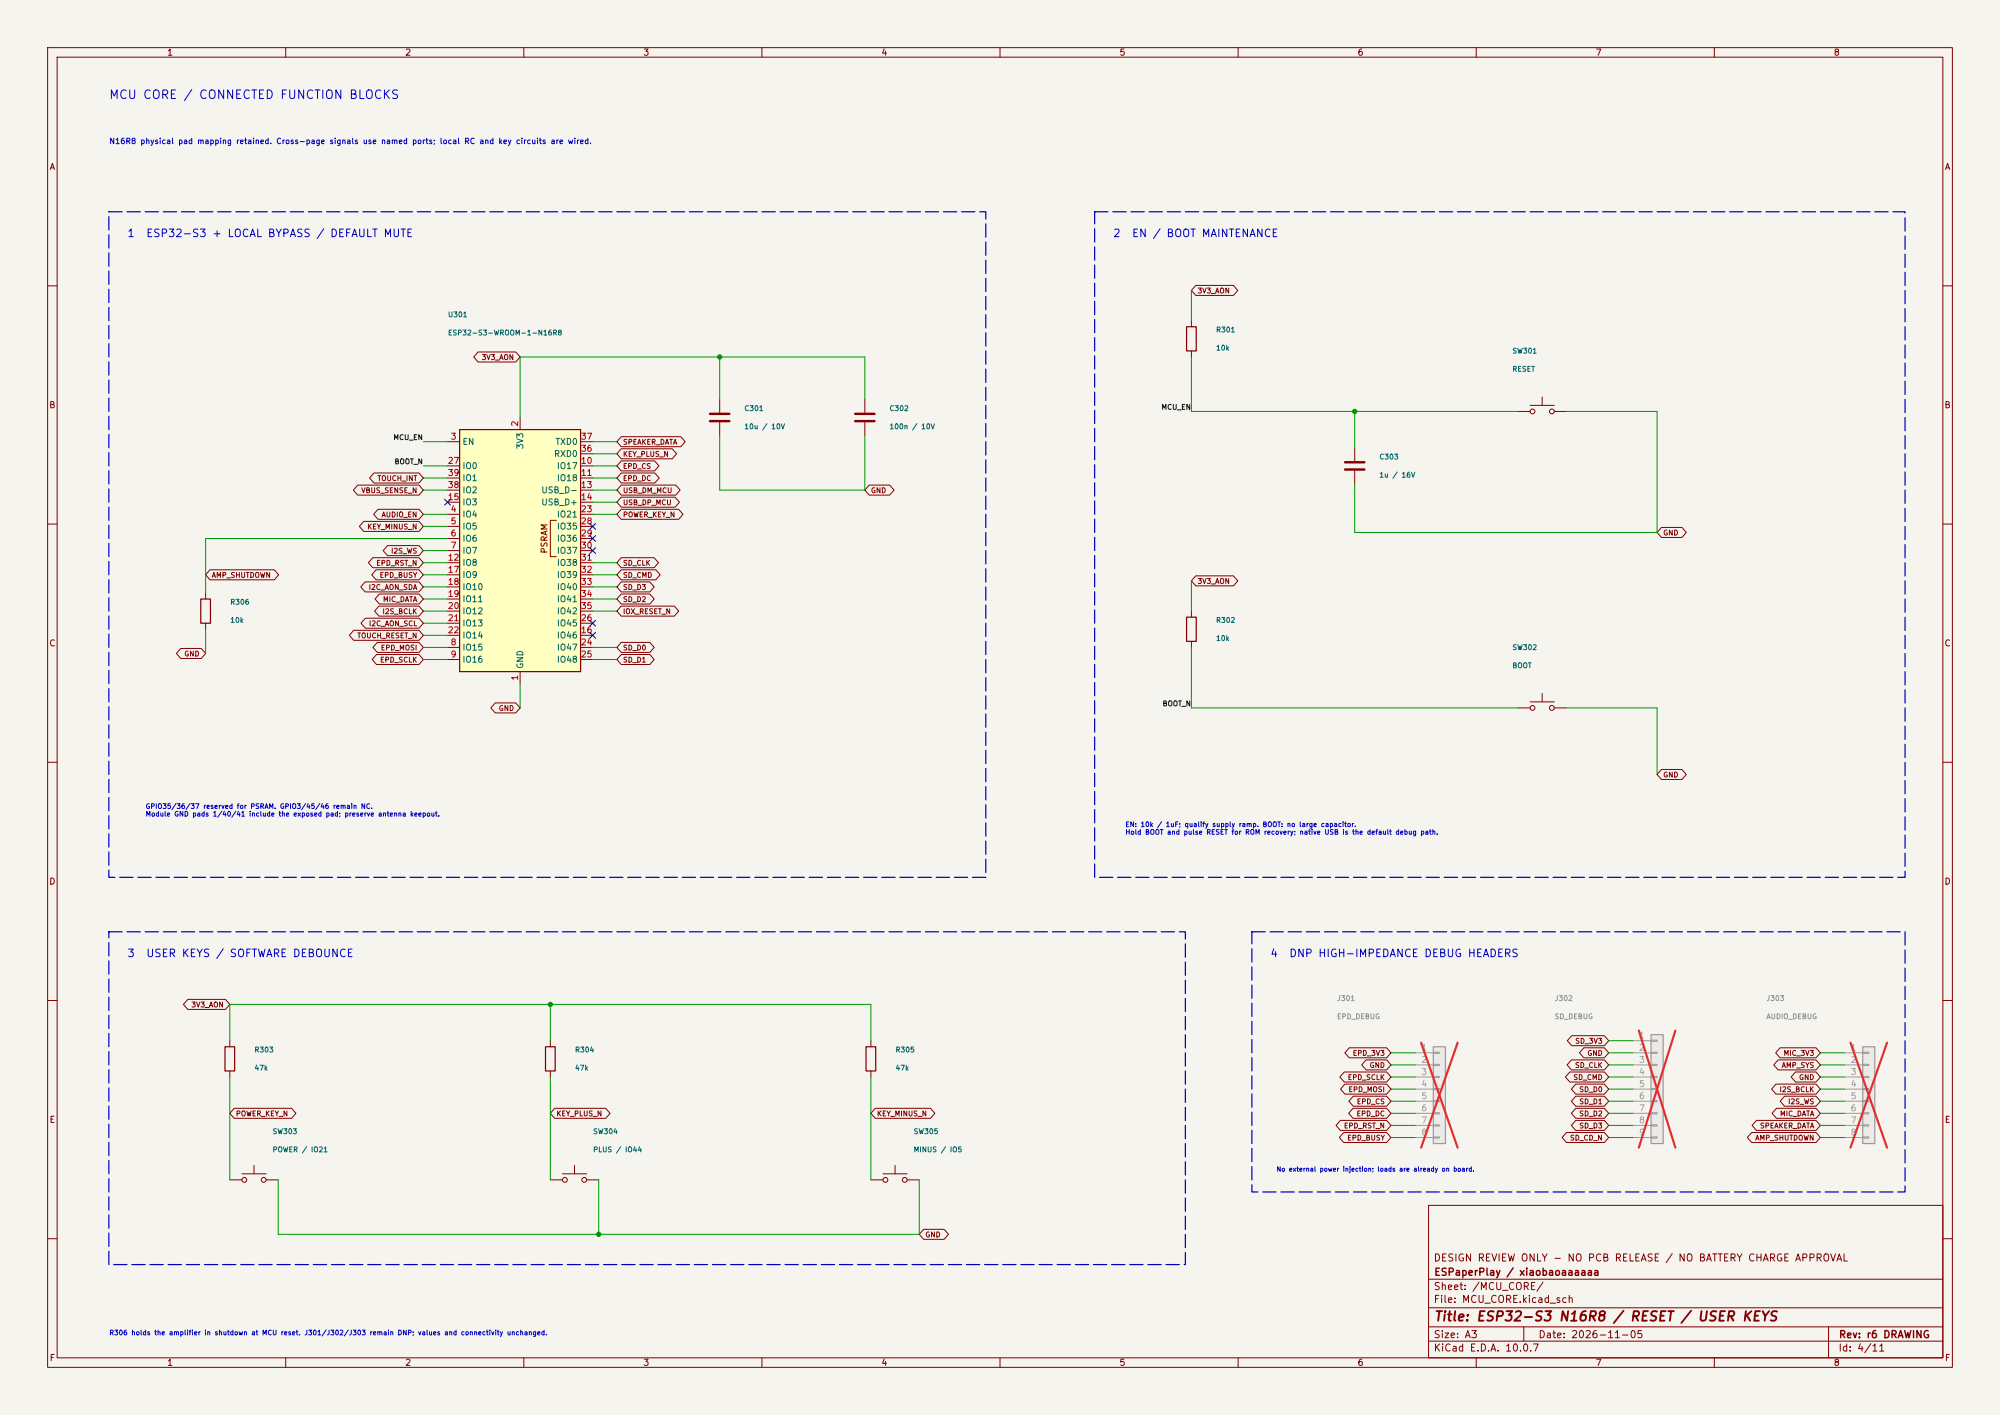
[picture p39: page 4]

MCU CORE / CONNECTED FUNCTION BLOCKS

BOOT_N 3 USER KEYS / SOFTWARE DEBOUNCE

EN: 10k / 1uF; qualify supply ramp. BOOT: no large capacitor. Hold BOOT and pulse RESET for ROM recovery; native USB is the default debug path.

No external power injection; loads are already on board.

DESIGN REVIEW ONLY - NO PCB RELEASE / NO BATTERY CHARGE APPROVAL
ESPaperPlay / xiaobaoaaaaaa
Sheet: /MCU_CORE/
File: MCU_CORE.kicad_sch
Title: ESP32-S3 N16R8 / RESET / USER KEYS

R306 holds the amplifier in shutdown at MCU reset. J301/J302/J303 remain DNP; values and connectivity unchanged.

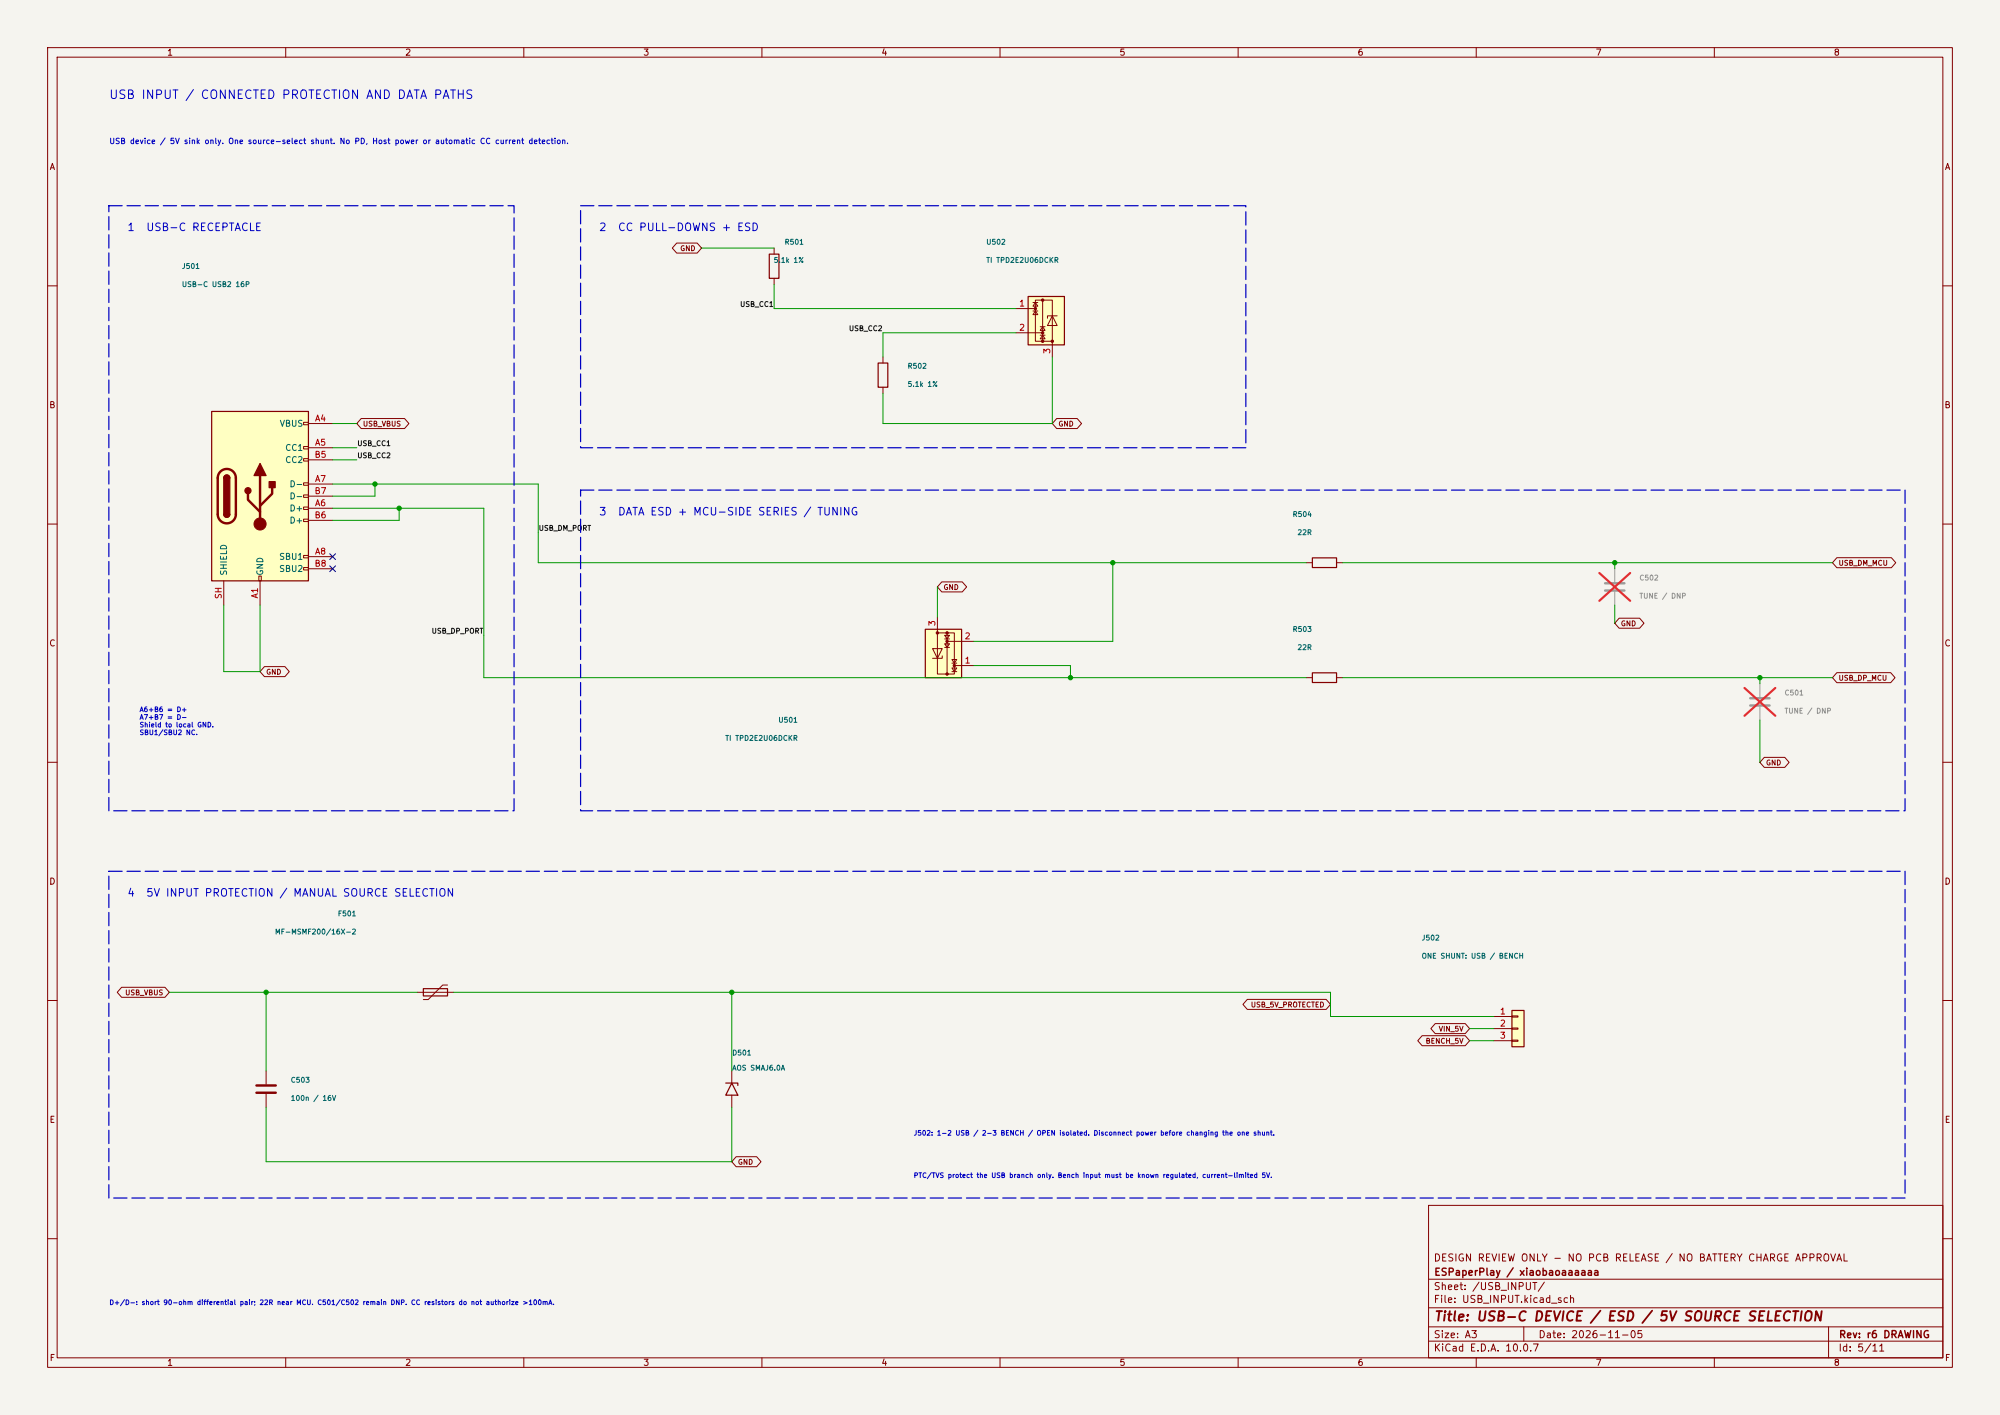
[picture p40: page 5]

USB INPUT / CONNECTED PROTECTION AND DATA PATHS

2 CC PULL-DOWNS + ESD

DESIGN REVIEW ONLY - NO PCB RELEASE / NO BATTERY CHARGE APPROVAL GND A1

J502 ONE SHUNT: USB / BENCH

J502: 1-2 USB / 2-3 BENCH / OPEN isolated. Disconnect power before changing the one shunt.

ESPaperPlay / xiaobaoaaaaaa
Sheet: /USB_INPUT/
File: USB_INPUT.kicad_sch
Title: USB-C DEVICE / ESD / 5V SOURCE SELECTION

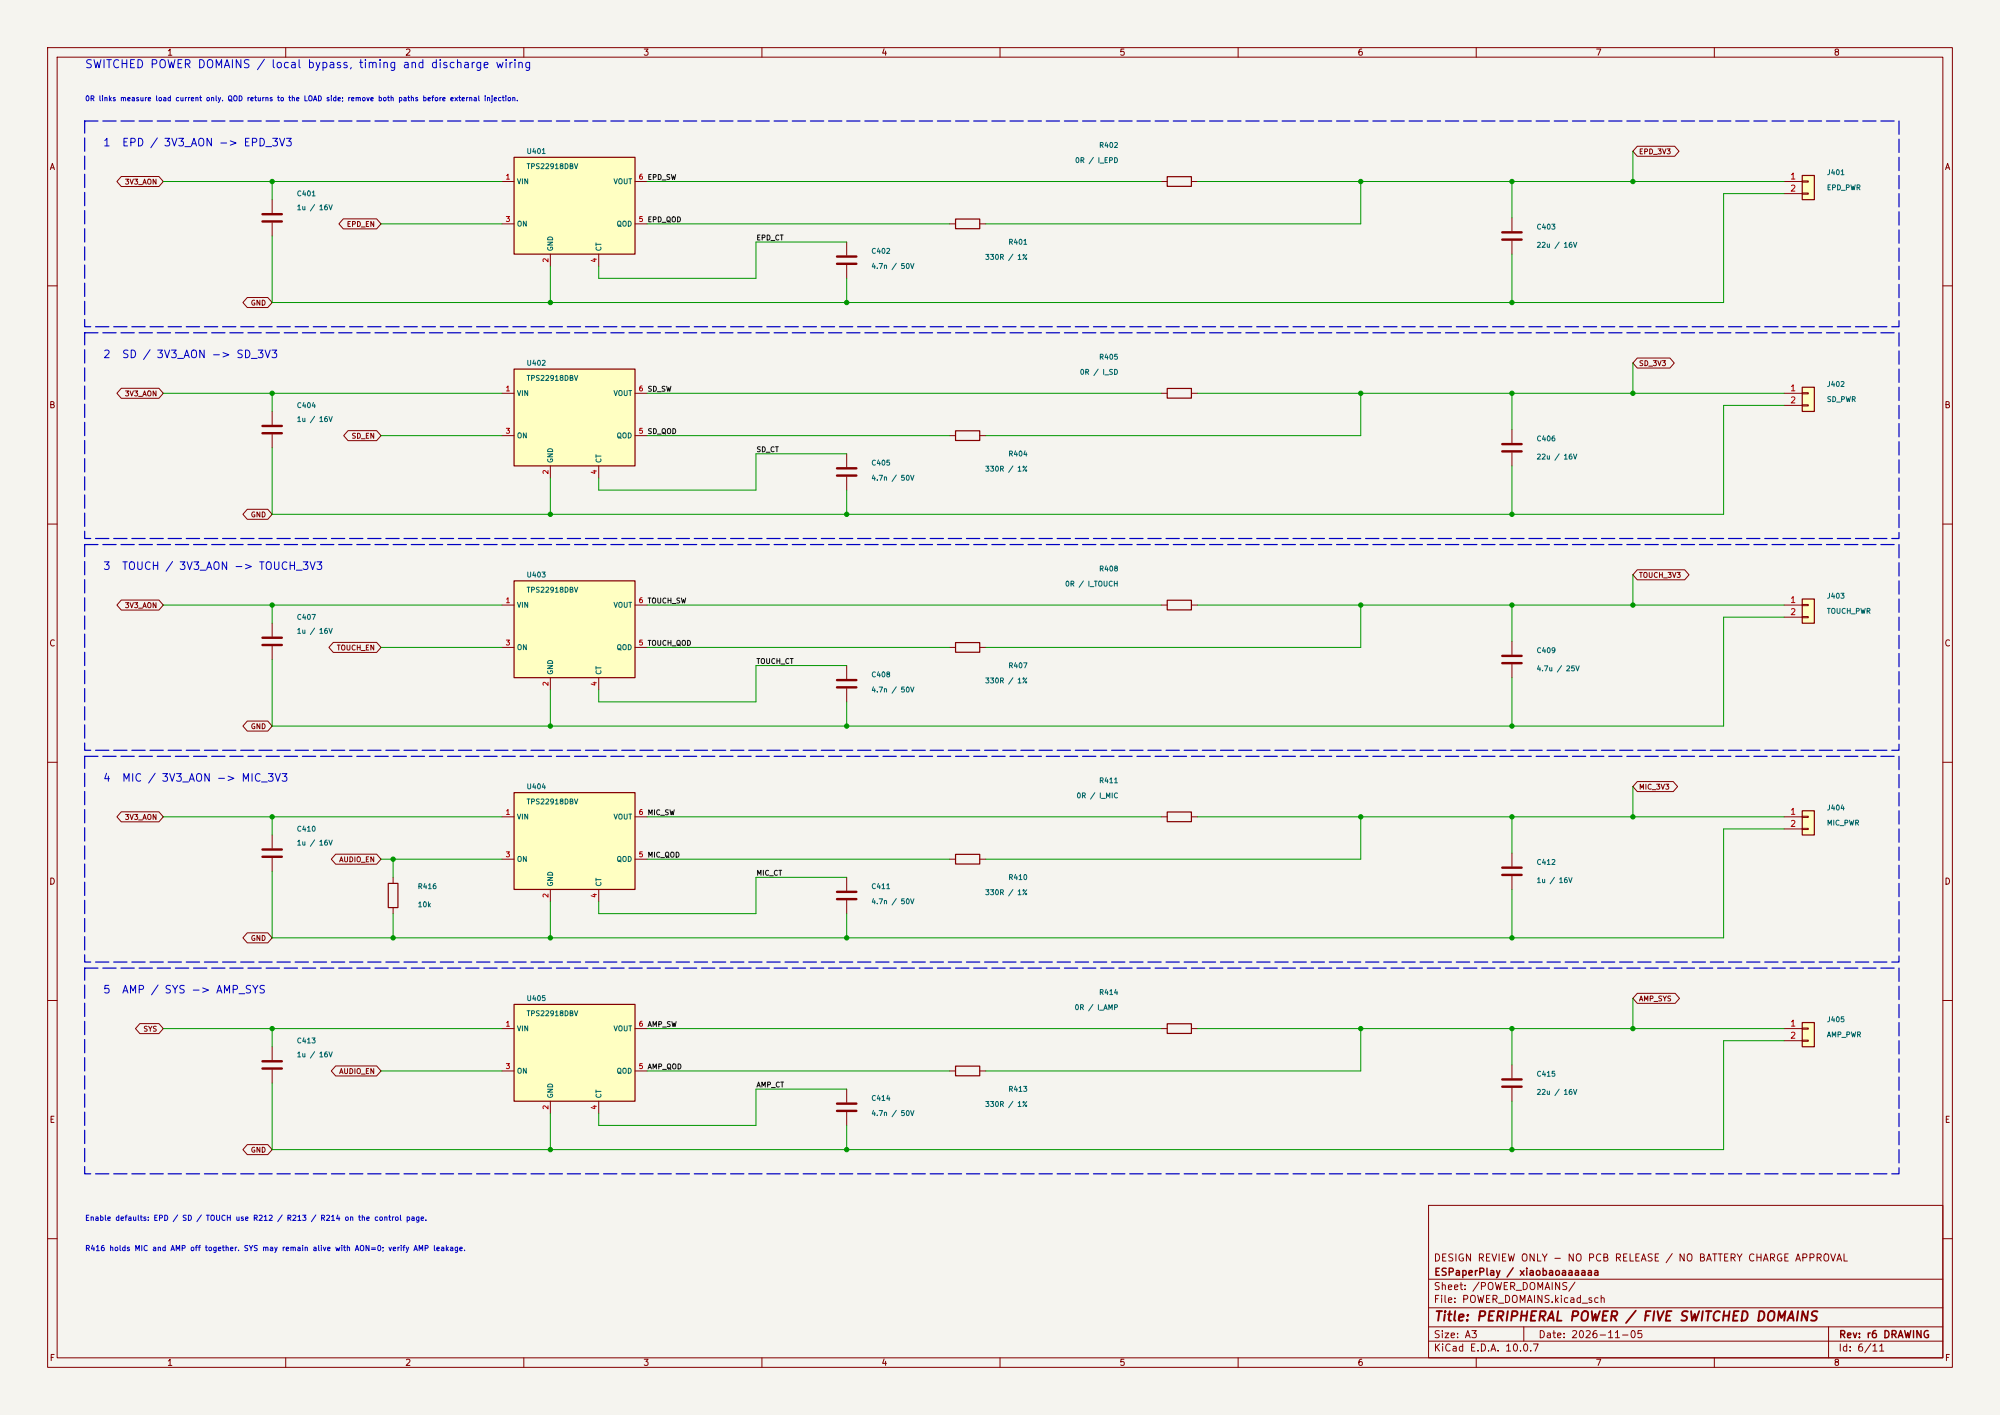
[picture p41: page 6]

SWITCHED POWER DOMAINS / local bypass, timing and discharge wiring

0R links measure load current only. QOD returns to the LOAD side; remove both paths before external injection. 2 SD / 3V3_AON -> SD_3V3

R416 holds MIC and AMP off together. SYS may remain alive with AON=0; verify AMP leakage. Enable defaults: EPD / SD / TOUCH use R212 / R213 / R214 on the control page.

DESIGN REVIEW ONLY - NO PCB RELEASE / NO BATTERY CHARGE APPROVAL
ESPaperPlay / xiaobaoaaaaaa
Sheet: /POWER_DOMAINS/
File: POWER_DOMAINS.kicad_sch
Title: PERIPHERAL POWER / FIVE SWITCHED DOMAINS

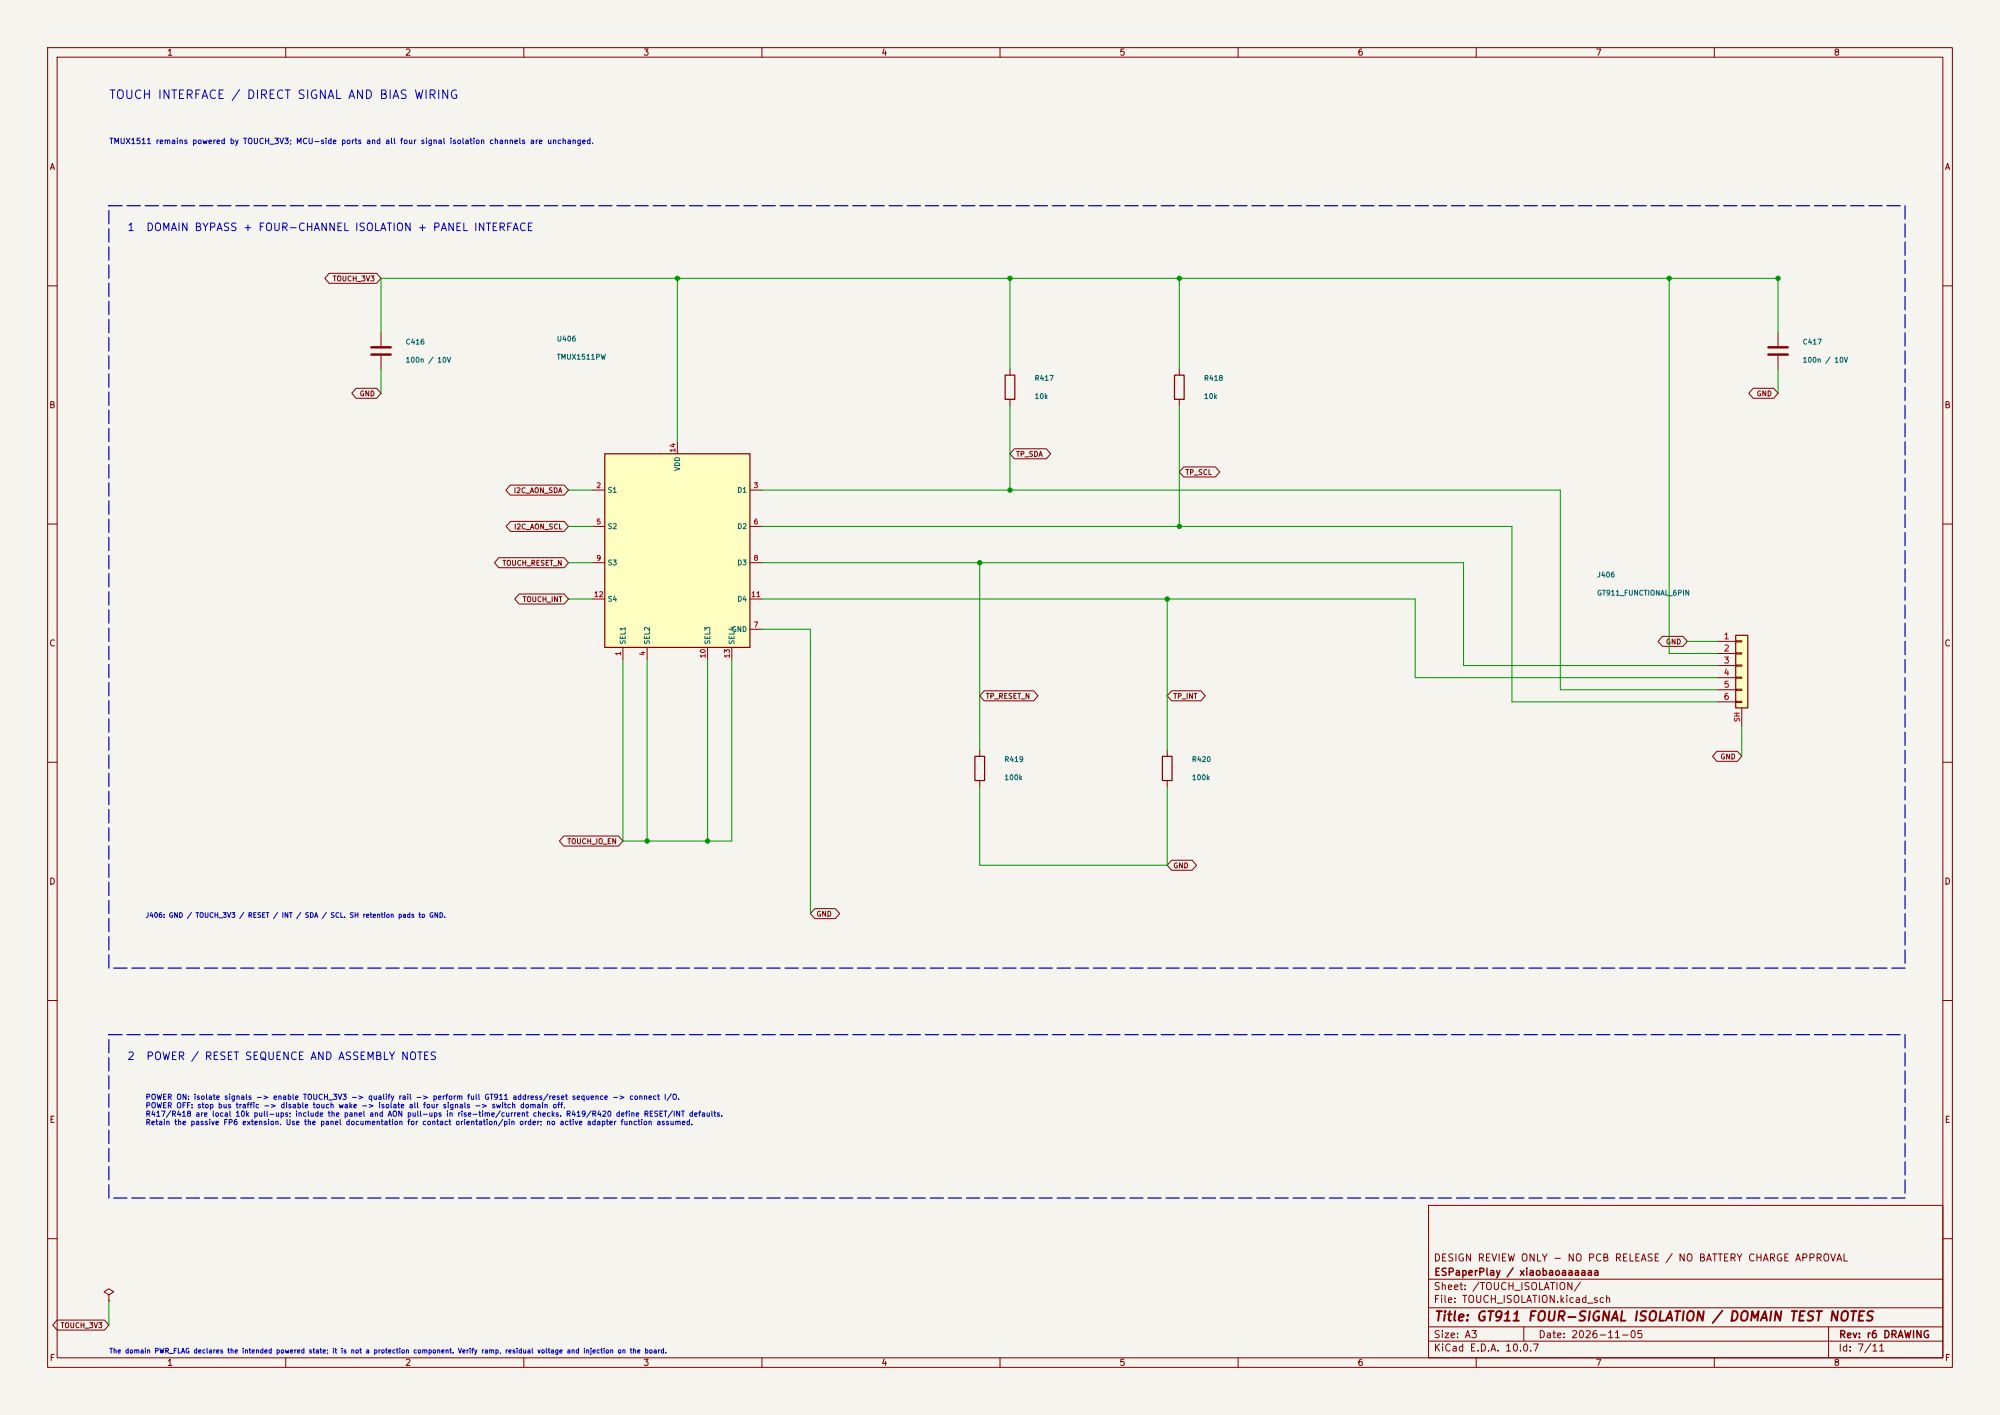
[picture p42: page 7]

TOUCH INTERFACE / DIRECT SIGNAL AND BIAS WIRING

TMUX1511 remains powered by TOUCH_3V3; MCU-side ports and all four signal isolation channels are unchanged.

1 DOMAIN BYPASS + FOUR-CHANNEL ISOLATION + PANEL INTERFACE

J406: GND / TOUCH_3V3 / RESET / INT / SDA / SCL. SH retention pads to GND.

2 POWER / RESET SEQUENCE AND ASSEMBLY NOTES

POWER ON: isolate signals -> enable TOUCH_3V3 -> qualify rail -> perform full GT911 address/reset sequence -> connect I/O. POWER OFF: stop bus traffic -> disable touch wake -> isolate all four signals -> switch domain off. R417/R418 are local 10k pull-ups; include the panel and AON pull-ups in rise-time/current checks. R419/R420 define RESET/INT defaults. Retain the passive FP6 extension. Use the panel documentation for contact orientation/pin order; no active adapter function assumed. The domain PWR_FLAG declares the intended powered state; it is not a protection component. Verify ramp, residual voltage and injection on the board.

DESIGN REVIEW ONLY - NO PCB RELEASE / NO BATTERY CHARGE APPROVAL
ESPaperPlay / xiaobaoaaaaaa
Sheet: /TOUCH_ISOLATION/
File: TOUCH_ISOLATION.kicad_sch
Title: GT911 FOUR-SIGNAL ISOLATION / DOMAIN TEST NOTES

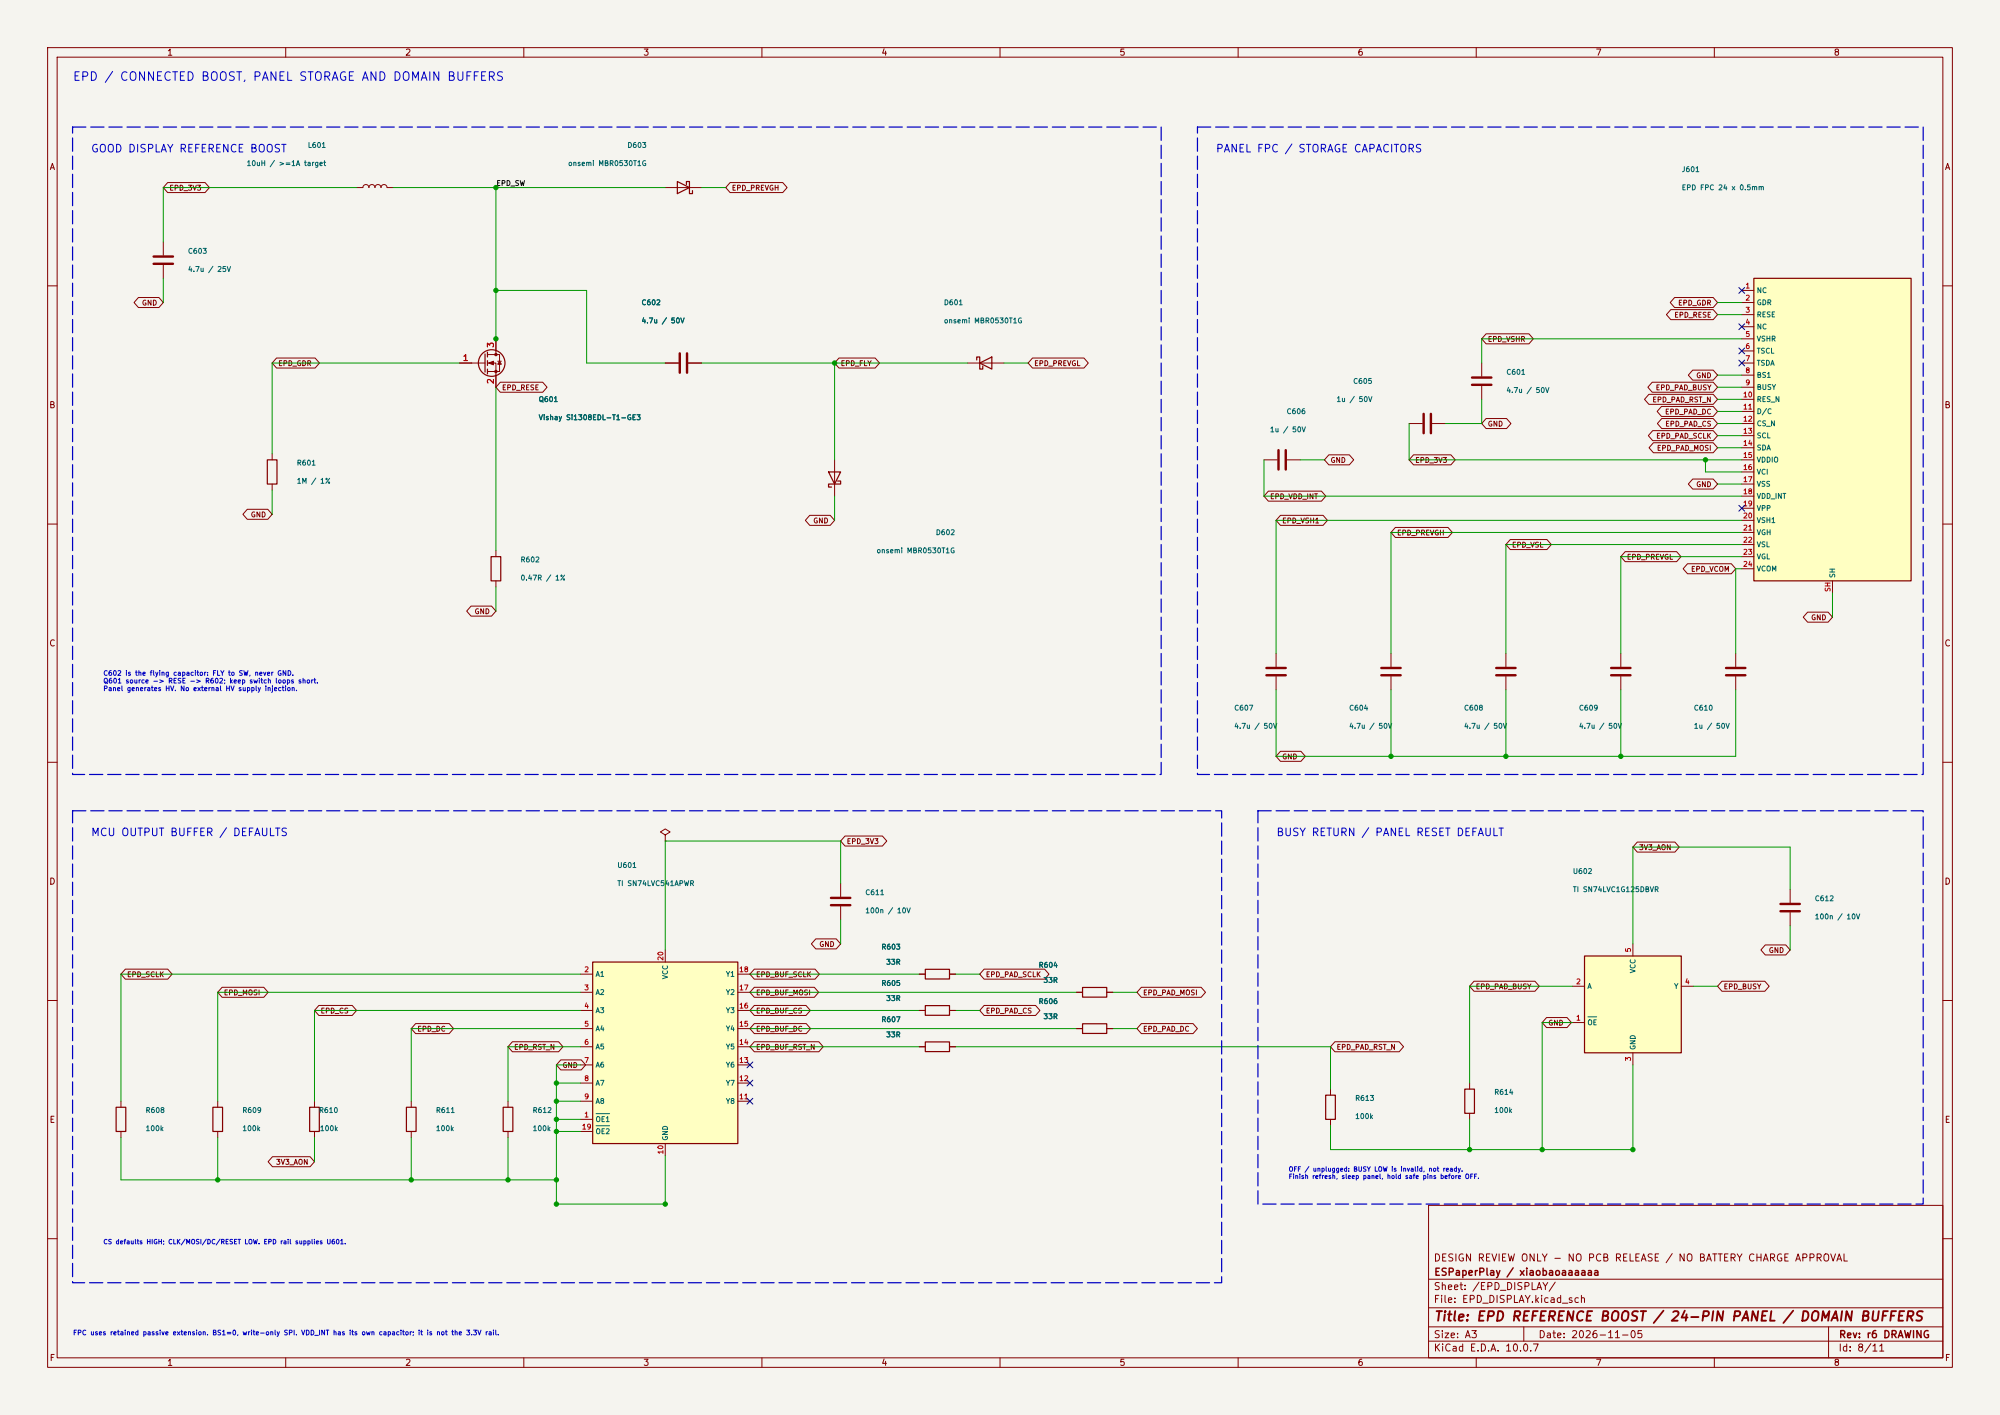
[picture p43: page 8]

EPD / CONNECTED BOOST, PANEL STORAGE AND DOMAIN BUFFERS

EPD_SW GOOD DISPLAY REFERENCE BOOST

PANEL FPC / STORAGE CAPACITORS

C602 is the flying capacitor: FLY to SW, never GND. Q601 source -> RESE -> R602; keep switch loops short. Panel generates HV. No external HV supply injection.

CS defaults HIGH; CLK/MOSI/DC/RESET LOW. EPD rail supplies U601. FPC uses retained passive extension. BS1=0, write-only SPI. VDD_INT has its own capacitor; it is not the 3.3V rail. MCU OUTPUT BUFFER / DEFAULTS

BUSY RETURN / PANEL RESET DEFAULT

OFF / unplugged: BUSY LOW is invalid, not ready. Finish refresh, sleep panel, hold safe pins before OFF.

DESIGN REVIEW ONLY - NO PCB RELEASE / NO BATTERY CHARGE APPROVAL
ESPaperPlay / xiaobaoaaaaaa
Sheet: /EPD_DISPLAY/
File: EPD_DISPLAY.kicad_sch
Title: EPD REFERENCE BOOST / 24-PIN PANEL / DOMAIN BUFFERS

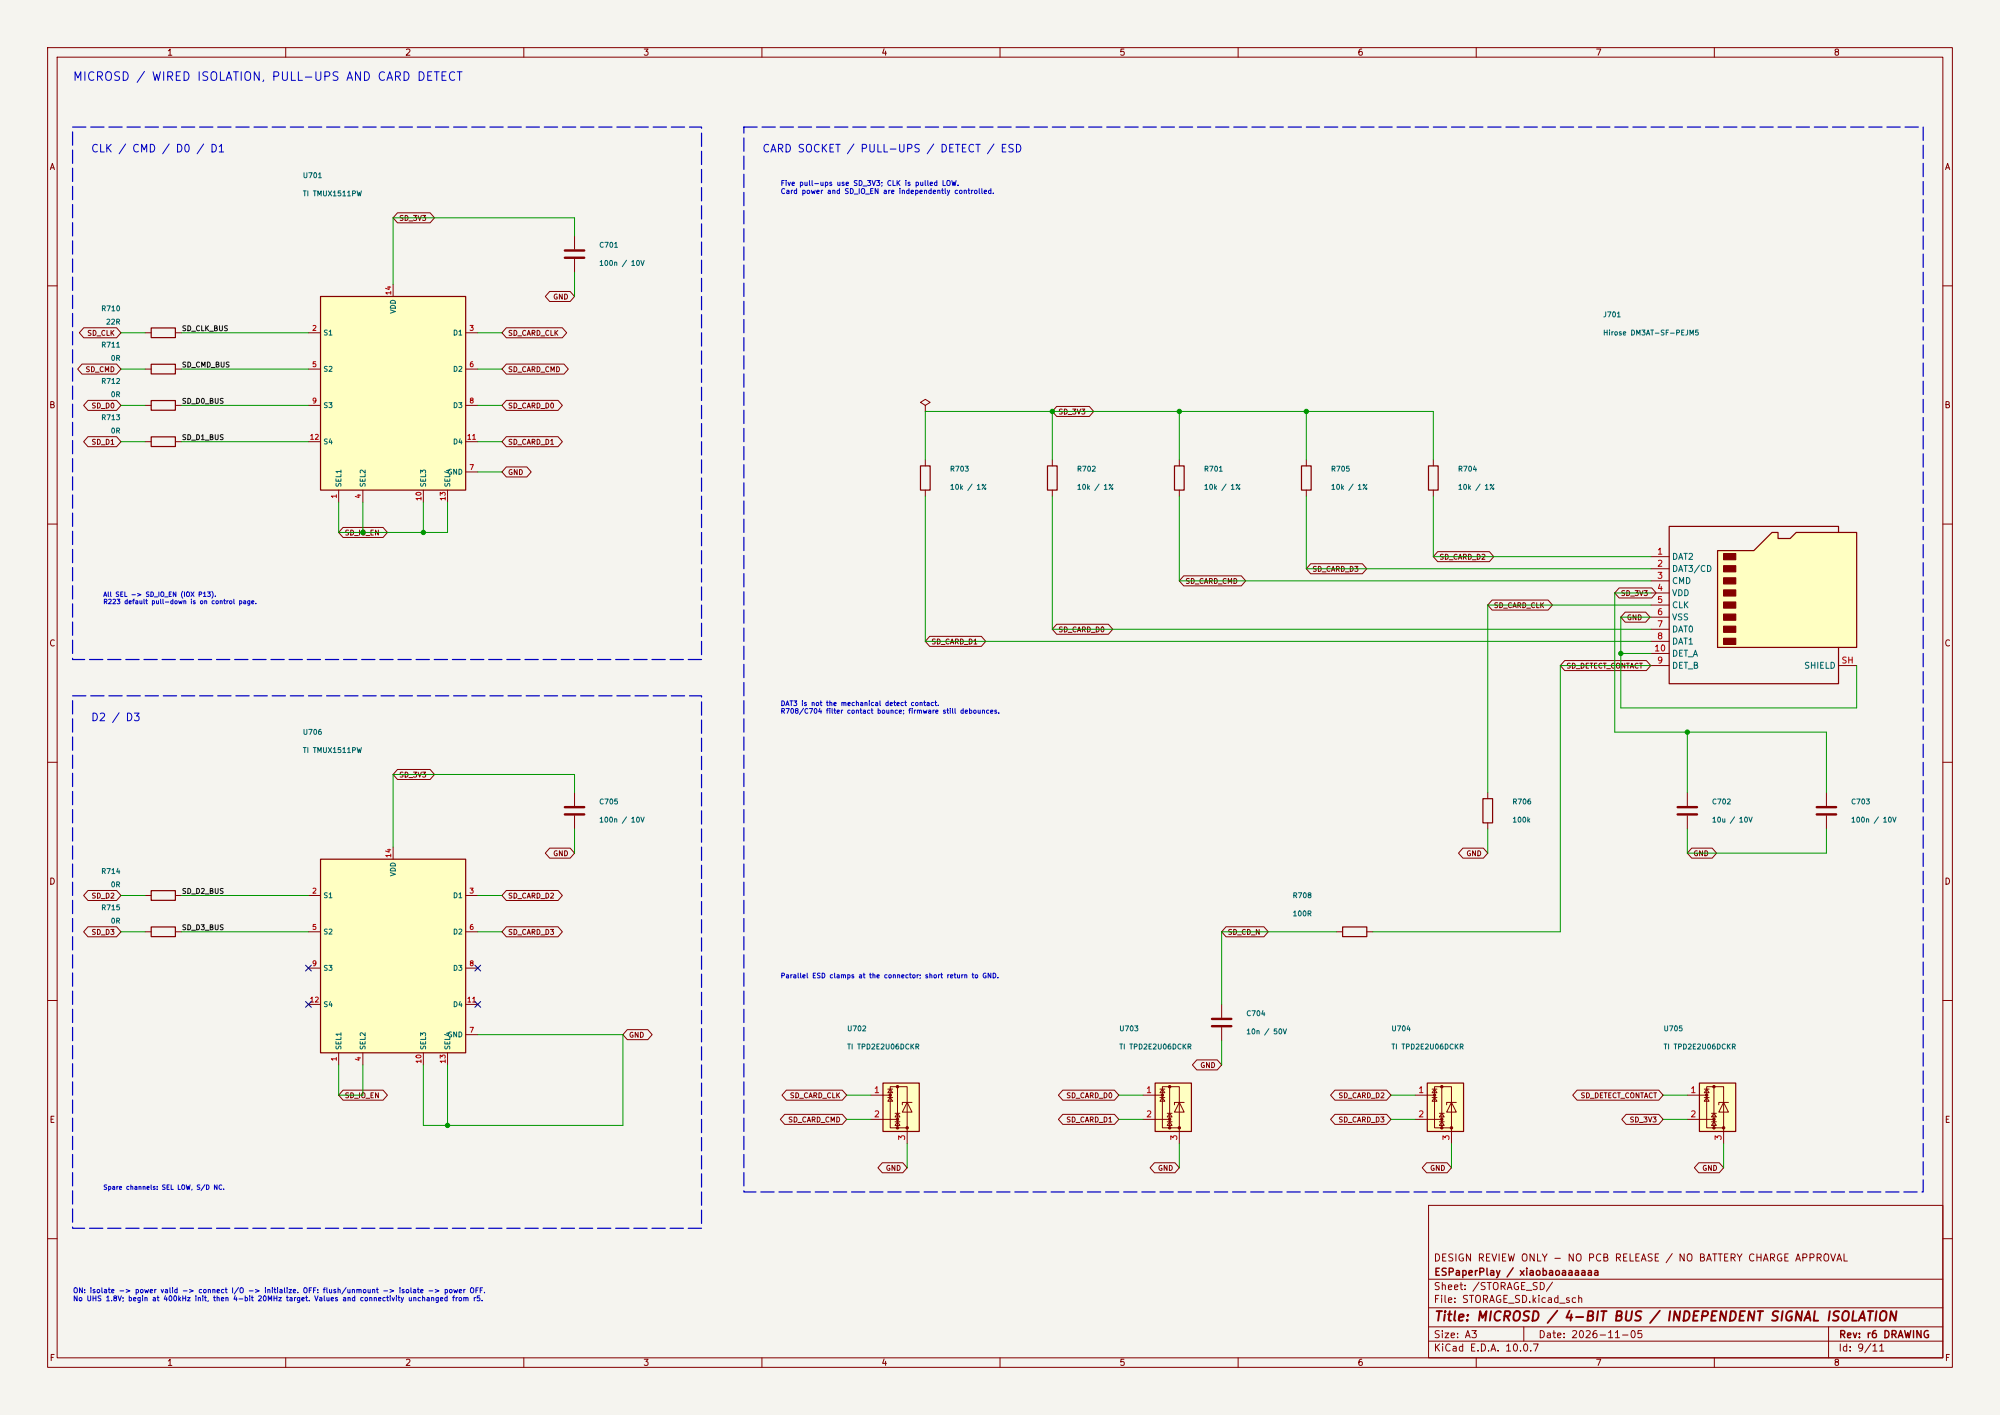
[picture p44: page 9]

MICROSD / WIRED ISOLATION, PULL-UPS AND CARD DETECT

Five pull-ups use SD_3V3; CLK is pulled LOW. Card power and SD_IO_EN are independently controlled. CARD SOCKET / PULL-UPS / DETECT / ESD

All SEL -> SD_IO_EN (IOX P13). R223 default pull-down is on control page.

DESIGN REVIEW ONLY - NO PCB RELEASE / NO BATTERY CHARGE APPROVAL
ESPaperPlay / xiaobaoaaaaaa
Sheet: /STORAGE_SD/
File: STORAGE_SD.kicad_sch
Title: MICROSD / 4-BIT BUS / INDEPENDENT SIGNAL ISOLATION

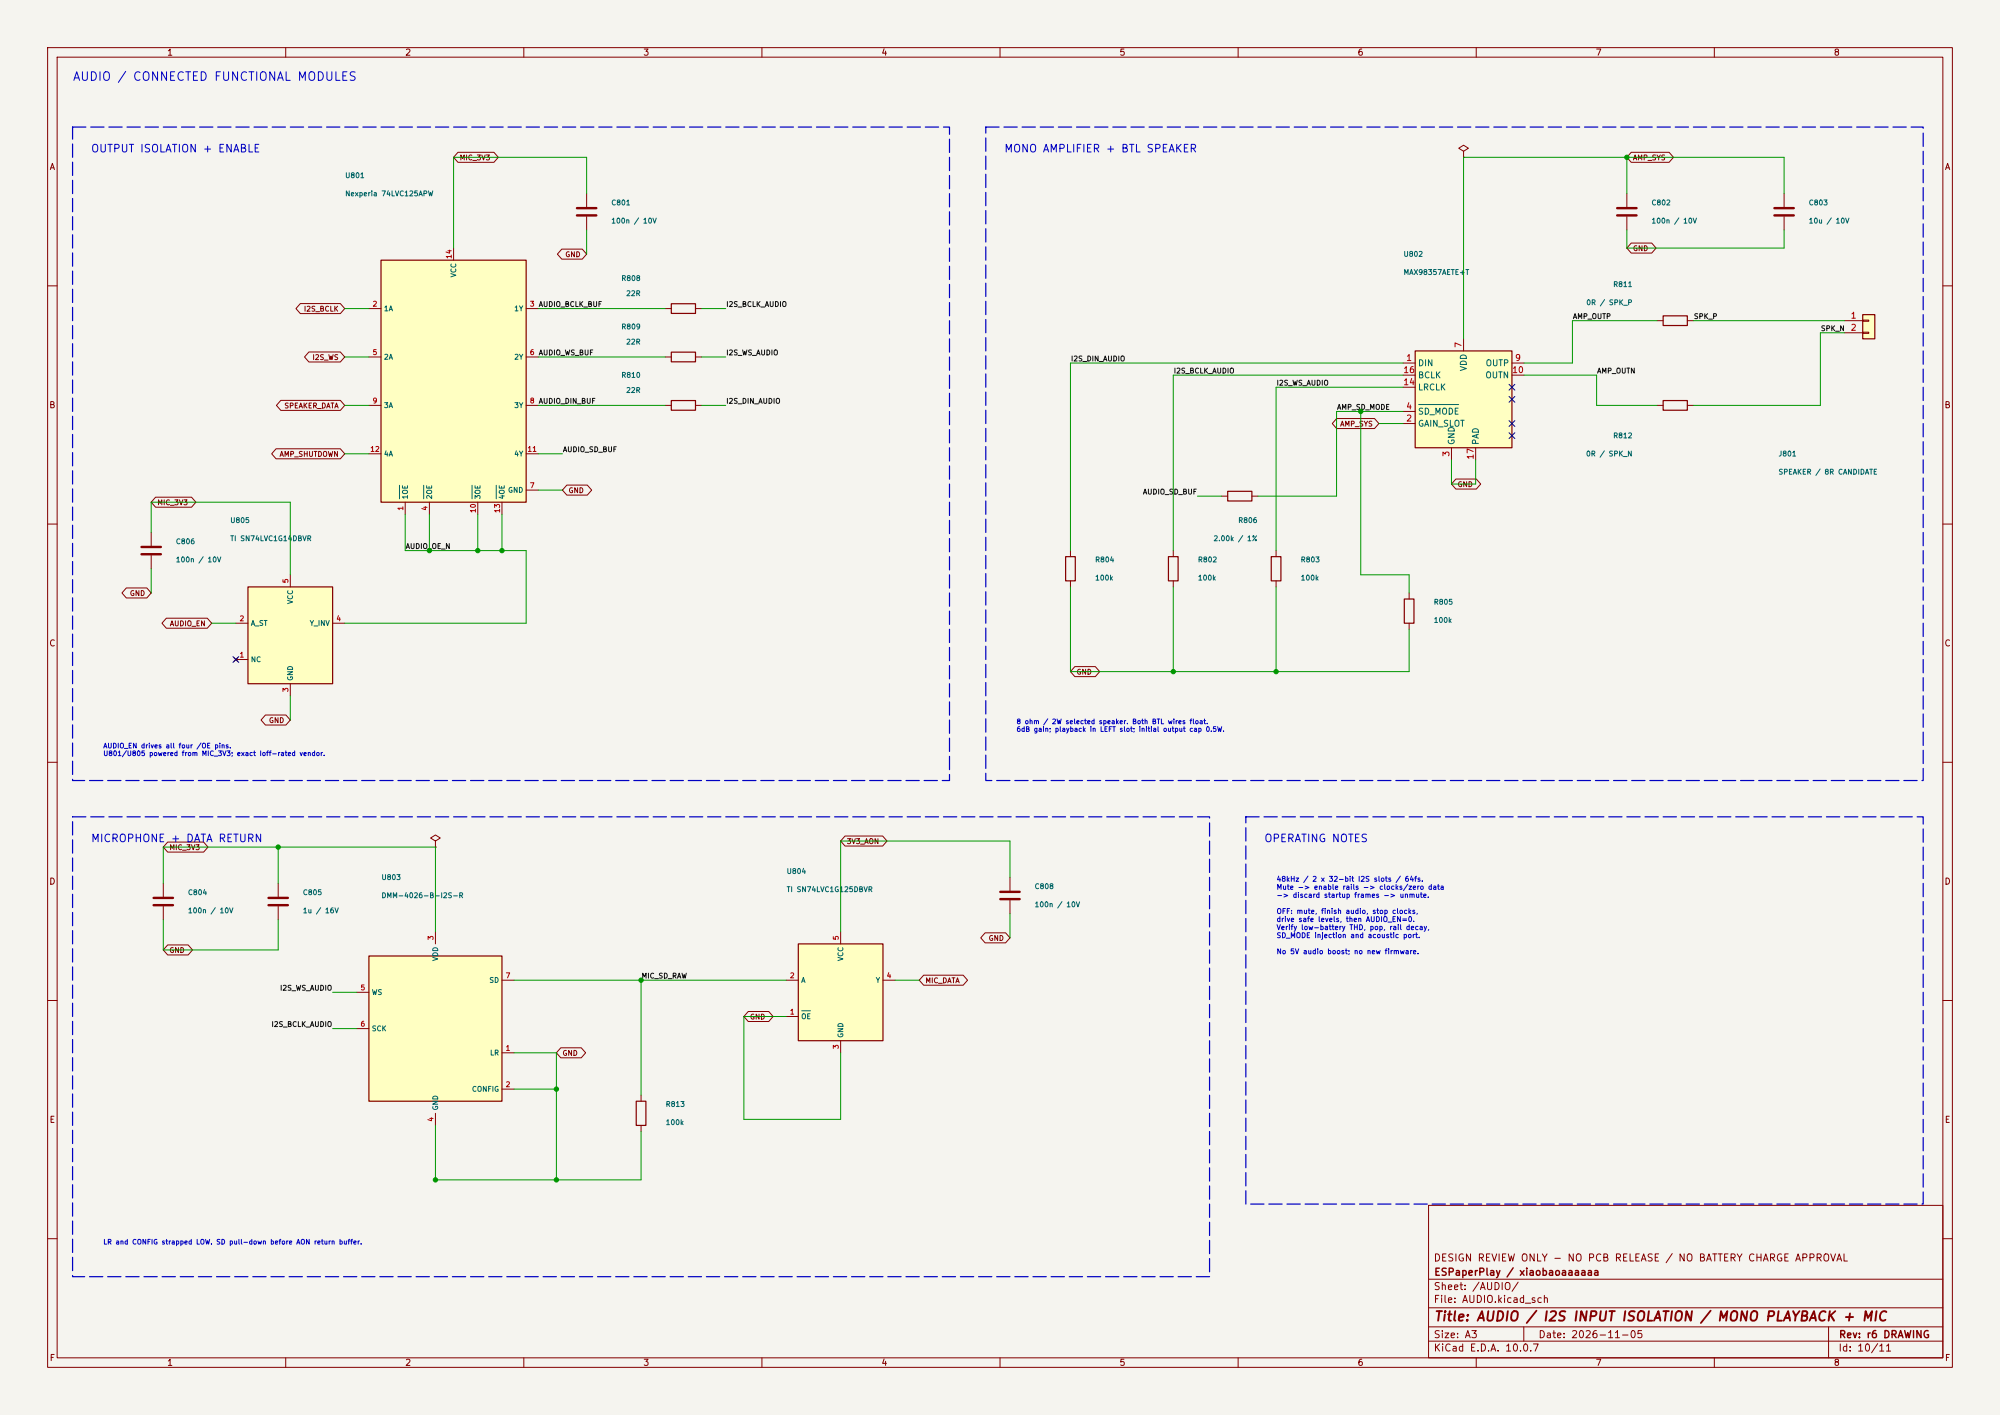
[picture p45: page 10]

AUDIO / CONNECTED FUNCTIONAL MODULES

8 ohm / 2W selected speaker. Both BTL wires float. 6dB gain; playback in LEFT slot; initial output cap 0.5W.

48kHz / 2 x 32-bit I2S slots / 64fs. Mute -> enable rails -> clocks/zero data -> discard startup frames -> unmute. OFF: mute, finish audio, stop clocks, drive safe levels, then AUDIO_EN=0. Verify low-battery THD, pop, rail decay, SD_MODE injection and acoustic port. No 5V audio boost; no new firmware. AUDIO_EN drives all four /OE pins. U801/U805 powered from MIC_3V3; exact Ioff-rated vendor.

LR and CONFIG strapped LOW. SD pull-down before AON return buffer.

DESIGN REVIEW ONLY - NO PCB RELEASE / NO BATTERY CHARGE APPROVAL
ESPaperPlay / xiaobaoaaaaaa
Sheet: /AUDIO/
File: AUDIO.kicad_sch
Title: AUDIO / I2S INPUT ISOLATION / MONO PLAYBACK + MIC

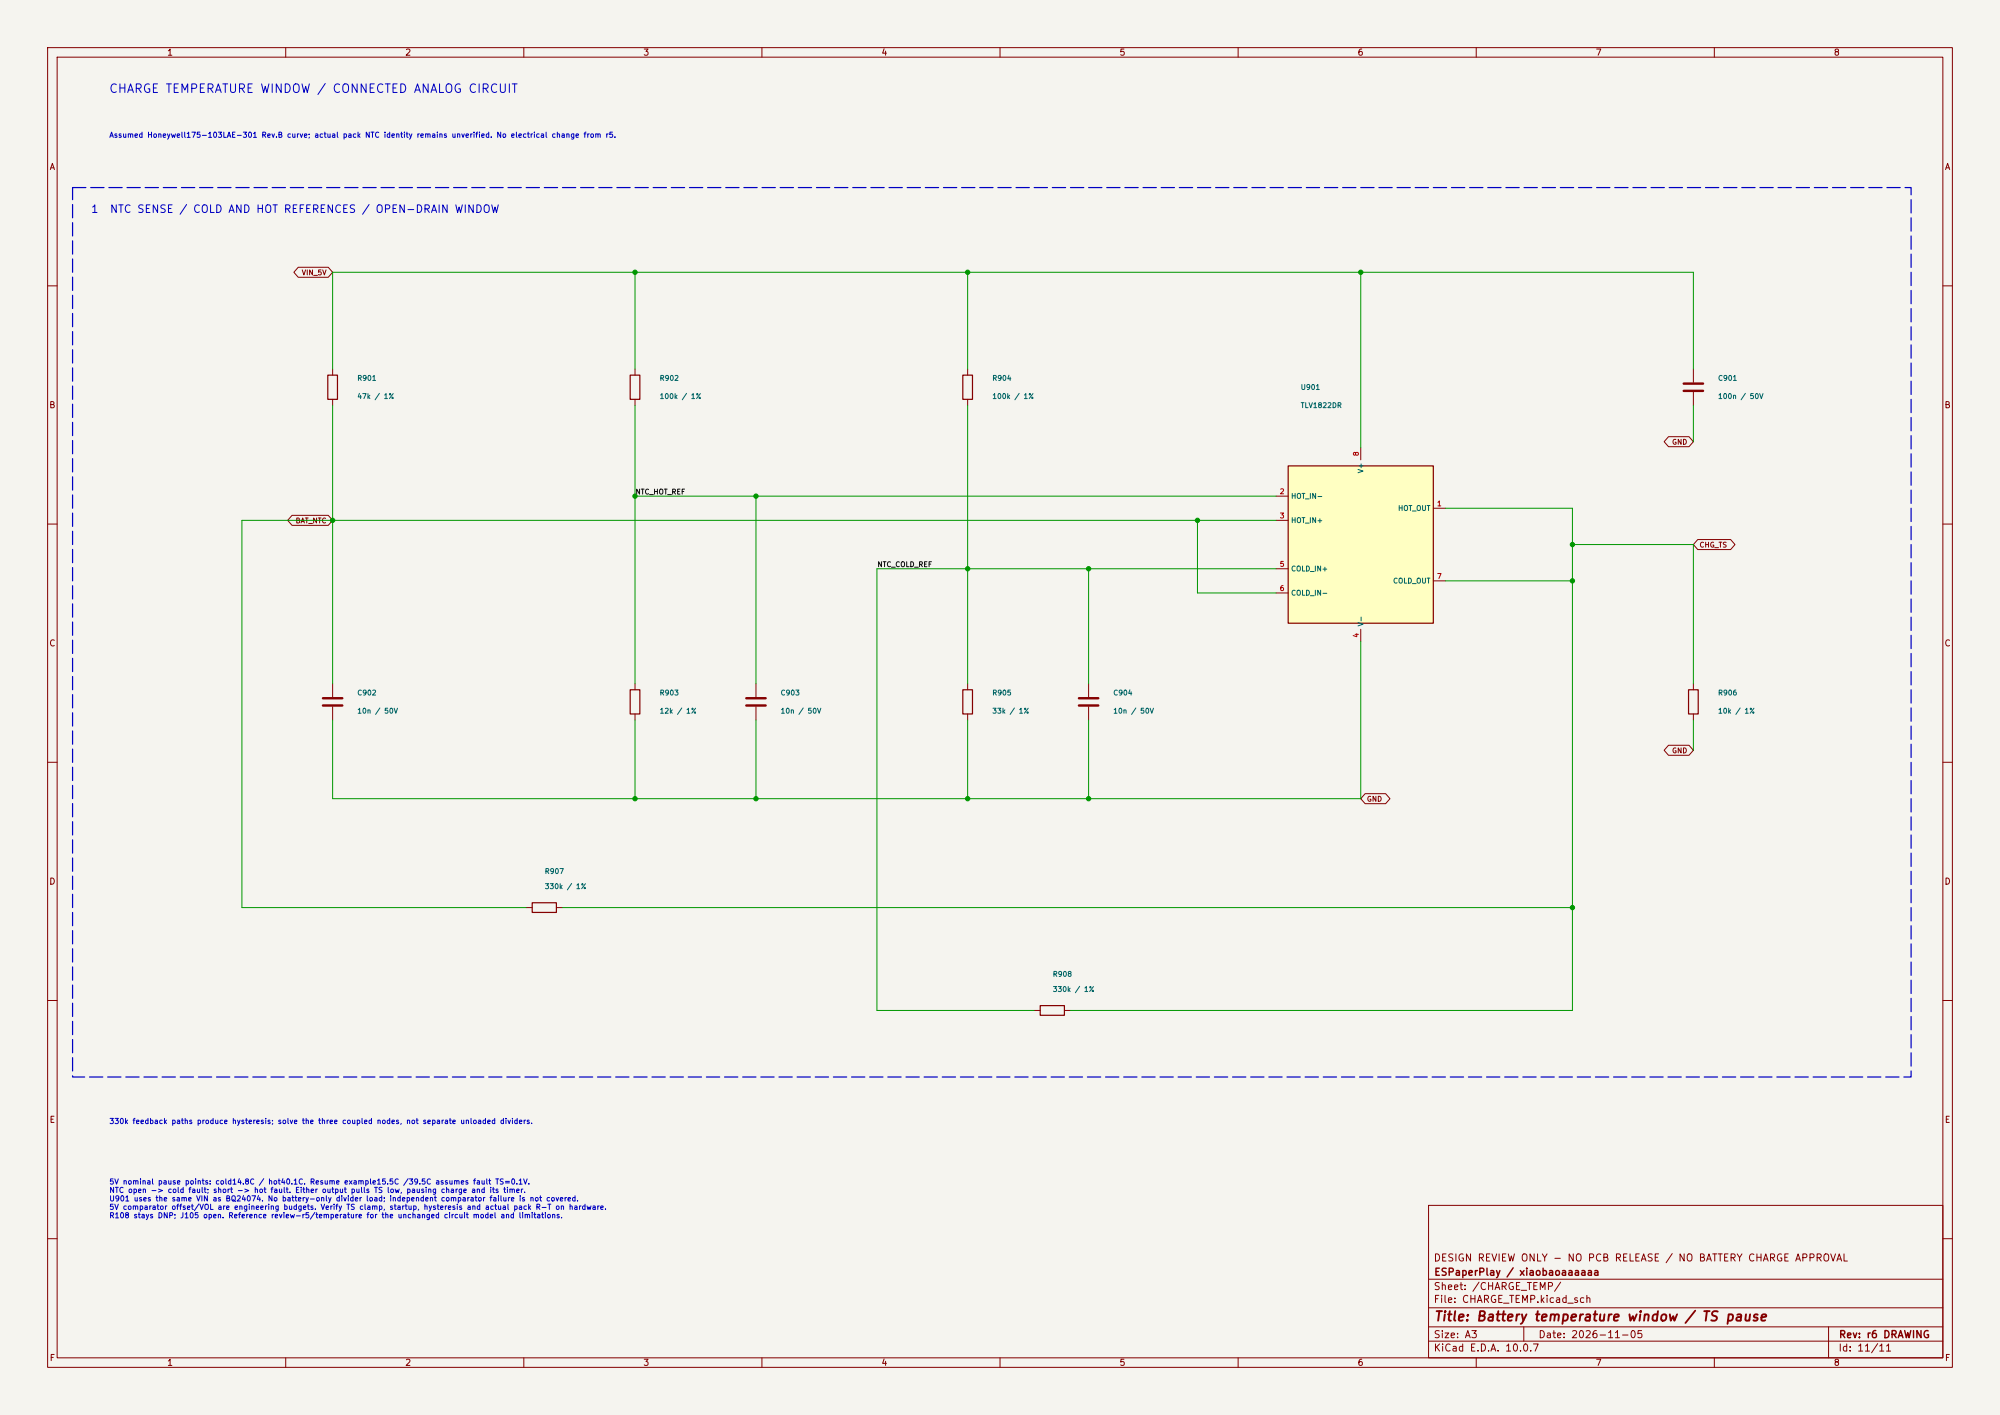
[picture p46: page 11]

Assumed Honeywell175-103LAE-301 Rev.B curve; actual pack NTC identity remains unverified. No electrical change from r5. CHARGE TEMPERATURE WINDOW / CONNECTED ANALOG CIRCUIT

1 NTC SENSE / COLD AND HOT REFERENCES / OPEN-DRAIN WINDOW

330k feedback paths produce hysteresis; solve the three coupled nodes, not separate unloaded dividers. 5V nominal pause points: cold14.8C / hot40.1C. Resume example15.5C /39.5C assumes fault TS=0.1V. NTC open -> cold fault; short -> hot fault. Either output pulls TS low, pausing charge and its timer. U901 uses the same VIN as BQ24074. No battery-only divider load; independent comparator failure is not covered. 5V comparator offset/VOL are engineering budgets. Verify TS clamp, startup, hysteresis and actual pack R-T on hardware. R108 stays DNP; J105 open. Reference review-r5/temperature for the unchanged circuit model and limitations.

DESIGN REVIEW ONLY - NO PCB RELEASE / NO BATTERY CHARGE APPROVAL
ESPaperPlay / xiaobaoaaaaaa
Sheet: /CHARGE_TEMP/
File: CHARGE_TEMP.kicad_sch
Title: Battery temperature window / TS pause
