xiaobaoaaaaaa/ESPaperPlay-V2/hardware/devboard-r0/output/pdf/ESPaperPlay_Devboard_peripherals_r2.pdf

1 | 2 | 3 | 4 | 5 | 6 | 7 | 8

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
Size: A3 | Rev: r2 DRAFT | F Date: 2026-11-02
KiCad E.D.A. 10.0.7 | Id: 1/10

# Title: ESPaperPlay DEVELOPMENT BOARD - PERIPHERAL DRAFT

## File: ESPaperPlay_Devboard.kicad_sch

## Sheet: /

## ESPaperPlay / xiaobaoaaaaaa

## DESIGN REVIEW ONLY - NO PCB RELEASE / NO BATTERY CHARGE APPROVAL

STORAGE_SD 文件: STORAGE_SD.kicad_sch

POWER_INPUT_CHARGER 文件: POWER_INPUT_CHARGER.kicad_sch | MCU_CORE 文件: MCU_CORE.kicad_sch POWER_DOMAINS 文件: POWER_DOMAINS.kicad_sch

TOUCH_ISOLATION 文件: TOUCH_ISOLATION.kicad_sch

# AUDIO 文件: AUDIO.kicad_sch

POWER_3V3_CONTROL 文件: POWER_3V3_CONTROL.kicad_sch USB_INPUT 文件: USB_INPUT.kicad_sch

EPD_DISPLAY 文件: EPD_DISPLAY.kicad_sch USB-C / protection / source select | microSD / bus isolation / detect Five switched power domains Regulator / IO expander / gauge

hardware/devboard-r0/README.md / docs/v2/hardware/power-design-spec.md R108 CHG_ARM stays DNP. Battery / NTC / charging window are not approved. J502 source select and J202 MAIN_RUN each use ONE shunt only. SD_IO_EN uses IOX P13: power valid -> connect I/O; unmount -> isolate -> power OFF. Footprints, FPC contact face, speaker, final power-part ratings and procurement remain open. No measured power / thermal / USB / ESD performance; see the project README before assembly.

## ASSEMBLY / REVIEW BOUNDARIES

UC8179 / boost / 24-pin FPC

## ESPaperPlay / DEVELOPMENT BOARD r2

# I2S amplifier / microphone GT911 four-signal isolation

Input / charger / battery | N16R8 / reset / user keys Nine functional sheets. Schematic review stage; no PCB or manufacturing release. ESP32-S3-WROOM-1-N16R8 / GDEY075T7-T01 / protected 1-cell battery

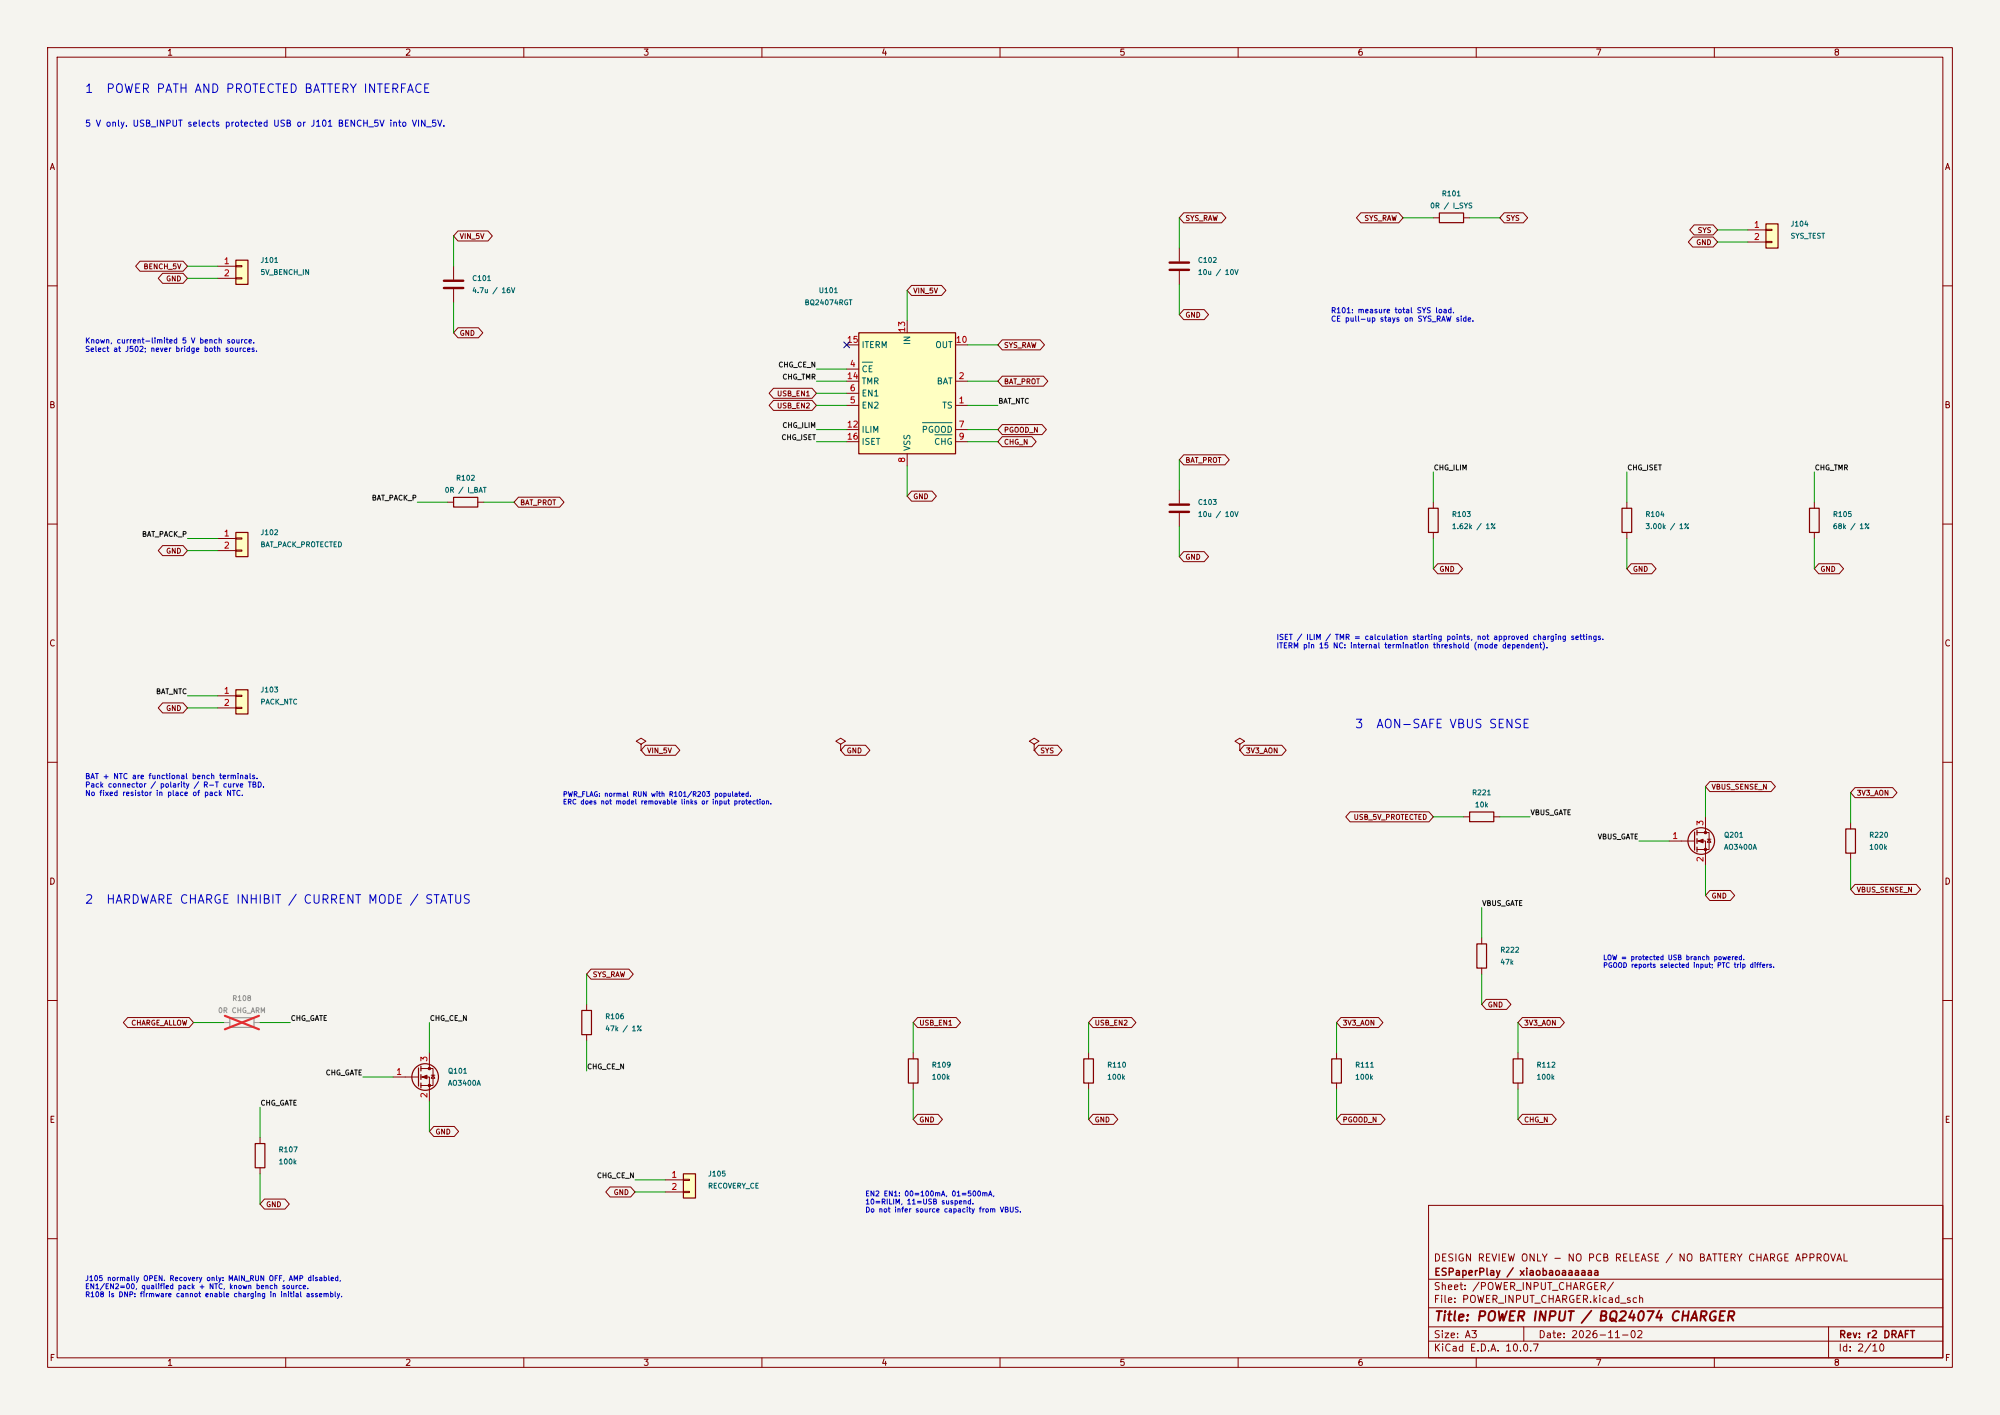
[picture p47: page 2]

1 POWER PATH AND PROTECTED BATTERY INTERFACE

CHG_ILIM 5 V only. USB_INPUT selects protected USB or J101 BENCH_5V into VIN_5V. Known, current-limited 5 V bench source. Select at J502; never bridge both sources.

R101: measure total SYS load. CE pull-up stays on SYS_RAW side. 3 AON-SAFE VBUS SENSE

ISET / ILIM / TMR = calculation starting points, not approved charging settings.
ITERM pin 15 NC: internal termination threshold (mode dependent).

LOW = protected USB branch powered. PGOOD reports selected input; PTC trip differs. PWR_FLAG: normal RUN with R101/R203 populated. ERC does not model removable links or input protection. BAT + NTC are functional bench terminals. Pack connector / polarity / R-T curve TBD. No fixed resistor in place of pack NTC.

J105 normally OPEN. Recovery only: MAIN_RUN OFF, AMP disabled, EN1/EN2=00, qualified pack + NTC, known bench source. R108 is DNP: firmware cannot enable charging in initial assembly. 2 HARDWARE CHARGE INHIBIT / CURRENT MODE / STATUS

EN2 EN1: 00=100mA, 01=500mA, 10=RILIM, 11=USB suspend. Do not infer source capacity from VBUS.

DESIGN REVIEW ONLY - NO PCB RELEASE / NO BATTERY CHARGE APPROVAL
ESPaperPlay / xiaobaoaaaaaa
Sheet: /POWER_INPUT_CHARGER/
File: POWER_INPUT_CHARGER.kicad_sch
Title: POWER INPUT / BQ24074 CHARGER

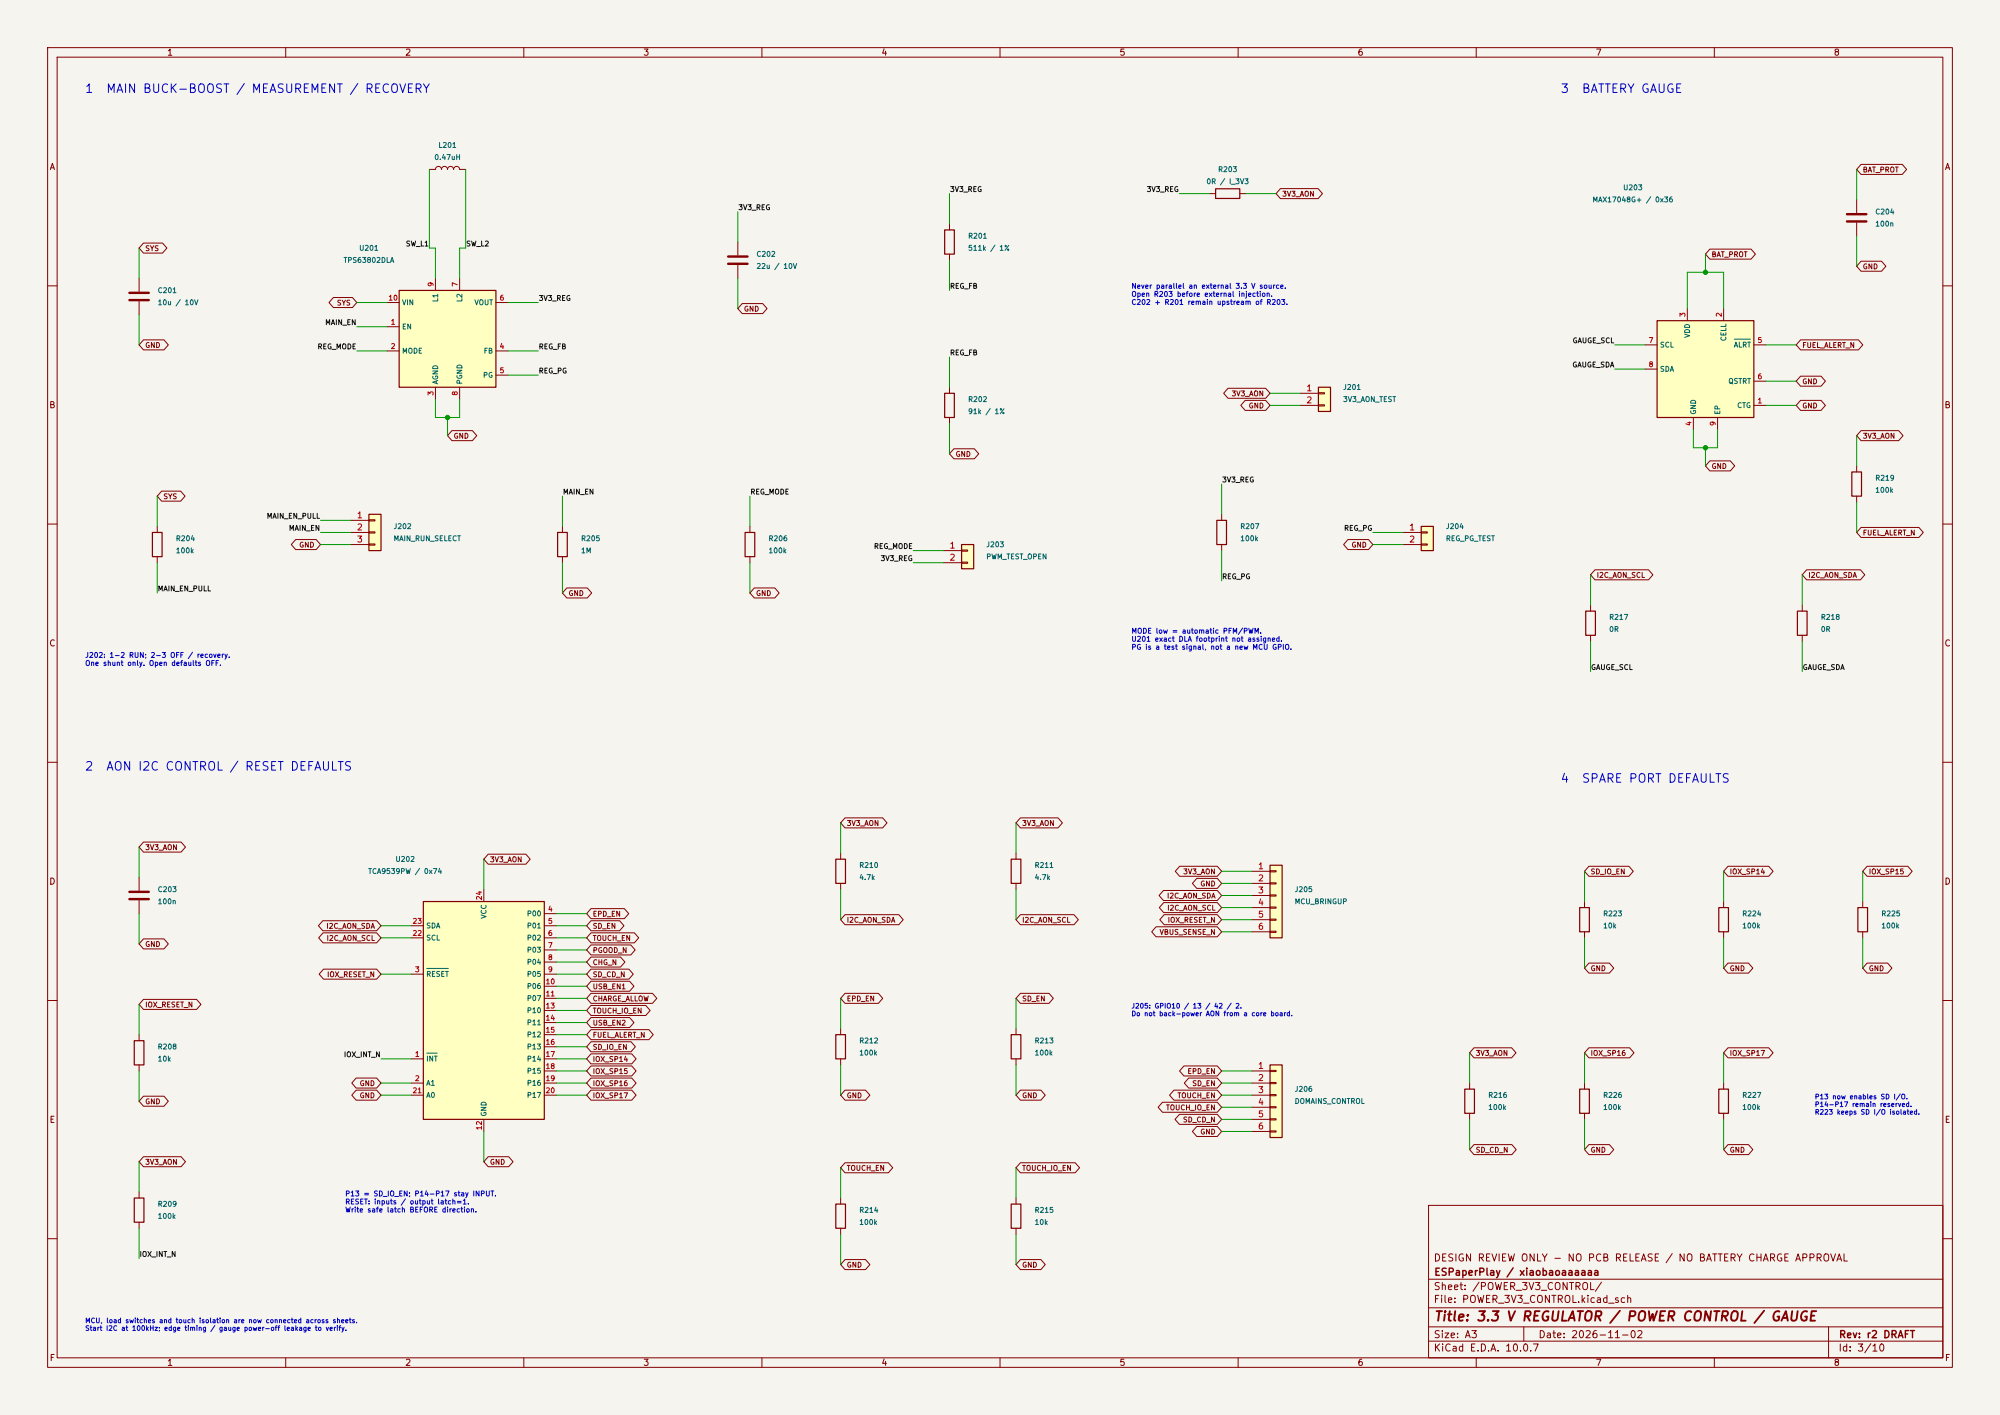
[picture p48: page 3]

1 MAIN BUCK-BOOST / MEASUREMENT / RECOVERY

Never parallel an external 3.3 V source. Open R203 before external injection. C202 + R201 remain upstream of R203. 2 AON I2C CONTROL / RESET DEFAULTS

J202: 1-2 RUN; 2-3 OFF / recovery. One shunt only. Open defaults OFF.

P13 now enables SD I/O. P14-P17 remain reserved. R223 keeps SD I/O isolated. J205: GPIO10 / 13 / 42 / 2. Do not back-power AON from a core board.

P13 = SD_IO_EN; P14-P17 stay INPUT. RESET: inputs / output latch=1. Write safe latch BEFORE direction.

DESIGN REVIEW ONLY - NO PCB RELEASE / NO BATTERY CHARGE APPROVAL
ESPaperPlay / xiaobaoaaaaaa
Sheet: /POWER_3V3_CONTROL/
File: POWER_3V3_CONTROL.kicad_sch
Title: 3.3 V REGULATOR / POWER CONTROL / GAUGE

MCU, load switches and touch isolation are now connected across sheets. Start I2C at 100kHz; edge timing / gauge power-off leakage to verify.

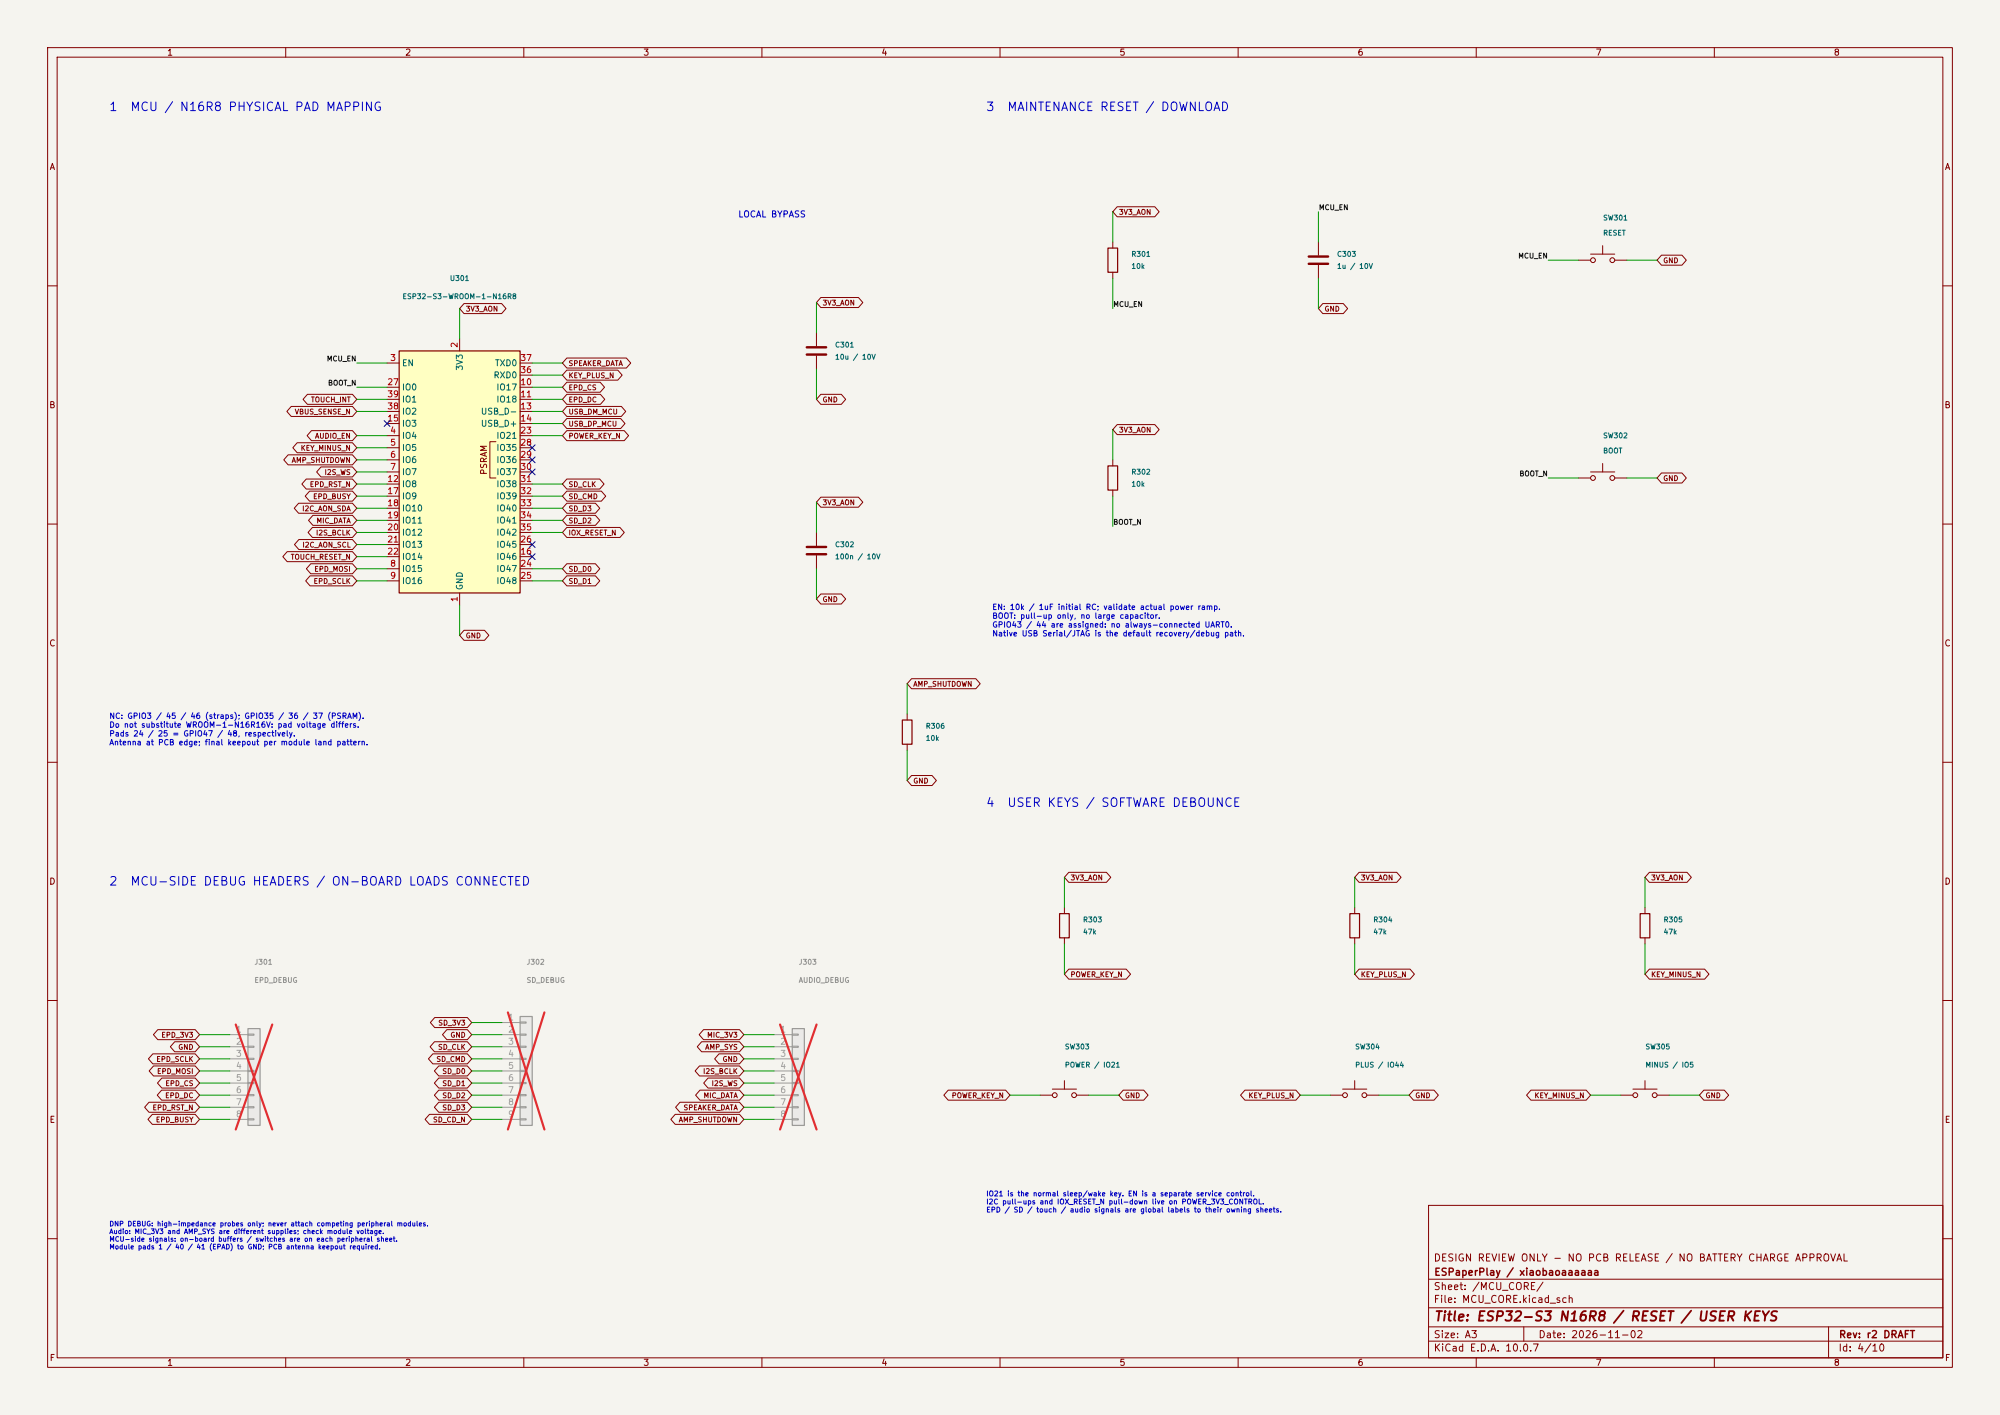
[picture p49: page 4]

1 MCU / N16R8 PHYSICAL PAD MAPPING

EN: 10k / 1uF initial RC; validate actual power ramp. BOOT: pull-up only, no large capacitor. GPIO43 / 44 are assigned: no always-connected UART0. Native USB Serial/JTAG is the default recovery/debug path.

NC: GPIO3 / 45 / 46 (straps); GPIO35 / 36 / 37 (PSRAM). Do not substitute WROOM-1-N16R16V: pad voltage differs. Pads 24 / 25 = GPIO47 / 48, respectively. Antenna at PCB edge; final keepout per module land pattern.

4 USER KEYS / SOFTWARE DEBOUNCE

DNP DEBUG: high-impedance probes only; never attach competing peripheral modules. Audio: MIC_3V3 and AMP_SYS are different supplies; check module voltage. MCU-side signals: on-board buffers / switches are on each peripheral sheet. Module pads 1 / 40 / 41 (EPAD) to GND; PCB antenna keepout required. 2 MCU-SIDE DEBUG HEADERS / ON-BOARD LOADS CONNECTED

IO21 is the normal sleep/wake key. EN is a separate service control.
I2C pull-ups and IOX_RESET_N pull-down live on POWER_3V3_CONTROL. EPD / SD / touch / audio signals are global labels to their owning sheets.

DESIGN REVIEW ONLY - NO PCB RELEASE / NO BATTERY CHARGE APPROVAL
ESPaperPlay / xiaobaoaaaaaa
Sheet: /MCU_CORE/
File: MCU_CORE.kicad_sch
Title: ESP32-S3 N16R8 / RESET / USER KEYS

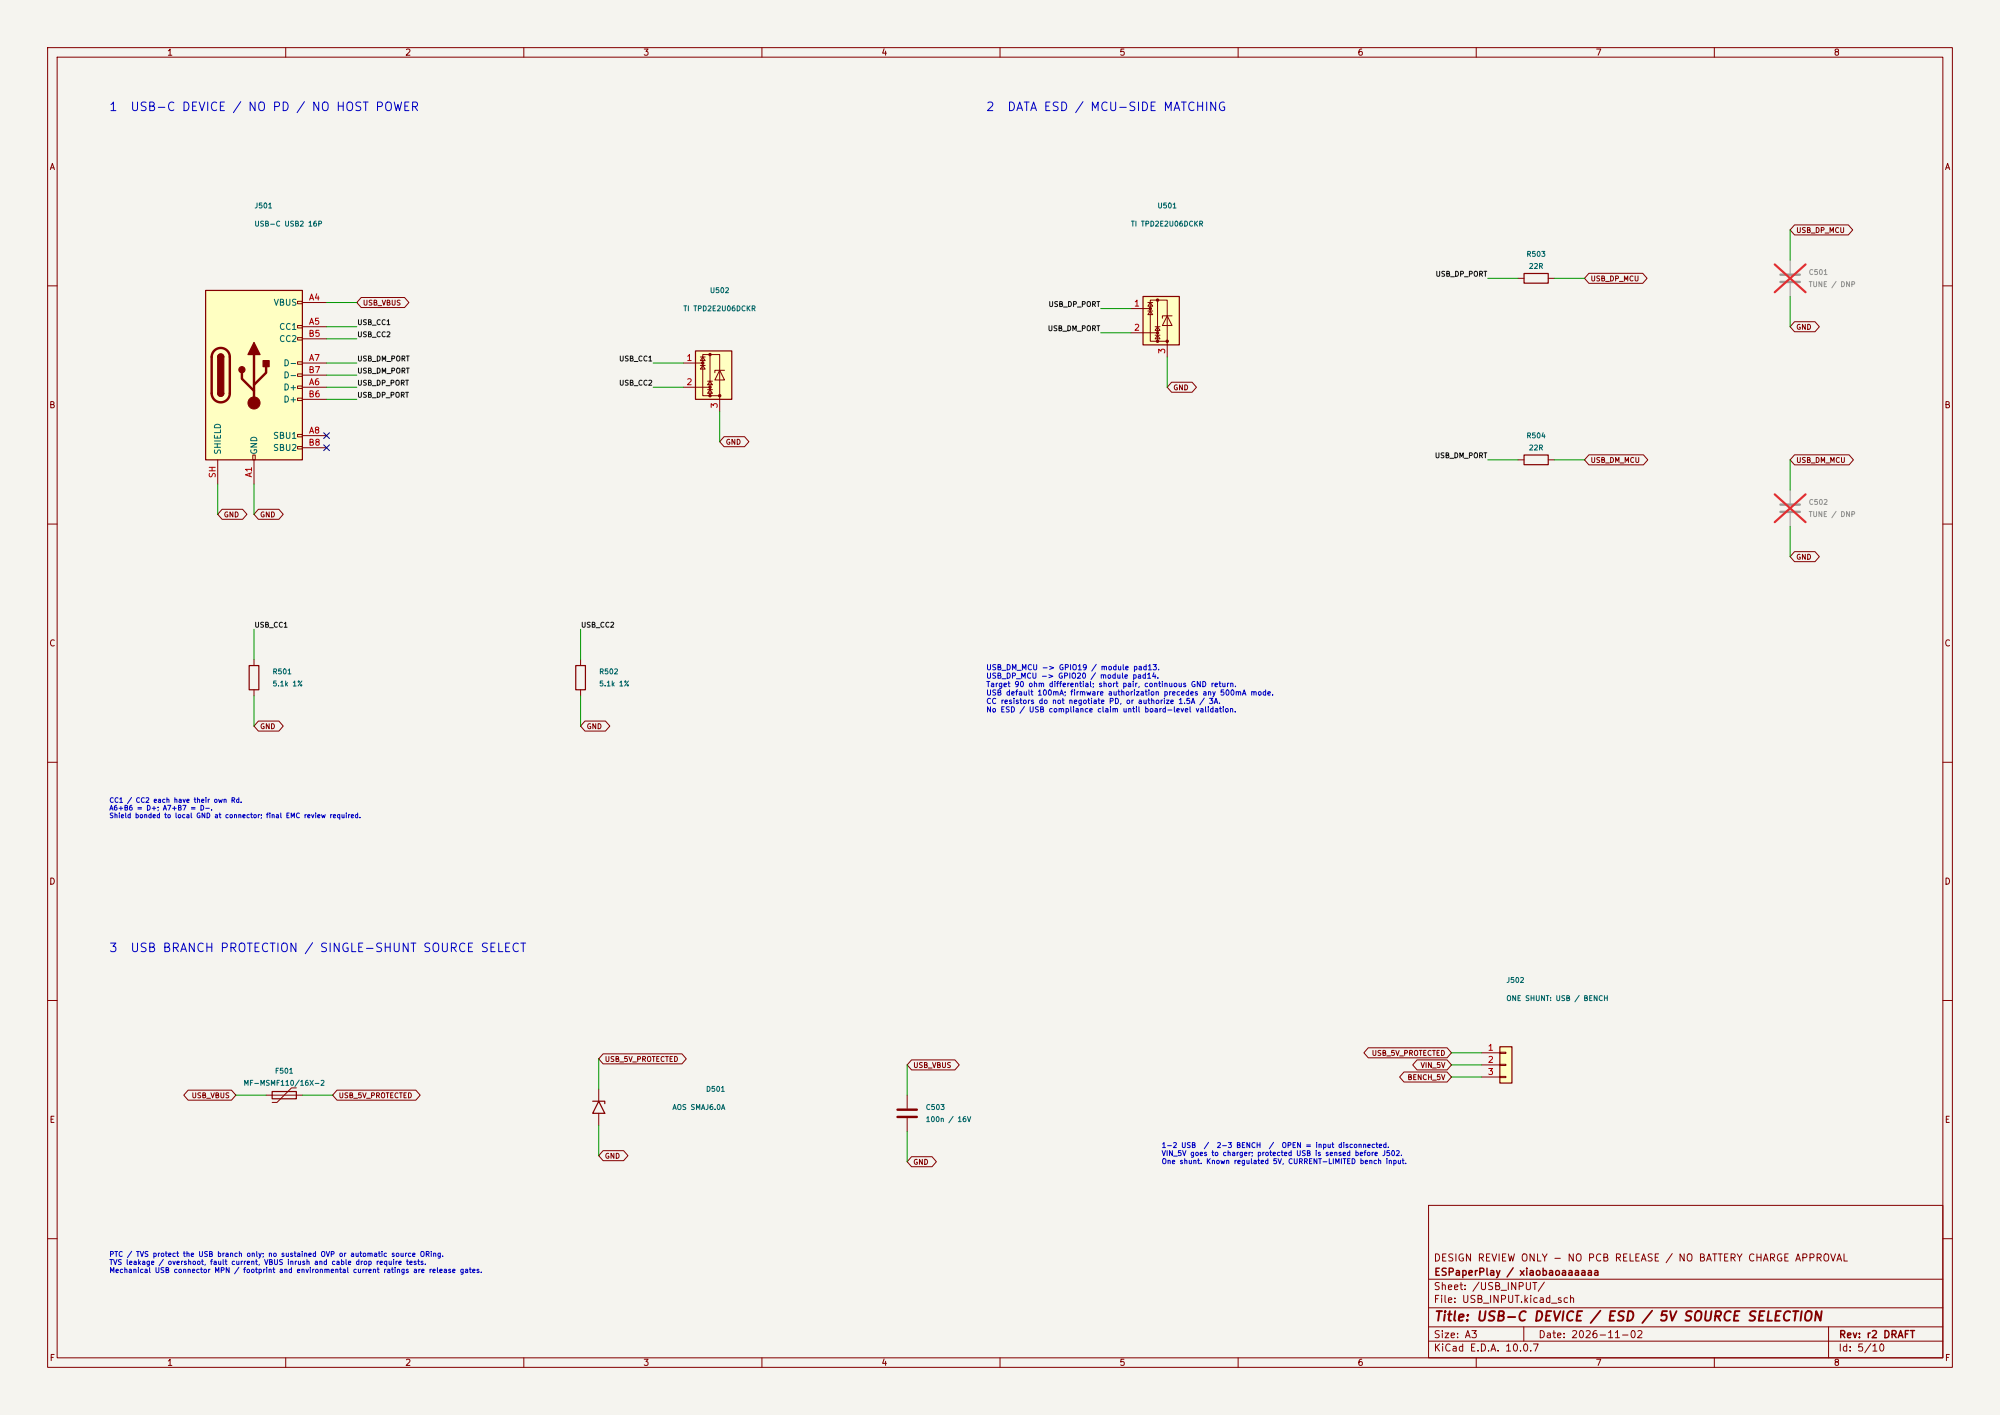
[picture p50: page 5]

1 USB-C DEVICE / NO PD / NO HOST POWER

Target 90 ohm differential; short pair, continuous GND return. USB default 100mA; firmware authorization precedes any 500mA mode. CC resistors do not negotiate PD, or authorize 1.5A / 3A. No ESD / USB compliance claim until board-level validation.

CC1 / CC2 each have their own Rd. A6+B6 = D+; A7+B7 = D-. Shield bonded to local GND at connector; final EMC review required.

1-2 USB / 2-3 BENCH / OPEN = input disconnected. VIN_5V goes to charger; protected USB is sensed before J502. One shunt. Known regulated 5V, CURRENT-LIMITED bench input. 3 USB BRANCH PROTECTION / SINGLE-SHUNT SOURCE SELECT

J502 ONE SHUNT: USB / BENCH

PTC / TVS protect the USB branch only; no sustained OVP or automatic source ORing. TVS leakage / overshoot, fault current, VBUS inrush and cable drop require tests. Mechanical USB connector MPN / footprint and environmental current ratings are release gates.

DESIGN REVIEW ONLY - NO PCB RELEASE / NO BATTERY CHARGE APPROVAL
ESPaperPlay / xiaobaoaaaaaa
Sheet: /USB_INPUT/
File: USB_INPUT.kicad_sch
Title: USB-C DEVICE / ESD / 5V SOURCE SELECTION

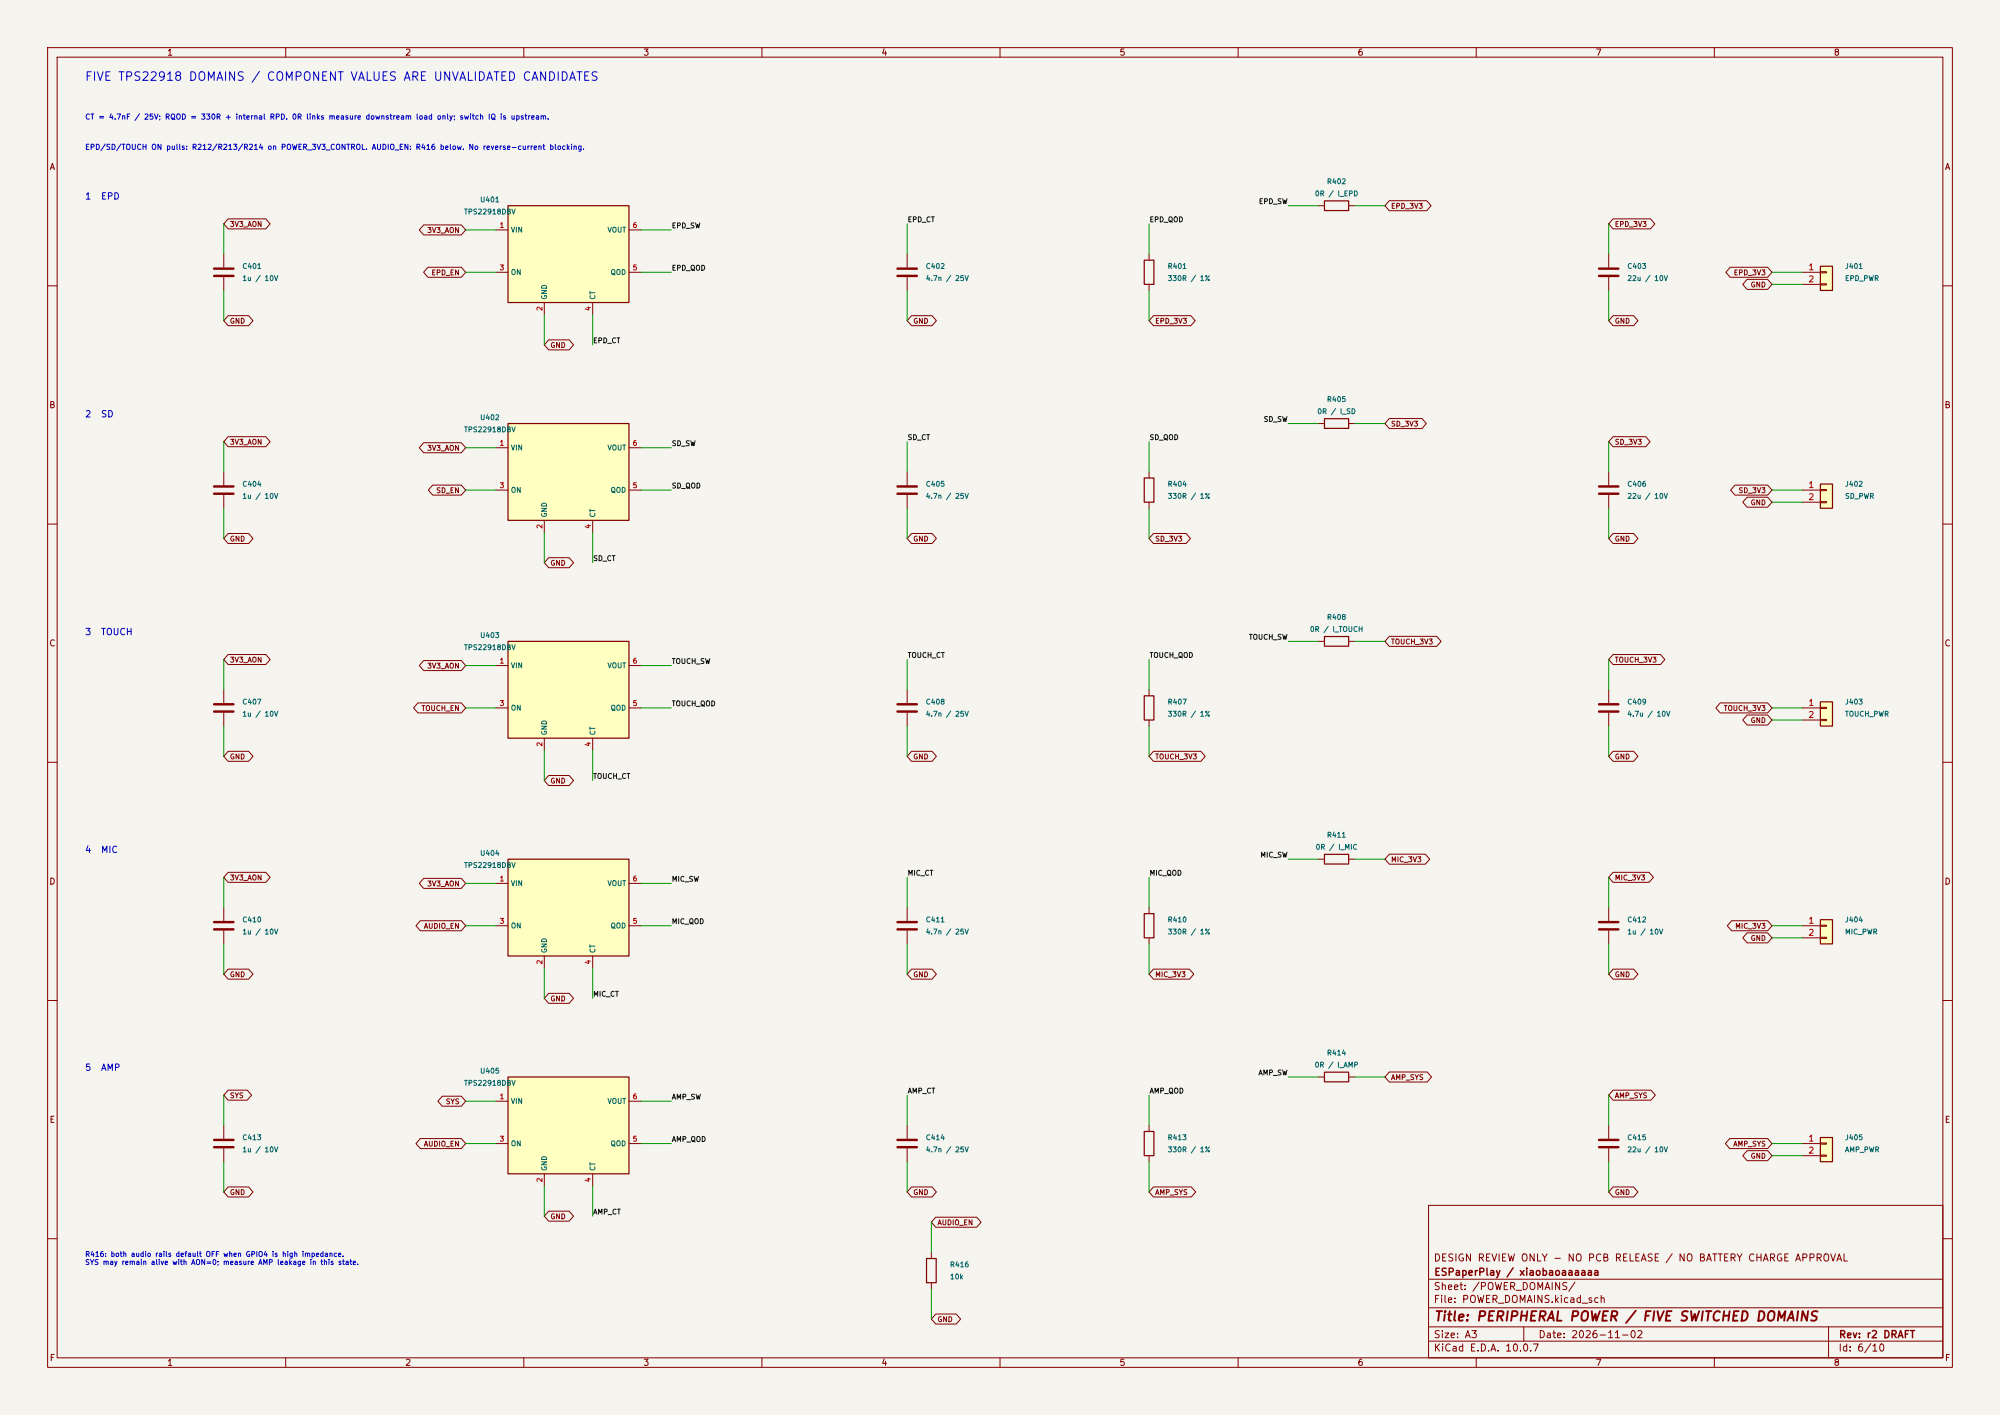
[picture p51: page 6]

FIVE TPS22918 DOMAINS / COMPONENT VALUES ARE UNVALIDATED CANDIDATES

CT = 4.7nF / 25V; RQOD = 330R + internal RPD. 0R links measure downstream load only; switch IQ is upstream. 2 SD

EPD/SD/TOUCH ON pulls: R212/R213/R214 on POWER_3V3_CONTROL. AUDIO_EN: R416 below. No reverse-current blocking. 1 EPD

R416: both audio rails default OFF when GPIO4 is high impedance. SYS may remain alive with AON=0; measure AMP leakage in this state. 4 MIC

DESIGN REVIEW ONLY - NO PCB RELEASE / NO BATTERY CHARGE APPROVAL
ESPaperPlay / xiaobaoaaaaaa
Sheet: /POWER_DOMAINS/
File: POWER_DOMAINS.kicad_sch
Title: PERIPHERAL POWER / FIVE SWITCHED DOMAINS

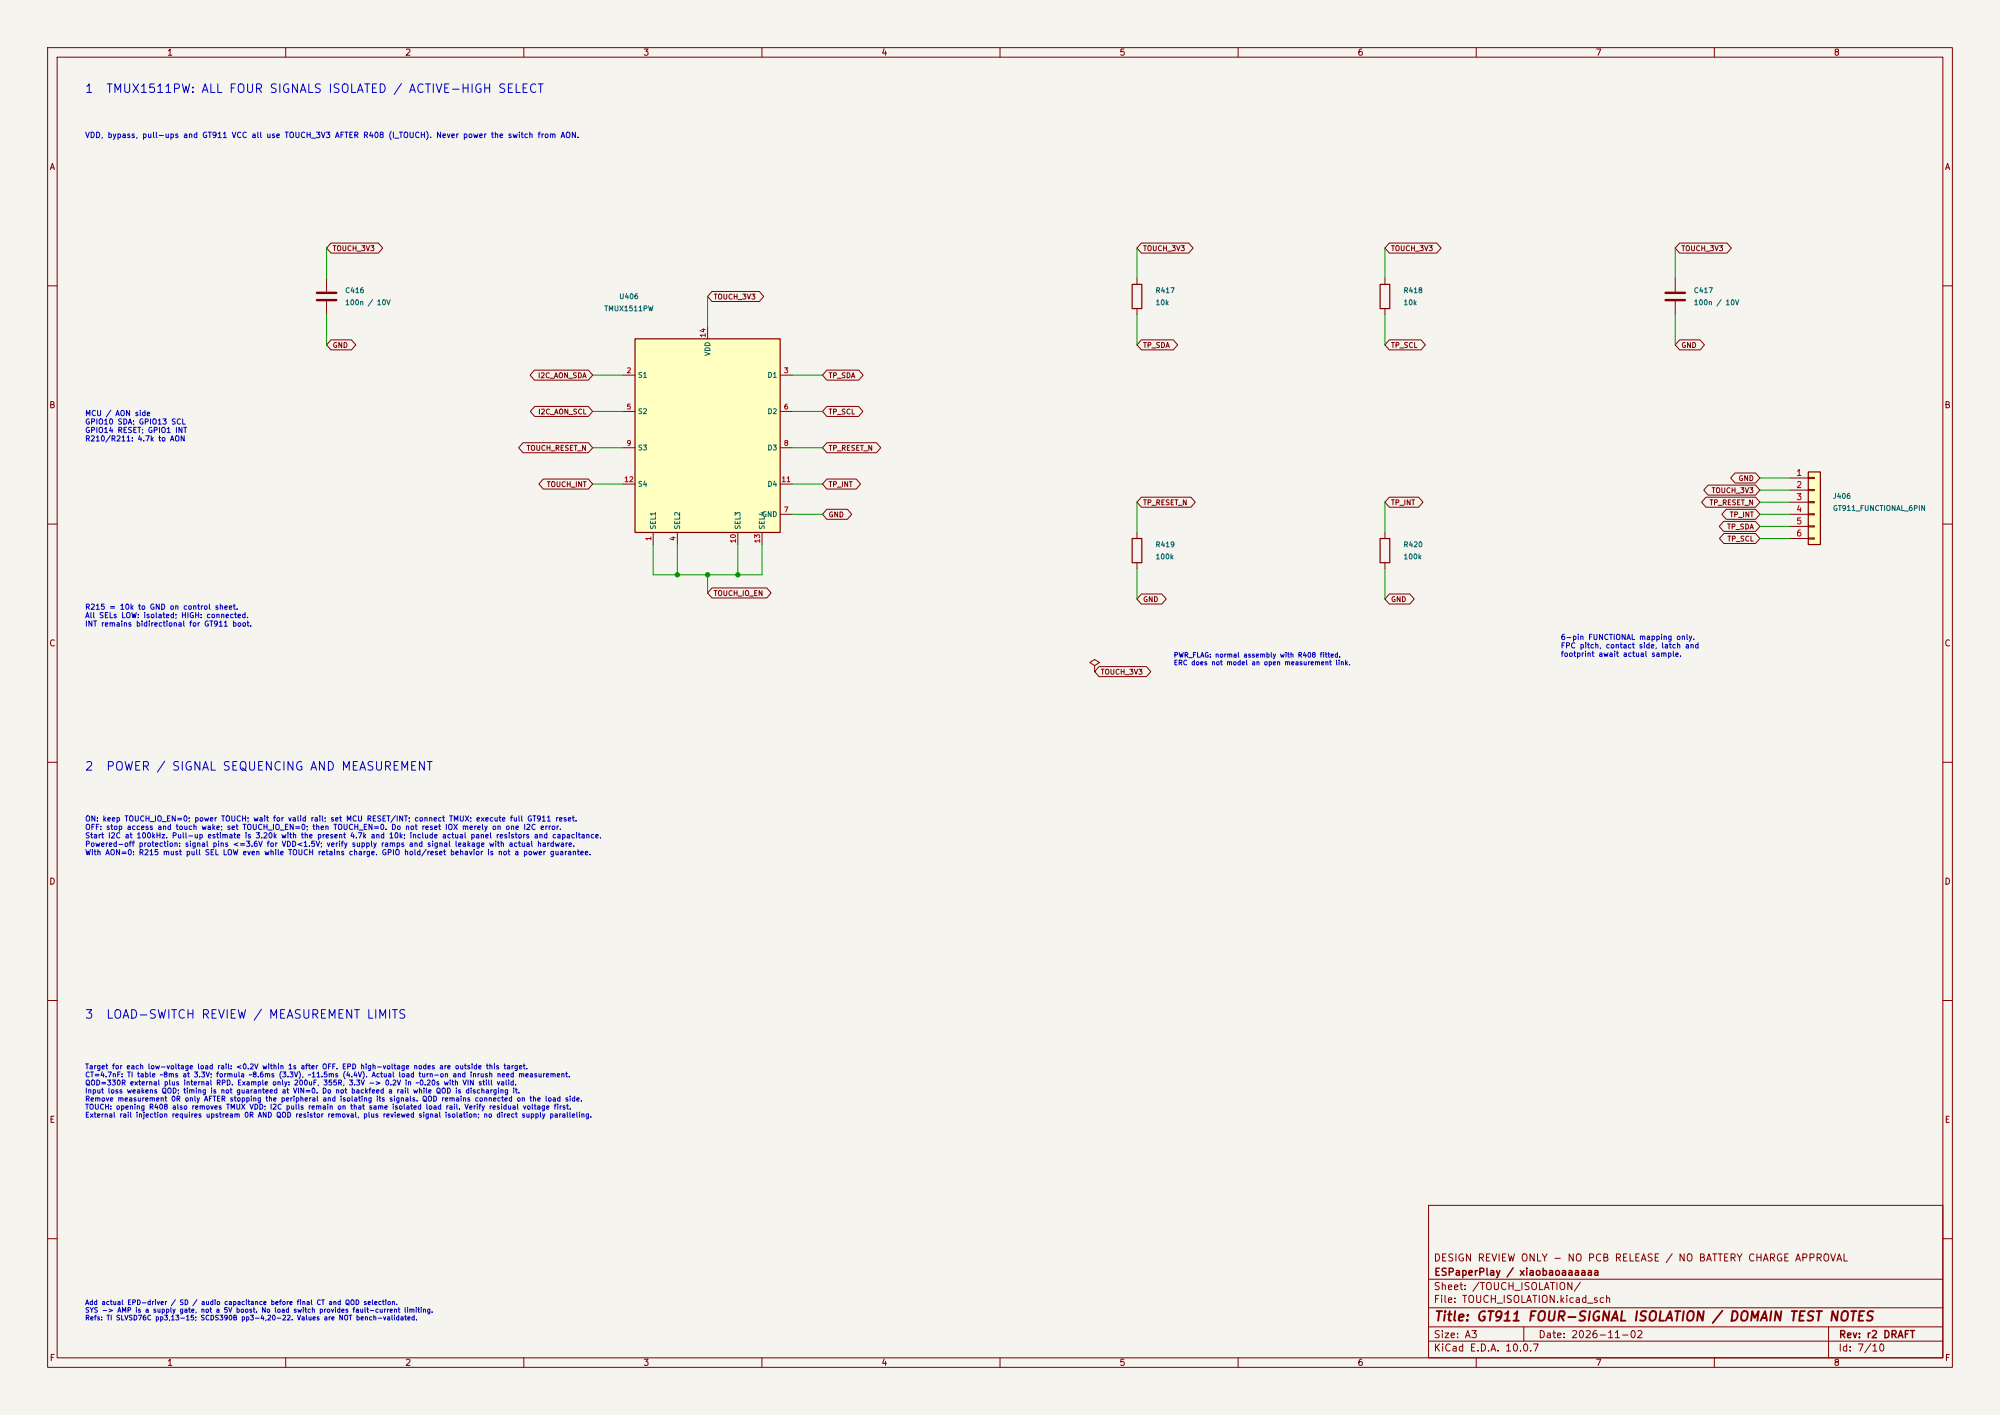
[picture p52: page 7]

1 TMUX1511PW: ALL FOUR SIGNALS ISOLATED / ACTIVE-HIGH SELECT

VDD, bypass, pull-ups and GT911 VCC all use TOUCH_3V3 AFTER R408 (I_TOUCH). Never power the switch from AON.

INT remains bidirectional for GT911 boot. MCU / AON side GPIO10 SDA; GPIO13 SCL GPIO14 RESET; GPIO1 INT R210/R211: 4.7k to AON

R215 = 10k to GND on control sheet. All SELs LOW: isolated; HIGH: connected.

6-pin FUNCTIONAL mapping only. FPC pitch, contact side, latch and

PWR_FLAG: normal assembly with R408 fitted. ERC does not model an open measurement link.

footprint await actual sample.

2 POWER / SIGNAL SEQUENCING AND MEASUREMENT

ON: keep TOUCH_IO_EN=0; power TOUCH; wait for valid rail; set MCU RESET/INT; connect TMUX; execute full GT911 reset. OFF: stop access and touch wake; set TOUCH_IO_EN=0; then TOUCH_EN=0. Do not reset IOX merely on one I2C error. Start I2C at 100kHz. Pull-up estimate is 3.20k with the present 4.7k and 10k; include actual panel resistors and capacitance. Powered-off protection: signal pins <=3.6V for VDD<1.5V; verify supply ramps and signal leakage with actual hardware. With AON=0: R215 must pull SEL LOW even while TOUCH retains charge. GPIO hold/reset behavior is not a power guarantee.

Input loss weakens QOD; timing is not guaranteed at VIN=0. Do not backfeed a rail while QOD is discharging it. Remove measurement 0R only AFTER stopping the peripheral and isolating its signals. QOD remains connected on the load side. TOUCH: opening R408 also removes TMUX VDD; I2C pulls remain on that same isolated load rail. Verify residual voltage first. External rail injection requires upstream 0R AND QOD resistor removal, plus reviewed signal isolation; no direct supply paralleling. 3 LOAD-SWITCH REVIEW / MEASUREMENT LIMITS

Add actual EPD-driver / SD / audio capacitance before final CT and QOD selection. SYS -> AMP is a supply gate, not a 5V boost. No load switch provides fault-current limiting. Refs: TI SLVSD76C pp3,13-15; SCDS390B pp3-4,20-22. Values are NOT bench-validated. Target for each low-voltage load rail: <0.2V within 1s after OFF. EPD high-voltage nodes are outside this target. CT=4.7nF: TI table ~8ms at 3.3V; formula ~8.6ms (3.3V), ~11.5ms (4.4V). Actual load turn-on and inrush need measurement. QOD=330R external plus internal RPD. Example only: 200uF, 355R, 3.3V -> 0.2V in ~0.20s with VIN still valid.

DESIGN REVIEW ONLY - NO PCB RELEASE / NO BATTERY CHARGE APPROVAL
ESPaperPlay / xiaobaoaaaaaa
Sheet: /TOUCH_ISOLATION/
File: TOUCH_ISOLATION.kicad_sch
Title: GT911 FOUR-SIGNAL ISOLATION / DOMAIN TEST NOTES

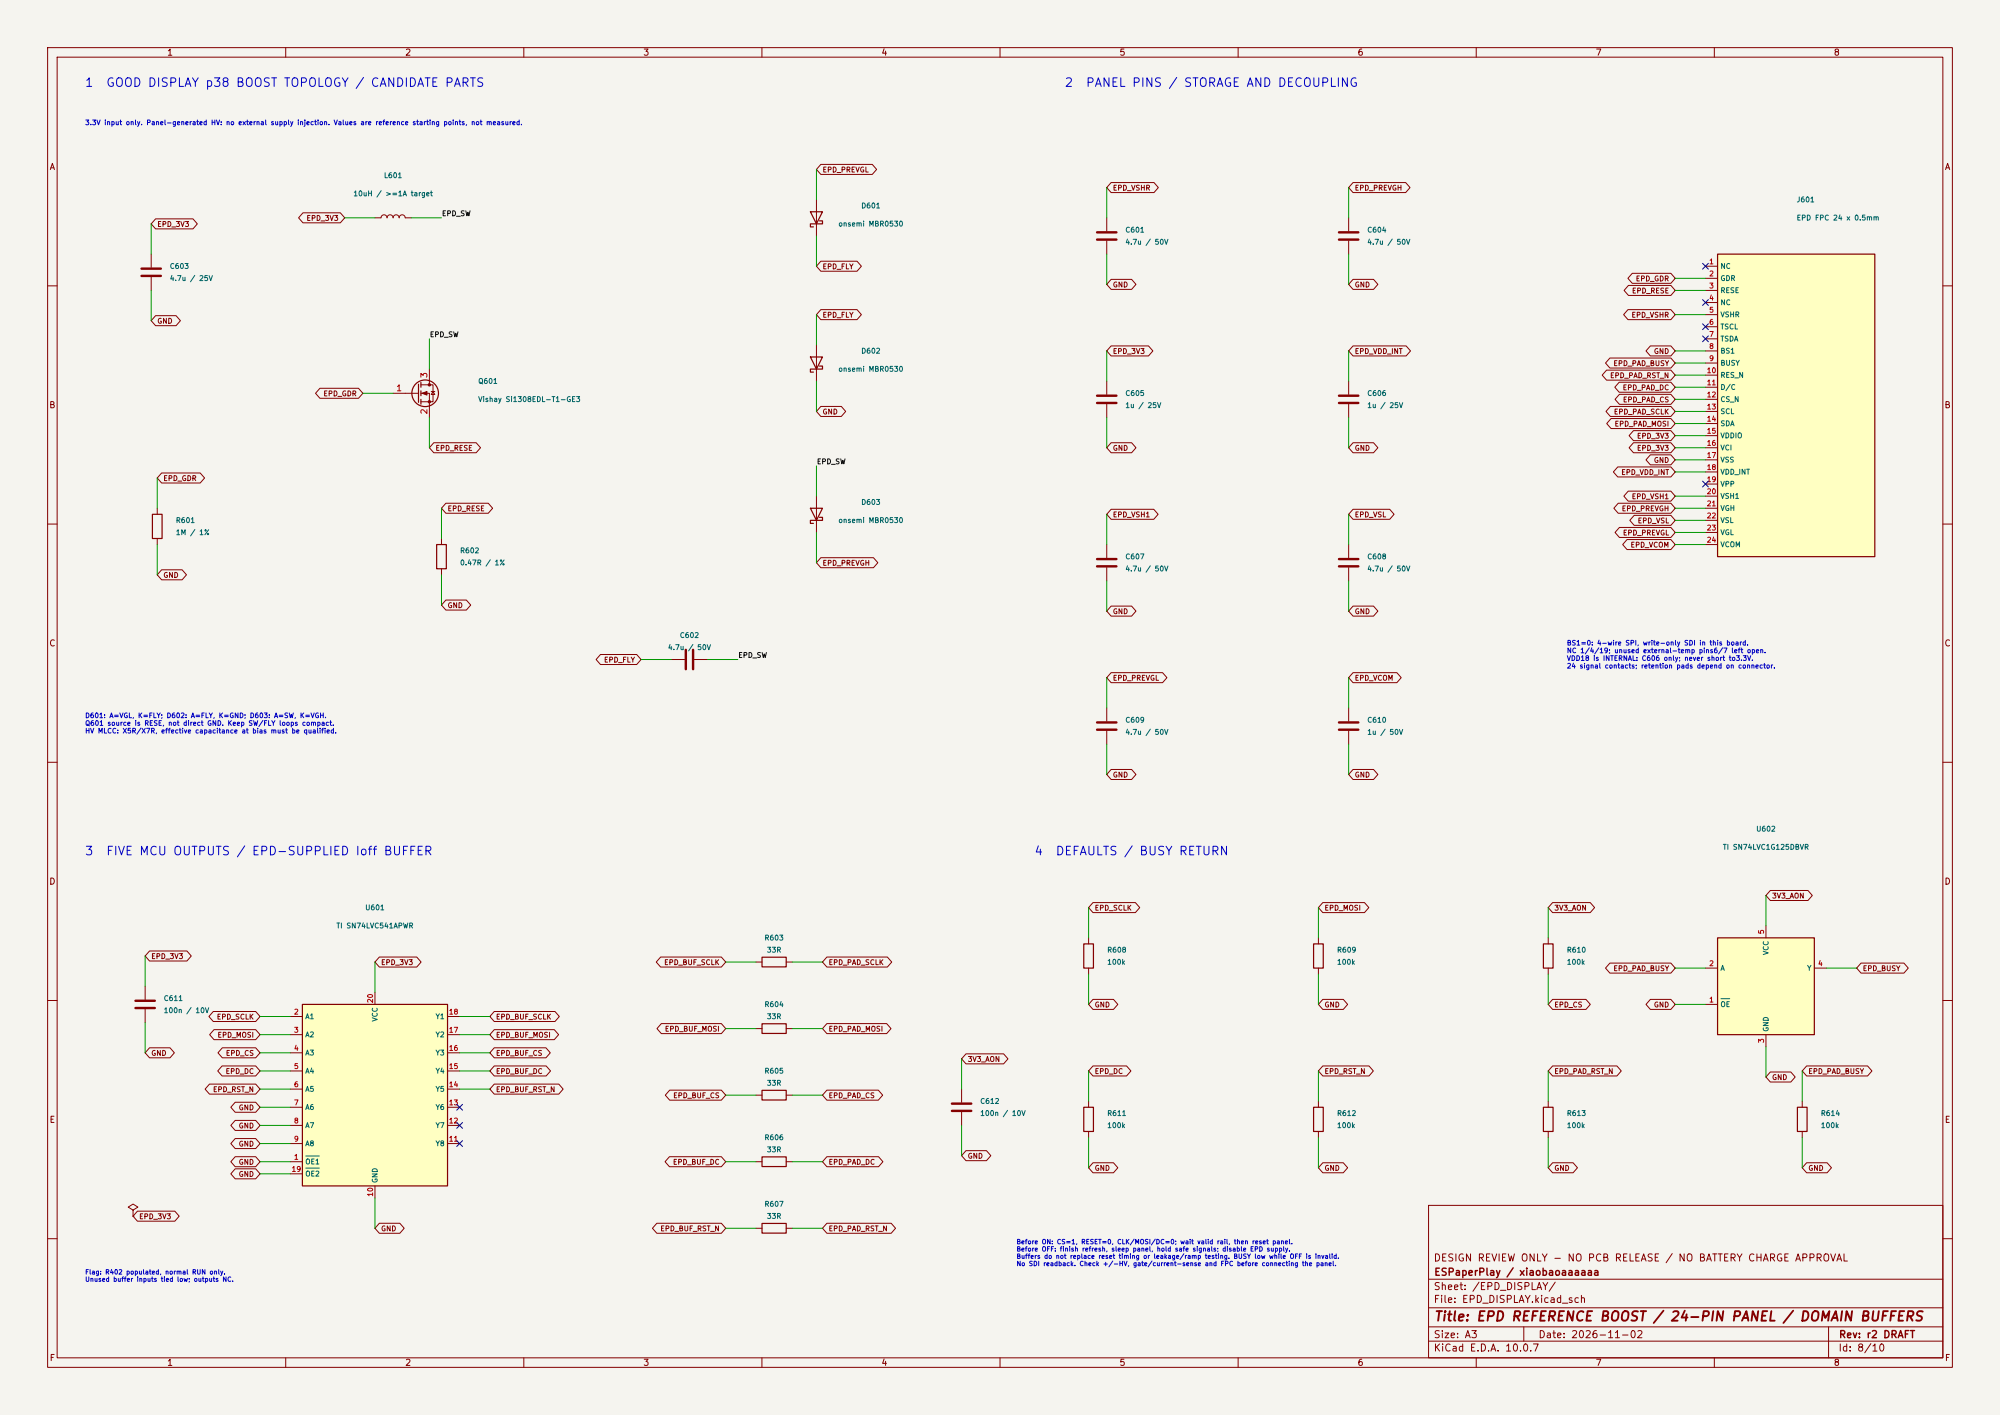
[picture p53: page 8]

Before ON: CS=1, RESET=0, CLK/MOSI/DC=0; wait valid rail, then reset panel. Before OFF: finish refresh, sleep panel, hold safe signals; disable EPD supply. Buffers do not replace reset timing or leakage/ramp testing. BUSY low while OFF is invalid. No SDI readback. Check +/-HV, gate/current-sense and FPC before connecting the panel. Flag: R402 populated, normal RUN only. Unused buffer inputs tied low; outputs NC.

DESIGN REVIEW ONLY - NO PCB RELEASE / NO BATTERY CHARGE APPROVAL
ESPaperPlay / xiaobaoaaaaaa
Sheet: /EPD_DISPLAY/
File: EPD_DISPLAY.kicad_sch
Title: EPD REFERENCE BOOST / 24-PIN PANEL / DOMAIN BUFFERS

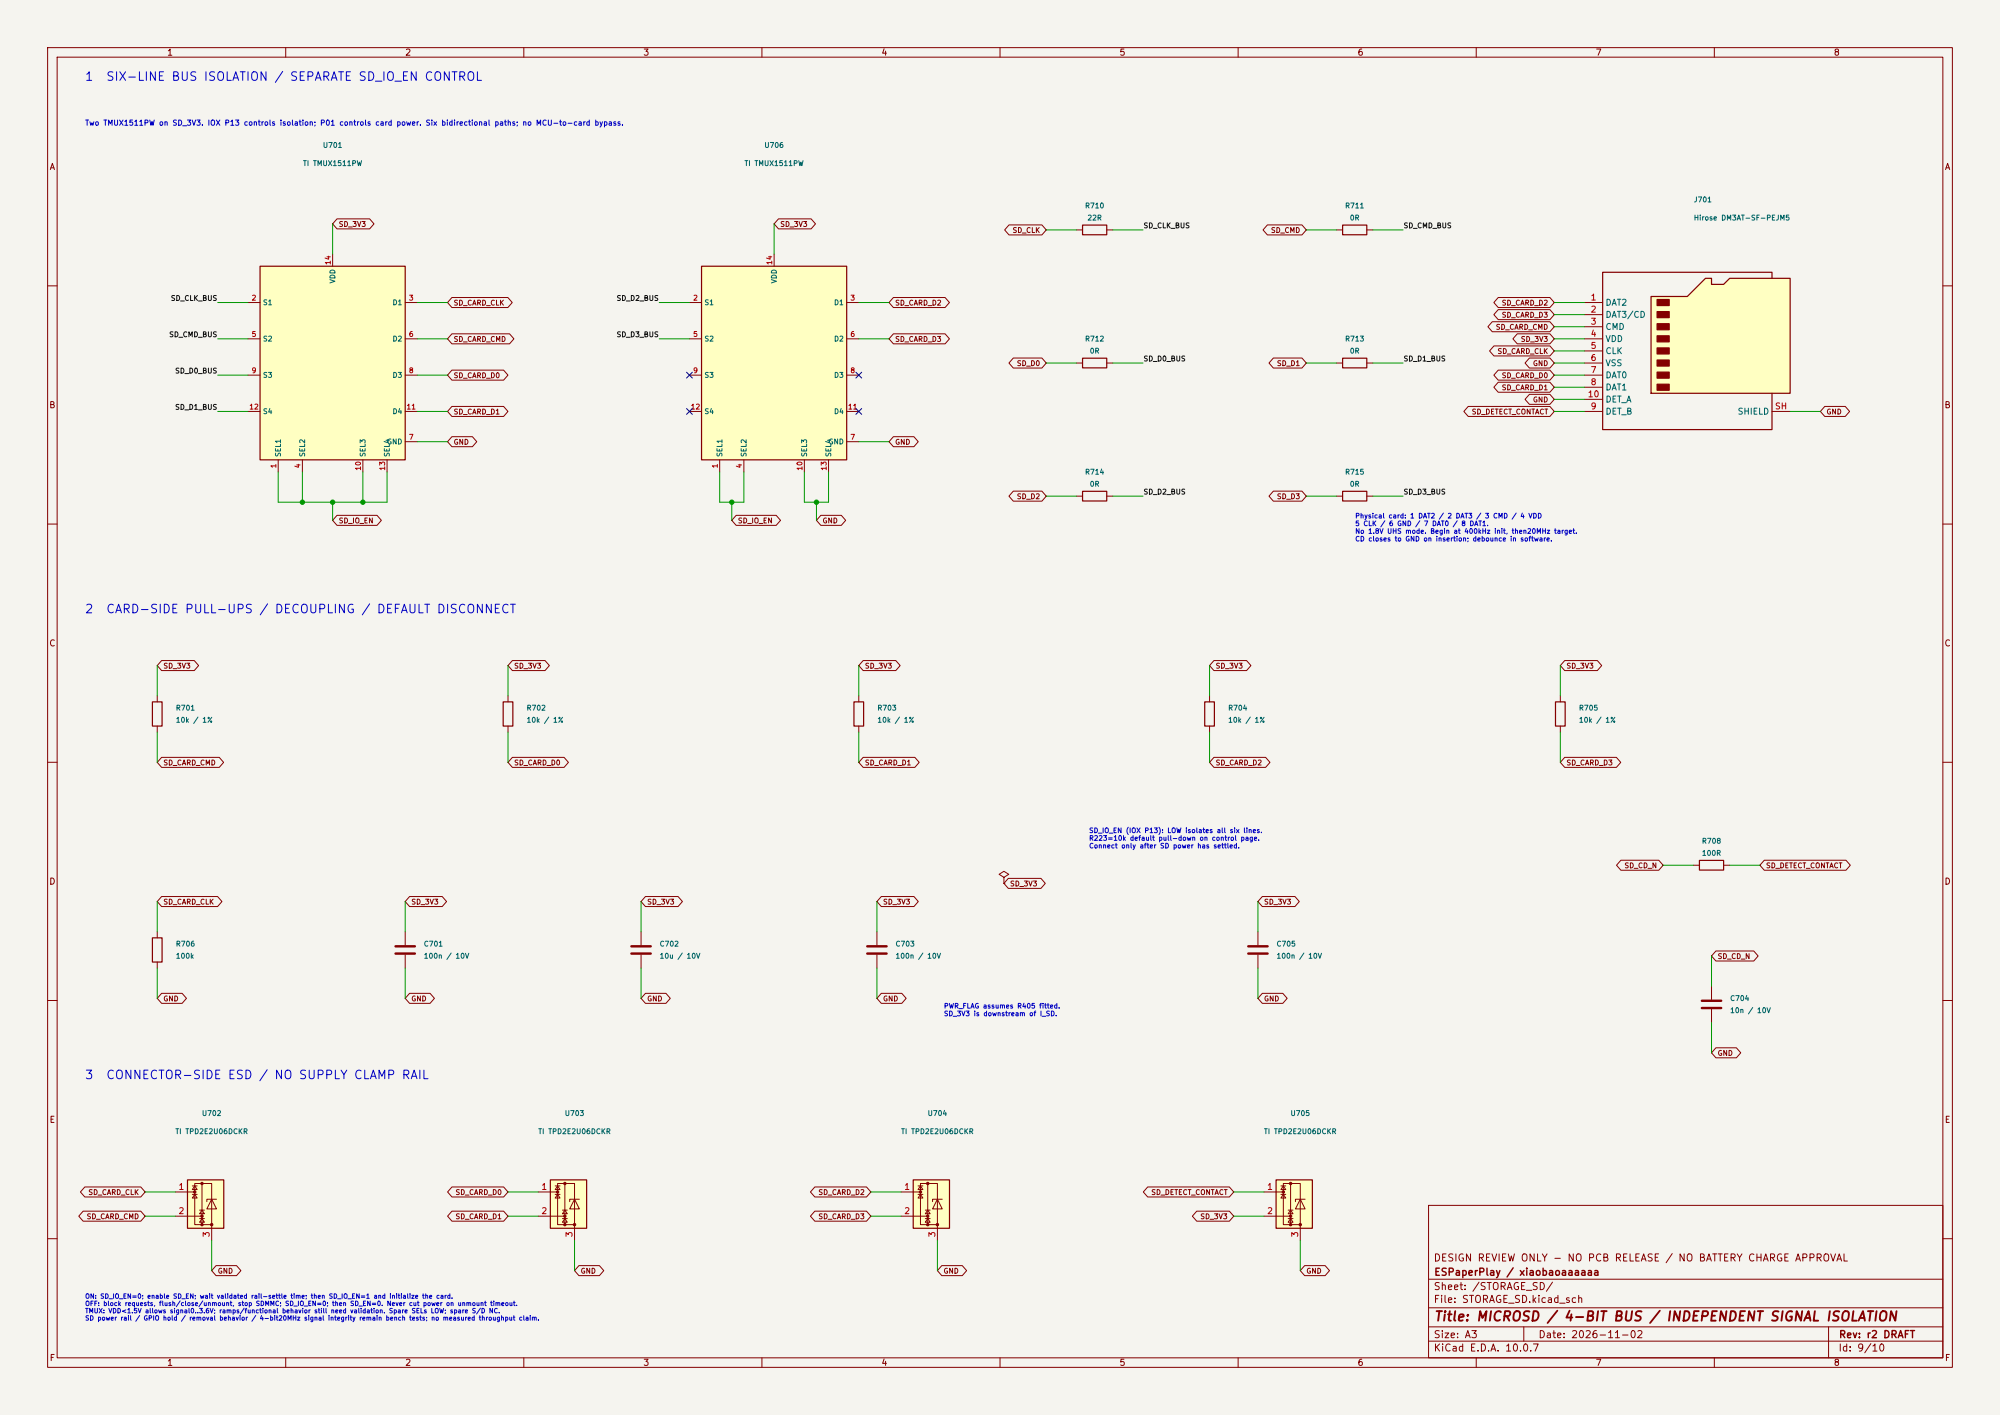
[picture p54: page 9]

5 CLK / 6 GND / 7 DAT0 / 8 DAT1. No 1.8V UHS mode. Begin at 400kHz init, then20MHz target. CD closes to GND on insertion; debounce in software. 1 SIX-LINE BUS ISOLATION / SEPARATE SD_IO_EN CONTROL

Two TMUX1511PW on SD_3V3. IOX P13 controls isolation; P01 controls card power. Six bidirectional paths; no MCU-to-card bypass.

2 CARD-SIDE PULL-UPS / DECOUPLING / DEFAULT DISCONNECT

3 CONNECTOR-SIDE ESD / NO SUPPLY CLAMP RAIL

DESIGN REVIEW ONLY - NO PCB RELEASE / NO BATTERY CHARGE APPROVAL
ESPaperPlay / xiaobaoaaaaaa
Sheet: /STORAGE_SD/
File: STORAGE_SD.kicad_sch
Title: MICROSD / 4-BIT BUS / INDEPENDENT SIGNAL ISOLATION

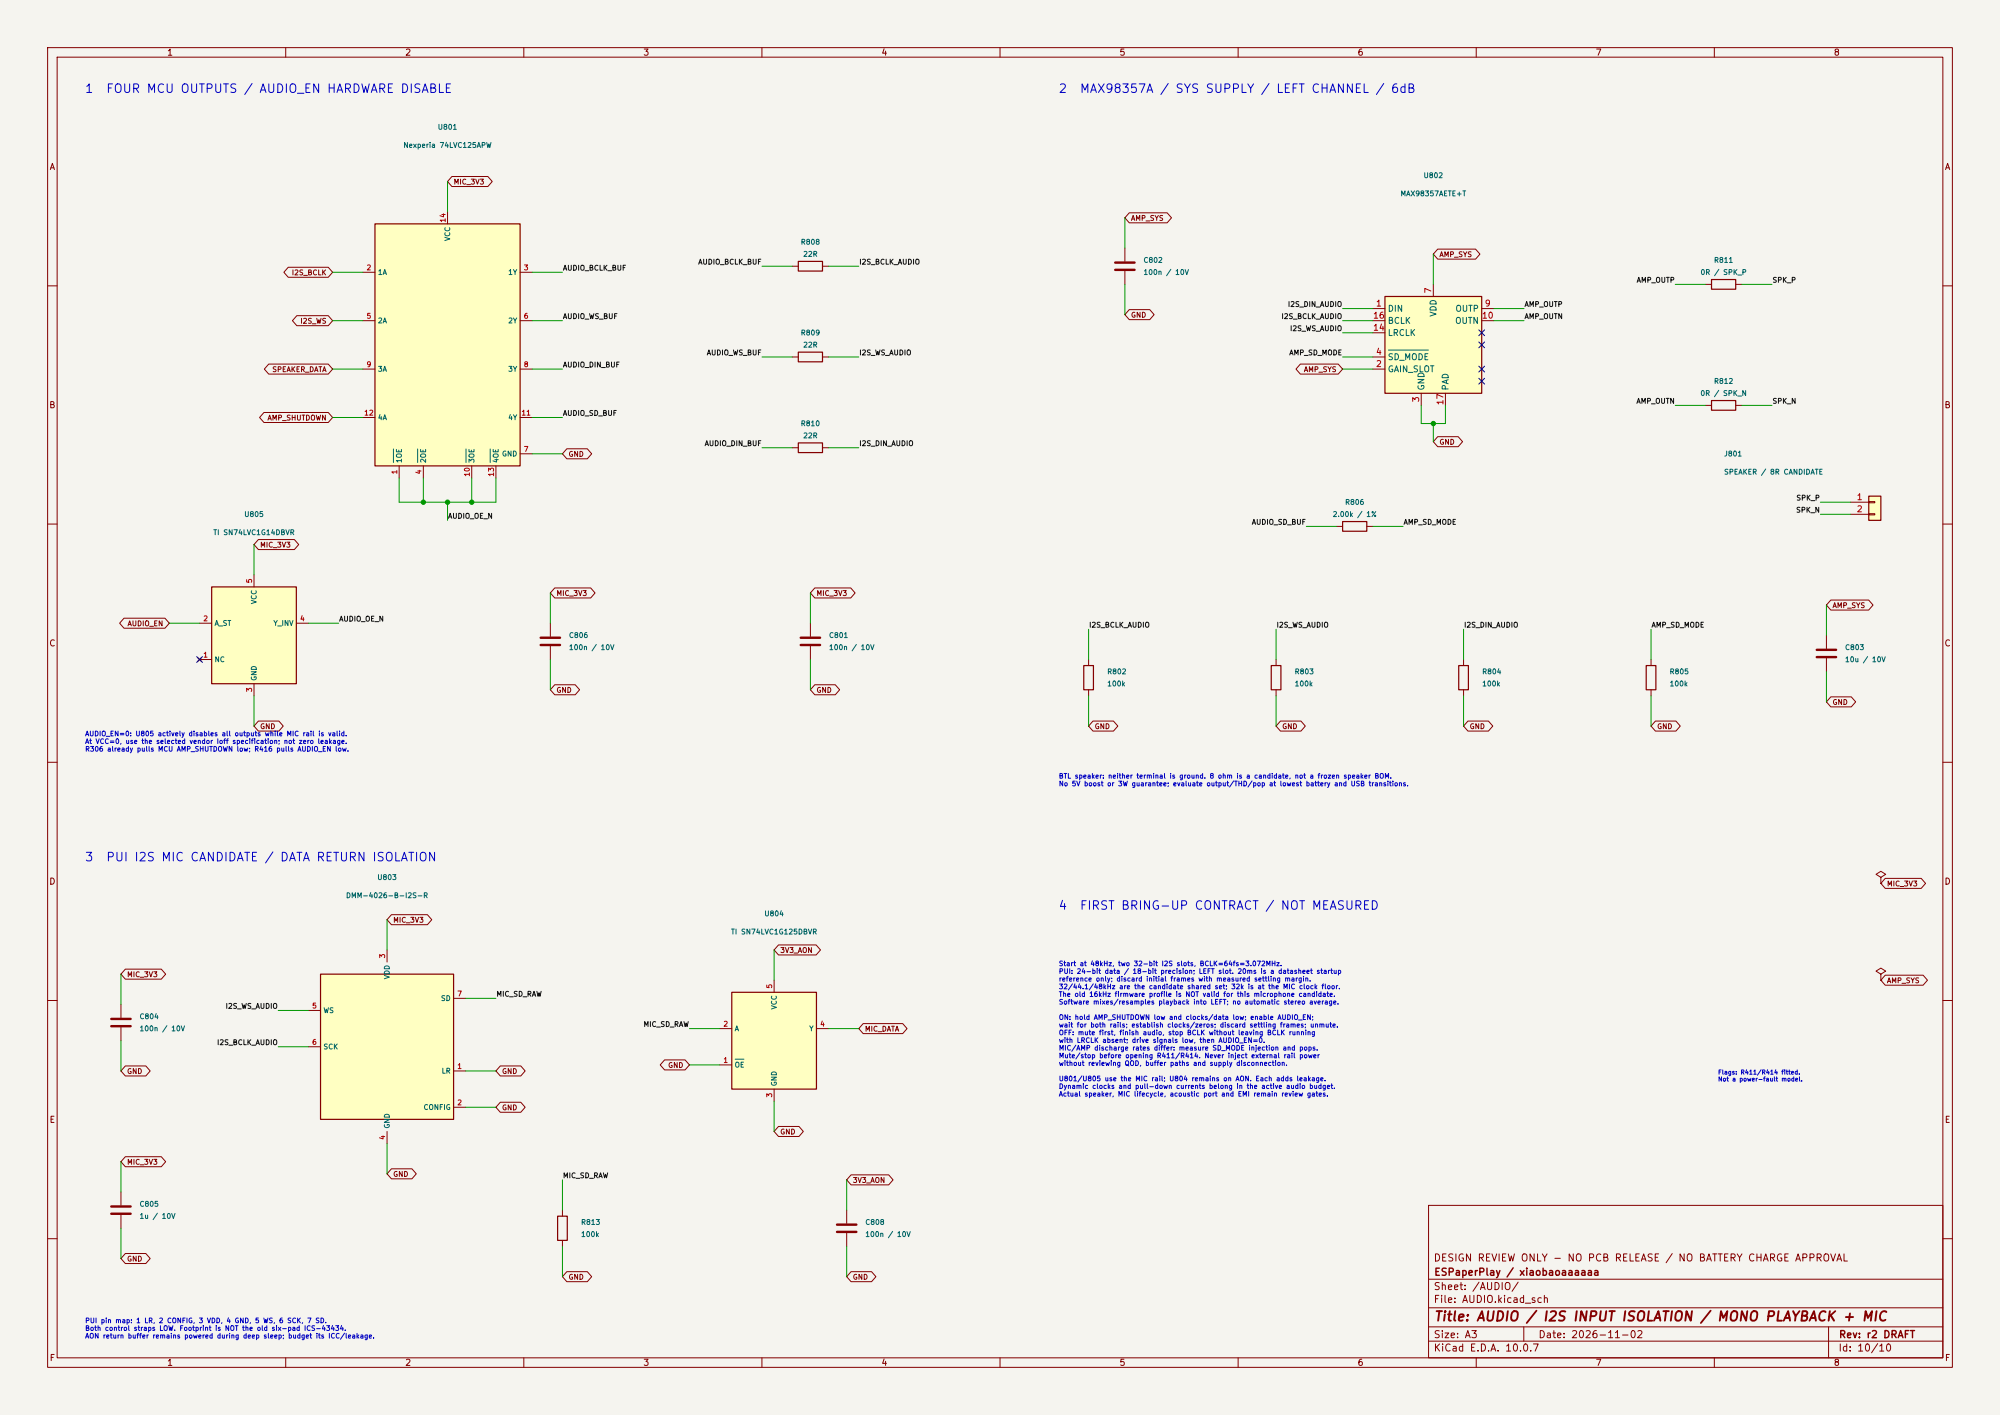
[picture p55: page 10]

BTL speaker: neither terminal is ground. 8 ohm is a candidate, not a frozen speaker BOM. No 5V boost or 3W guarantee; evaluate output/THD/pop at lowest battery and USB transitions. 4 FIRST BRING-UP CONTRACT / NOT MEASURED

reference only; discard initial frames with measured settling margin. 32/44.1/48kHz are the candidate shared set; 32k is at the MIC clock floor. The old 16kHz firmware profile is NOT valid for this microphone candidate. Software mixes/resamples playback into LEFT; no automatic stereo average. ON: hold AMP_SHUTDOWN low and clocks/data low; enable AUDIO_EN; wait for both rails; establish clocks/zeros; discard settling frames; unmute. OFF: mute first, finish audio, stop BCLK without leaving BCLK running with LRCLK absent; drive signals low, then AUDIO_EN=0. MIC/AMP discharge rates differ: measure SD_MODE injection and pops. Mute/stop before opening R411/R414. Never inject external rail power without reviewing QOD, buffer paths and supply disconnection. U801/U805 use the MIC rail; U804 remains on AON. Each adds leakage. Dynamic clocks and pull-down currents belong in the active audio budget. Actual speaker, MIC lifecycle, acoustic port and EMI remain review gates. 3 PUI I2S MIC CANDIDATE / DATA RETURN ISOLATION

Flags: R411/R414 fitted. Not a power-fault model.

DESIGN REVIEW ONLY - NO PCB RELEASE / NO BATTERY CHARGE APPROVAL
ESPaperPlay / xiaobaoaaaaaa
Sheet: /AUDIO/
File: AUDIO.kicad_sch
Title: AUDIO / I2S INPUT ISOLATION / MONO PLAYBACK + MIC

PUI pin map: 1 LR, 2 CONFIG, 3 VDD, 4 GND, 5 WS, 6 SCK, 7 SD. Both control straps LOW. Footprint is NOT the old six-pad ICS-43434. AON return buffer remains powered during deep sleep; budget its ICC/leakage.
