xiaobaoaaaaaa/ESPaperPlay-V2/hardware/devboard-r0/output/pdf/ESPaperPlay_Devboard_power_r0.pdf

1 | 2 | 3 | 4 | 5 | 6 | 7 | 8

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
Size: A3 | Rev: r0 DRAFT | F Date: 2026-11-01
KiCad E.D.A. 10.0.7 | Id: 1/3

# Title: ESPaperPlay DEVELOPMENT BOARD - POWER DRAFT

## File: ESPaperPlay_Devboard.kicad_sch

## Sheet: /

## ESPaperPlay / xiaobaoaaaaaa

## DESIGN REVIEW ONLY - NO PCB RELEASE / NO BATTERY CHARGE APPROVAL

POWER_INPUT_CHARGER 文件: POWER_INPUT_CHARGER.kicad_sch | POWER_3V3_CONTROL 文件: POWER_3V3_CONTROL.kicad_sch ESPaperPlay / DEVELOPMENT BOARD r0

Two editable power sheets. ESP32-S3-WROOM-1-N16R8 / GDEY075T7-T01.

DESIGN REVIEW ONLY: not a full board, not a manufacturing release.

## DEFINED IN THIS DRAFT

BQ24074 power path; protected battery / NTC interface; default charge inhibit. TPS63802 3.3 V regulator; measurement isolation; TCA9539 reset and control. MAX17048 battery gauge; AON-safe open-drain VBUS detector.
Cross-sheet global nets connect the two sheets; no hidden MCU connections.

## ASSEMBLY AND INTEGRATION GATES

R108 CHG_ARM: DNP until the actual cell and NTC temperature window are approved. J105 RECOVERY_CE: normally open. J202 MAIN_RUN: one shunt, 1-2 RUN / 2-3 OFF. USB-C protection, MCU, domain load switches, touch isolation and audio are not drawn yet.

Battery connector pinout, converter DLA footprint, power-link current ratings remain TBD. ERC checks schematic rules; it does not validate charging, thermal behavior or removable links. Design contract: docs/v2/hardware/power-design-spec.md Review instructions and exact release limits: hardware/devboard-r0/README.md

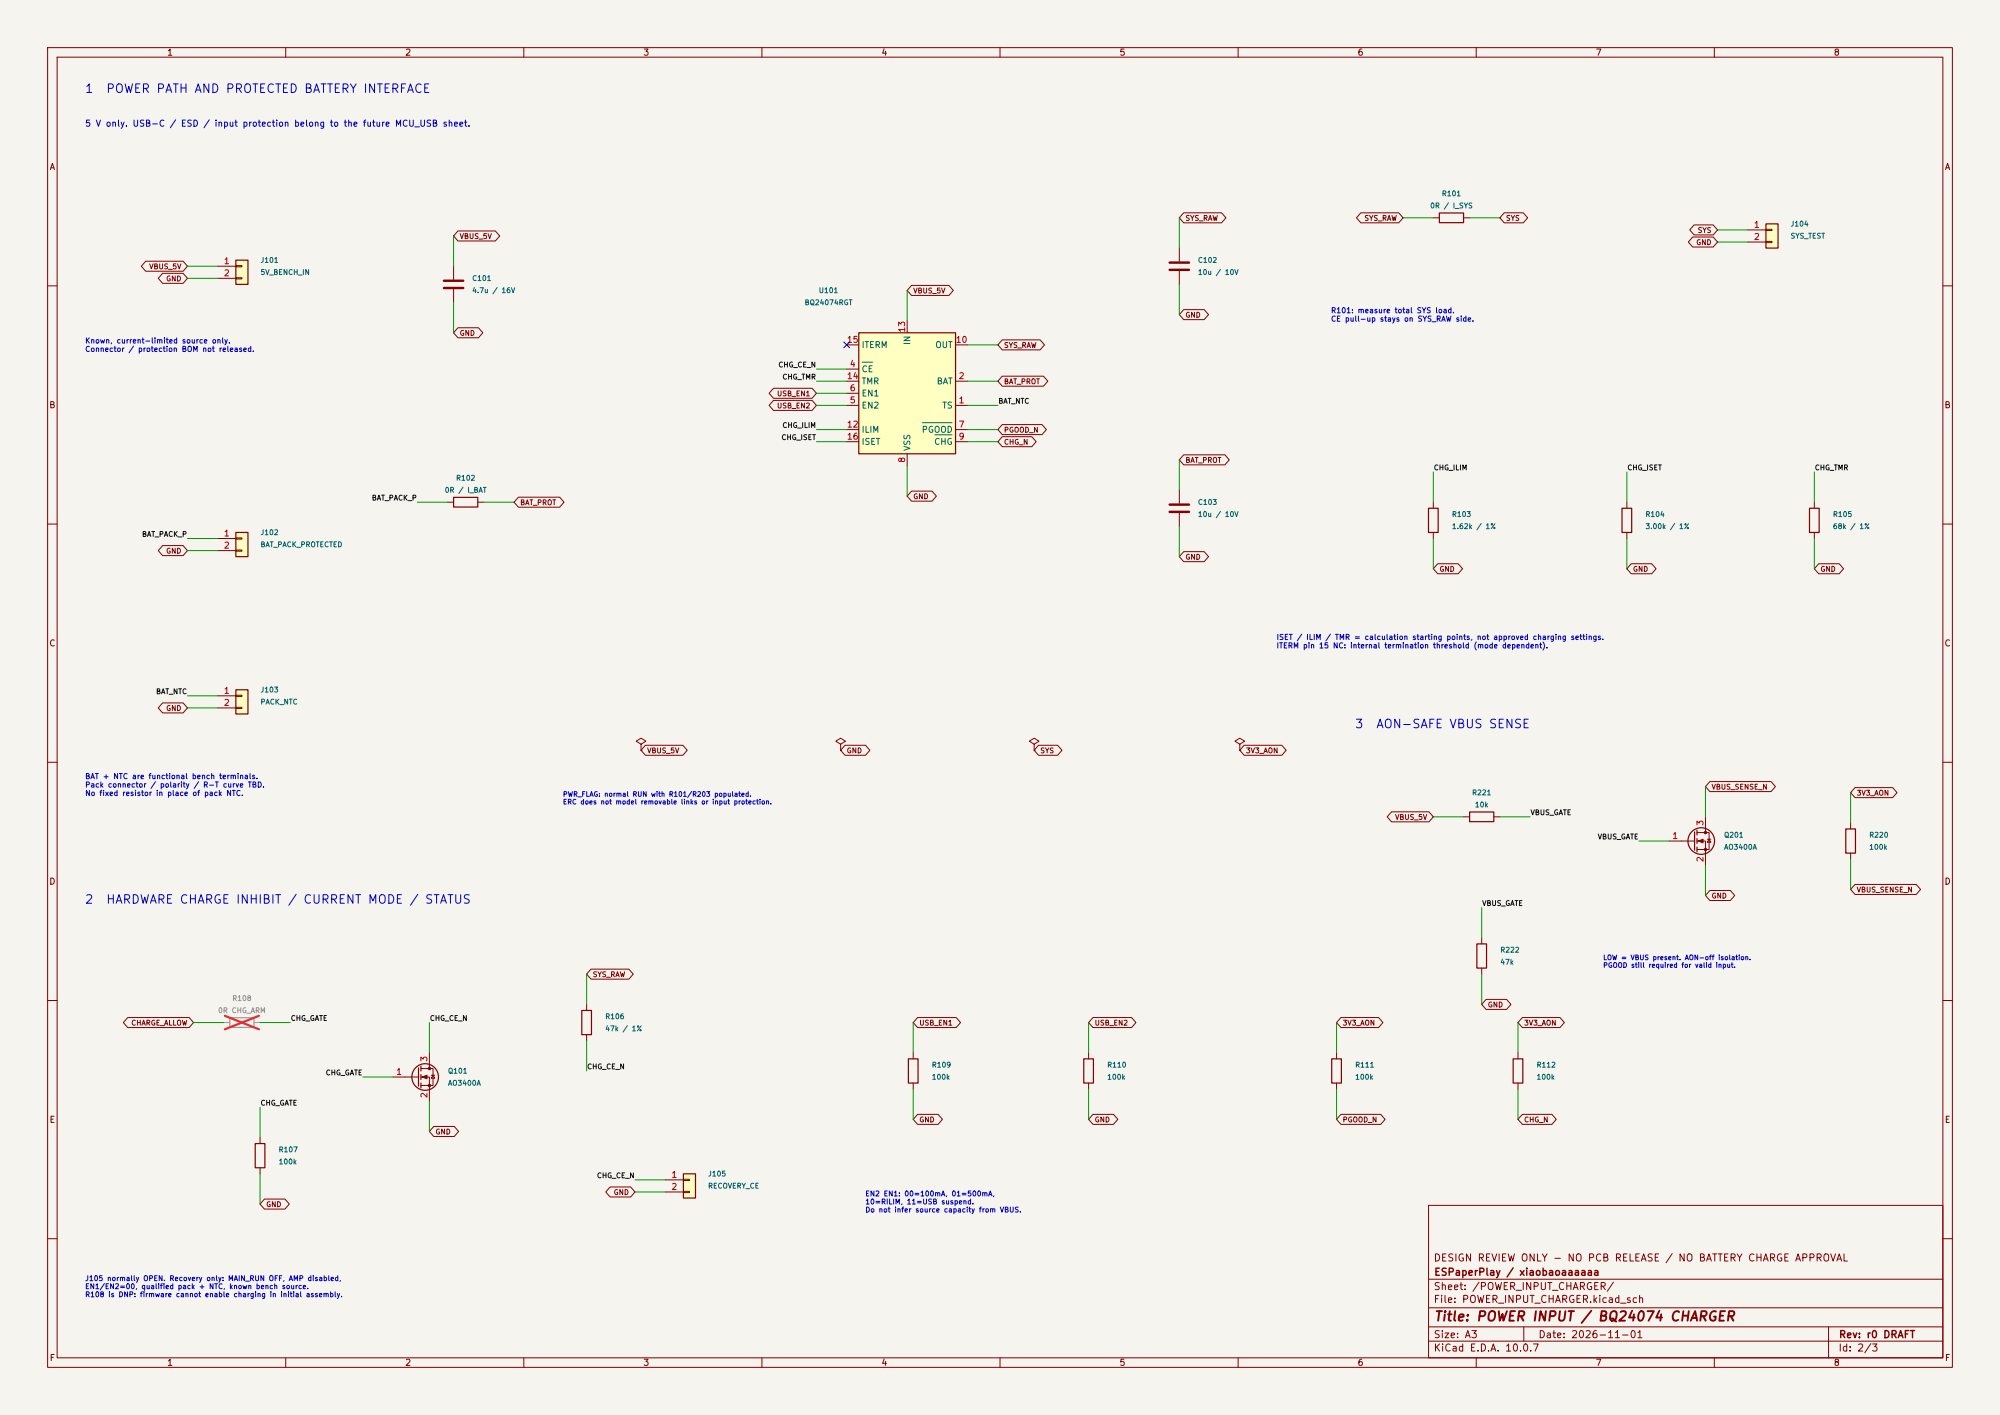
[picture p63: page 2]

1 POWER PATH AND PROTECTED BATTERY INTERFACE

5 V only. USB-C / ESD / input protection belong to the future MCU_USB sheet.

R101: measure total SYS load. CE pull-up stays on SYS_RAW side.

Known, current-limited source only. Connector / protection BOM not released.

CHG_ISET BAT_PACK_P 2 HARDWARE CHARGE INHIBIT / CURRENT MODE / STATUS

ISET / ILIM / TMR = calculation starting points, not approved charging settings.
ITERM pin 15 NC: internal termination threshold (mode dependent).

PWR_FLAG: normal RUN with R101/R203 populated. ERC does not model removable links or input protection. BAT + NTC are functional bench terminals. Pack connector / polarity / R-T curve TBD. No fixed resistor in place of pack NTC.

LOW = VBUS present. AON-off isolation. PGOOD still required for valid input.

DESIGN REVIEW ONLY - NO PCB RELEASE / NO BATTERY CHARGE APPROVAL
ESPaperPlay / xiaobaoaaaaaa
Sheet: /POWER_INPUT_CHARGER/
File: POWER_INPUT_CHARGER.kicad_sch
Title: POWER INPUT / BQ24074 CHARGER

J105 normally OPEN. Recovery only: MAIN_RUN OFF, AMP disabled, EN1/EN2=00, qualified pack + NTC, known bench source. R108 is DNP: firmware cannot enable charging in initial assembly.

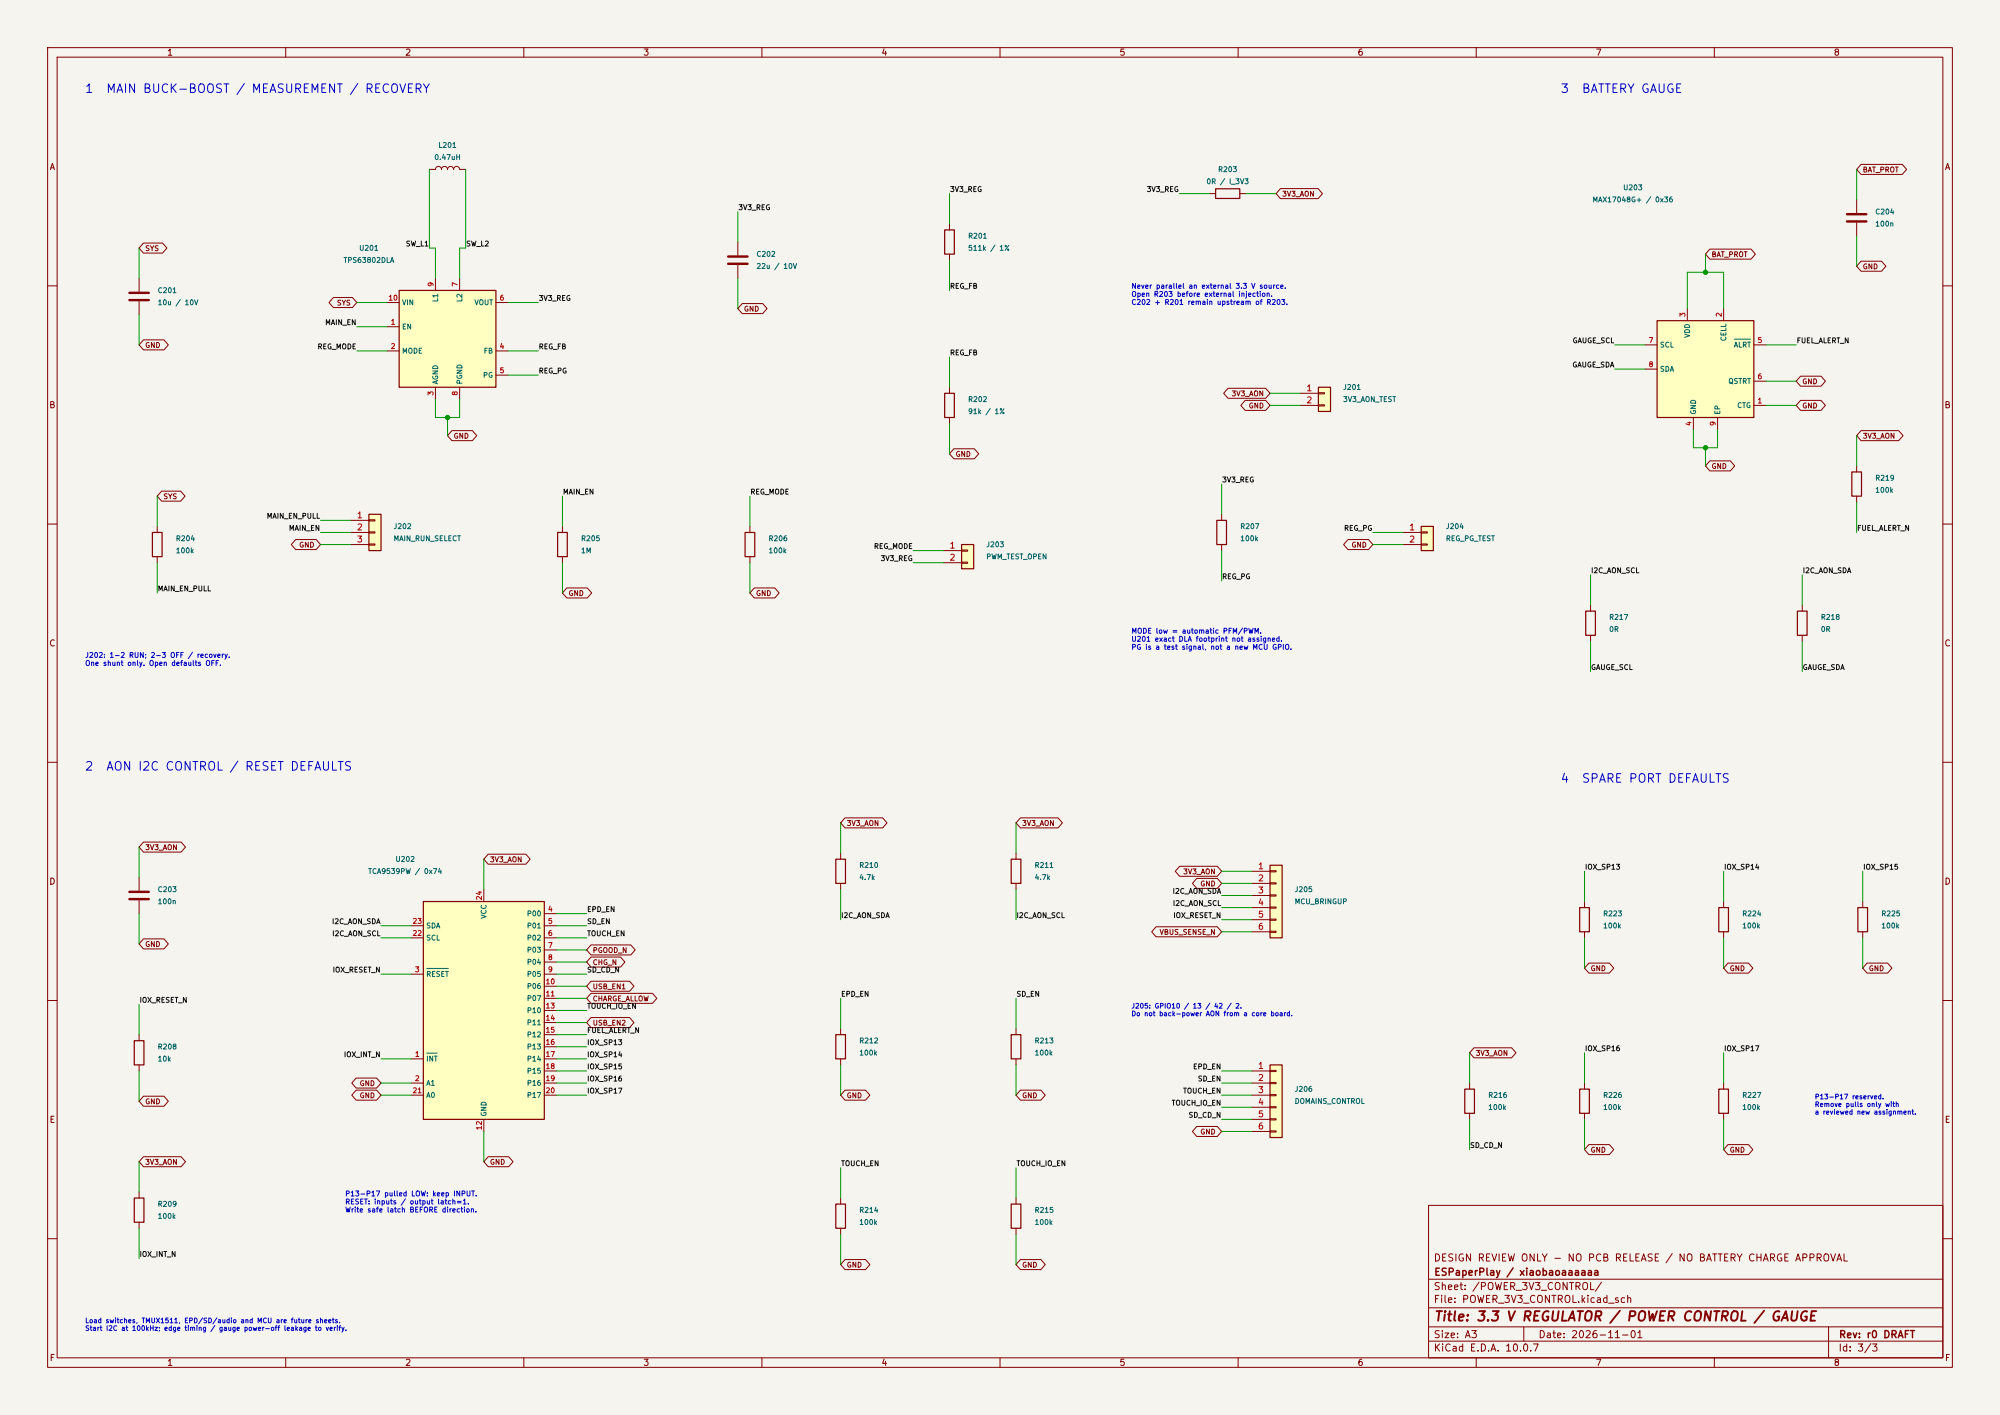
[picture p64: page 3]

1 MAIN BUCK-BOOST / MEASUREMENT / RECOVERY

MODE low = automatic PFM/PWM. U201 exact DLA footprint not assigned. PG is a test signal, not a new MCU GPIO.

SD_EN 2 AON I2C CONTROL / RESET DEFAULTS

P13-P17 reserved. Remove pulls only with

P13-P17 pulled LOW: keep INPUT. RESET: inputs / output latch=1. Write safe latch BEFORE direction.

DESIGN REVIEW ONLY - NO PCB RELEASE / NO BATTERY CHARGE APPROVAL
ESPaperPlay / xiaobaoaaaaaa
Sheet: /POWER_3V3_CONTROL/
File: POWER_3V3_CONTROL.kicad_sch
Title: 3.3 V REGULATOR / POWER CONTROL / GAUGE

Load switches, TMUX1511, EPD/SD/audio and MCU are future sheets. Start I2C at 100kHz; edge timing / gauge power-off leakage to verify.
