xiaobaoaaaaaa/ESPaperPlay-V2/hardware/devboard-r0/ESPaperPlay_Devboard.kicad_pcb

## KiCad design hardware/devboard-r0/ESPaperPlay_Devboard.kicad_pcb (2026-11-14)

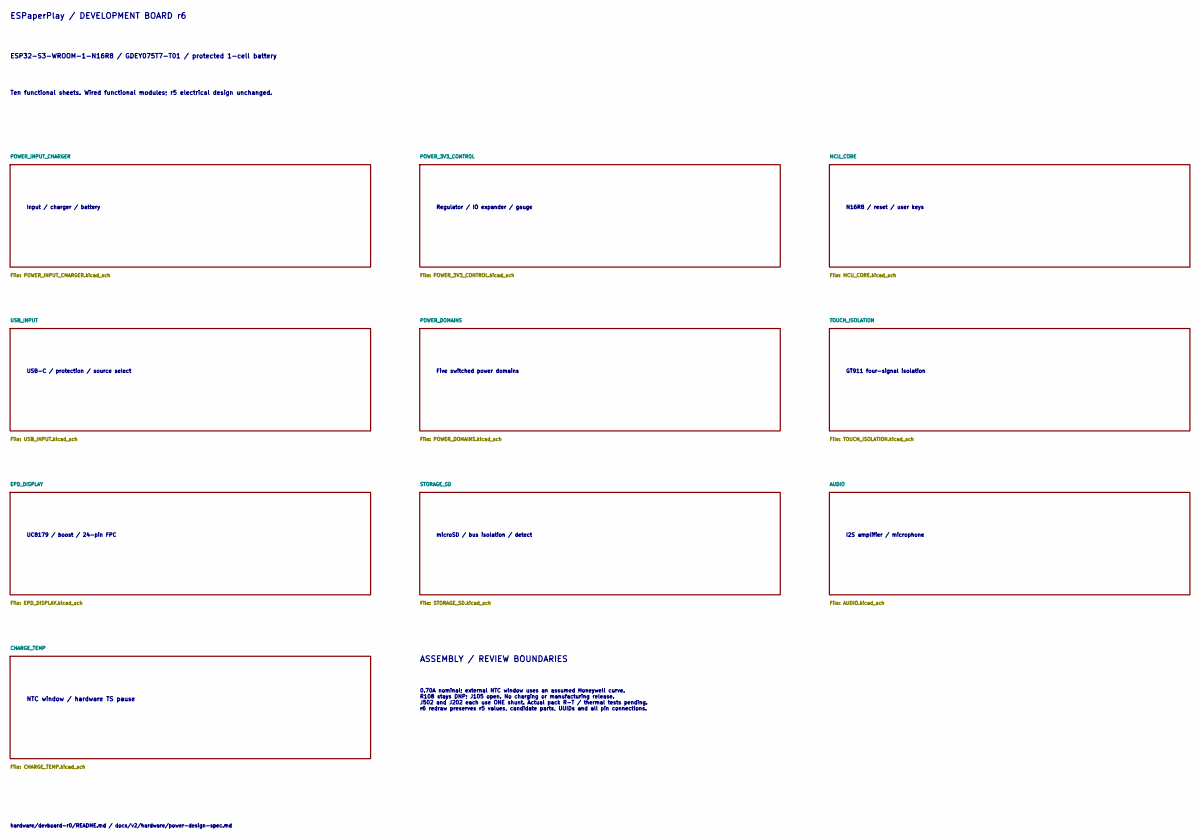
[picture p65: schematic ESPaperPlay_Devboard.kicad_sch, ESPaperPlay DEVELOPMENT BOARD - PERIPHERAL DRAFT]

Notes on the sheet:
ESPaperPlay / DEVELOPMENT BOARD r6
ESP32-S3-WROOM-1-N16R8 / GDEY075T7-T01 / protected 1-cell battery
Ten functional sheets. Wired functional modules; r5 electrical design unchanged.
Input / charger / battery
Regulator / IO expander / gauge
N16R8 / reset / user keys
USB-C / protection / source select
Five switched power domains
GT911 four-signal isolation
UC8179 / boost / 24-pin FPC
microSD / bus isolation / detect
I2S amplifier / microphone
ASSEMBLY / REVIEW BOUNDARIES
0.70A nominal; external NTC window uses an assumed Honeywell curve. R108 stays DNP; J105 open. No charging or manufacturing release. J502 and J202 each use ONE shunt. Actual pack R-T / thermal tests pending. r6 redraw preserves r5 values, candidate parts, UUIDs and all pin connections.
hardware/devboard-r0/README.md / docs/v2/hardware/power-design-spec.md
NTC window / hardware TS pause

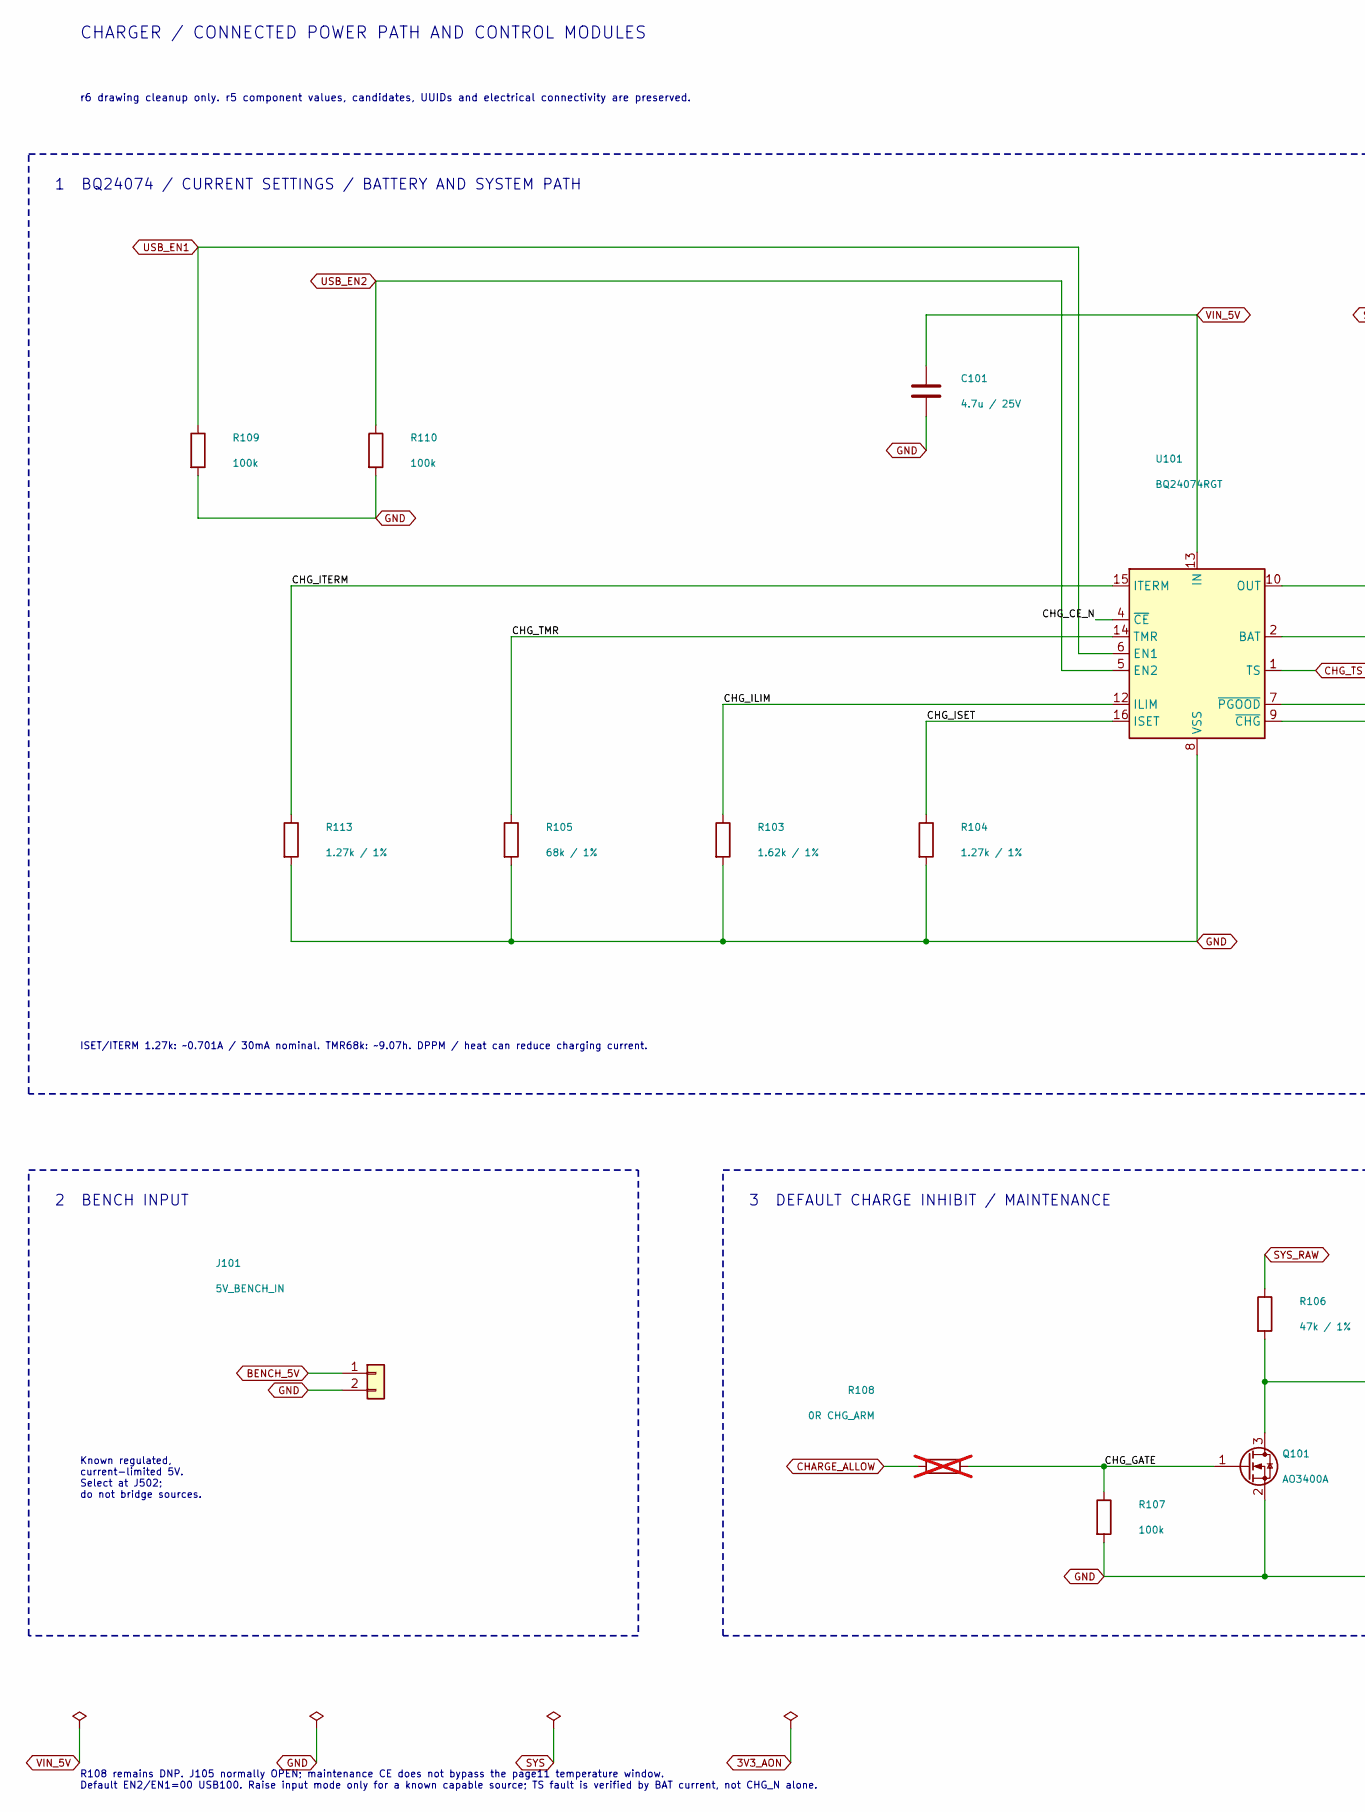
[picture p66: schematic POWER_INPUT_CHARGER.kicad_sch, POWER INPUT / BQ24074 CHARGER, part in row 1, column 1]

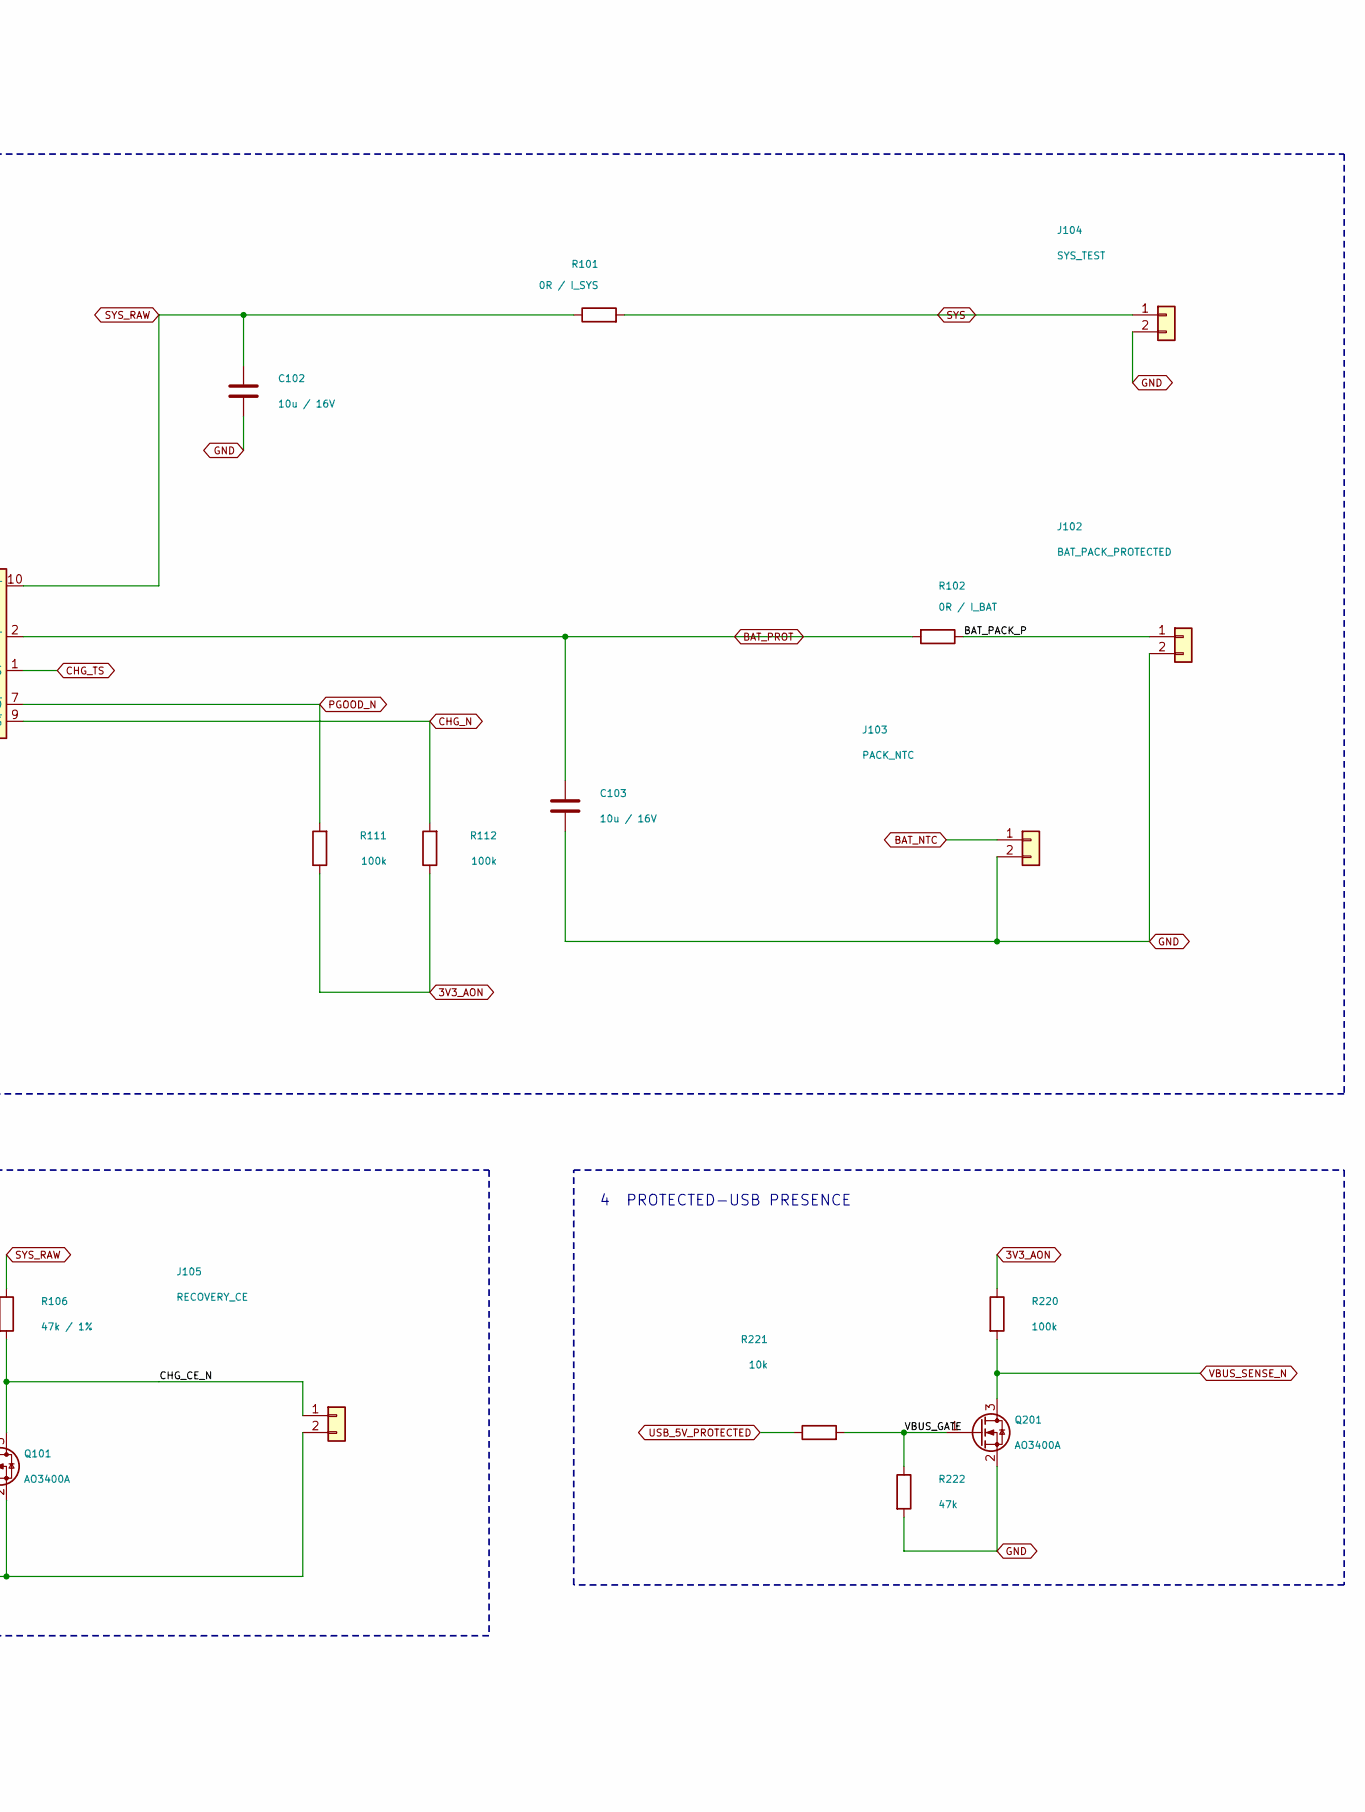
[picture p67: schematic POWER_INPUT_CHARGER.kicad_sch, POWER INPUT / BQ24074 CHARGER, part in row 1, column 2]

Parts:
C101: 4.7u / 25V; C_0805_2012Metric
C102, C103: 10u / 16V; C_1206_3216Metric
J101: 5V_BENCH_IN; WR_PHD_1x02_P2.54_Drill1.10
J102: BAT_PACK_PROTECTED; PhoenixContact_MKDS-1-2-3.5_1751248_1x02_P3.50mm_Horizontal
J103: PACK_NTC; PhoenixContact_MKDS-1-2-3.5_1751248_1x02_P3.50mm_Horizontal
J104: SYS_TEST; WR_PHD_1x02_P2.54_Drill1.10
J105: RECOVERY_CE; WR_PHD_1x02_P2.54_Drill1.10
Q101, Q201: AO3400A; AOS_SOT23_PO00001N
R101: 0R / I_SYS; Bourns_CRF0805_Jumper
R102: 0R / I_BAT; Bourns_CRF0805_Jumper
R103: 1.62k / 1%; R_0603_1608Metric
R104, R113: 1.27k / 1%; R_0603_1608Metric
R105: 68k / 1%; R_0603_1608Metric
R106: 47k / 1%; R_0603_1608Metric
R107, R109, R110, R111, R112, R220: 100k; R_0603_1608Metric
R108: 0R CHG_ARM; R_0603_1608Metric; not fitted
R221: 10k; R_0603_1608Metric
R222: 47k; R_0603_1608Metric
U101: BQ24074RGT; TI_RGT0016C_VQFN_3x3mm_P0.5mm_EP1.68mm

Connections:
3V3_AON: R111.1, R112.1, R220.1; also elsewhere on the board
/POWER_INPUT_CHARGER/BAT_PACK_P: J102.1, R102.1
/POWER_INPUT_CHARGER/CHG_CE_N: J105.1, Q101.3 (D), R106.2, U101.4 (~CE)
/POWER_INPUT_CHARGER/CHG_GATE: Q101.1 (G), R107.1, R108.2
/POWER_INPUT_CHARGER/CHG_ILIM: R103.1, U101.12 (ILIM)
/POWER_INPUT_CHARGER/CHG_ISET: R104.1, U101.16 (ISET)
/POWER_INPUT_CHARGER/CHG_ITERM: R113.1, U101.15 (ITERM)
/POWER_INPUT_CHARGER/CHG_TMR: R105.1, U101.14 (TMR)
/POWER_INPUT_CHARGER/VBUS_GATE: Q201.1 (G), R221.2, R222.1
BAT_NTC: J103.1; also elsewhere on the board
BAT_PROT: C103.1, R102.2, U101.2 (BAT), U101.3 (BAT); also elsewhere on the board
BENCH_5V: J101.1; also elsewhere on the board
CHARGE_ALLOW: R108.1; also elsewhere on the board
CHG_N: R112.2, U101.9 (~CHG); also elsewhere on the board
CHG_TS: U101.1 (TS); also elsewhere on the board
GND: C101.2, C102.2, C103.2, J101.2, J102.2, J103.2, J104.2, J105.2, Q101.2 (S), Q201.2 (S), R103.2, R104.2, R105.2, R107.2, R109.2, R110.2, R113.2, R222.2, U101.8 (VSS), U101.17 (VSS); also elsewhere on the board
PGOOD_N: R111.2, U101.7 (~PGOOD); also elsewhere on the board
SYS: J104.1, R101.2; also elsewhere on the board
SYS_RAW: C102.1, R101.1, R106.1, U101.10 (OUT), U101.11 (OUT)
USB_5V_PROTECTED: R221.1; also elsewhere on the board
USB_EN1: R109.1, U101.6 (EN1); also elsewhere on the board
USB_EN2: R110.1, U101.5 (EN2); also elsewhere on the board
VBUS_SENSE_N: Q201.3 (D), R220.2; also elsewhere on the board
VIN_5V: C101.1, U101.13 (IN); also elsewhere on the board

Notes on the sheet:
CHARGER / CONNECTED POWER PATH AND CONTROL MODULES
r6 drawing cleanup only. r5 component values, candidates, UUIDs and electrical connectivity are preserved.
1 BQ24074 / CURRENT SETTINGS / BATTERY AND SYSTEM PATH
ISET/ITERM 1.27k: ~0.701A / 30mA nominal. TMR68k: ~9.07h. DPPM / heat can reduce charging current.
2 BENCH INPUT
Known regulated, current-limited 5V. Select at J502; do not bridge sources.
3 DEFAULT CHARGE INHIBIT / MAINTENANCE
4 PROTECTED-USB PRESENCE
R108 remains DNP. J105 normally OPEN; maintenance CE does not bypass the page11 temperature window. Default EN2/EN1=00 USB100. Raise input mode only for a known capable source; TS fault is verified by BAT current, not CHG_N alone.

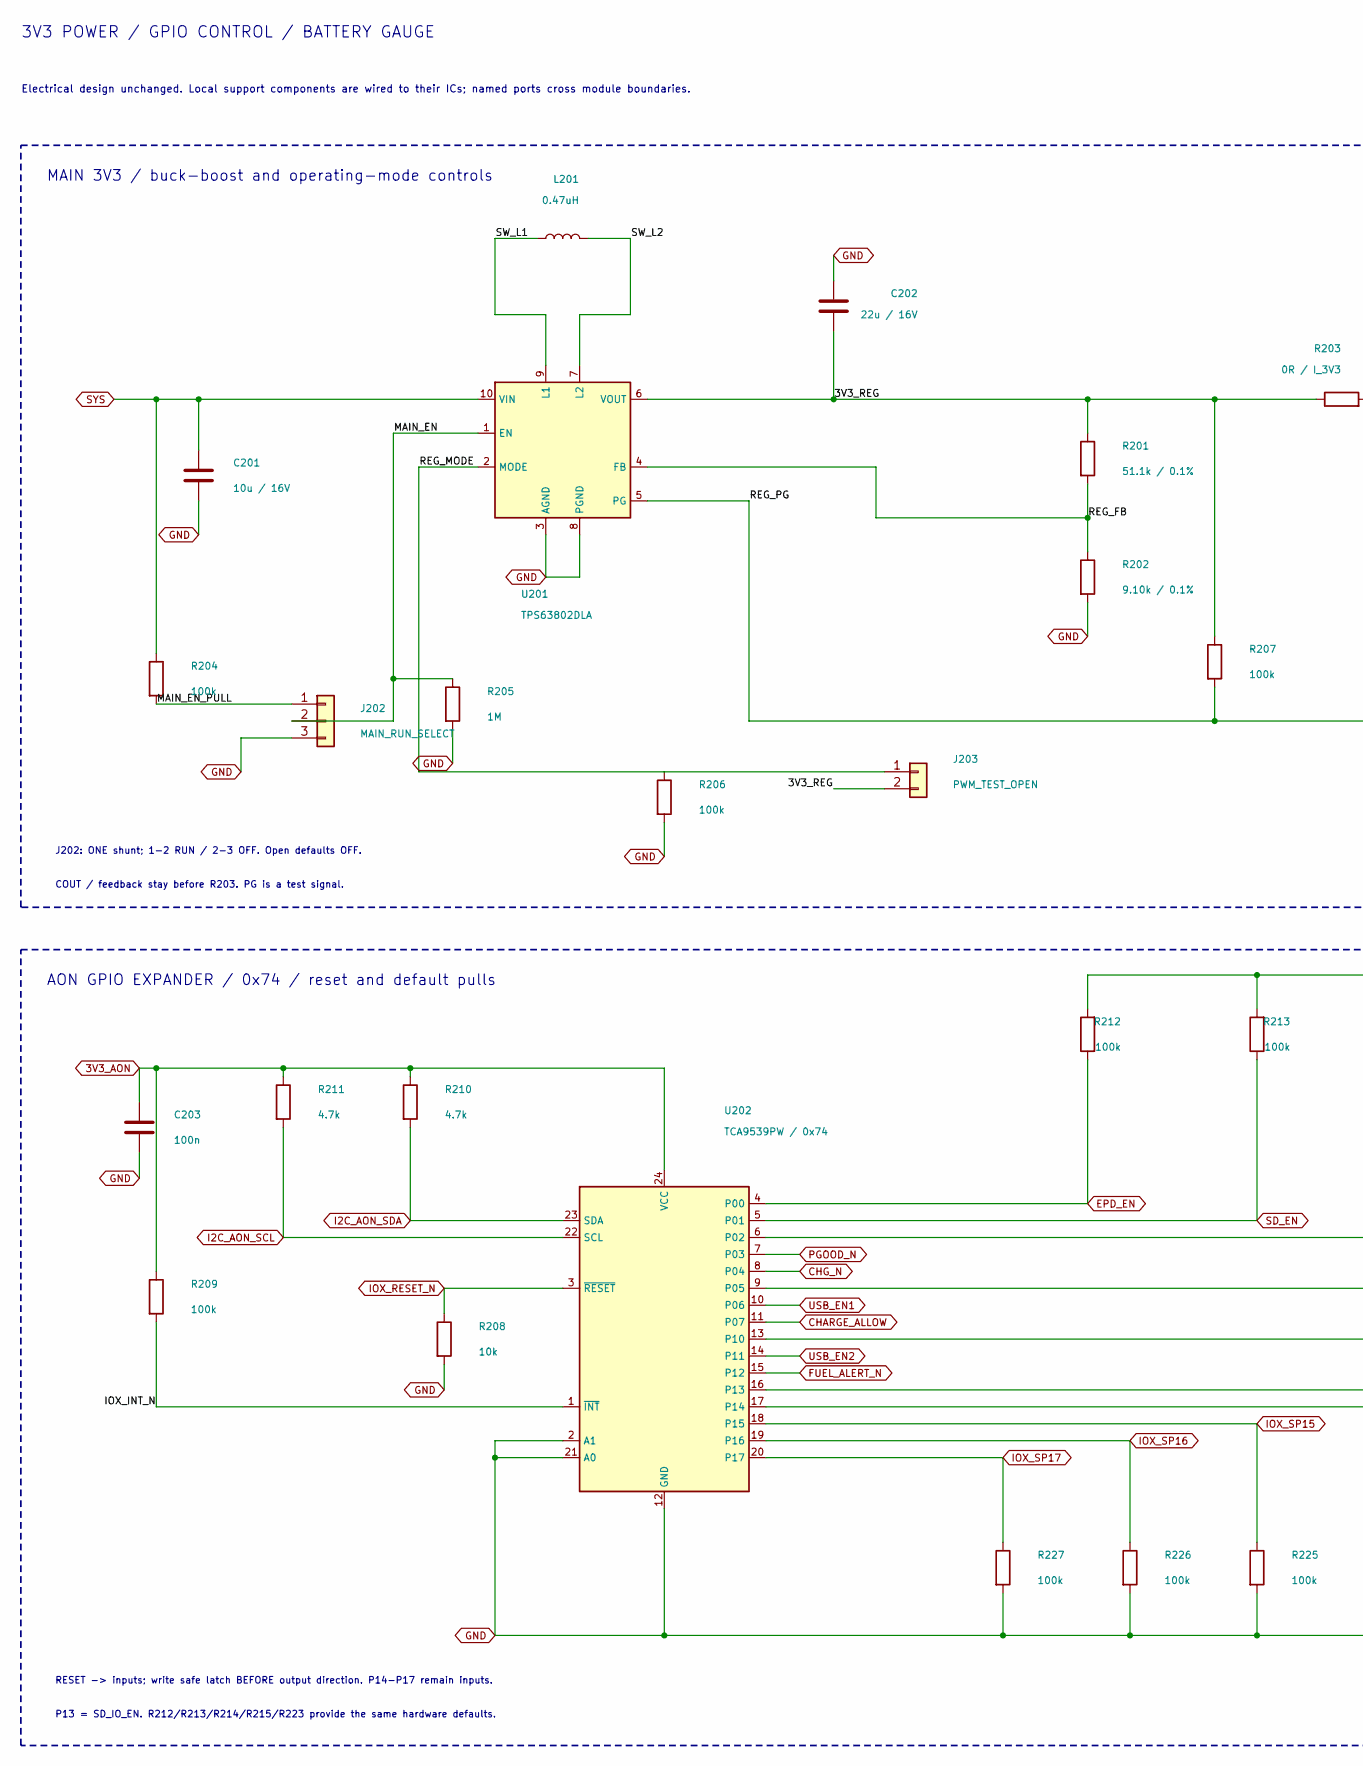
[picture p68: schematic POWER_3V3_CONTROL.kicad_sch, 3.3 V REGULATOR / POWER CONTROL / GAUGE, part in row 1, column 1]

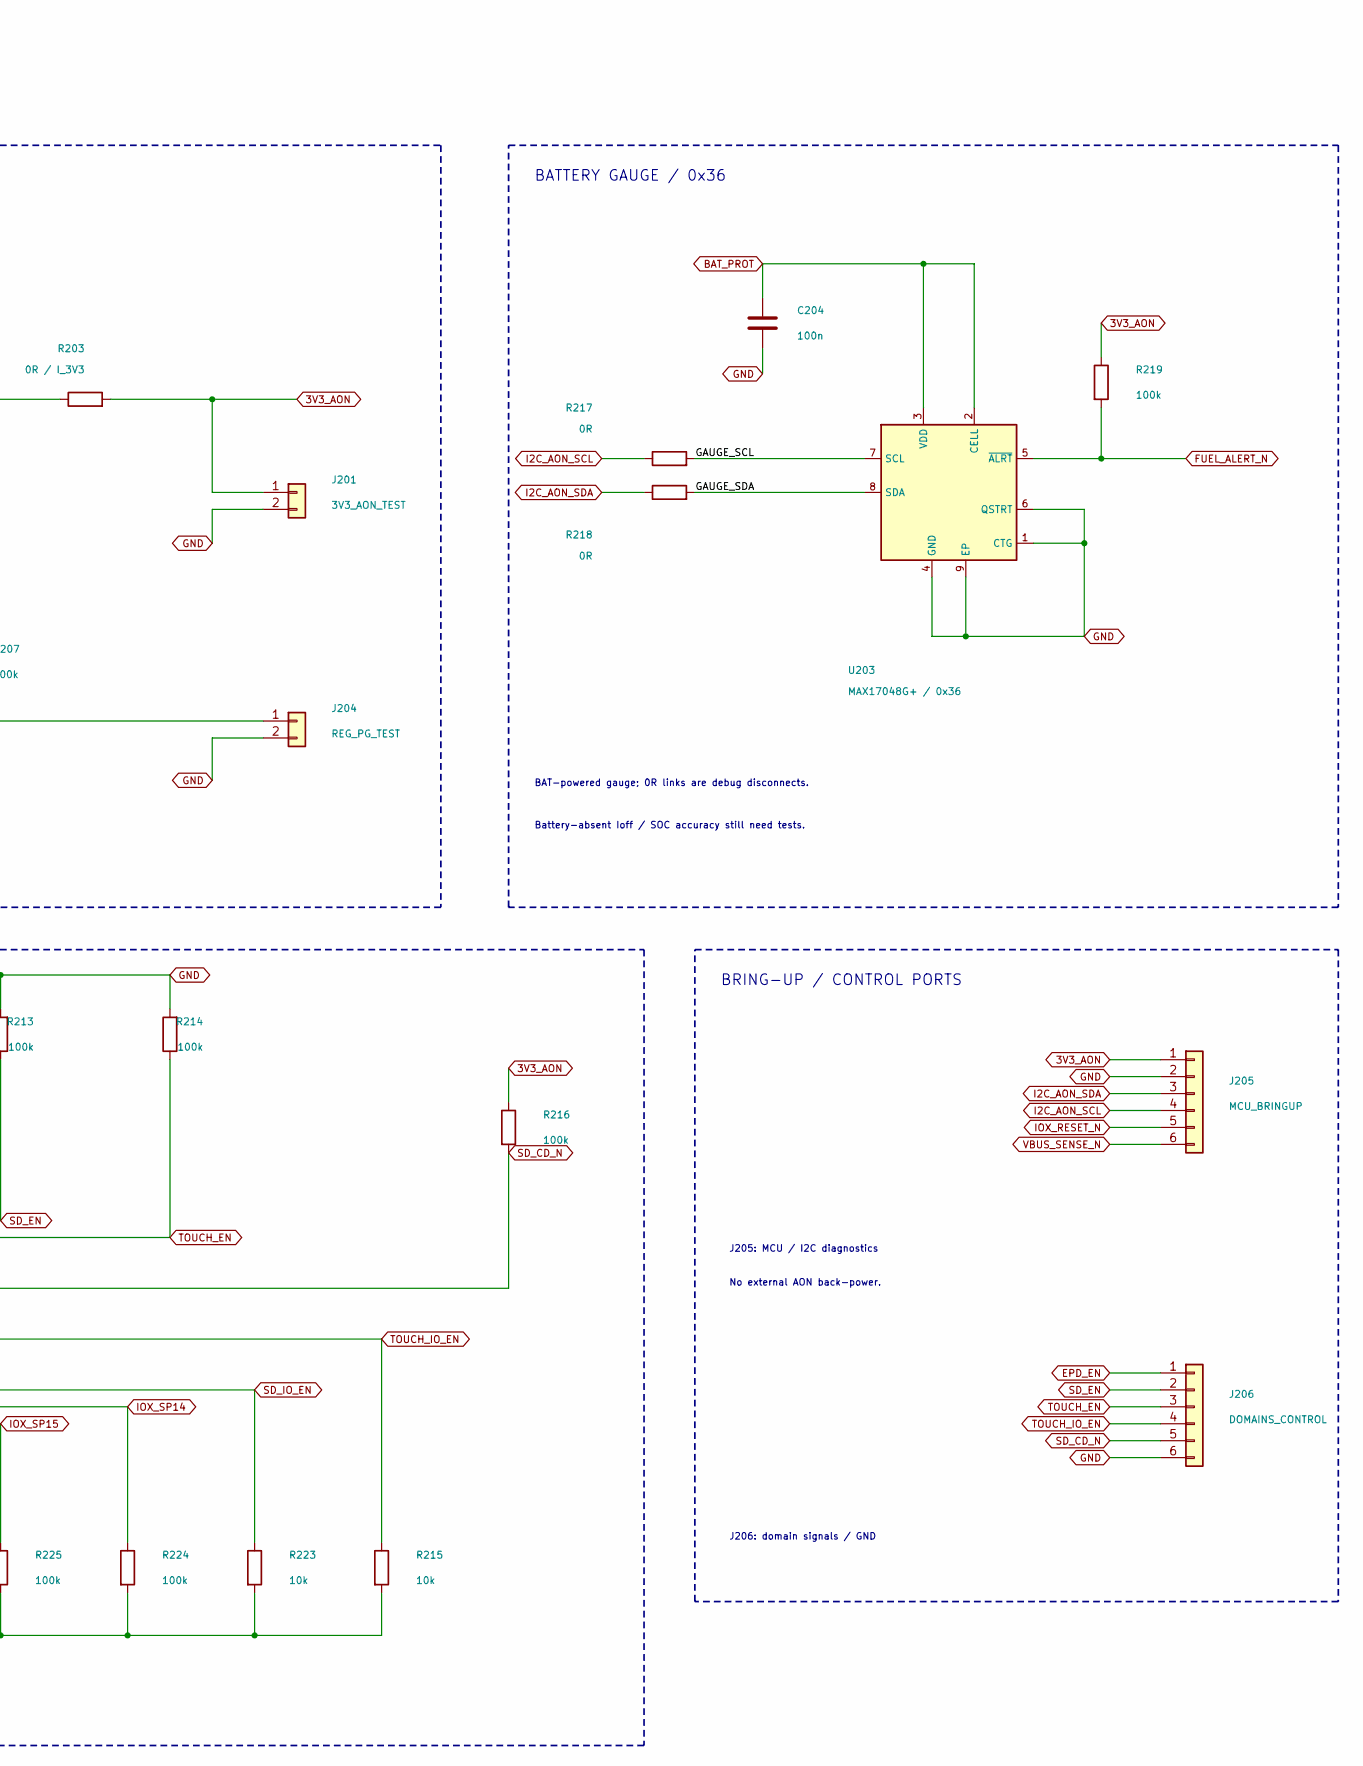
[picture p69: schematic POWER_3V3_CONTROL.kicad_sch, 3.3 V REGULATOR / POWER CONTROL / GAUGE, part in row 1, column 2]

Parts:
C201: 10u / 16V; C_1206_3216Metric
C202: 22u / 16V; C_1206_3216Metric
C203, C204: 100n; C_0603_1608Metric
J201: 3V3_AON_TEST; WR_PHD_1x02_P2.54_Drill1.10
J202: MAIN_RUN_SELECT; WR_PHD_1x03_P2.54_Drill1.10
J203: PWM_TEST_OPEN; WR_PHD_1x02_P2.54_Drill1.10
J204: REG_PG_TEST; WR_PHD_1x02_P2.54_Drill1.10
J205: MCU_BRINGUP; WR_PHD_1x06_P2.54_Drill1.10
J206: DOMAINS_CONTROL; WR_PHD_1x06_P2.54_Drill1.10
L201: 0.47uH; Coilcraft_XFL4015_4x4mm
R201: 51.1k / 0.1%; R_0603_1608Metric
R202: 9.10k / 0.1%; R_0603_1608Metric
R203: 0R / I_3V3; Bourns_CRF0805_Jumper
R204, R206, R207, R209, R212, R213, R214, R216, R219, R224, R225, R226, R227: 100k; R_0603_1608Metric
R205: 1M; R_0603_1608Metric
R208, R215, R223: 10k; R_0603_1608Metric
R210, R211: 4.7k; R_0603_1608Metric
R217, R218: 0R; R_0603_1608Metric
U201: TPS63802DLA; TI_DLA0010A_VSON-HR_2x3mm_P0.5mm
U202: TCA9539PW / 0x74; TSSOP-24_4.4x7.8mm_P0.65mm
U203: MAX17048G+ / 0x36; TDFN-8-1EP_2x2mm_P0.5mm_EP0.8x1.2mm

Connections:
3V3_AON: C203.1, J201.1, J205.1, R203.2, R209.1, R210.1, R211.1, R216.1, R219.1, U202.24 (VCC); also elsewhere on the board
/POWER_3V3_CONTROL/3V3_REG: C202.1, J203.2, R201.1, R203.1, R207.1, U201.6 (VOUT)
/POWER_3V3_CONTROL/GAUGE_SCL: R217.2, U203.7 (SCL)
/POWER_3V3_CONTROL/GAUGE_SDA: R218.2, U203.8 (SDA)
/POWER_3V3_CONTROL/IOX_INT_N: R209.2, U202.1 (~INT)
/POWER_3V3_CONTROL/MAIN_EN: J202.2, R205.1, U201.1 (EN)
/POWER_3V3_CONTROL/MAIN_EN_PULL: J202.1, R204.2
/POWER_3V3_CONTROL/REG_FB: R201.2, R202.1, U201.4 (FB)
/POWER_3V3_CONTROL/REG_MODE: J203.1, R206.1, U201.2 (MODE)
/POWER_3V3_CONTROL/REG_PG: J204.1, R207.2, U201.5 (PG)
/POWER_3V3_CONTROL/SW_L1: L201.1, U201.9 (L1)
/POWER_3V3_CONTROL/SW_L2: L201.2, U201.7 (L2)
BAT_PROT: C204.1, U203.2 (CELL), U203.3 (VDD); also elsewhere on the board
CHARGE_ALLOW: U202.11 (P07); also elsewhere on the board
CHG_N: U202.8 (P04); also elsewhere on the board
EPD_EN: J206.1, R212.1, U202.4 (P00); also elsewhere on the board
FUEL_ALERT_N: R219.2, U202.15 (P12), U203.5 (~ALRT)
GND: C201.2, C202.2, C203.2, C204.2, J201.2, J202.3, J204.2, J205.2, J206.6, R202.2, R205.2, R206.2, R208.2, R212.2, R213.2, R214.2, R215.2, R223.2, R224.2, R225.2, R226.2, R227.2, U201.3 (AGND), U201.8 (PGND), U202.2 (A1), U202.12 (GND), U202.21 (A0), U203.1 (CTG), U203.4 (GND), U203.6 (QSTRT), U203.9 (EP); also elsewhere on the board
I2C_AON_SCL: J205.4, R211.2, R217.1, U202.22 (SCL); also elsewhere on the board
I2C_AON_SDA: J205.3, R210.2, R218.1, U202.23 (SDA); also elsewhere on the board
IOX_RESET_N: J205.5, R208.1, U202.3 (~RESET); also elsewhere on the board
IOX_SP14: R224.1, U202.17 (P14)
IOX_SP15: R225.1, U202.18 (P15)
IOX_SP16: R226.1, U202.19 (P16)
IOX_SP17: R227.1, U202.20 (P17)
PGOOD_N: U202.7 (P03); also elsewhere on the board
SD_CD_N: J206.5, R216.2, U202.9 (P05); also elsewhere on the board
SD_EN: J206.2, R213.1, U202.5 (P01); also elsewhere on the board
SD_IO_EN: R223.1, U202.16 (P13); also elsewhere on the board
SYS: C201.1, R204.1, U201.10 (VIN); also elsewhere on the board
TOUCH_EN: J206.3, R214.1, U202.6 (P02); also elsewhere on the board
TOUCH_IO_EN: J206.4, R215.1, U202.13 (P10); also elsewhere on the board
USB_EN1: U202.10 (P06); also elsewhere on the board
USB_EN2: U202.14 (P11); also elsewhere on the board
VBUS_SENSE_N: J205.6; also elsewhere on the board

Notes on the sheet:
3V3 POWER / GPIO CONTROL / BATTERY GAUGE
Electrical design unchanged. Local support components are wired to their ICs; named ports cross module boundaries.
MAIN 3V3 / buck-boost and operating-mode controls
BATTERY GAUGE / 0x36
AON GPIO EXPANDER / 0x74 / reset and default pulls
BRING-UP / CONTROL PORTS
J202: ONE shunt; 1-2 RUN / 2-3 OFF. Open defaults OFF.
COUT / feedback stay before R203. PG is a test signal.
BAT-powered gauge; 0R links are debug disconnects.
Battery-absent Ioff / SOC accuracy still need tests.
RESET -> inputs; write safe latch BEFORE output direction. P14-P17 remain inputs.
P13 = SD_IO_EN. R212/R213/R214/R215/R223 provide the same hardware defaults.
J205: MCU / I2C diagnostics
No external AON back-power.
J206: domain signals / GND

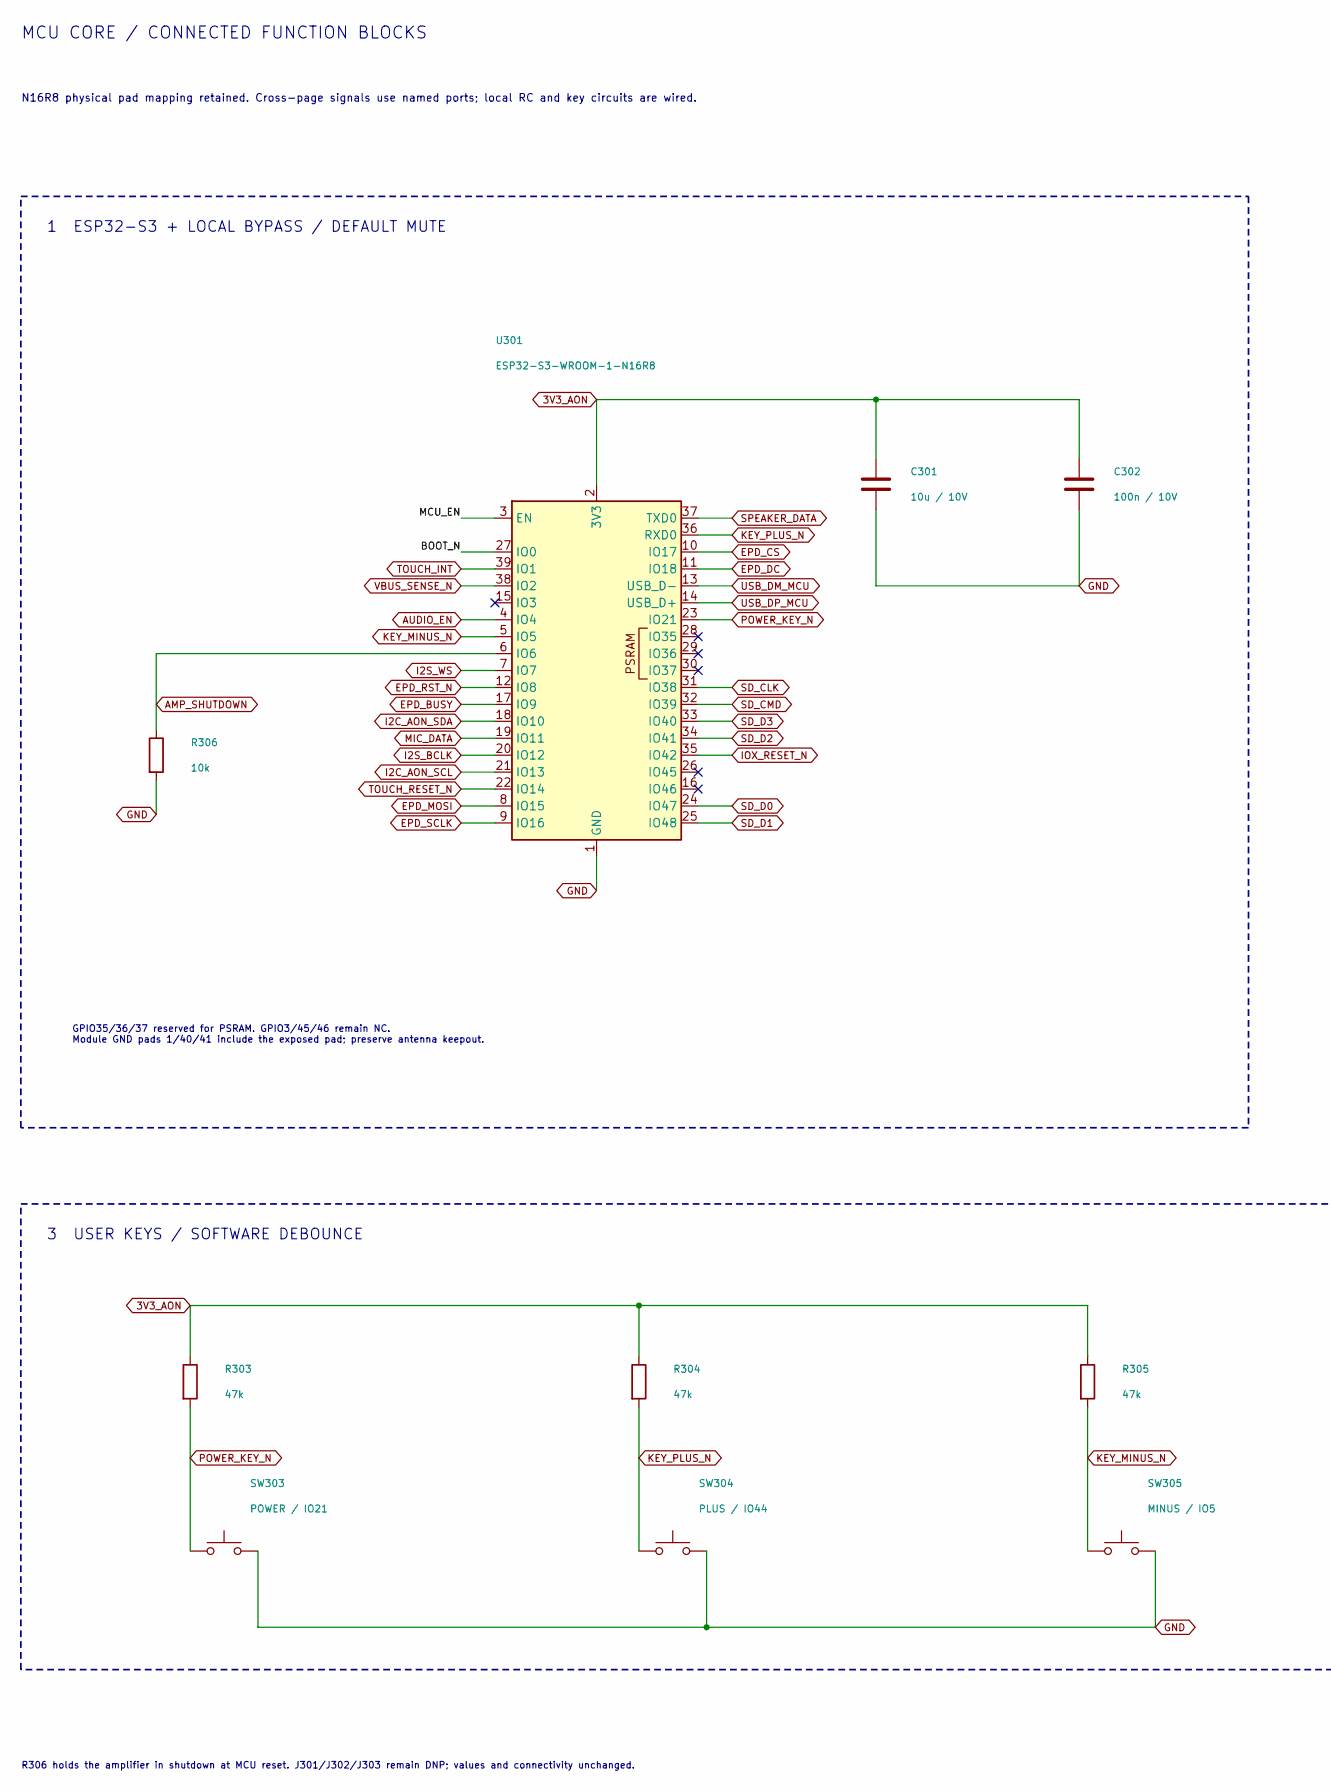
[picture p70: schematic MCU_CORE.kicad_sch, ESP32-S3 N16R8 / RESET / USER KEYS, part in row 1, column 1]

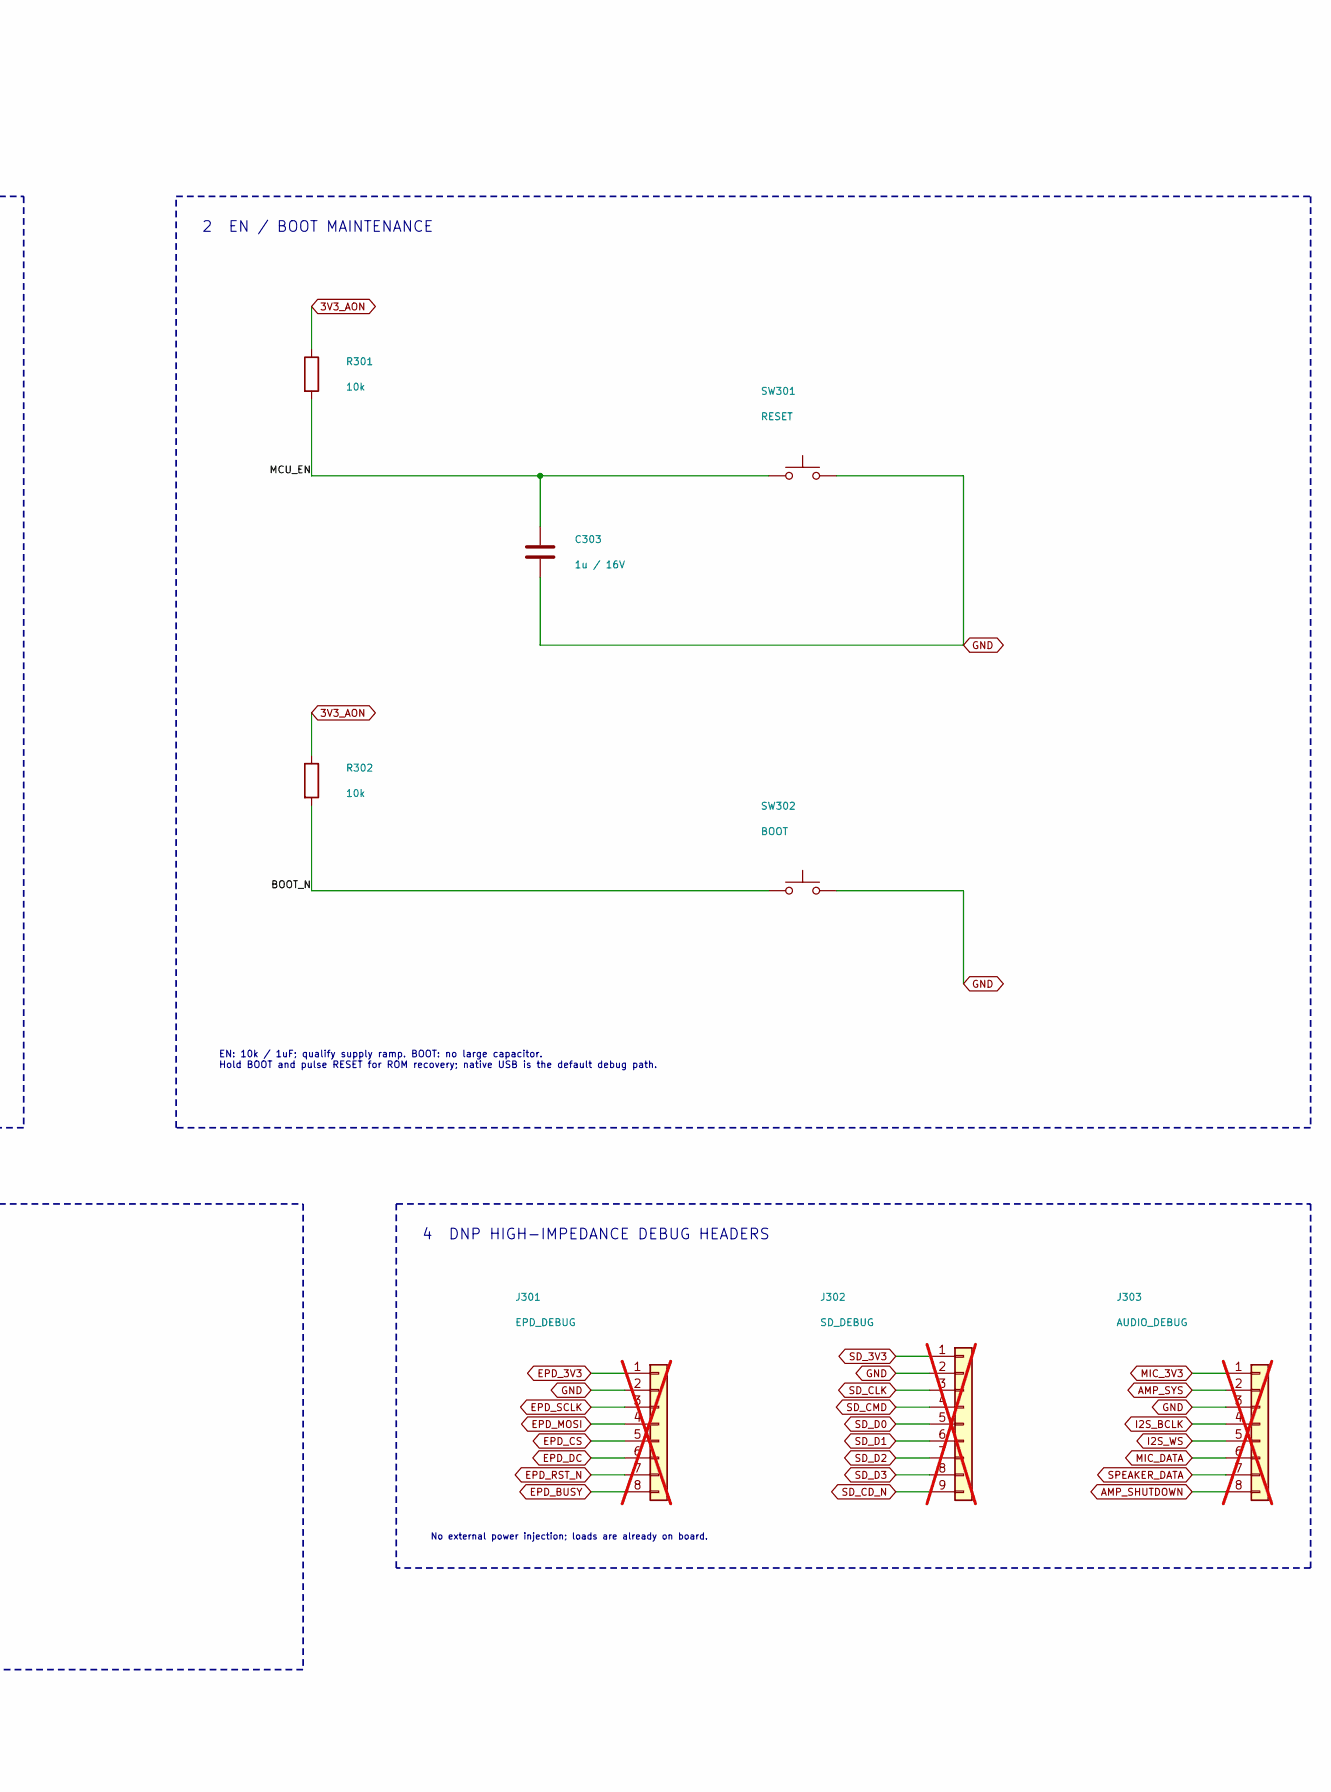
[picture p71: schematic MCU_CORE.kicad_sch, ESP32-S3 N16R8 / RESET / USER KEYS, part in row 1, column 2]

Parts:
C301: 10u / 10V; C_0805_2012Metric
C302: 100n / 10V; C_0603_1608Metric
C303: 1u / 16V; C_0603_1608Metric
J301: EPD_DEBUG; WR_PHD_1x08_P2.54_Drill1.10; not fitted
J302: SD_DEBUG; WR_PHD_1x09_P2.54_Drill1.10; not fitted
J303: AUDIO_DEBUG; WR_PHD_1x08_P2.54_Drill1.10; not fitted
R301, R302, R306: 10k; R_0603_1608Metric
R303, R304, R305: 47k; R_0603_1608Metric
SW301: RESET; SW_PUSH_6mm
SW302: BOOT; SW_PUSH_6mm
SW303: POWER / IO21; SW_PUSH_6mm
SW304: PLUS / IO44; SW_PUSH_6mm
SW305: MINUS / IO5; SW_PUSH_6mm
U301: ESP32-S3-WROOM-1-N16R8; ESP32-S3-WROOM-1

Connections:
3V3_AON: C301.1, C302.1, R301.1, R302.1, R303.1, R304.1, R305.1, U301.2 (3V3); also elsewhere on the board
/MCU_CORE/BOOT_N: R302.2, SW302.1, U301.27 (IO0)
/MCU_CORE/MCU_EN: C303.1, R301.2, SW301.1, U301.3 (EN)
AMP_SHUTDOWN: J303.8, R306.1, U301.6 (IO6); also elsewhere on the board
AMP_SYS: J303.2; also elsewhere on the board
AUDIO_EN: U301.4 (IO4); also elsewhere on the board
EPD_3V3: J301.1; also elsewhere on the board
EPD_BUSY: J301.8, U301.17 (IO9); also elsewhere on the board
EPD_CS: J301.5, U301.10 (IO17); also elsewhere on the board
EPD_DC: J301.6, U301.11 (IO18); also elsewhere on the board
EPD_MOSI: J301.4, U301.8 (IO15); also elsewhere on the board
EPD_RST_N: J301.7, U301.12 (IO8); also elsewhere on the board
EPD_SCLK: J301.3, U301.9 (IO16); also elsewhere on the board
GND: C301.2, C302.2, C303.2, J301.2, J302.2, J303.3, R306.2, SW301.2, SW302.2, SW303.2, SW304.2, SW305.2, U301.1 (GND), U301.40 (GND), U301.41 (GND); also elsewhere on the board
I2C_AON_SCL: U301.21 (IO13); also elsewhere on the board
I2C_AON_SDA: U301.18 (IO10); also elsewhere on the board
I2S_BCLK: J303.4, U301.20 (IO12); also elsewhere on the board
I2S_WS: J303.5, U301.7 (IO7); also elsewhere on the board
IOX_RESET_N: U301.35 (IO42); also elsewhere on the board
KEY_MINUS_N: R305.2, SW305.1, U301.5 (IO5)
KEY_PLUS_N: R304.2, SW304.1, U301.36 (RXD0)
MIC_3V3: J303.1; also elsewhere on the board
MIC_DATA: J303.6, U301.19 (IO11); also elsewhere on the board
POWER_KEY_N: R303.2, SW303.1, U301.23 (IO21)
SD_3V3: J302.1; also elsewhere on the board
SD_CD_N: J302.9; also elsewhere on the board
SD_CLK: J302.3, U301.31 (IO38); also elsewhere on the board
SD_CMD: J302.4, U301.32 (IO39); also elsewhere on the board
SD_D0: J302.5, U301.24 (IO47); also elsewhere on the board
SD_D1: J302.6, U301.25 (IO48); also elsewhere on the board
SD_D2: J302.7, U301.34 (IO41); also elsewhere on the board
SD_D3: J302.8, U301.33 (IO40); also elsewhere on the board
SPEAKER_DATA: J303.7, U301.37 (TXD0); also elsewhere on the board
TOUCH_INT: U301.39 (IO1); also elsewhere on the board
TOUCH_RESET_N: U301.22 (IO14); also elsewhere on the board
USB_DM_MCU: U301.13 (USB_D-); also elsewhere on the board
USB_DP_MCU: U301.14 (USB_D+); also elsewhere on the board
VBUS_SENSE_N: U301.38 (IO2); also elsewhere on the board

Notes on the sheet:
MCU CORE / CONNECTED FUNCTION BLOCKS
N16R8 physical pad mapping retained. Cross-page signals use named ports; local RC and key circuits are wired.
1 ESP32-S3 + LOCAL BYPASS / DEFAULT MUTE
GPIO35/36/37 reserved for PSRAM. GPIO3/45/46 remain NC. Module GND pads 1/40/41 include the exposed pad; preserve antenna keepout.
2 EN / BOOT MAINTENANCE
EN: 10k / 1uF; qualify supply ramp. BOOT: no large capacitor. Hold BOOT and pulse RESET for ROM recovery; native USB is the default debug path.
3 USER KEYS / SOFTWARE DEBOUNCE
4 DNP HIGH-IMPEDANCE DEBUG HEADERS
No external power injection; loads are already on board.
R306 holds the amplifier in shutdown at MCU reset. J301/J302/J303 remain DNP; values and connectivity unchanged.
