xiaobaoaaaaaa/ESPaperPlay-V2/hardware/devboard-r0/ESPaperPlay_Devboard.kicad_pcb

## KiCad design hardware/devboard-r0/ESPaperPlay_Devboard.kicad_pcb (continued)

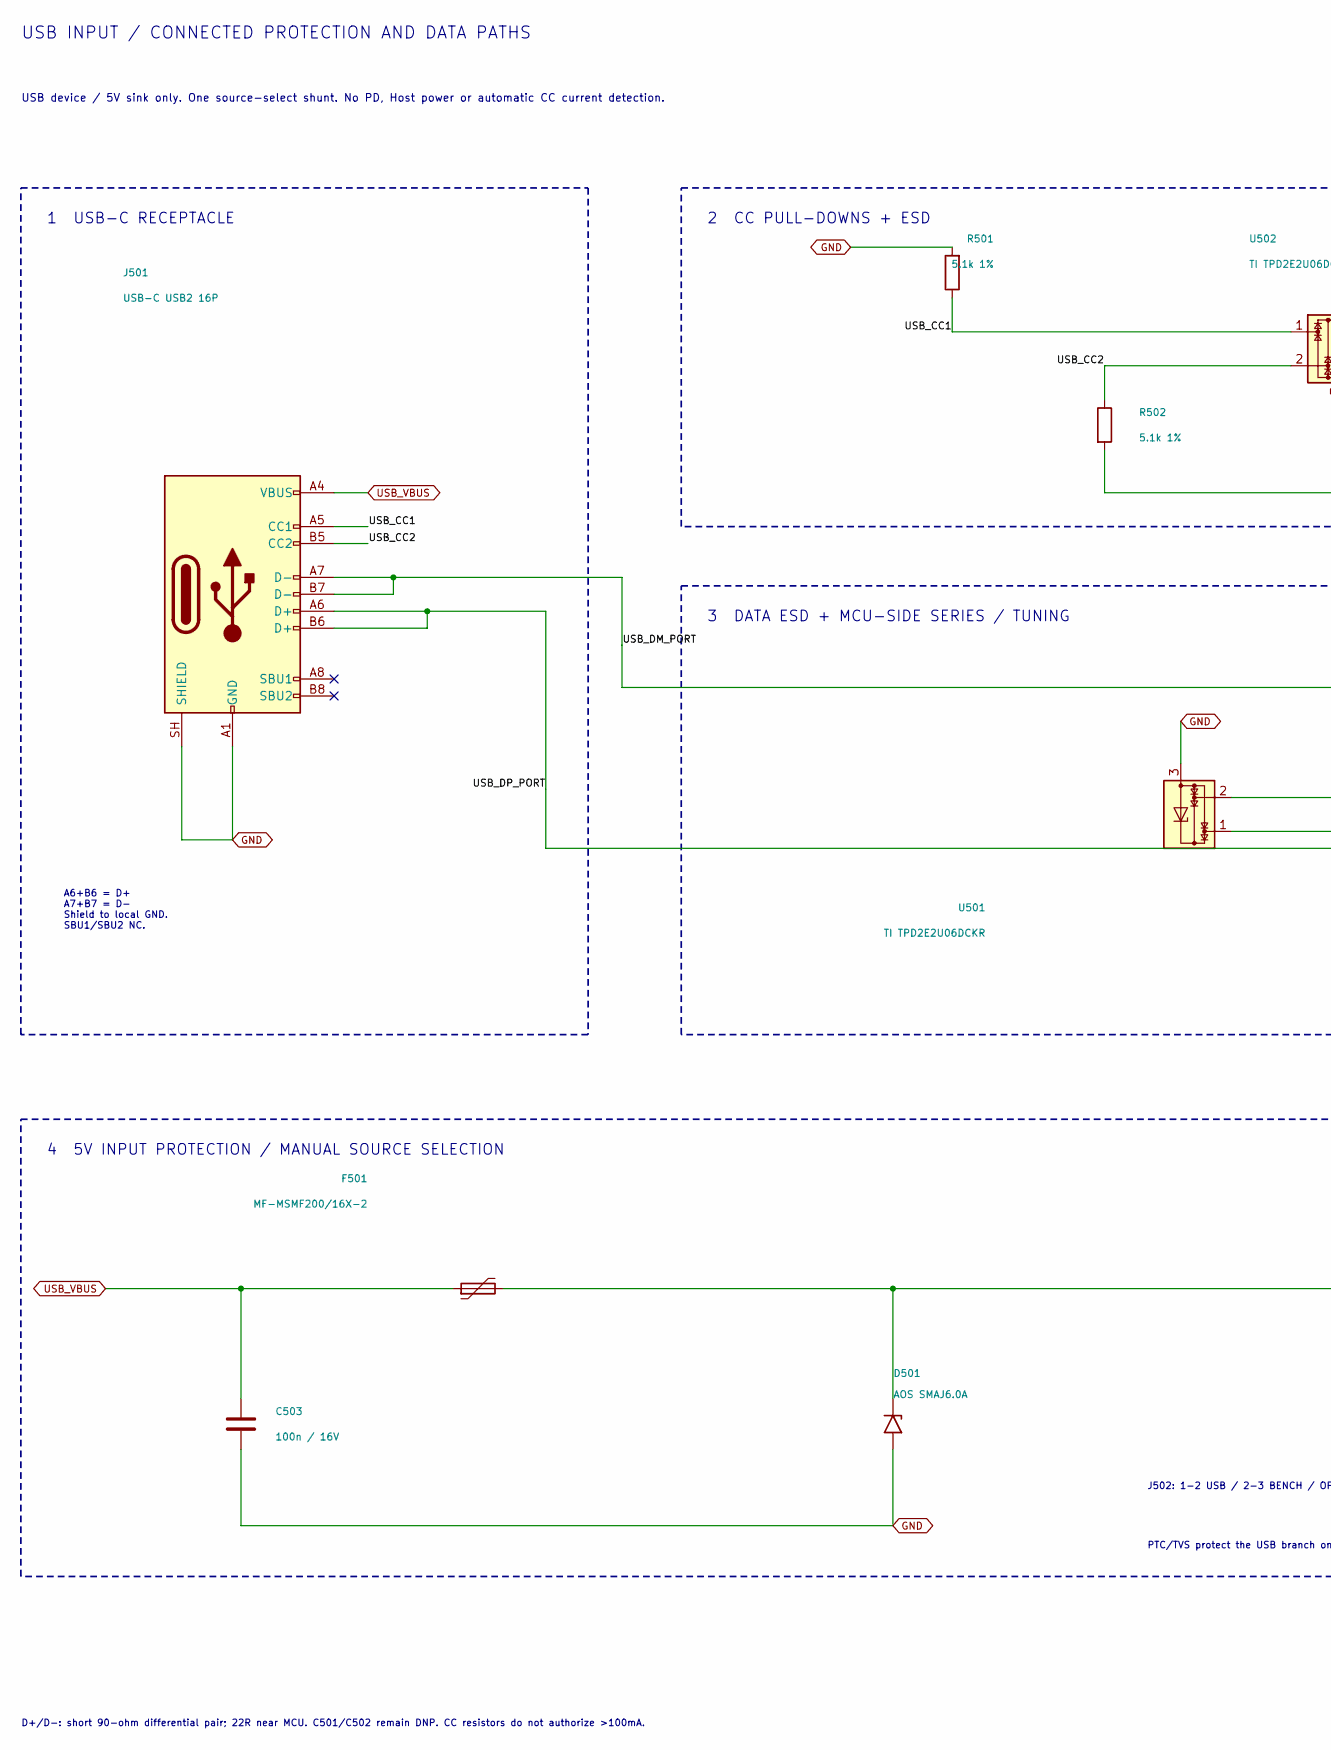
[picture p72: schematic USB_INPUT.kicad_sch, USB-C DEVICE / ESD / 5V SOURCE SELECTION, part in row 1, column 1]

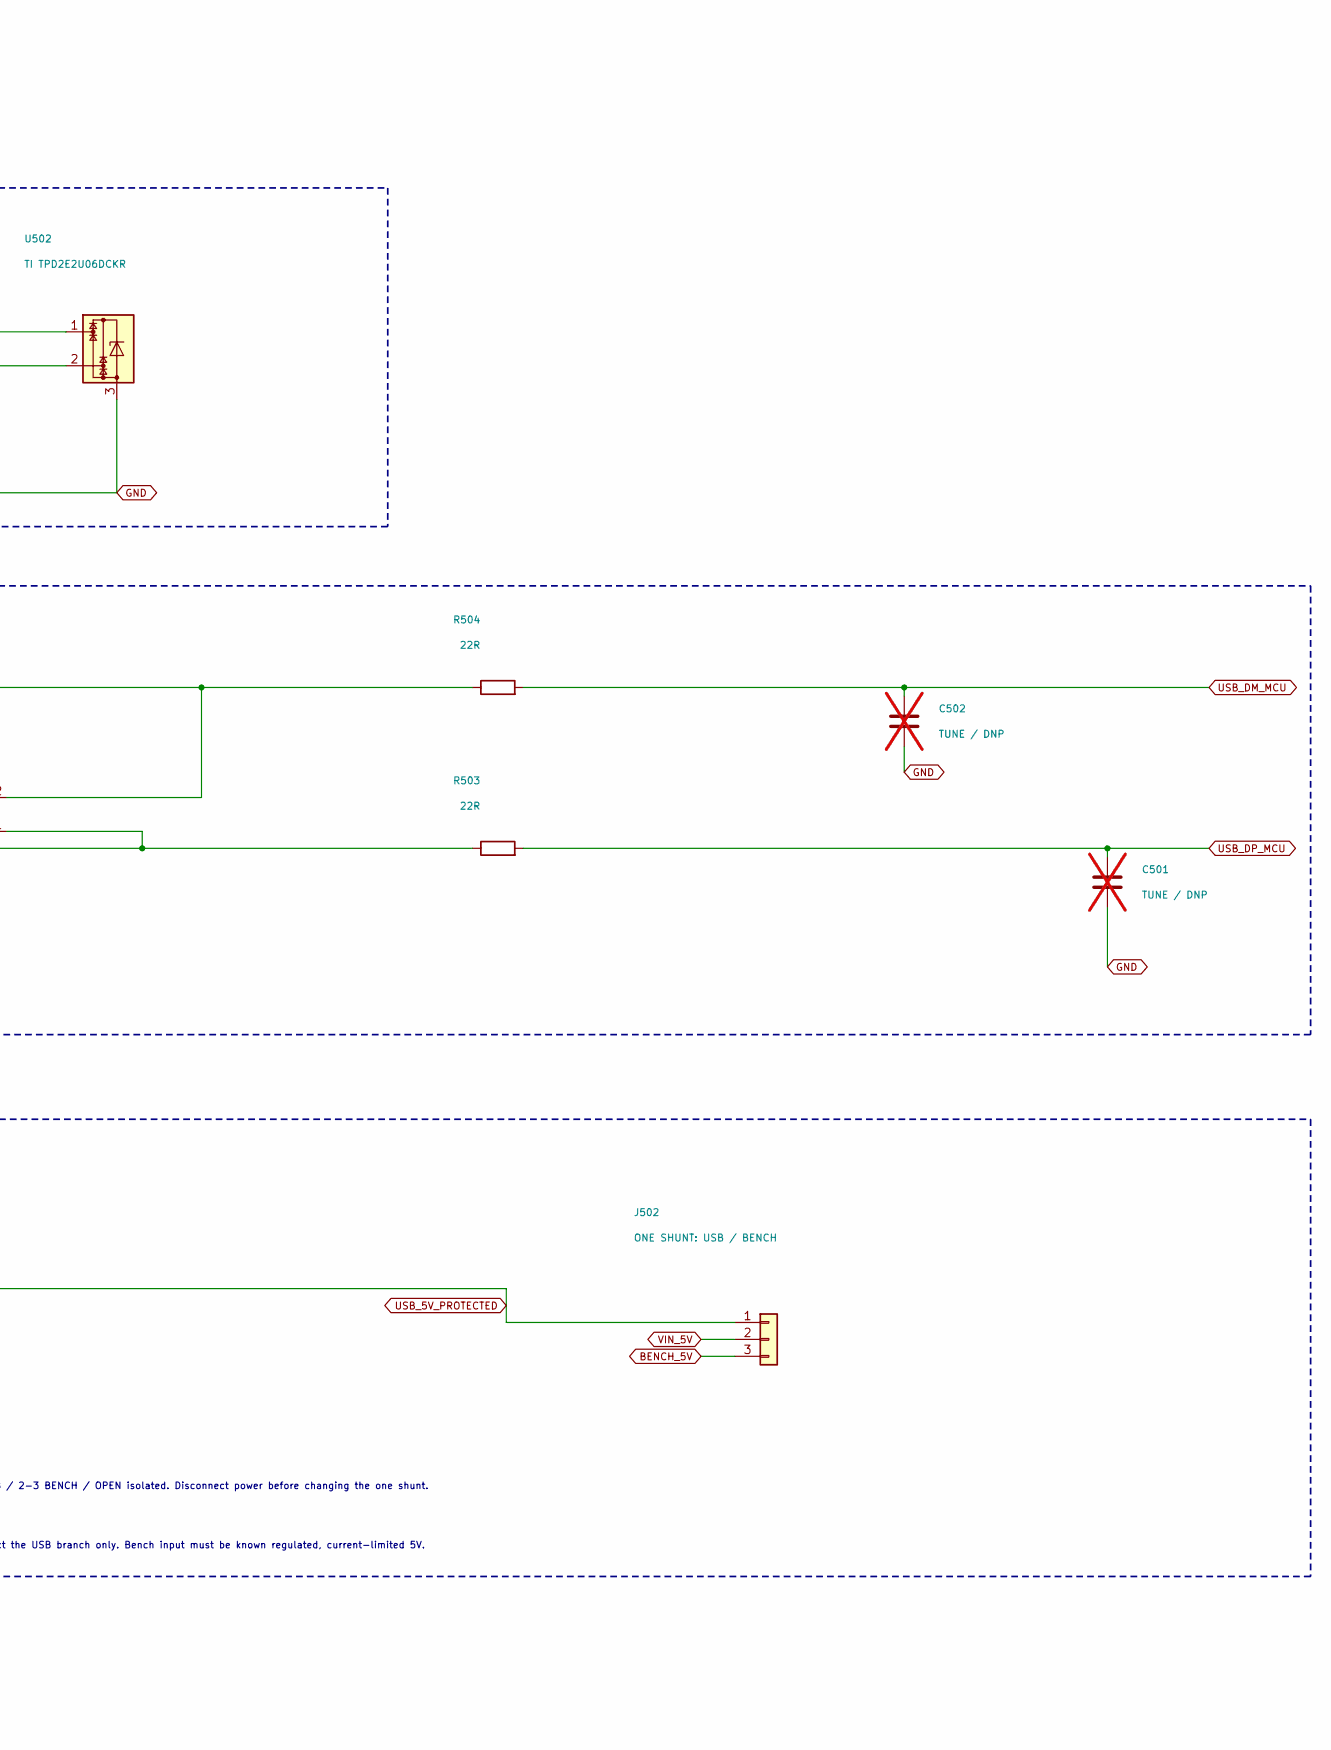
[picture p73: schematic USB_INPUT.kicad_sch, USB-C DEVICE / ESD / 5V SOURCE SELECTION, part in row 1, column 2]

Parts:
C501, C502: TUNE / DNP; C_0603_1608Metric; not fitted
C503: 100n / 16V; C_0603_1608Metric
D501: AOS SMAJ6.0A; D_SMA
F501: MF-MSMF200/16X-2; Bourns_MF-MSMF_1812_Style2
J501: USB-C USB2 16P; USB_C_Receptacle_GCT_USB4105-xx-A_16P_TopMnt_Horizontal
J502: ONE SHUNT: USB / BENCH; WR_PHD_1x03_P2.54_Drill1.10
R501, R502: 5.1k 1%; R_0603_1608Metric
R503, R504: 22R; R_0603_1608Metric
U501, U502: TI TPD2E2U06DCKR; TI_DCK0003A_SC70_3_Recommended

Connections:
/USB_INPUT/USB_CC1: J501.A5 (CC1), R501.1, U502.1
/USB_INPUT/USB_CC2: J501.B5 (CC2), R502.1, U502.2
/USB_INPUT/USB_DM_PORT: J501.A7 (D-), J501.B7 (D-), R504.1, U501.2
/USB_INPUT/USB_DP_PORT: J501.A6 (D+), J501.B6 (D+), R503.1, U501.1
BENCH_5V: J502.3; also elsewhere on the board
GND: C501.2, C502.2, C503.2, D501.2 (A2), J501.A1 (GND), J501.A12 (GND), J501.B1 (GND), J501.B12 (GND), J501.SH (SHIELD), R501.2, R502.2, U501.3, U502.3; also elsewhere on the board
USB_5V_PROTECTED: D501.1 (A1), F501.2, J502.1; also elsewhere on the board
USB_DM_MCU: C502.1, R504.2; also elsewhere on the board
USB_DP_MCU: C501.1, R503.2; also elsewhere on the board
USB_VBUS: C503.1, F501.1, J501.A4 (VBUS), J501.A9 (VBUS), J501.B4 (VBUS), J501.B9 (VBUS)
VIN_5V: J502.2; also elsewhere on the board

Notes on the sheet:
USB INPUT / CONNECTED PROTECTION AND DATA PATHS
USB device / 5V sink only. One source-select shunt. No PD, Host power or automatic CC current detection.
1 USB-C RECEPTACLE
A6+B6 = D+ A7+B7 = D- Shield to local GND. SBU1/SBU2 NC.
2 CC PULL-DOWNS + ESD
3 DATA ESD + MCU-SIDE SERIES / TUNING
4 5V INPUT PROTECTION / MANUAL SOURCE SELECTION
J502: 1-2 USB / 2-3 BENCH / OPEN isolated. Disconnect power before changing the one shunt.
PTC/TVS protect the USB branch only. Bench input must be known regulated, current-limited 5V.
D+/D-: short 90-ohm differential pair; 22R near MCU. C501/C502 remain DNP. CC resistors do not authorize >100mA.

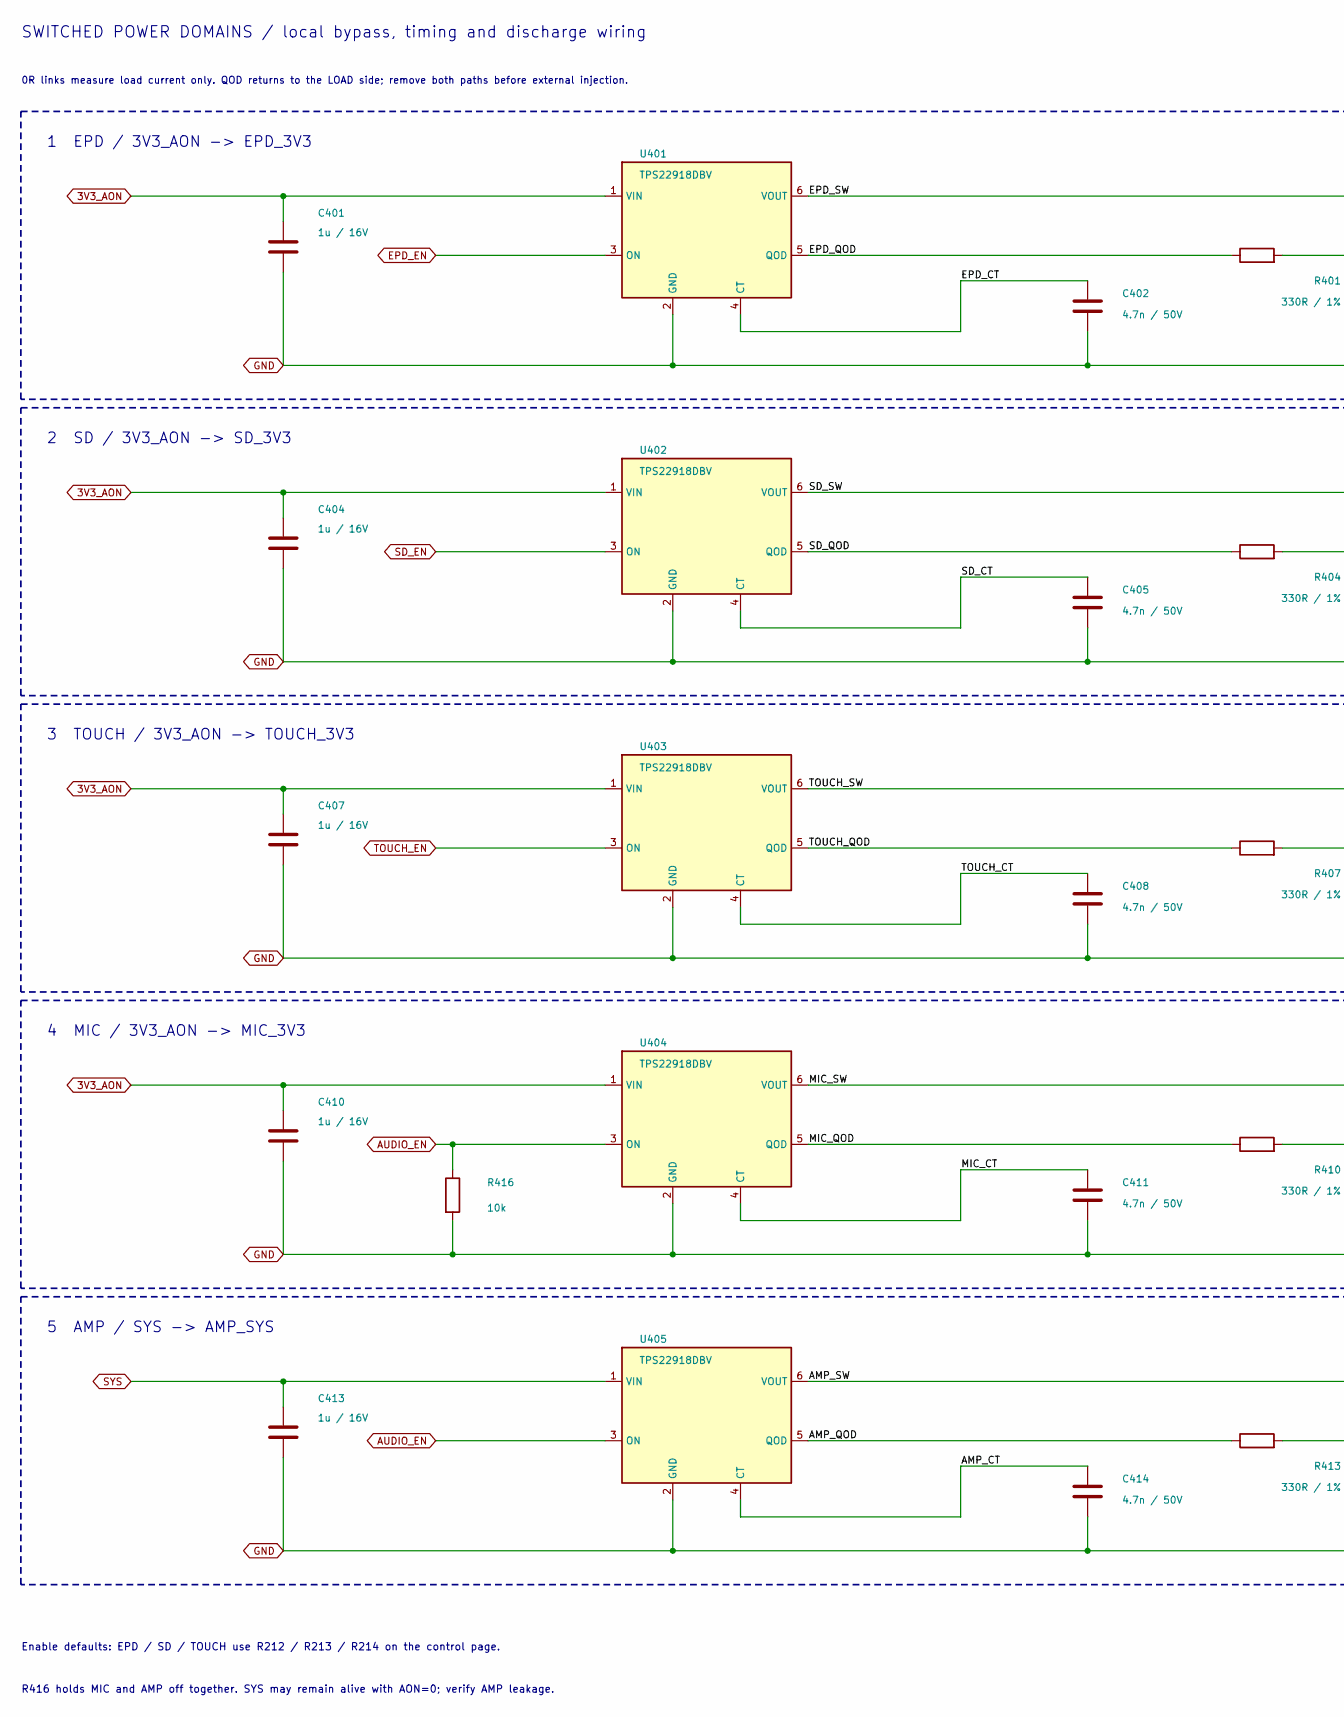
[picture p74: schematic POWER_DOMAINS.kicad_sch, PERIPHERAL POWER / FIVE SWITCHED DOMAINS, part in row 1, column 1]

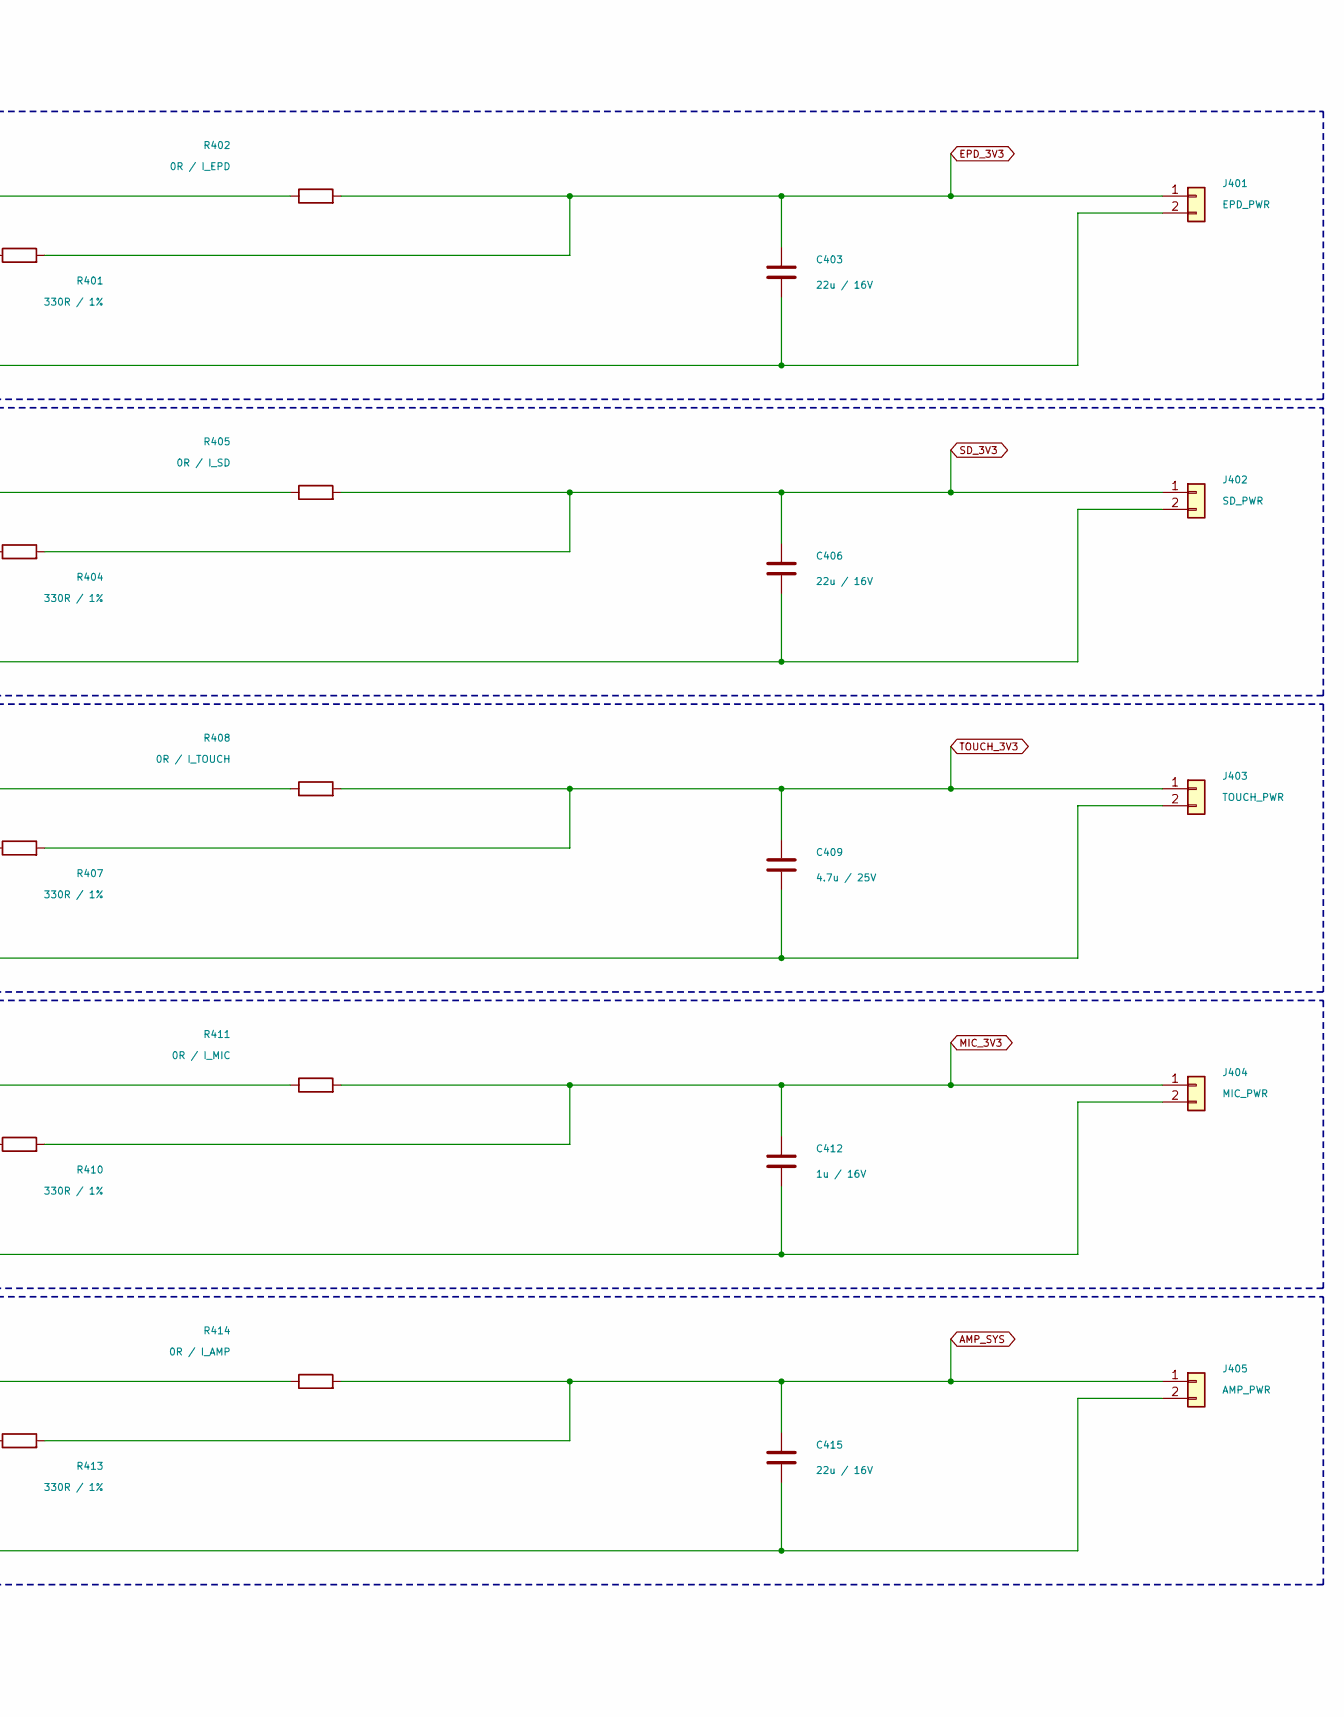
[picture p75: schematic POWER_DOMAINS.kicad_sch, PERIPHERAL POWER / FIVE SWITCHED DOMAINS, part in row 1, column 2]

Parts:
C401, C404, C407, C410, C412, C413: 1u / 16V; C_0603_1608Metric
C402, C405, C408, C411, C414: 4.7n / 50V; C_0603_1608Metric
C403, C406, C415: 22u / 16V; C_1206_3216Metric
C409: 4.7u / 25V; C_0805_2012Metric
J401: EPD_PWR; WR_PHD_1x02_P2.54_Drill1.10
J402: SD_PWR; WR_PHD_1x02_P2.54_Drill1.10
J403: TOUCH_PWR; WR_PHD_1x02_P2.54_Drill1.10
J404: MIC_PWR; WR_PHD_1x02_P2.54_Drill1.10
J405: AMP_PWR; WR_PHD_1x02_P2.54_Drill1.10
R401, R404, R407, R410, R413: 330R / 1%; R_0603_1608Metric
R402: 0R / I_EPD; Bourns_CRF0805_Jumper
R405: 0R / I_SD; Bourns_CRF0805_Jumper
R408: 0R / I_TOUCH; Bourns_CRF0805_Jumper
R411: 0R / I_MIC; Bourns_CRF0805_Jumper
R414: 0R / I_AMP; Bourns_CRF0805_Jumper
R416: 10k; R_0603_1608Metric
U401, U402, U403, U404, U405: TPS22918DBV; SOT-23-6

Connections:
3V3_AON: C401.1, C404.1, C407.1, C410.1, U401.1 (VIN), U402.1 (VIN), U403.1 (VIN), U404.1 (VIN); also elsewhere on the board
/POWER_DOMAINS/AMP_CT: C414.1, U405.4 (CT)
/POWER_DOMAINS/AMP_QOD: R413.1, U405.5 (QOD)
/POWER_DOMAINS/AMP_SW: R414.1, U405.6 (VOUT)
/POWER_DOMAINS/EPD_CT: C402.1, U401.4 (CT)
/POWER_DOMAINS/EPD_QOD: R401.1, U401.5 (QOD)
/POWER_DOMAINS/EPD_SW: R402.1, U401.6 (VOUT)
/POWER_DOMAINS/MIC_CT: C411.1, U404.4 (CT)
/POWER_DOMAINS/MIC_QOD: R410.1, U404.5 (QOD)
/POWER_DOMAINS/MIC_SW: R411.1, U404.6 (VOUT)
/POWER_DOMAINS/SD_CT: C405.1, U402.4 (CT)
/POWER_DOMAINS/SD_QOD: R404.1, U402.5 (QOD)
/POWER_DOMAINS/SD_SW: R405.1, U402.6 (VOUT)
/POWER_DOMAINS/TOUCH_CT: C408.1, U403.4 (CT)
/POWER_DOMAINS/TOUCH_QOD: R407.1, U403.5 (QOD)
/POWER_DOMAINS/TOUCH_SW: R408.1, U403.6 (VOUT)
AMP_SYS: C415.1, J405.1, R413.2, R414.2; also elsewhere on the board
AUDIO_EN: R416.1, U404.3 (ON), U405.3 (ON); also elsewhere on the board
EPD_3V3: C403.1, J401.1, R401.2, R402.2; also elsewhere on the board
EPD_EN: U401.3 (ON); also elsewhere on the board
GND: C401.2, C402.2, C403.2, C404.2, C405.2, C406.2, C407.2, C408.2, C409.2, C410.2, C411.2, C412.2, C413.2, C414.2, C415.2, J401.2, J402.2, J403.2, J404.2, J405.2, R416.2, U401.2 (GND), U402.2 (GND), U403.2 (GND), U404.2 (GND), U405.2 (GND); also elsewhere on the board
MIC_3V3: C412.1, J404.1, R410.2, R411.2; also elsewhere on the board
SD_3V3: C406.1, J402.1, R404.2, R405.2; also elsewhere on the board
SD_EN: U402.3 (ON); also elsewhere on the board
SYS: C413.1, U405.1 (VIN); also elsewhere on the board
TOUCH_3V3: C409.1, J403.1, R407.2, R408.2; also elsewhere on the board
TOUCH_EN: U403.3 (ON); also elsewhere on the board

Notes on the sheet:
SWITCHED POWER DOMAINS / local bypass, timing and discharge wiring
0R links measure load current only. QOD returns to the LOAD side; remove both paths before external injection.
1 EPD / 3V3_AON -> EPD_3V3
2 SD / 3V3_AON -> SD_3V3
3 TOUCH / 3V3_AON -> TOUCH_3V3
4 MIC / 3V3_AON -> MIC_3V3
5 AMP / SYS -> AMP_SYS
Enable defaults: EPD / SD / TOUCH use R212 / R213 / R214 on the control page.
R416 holds MIC and AMP off together. SYS may remain alive with AON=0; verify AMP leakage.

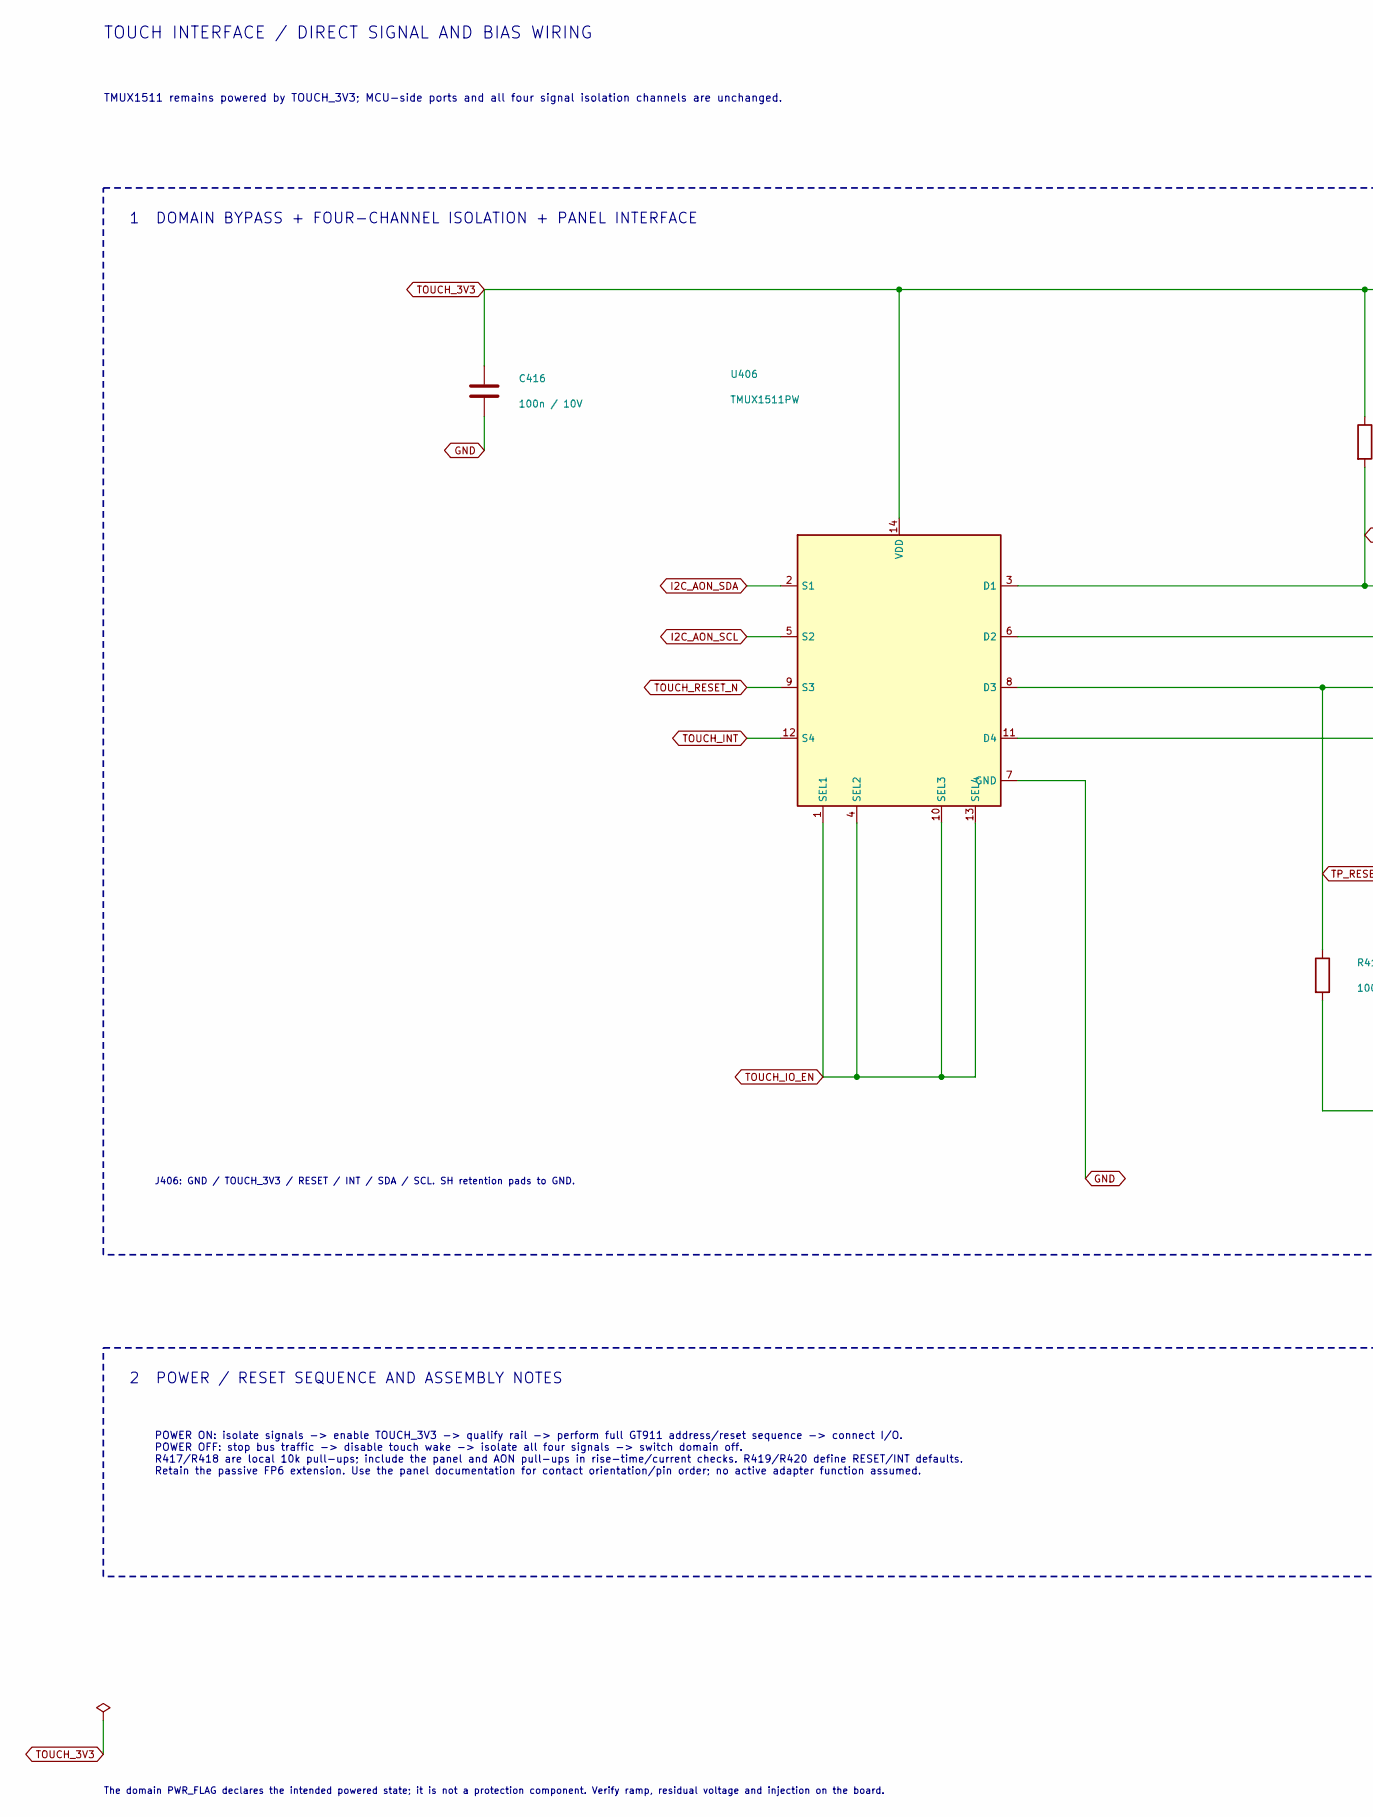
[picture p76: schematic TOUCH_ISOLATION.kicad_sch, GT911 FOUR-SIGNAL ISOLATION / DOMAIN TEST NOTES, part in row 1, column 1]

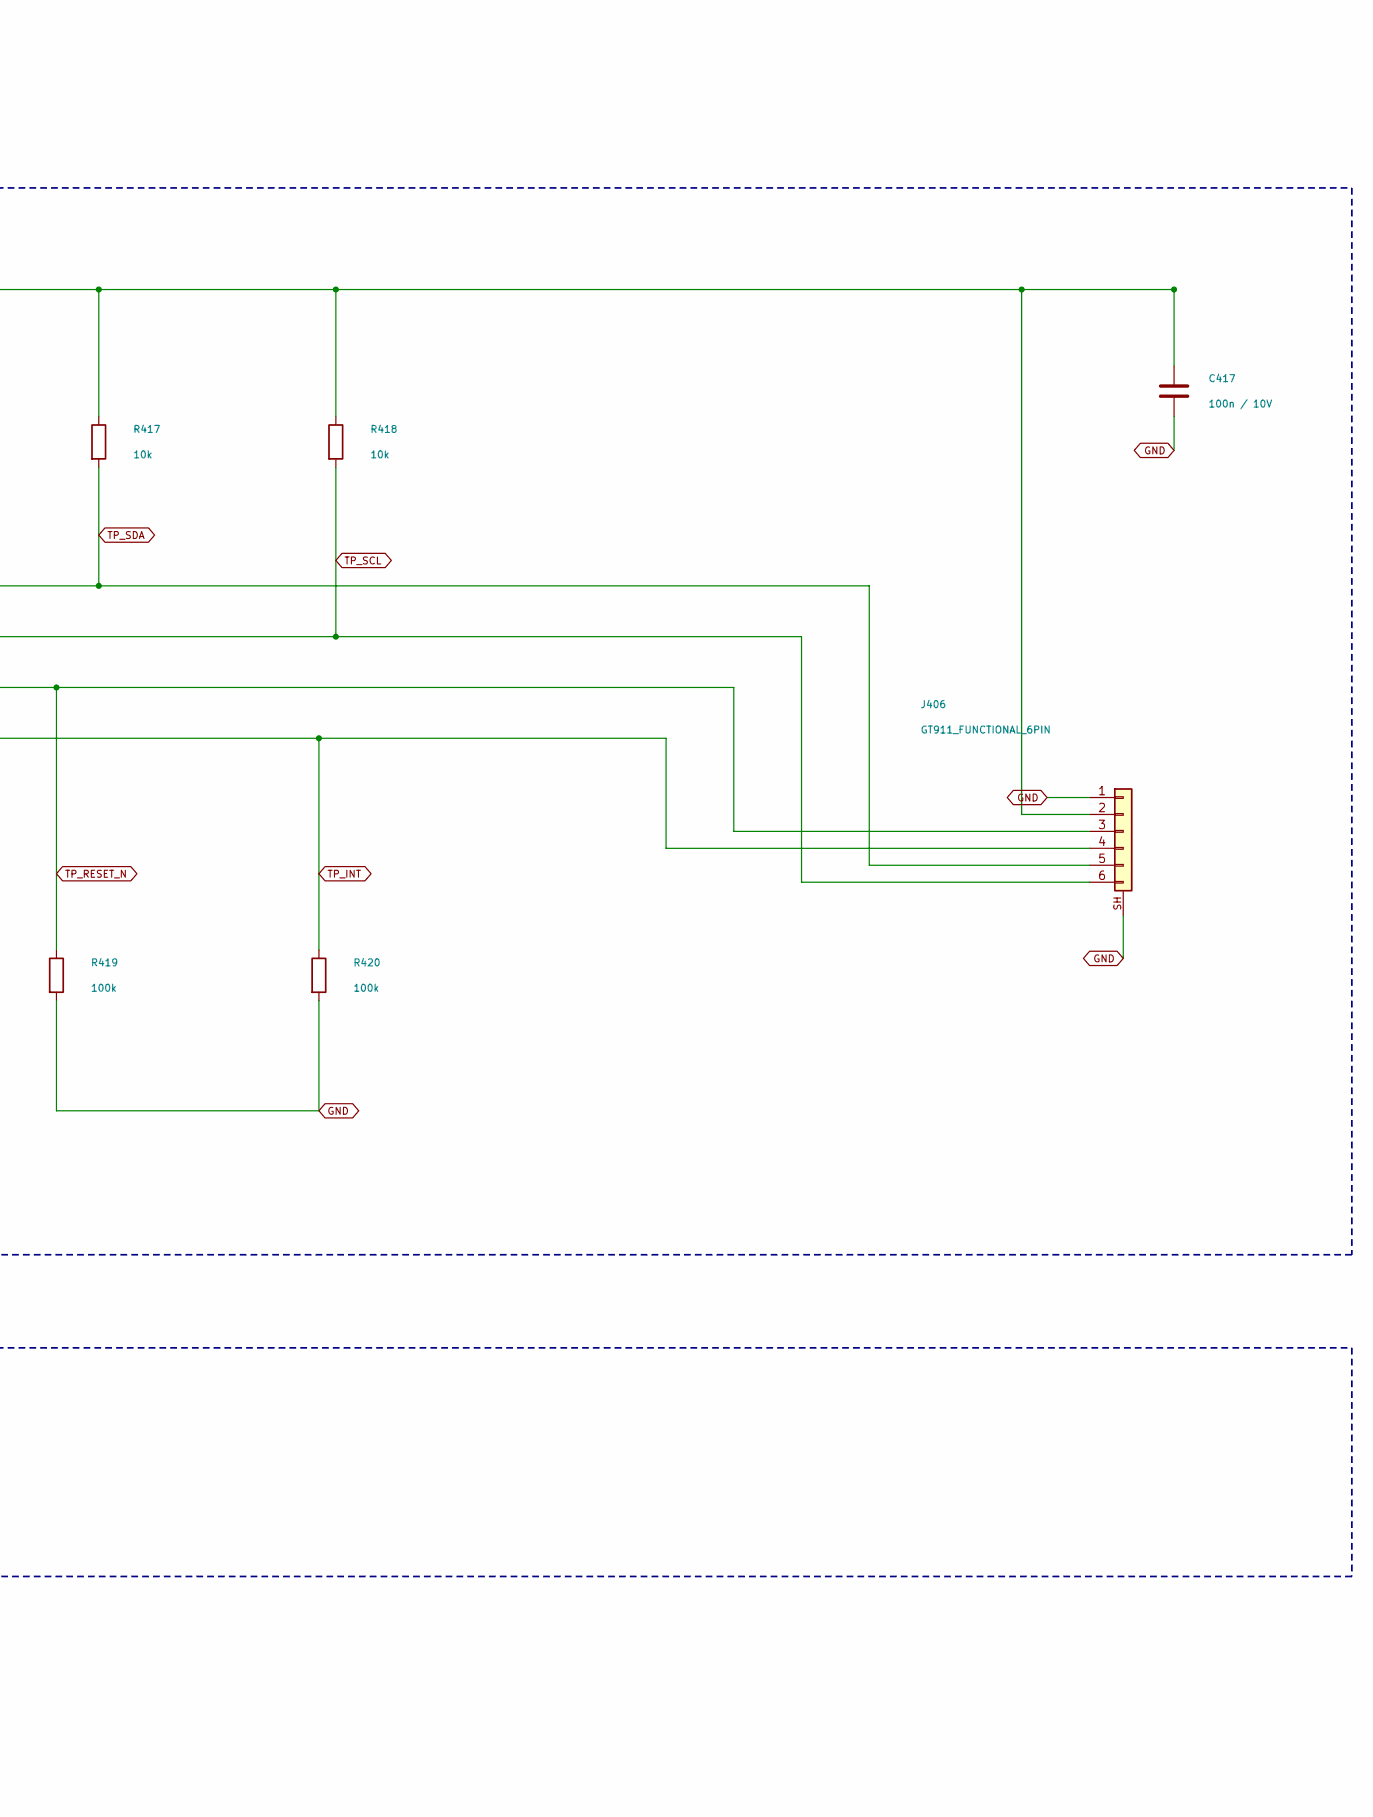
[picture p77: schematic TOUCH_ISOLATION.kicad_sch, GT911 FOUR-SIGNAL ISOLATION / DOMAIN TEST NOTES, part in row 1, column 2]

Parts:
C416, C417: 100n / 10V; C_0603_1608Metric
J406: GT911_FUNCTIONAL_6PIN; LAILAN_LAIL-FPC-CDX01-6P0.5-GW_1x06_P0.50mm_SH
R417, R418: 10k; R_0603_1608Metric
R419, R420: 100k; R_0603_1608Metric
U406: TMUX1511PW; TSSOP-14_4.4x5mm_P0.65mm

Connections:
GND: C416.2, C417.2, J406.1, J406.SH, R419.2, R420.2, U406.7 (GND); also elsewhere on the board
I2C_AON_SCL: U406.5 (S2); also elsewhere on the board
I2C_AON_SDA: U406.2 (S1); also elsewhere on the board
TOUCH_3V3: C416.1, C417.1, J406.2, R417.1, R418.1, U406.14 (VDD); also elsewhere on the board
TOUCH_INT: U406.12 (S4); also elsewhere on the board
TOUCH_IO_EN: U406.1 (SEL1), U406.4 (SEL2), U406.10 (SEL3), U406.13 (SEL4); also elsewhere on the board
TOUCH_RESET_N: U406.9 (S3); also elsewhere on the board
TP_INT: J406.4, R420.1, U406.11 (D4)
TP_RESET_N: J406.3, R419.1, U406.8 (D3)
TP_SCL: J406.6, R418.2, U406.6 (D2)
TP_SDA: J406.5, R417.2, U406.3 (D1)

Notes on the sheet:
TOUCH INTERFACE / DIRECT SIGNAL AND BIAS WIRING
TMUX1511 remains powered by TOUCH_3V3; MCU-side ports and all four signal isolation channels are unchanged.
1 DOMAIN BYPASS + FOUR-CHANNEL ISOLATION + PANEL INTERFACE
J406: GND / TOUCH_3V3 / RESET / INT / SDA / SCL. SH retention pads to GND.
2 POWER / RESET SEQUENCE AND ASSEMBLY NOTES
POWER ON: isolate signals -> enable TOUCH_3V3 -> qualify rail -> perform full GT911 address/reset sequence -> connect I/O. POWER OFF: stop bus traffic -> disable touch wake -> isolate all four signals -> switch domain off. R417/R418 are local 10k pull-ups; include the panel and AON pull-ups in rise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
The domain PWR_FLAG declares the intended powered state; it is not a protection component. Verify ramp, residual voltage and injection on the board.
