xiaobaoaaaaaa/ESPaperPlay-V2/hardware/devboard-r0/ESPaperPlay_Devboard.kicad_pcb

## KiCad design hardware/devboard-r0/ESPaperPlay_Devboard.kicad_pcb (continued)

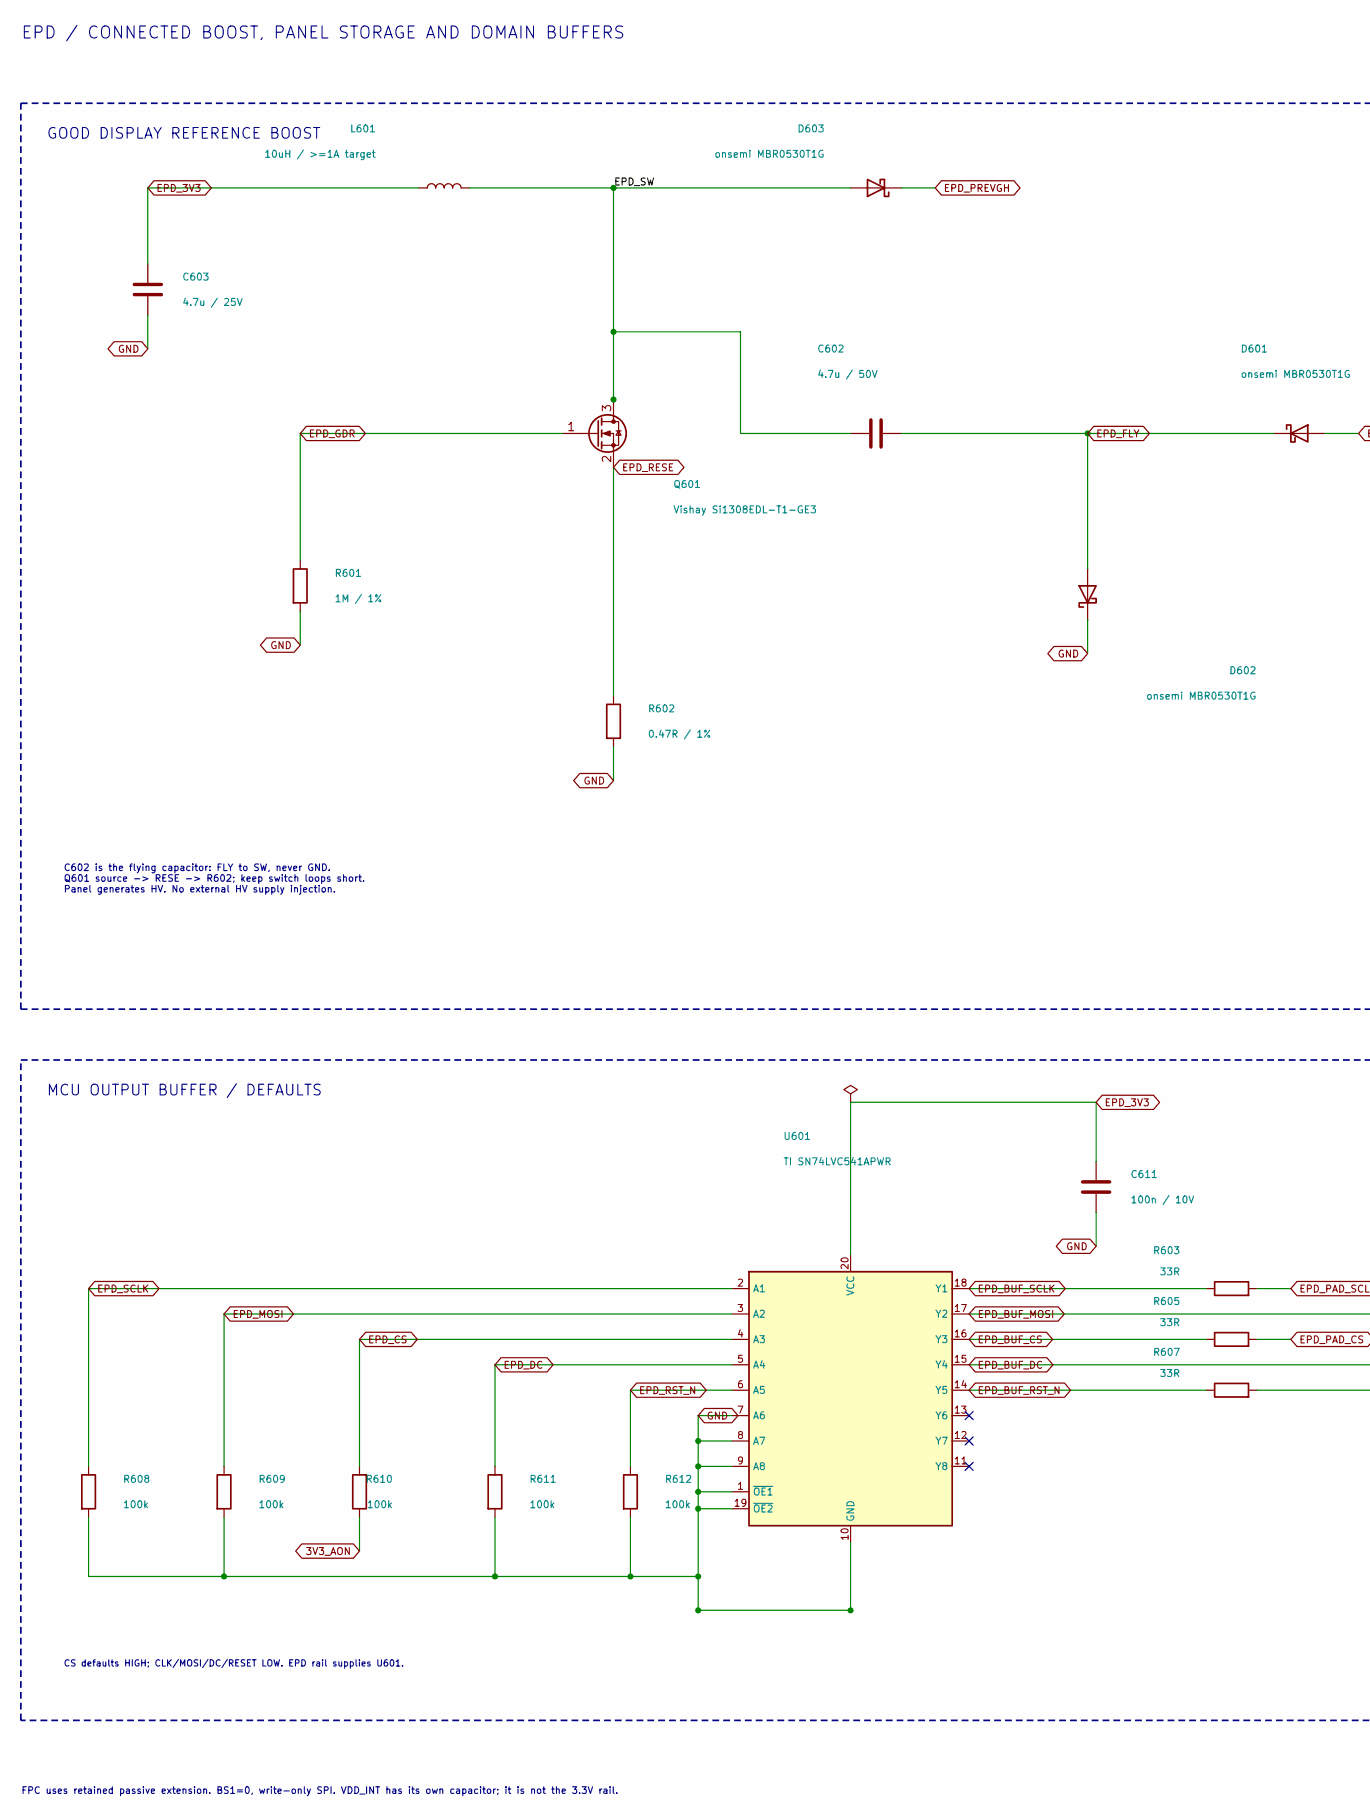
[picture p78: schematic EPD_DISPLAY.kicad_sch, EPD REFERENCE BOOST / 24-PIN PANEL / DOMAIN BUFFERS, part in row 1, column 1]

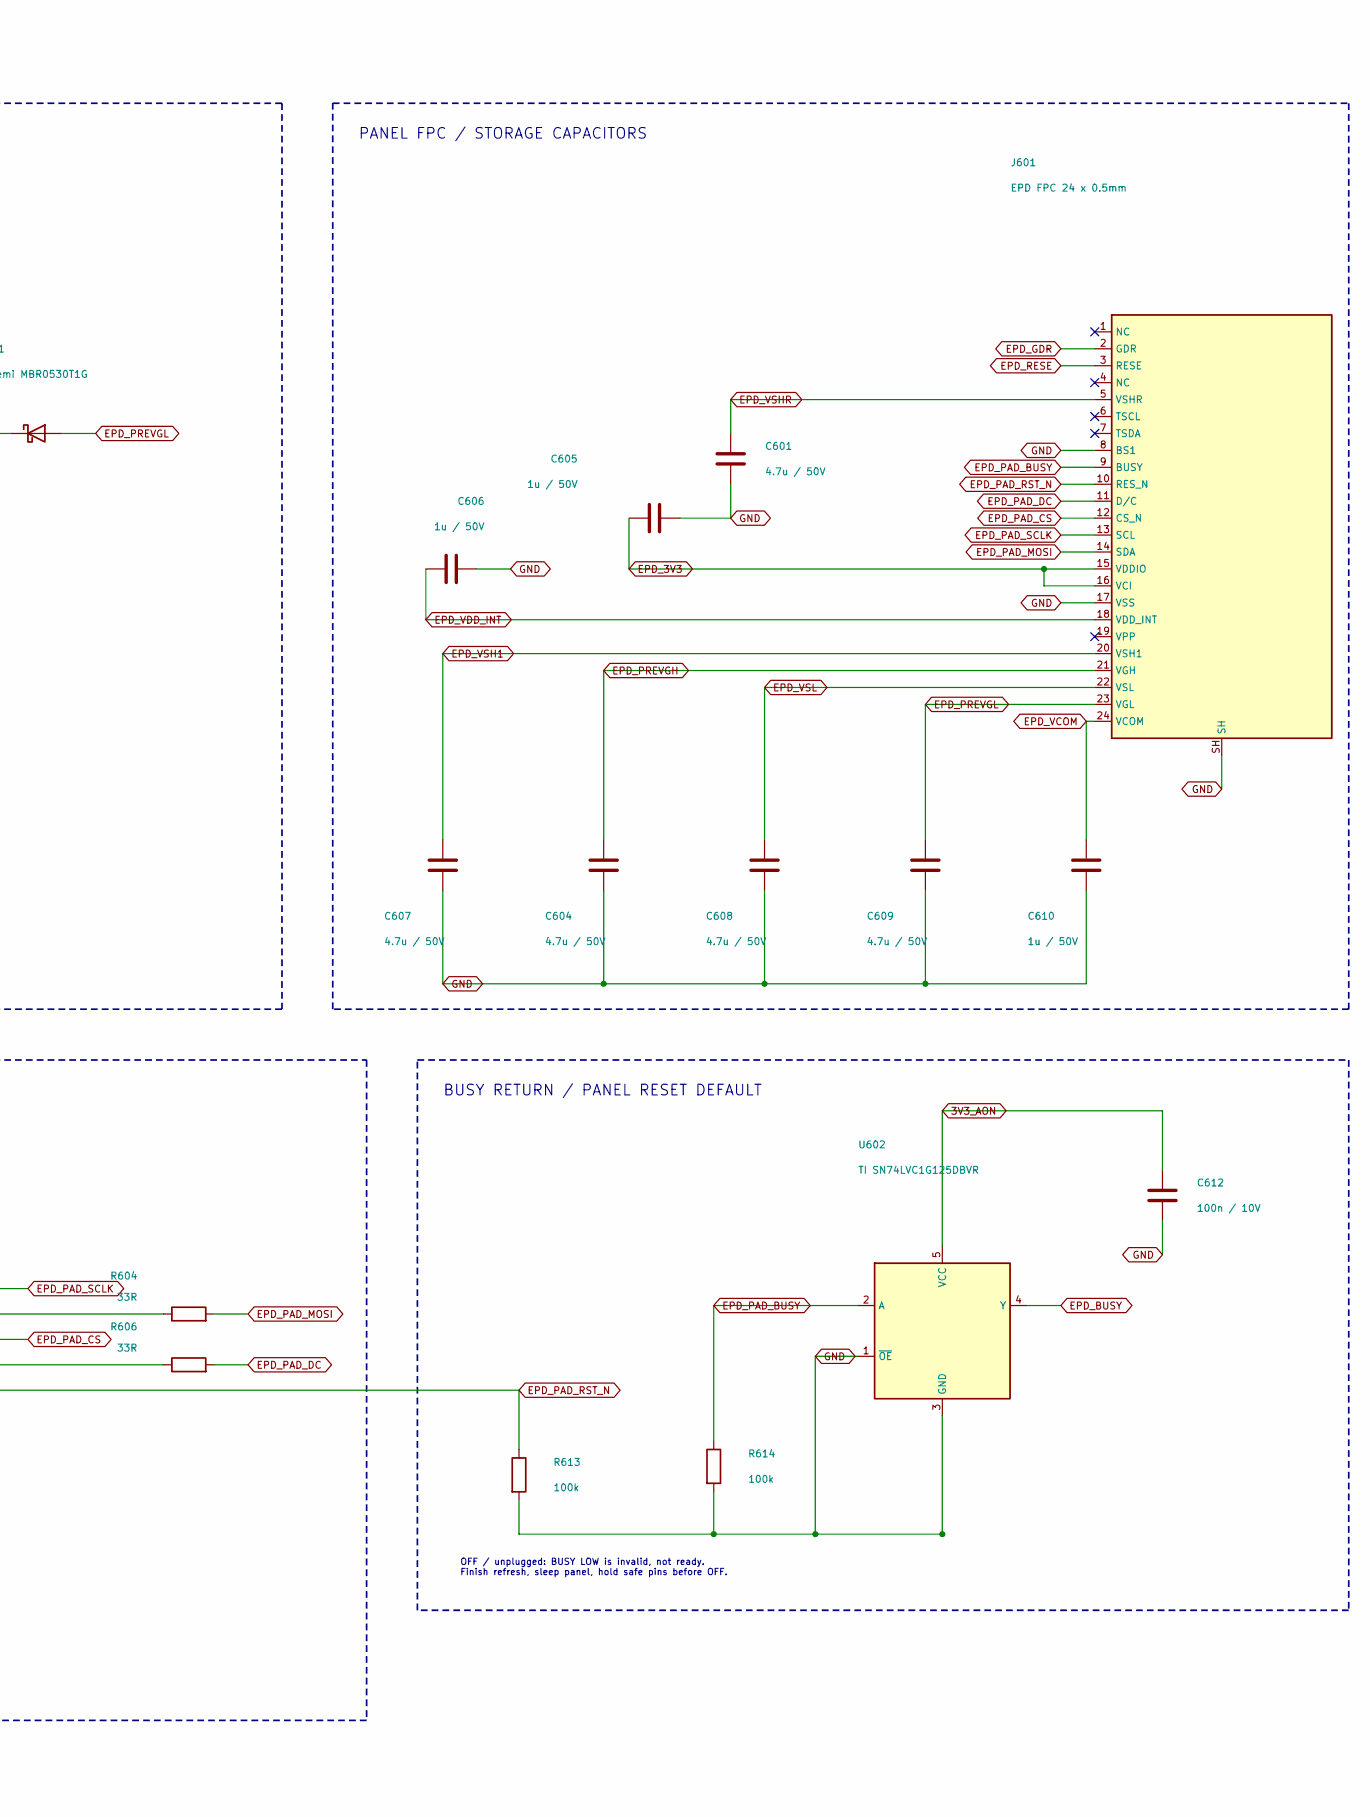
[picture p79: schematic EPD_DISPLAY.kicad_sch, EPD REFERENCE BOOST / 24-PIN PANEL / DOMAIN BUFFERS, part in row 1, column 2]

Parts:
C601, C602, C604, C607, C608, C609: 4.7u / 50V; C_1206_3216Metric
C603: 4.7u / 25V; C_0805_2012Metric
C605, C606, C610: 1u / 50V; C_0805_2012Metric
C611, C612: 100n / 10V; C_0603_1608Metric
D601, D602, D603: onsemi MBR0530T1G; D_SOD-123
J601: EPD FPC 24 x 0.5mm; HOAUC_HYCW3D-05FPC24-200B_1x24_P0.50mm_SH
L601: 10uH / >=1A target; L_Bourns-SRN4018
Q601: Vishay Si1308EDL-T1-GE3; Vishay_SC70_3_AN826_72601
R601: 1M / 1%; R_0603_1608Metric
R602: 0.47R / 1%; Vishay_WFM2010_5.08x2.54mm
R603, R604, R605, R606, R607: 33R; R_0603_1608Metric
R608, R609, R610, R611, R612, R613, R614: 100k; R_0603_1608Metric
U601: TI SN74LVC541APWR; TSSOP-20_4.4x6.5mm_P0.65mm
U602: TI SN74LVC1G125DBVR; SOT-23-5

Connections:
3V3_AON: C612.1, R610.1, U602.5 (VCC); also elsewhere on the board
/EPD_DISPLAY/EPD_SW: C602.2, D603.2 (A), L601.2, Q601.3 (D)
EPD_3V3: C603.1, C605.1, C611.1, J601.15 (VDDIO), J601.16 (VCI), L601.1, U601.20 (VCC); also elsewhere on the board
EPD_BUF_CS: R605.1, U601.16 (Y3)
EPD_BUF_DC: R606.1, U601.15 (Y4)
EPD_BUF_MOSI: R604.1, U601.17 (Y2)
EPD_BUF_RST_N: R607.1, U601.14 (Y5)
EPD_BUF_SCLK: R603.1, U601.18 (Y1)
EPD_BUSY: U602.4 (Y); also elsewhere on the board
EPD_CS: R610.2, U601.4 (A3); also elsewhere on the board
EPD_DC: R611.1, U601.5 (A4); also elsewhere on the board
EPD_FLY: C602.1, D601.1 (K), D602.2 (A)
EPD_GDR: J601.2 (GDR), Q601.1 (G), R601.1
EPD_MOSI: R609.1, U601.3 (A2); also elsewhere on the board
EPD_PAD_BUSY: J601.9 (BUSY), R614.1, U602.2 (A)
EPD_PAD_CS: J601.12 (CS_N), R605.2
EPD_PAD_DC: J601.11 (D/C), R606.2
EPD_PAD_MOSI: J601.14 (SDA), R604.2
EPD_PAD_RST_N: J601.10 (RES_N), R607.2, R613.1
EPD_PAD_SCLK: J601.13 (SCL), R603.2
EPD_PREVGH: C604.1, D603.1 (K), J601.21 (VGH)
EPD_PREVGL: C609.1, D601.2 (A), J601.23 (VGL)
EPD_RESE: J601.3 (RESE), Q601.2 (S), R602.1
EPD_RST_N: R612.1, U601.6 (A5); also elsewhere on the board
EPD_SCLK: R608.1, U601.2 (A1); also elsewhere on the board
EPD_VCOM: C610.1, J601.24 (VCOM)
EPD_VDD_INT: C606.1, J601.18 (VDD_INT)
EPD_VSH1: C607.1, J601.20 (VSH1)
EPD_VSHR: C601.1, J601.5 (VSHR)
EPD_VSL: C608.1, J601.22 (VSL)
GND: C601.2, C603.2, C604.2, C605.2, C606.2, C607.2, C608.2, C609.2, C610.2, C611.2, C612.2, D602.1 (K), J601.8 (BS1), J601.17 (VSS), J601.SH, R601.2, R602.2, R608.2, R609.2, R611.2, R612.2, R613.2, R614.2, U601.1 (~OE1), U601.7 (A6), U601.8 (A7), U601.9 (A8), U601.10 (GND), U601.19 (~OE2), U602.1 (~OE), U602.3 (GND); also elsewhere on the board

Notes on the sheet:
EPD / CONNECTED BOOST, PANEL STORAGE AND DOMAIN BUFFERS
GOOD DISPLAY REFERENCE BOOST
PANEL FPC / STORAGE CAPACITORS
MCU OUTPUT BUFFER / DEFAULTS
BUSY RETURN / PANEL RESET DEFAULT
C602 is the flying capacitor: FLY to SW, never GND. Q601 source -> RESE -> R602; keep switch loops short. Panel generates HV. No external HV supply injection.
CS defaults HIGH; CLK/MOSI/DC/RESET LOW. EPD rail supplies U601.
OFF / unplugged: BUSY LOW is invalid, not ready. Finish refresh, sleep panel, hold safe pins before OFF.
FPC uses retained passive extension. BS1=0, write-only SPI. VDD_INT has its own capacitor; it is not the 3.3V rail.

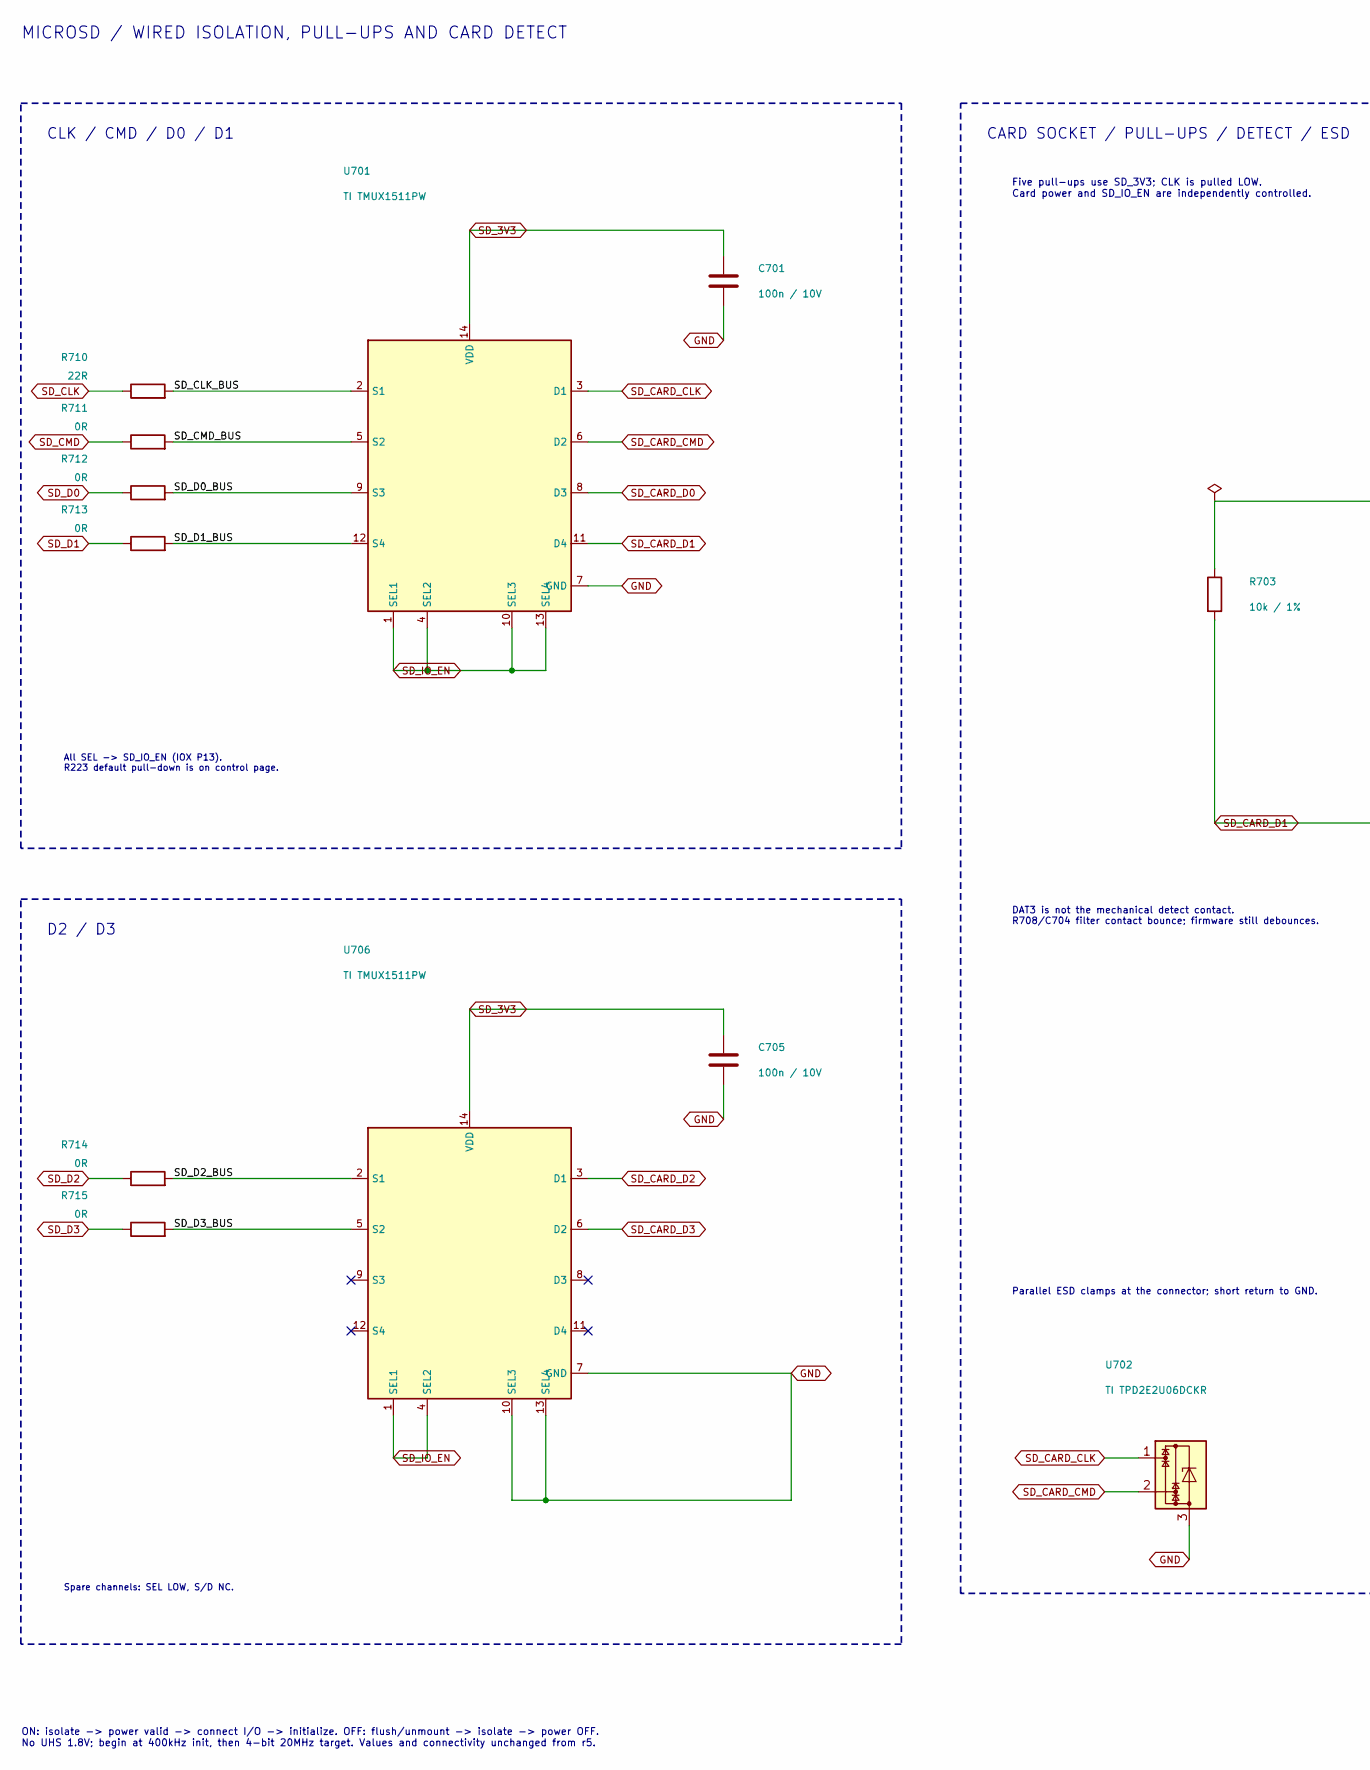
[picture p80: schematic STORAGE_SD.kicad_sch, MICROSD / 4-BIT BUS / INDEPENDENT SIGNAL ISOLATION, part in row 1, column 1]

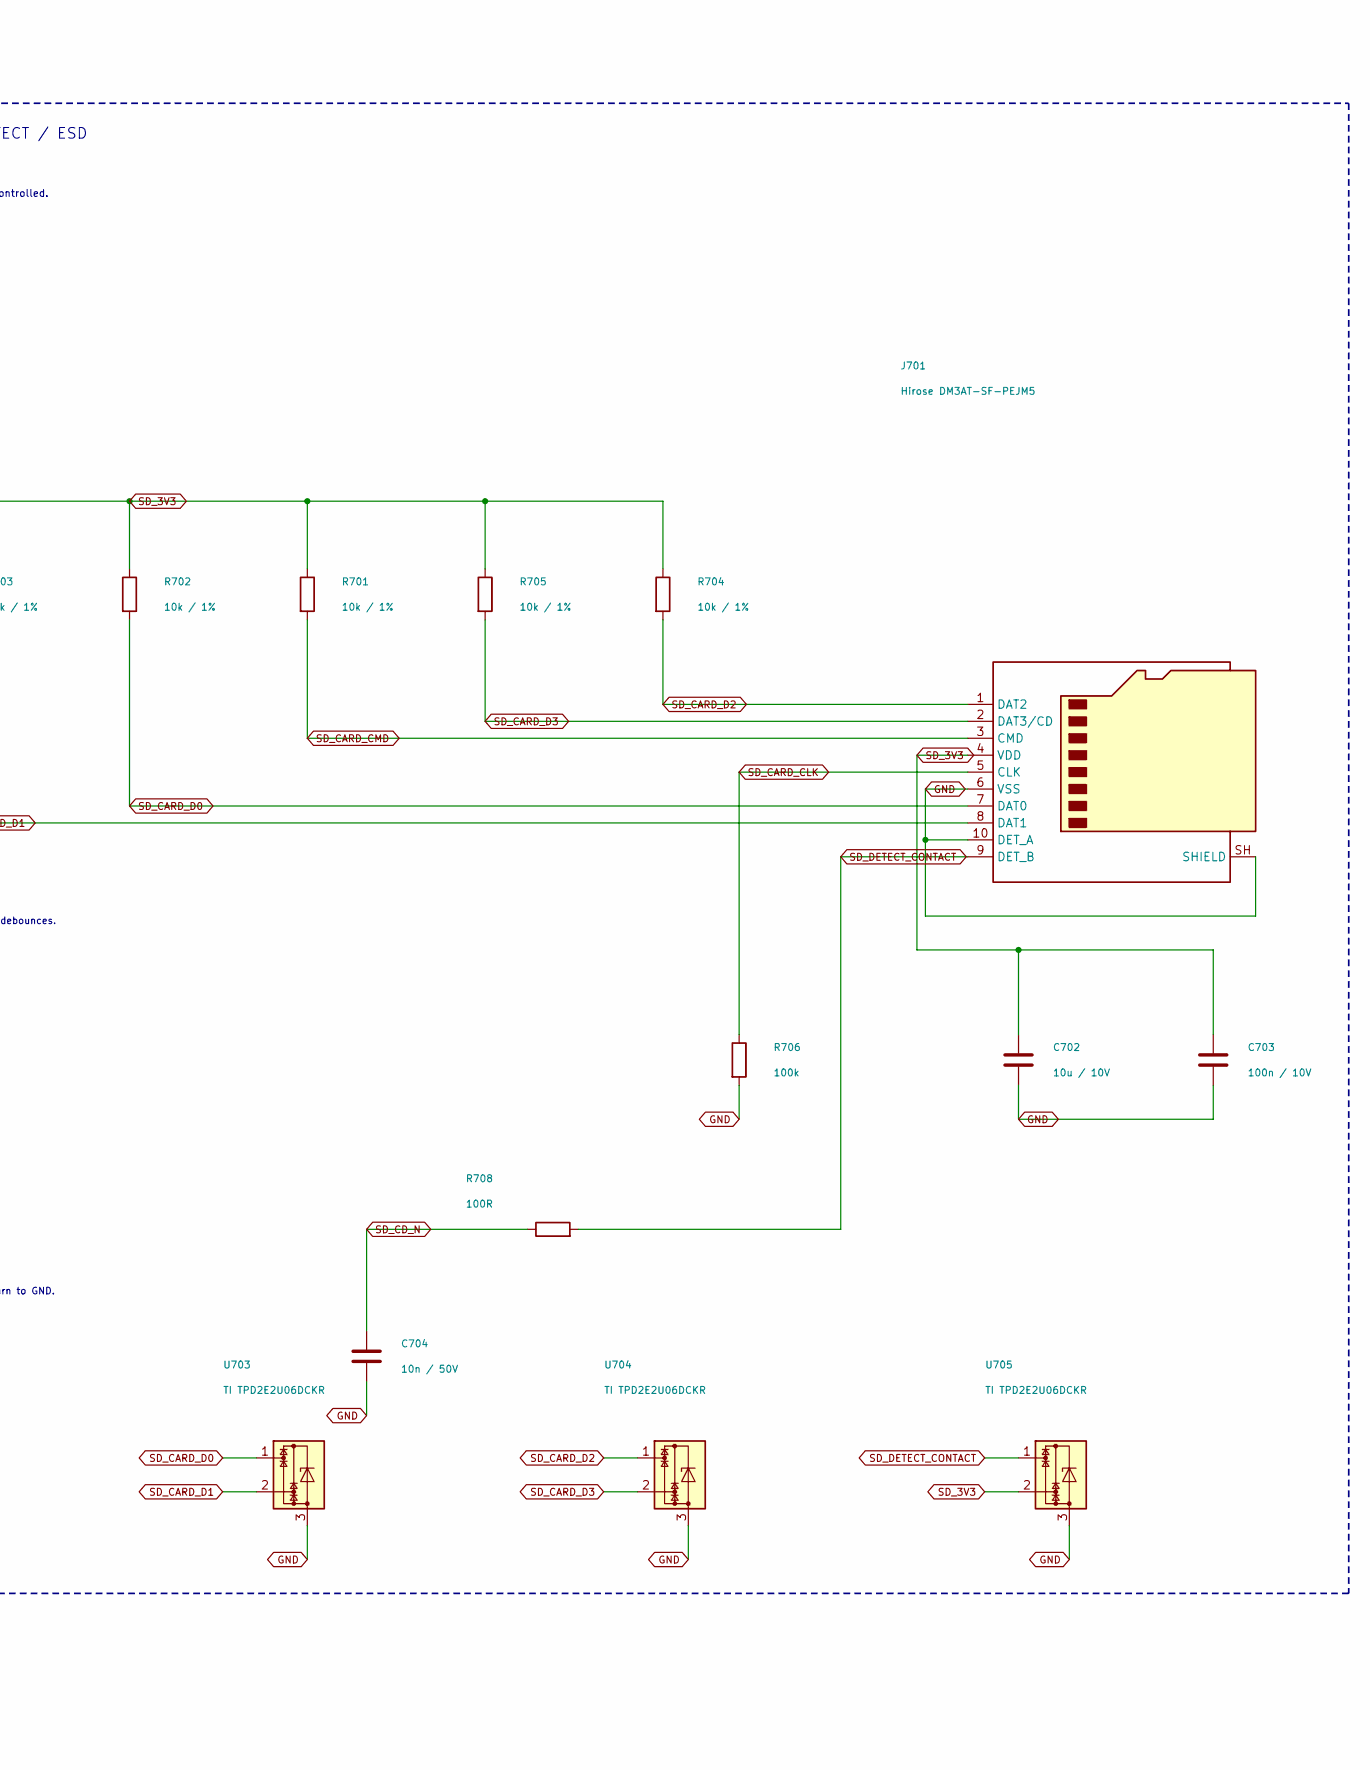
[picture p81: schematic STORAGE_SD.kicad_sch, MICROSD / 4-BIT BUS / INDEPENDENT SIGNAL ISOLATION, part in row 1, column 2]

Parts:
C701, C703, C705: 100n / 10V; C_0603_1608Metric
C702: 10u / 10V; C_0805_2012Metric
C704: 10n / 50V; C_0603_1608Metric
J701: Hirose DM3AT-SF-PEJM5; microSD_HC_Hirose_DM3AT-SF-PEJM5
R701, R702, R703, R704, R705: 10k / 1%; R_0603_1608Metric
R706: 100k; R_0603_1608Metric
R708: 100R; R_0603_1608Metric
R710: 22R; R_0603_1608Metric
R711, R712, R713, R714, R715: 0R; R_0603_1608Metric
U701, U706: TI TMUX1511PW; TSSOP-14_4.4x5mm_P0.65mm
U702, U703, U704, U705: TI TPD2E2U06DCKR; TI_DCK0003A_SC70_3_Recommended

Connections:
/STORAGE_SD/SD_CLK_BUS: R710.2, U701.2 (S1)
/STORAGE_SD/SD_CMD_BUS: R711.2, U701.5 (S2)
/STORAGE_SD/SD_D0_BUS: R712.2, U701.9 (S3)
/STORAGE_SD/SD_D1_BUS: R713.2, U701.12 (S4)
/STORAGE_SD/SD_D2_BUS: R714.2, U706.2 (S1)
/STORAGE_SD/SD_D3_BUS: R715.2, U706.5 (S2)
GND: C701.2, C702.2, C703.2, C704.2, C705.2, J701.6 (VSS), J701.10 (DET_A), J701.SH (SHIELD), R706.2, U701.7 (GND), U702.3, U703.3, U704.3, U705.3, U706.7 (GND), U706.10 (SEL3), U706.13 (SEL4); also elsewhere on the board
SD_3V3: C701.1, C702.1, C703.1, C705.1, J701.4 (VDD), R701.1, R702.1, R703.1, R704.1, R705.1, U701.14 (VDD), U705.2, U706.14 (VDD); also elsewhere on the board
SD_CARD_CLK: J701.5 (CLK), R706.1, U701.3 (D1), U702.1
SD_CARD_CMD: J701.3 (CMD), R701.2, U701.6 (D2), U702.2
SD_CARD_D0: J701.7 (DAT0), R702.2, U701.8 (D3), U703.1
SD_CARD_D1: J701.8 (DAT1), R703.2, U701.11 (D4), U703.2
SD_CARD_D2: J701.1 (DAT2), R704.2, U704.1, U706.3 (D1)
SD_CARD_D3: J701.2 (DAT3/CD), R705.2, U704.2, U706.6 (D2)
SD_CD_N: C704.1, R708.1; also elsewhere on the board
SD_CLK: R710.1; also elsewhere on the board
SD_CMD: R711.1; also elsewhere on the board
SD_D0: R712.1; also elsewhere on the board
SD_D1: R713.1; also elsewhere on the board
SD_D2: R714.1; also elsewhere on the board
SD_D3: R715.1; also elsewhere on the board
SD_DETECT_CONTACT: J701.9 (DET_B), R708.2, U705.1
SD_IO_EN: U701.1 (SEL1), U701.4 (SEL2), U701.10 (SEL3), U701.13 (SEL4), U706.1 (SEL1), U706.4 (SEL2); also elsewhere on the board

Notes on the sheet:
MICROSD / WIRED ISOLATION, PULL-UPS AND CARD DETECT
CLK / CMD / D0 / D1
D2 / D3
CARD SOCKET / PULL-UPS / DETECT / ESD
All SEL -> SD_IO_EN (IOX P13). R223 default pull-down is on control page.
Spare channels: SEL LOW, S/D NC.
Five pull-ups use SD_3V3; CLK is pulled LOW. Card power and SD_IO_EN are independently controlled.
DAT3 is not the mechanical detect contact. R708/C704 filter contact bounce; firmware still debounces.
Parallel ESD clamps at the connector; short return to GND.
ON: isolate -> power valid -> connect I/O -> initialize. OFF: flush/unmount -> isolate -> power OFF. No UHS 1.8V; begin at 400kHz init, then 4-bit 20MHz target. Values and connectivity unchanged from r5.

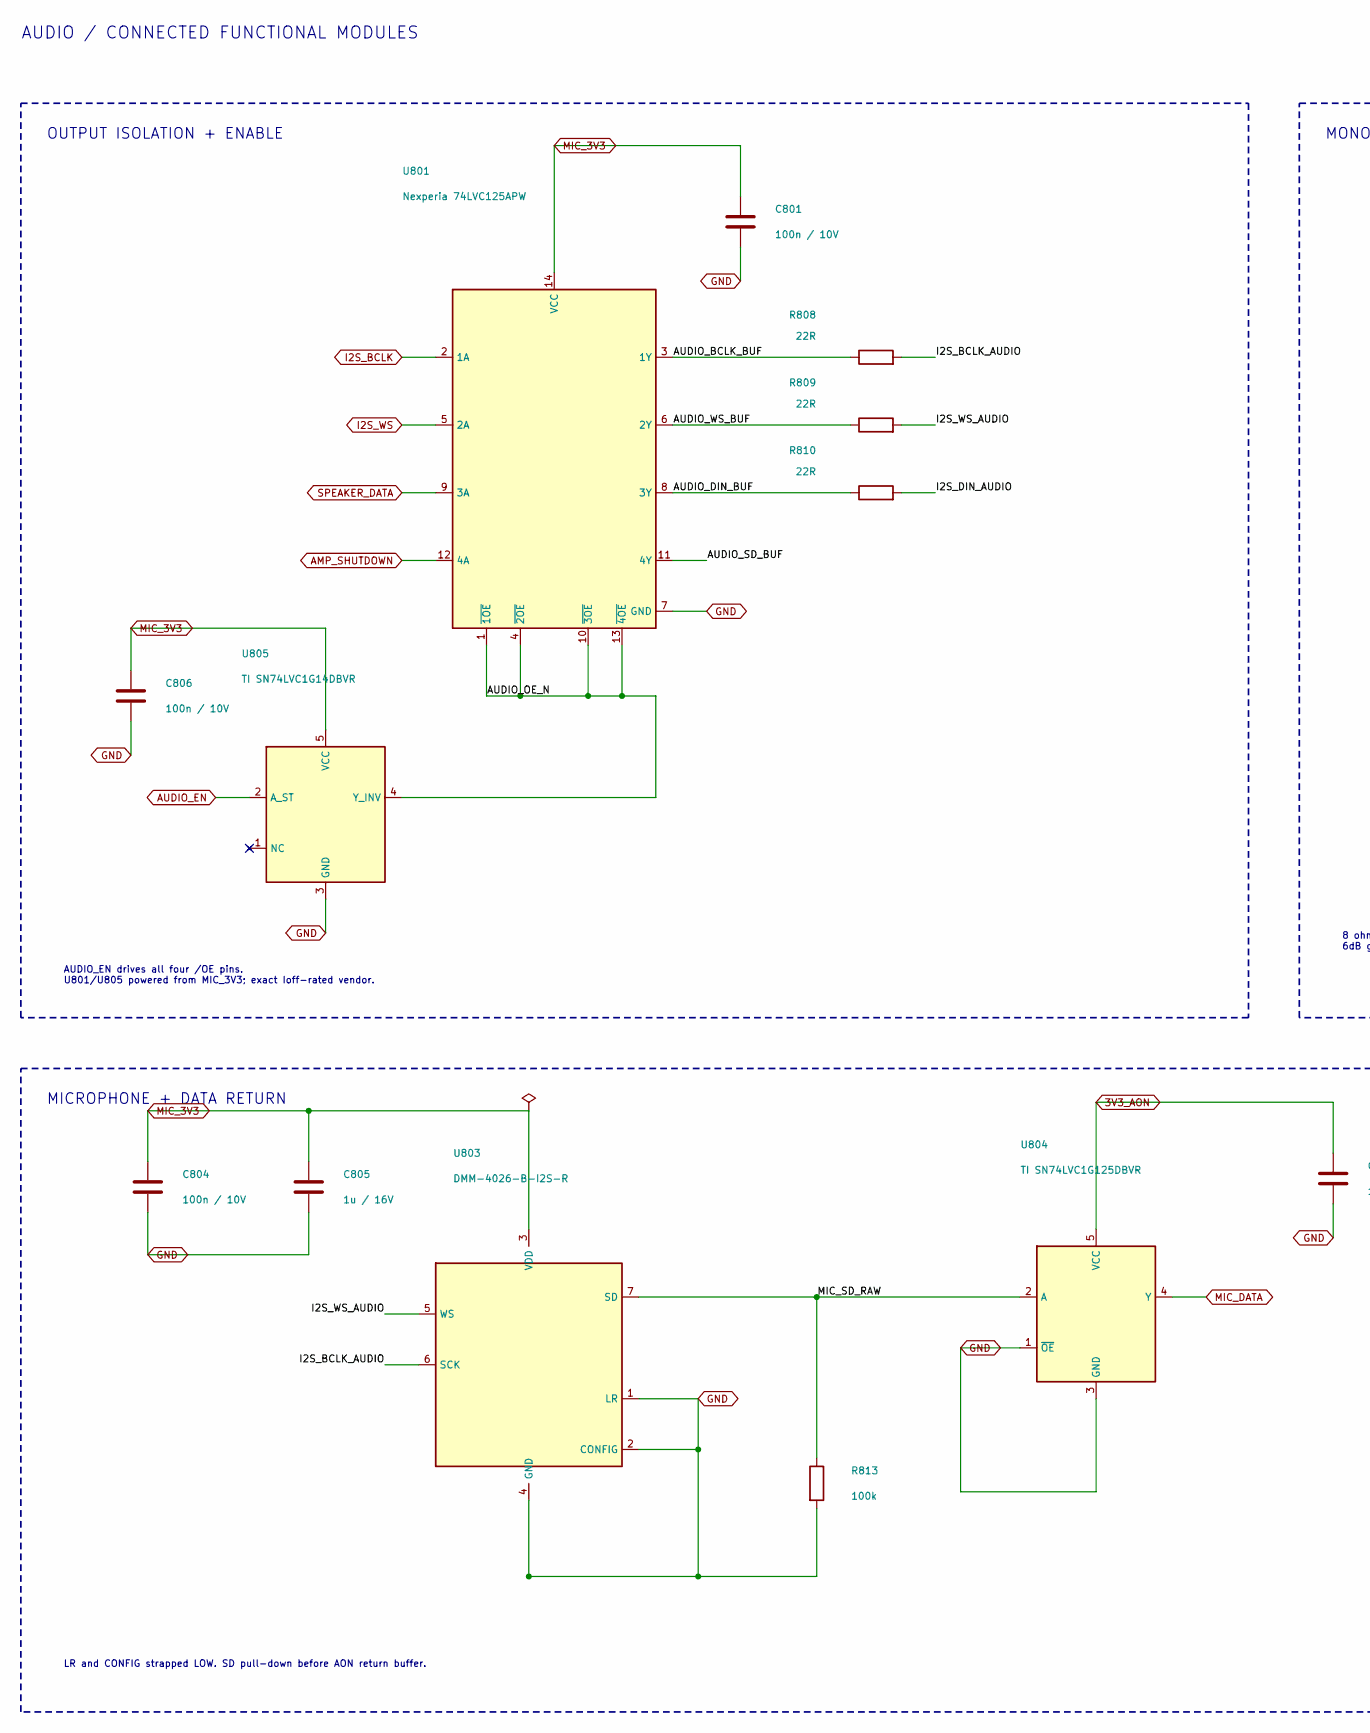
[picture p82: schematic AUDIO.kicad_sch, AUDIO / I2S INPUT ISOLATION / MONO PLAYBACK + MIC, part in row 1, column 1]

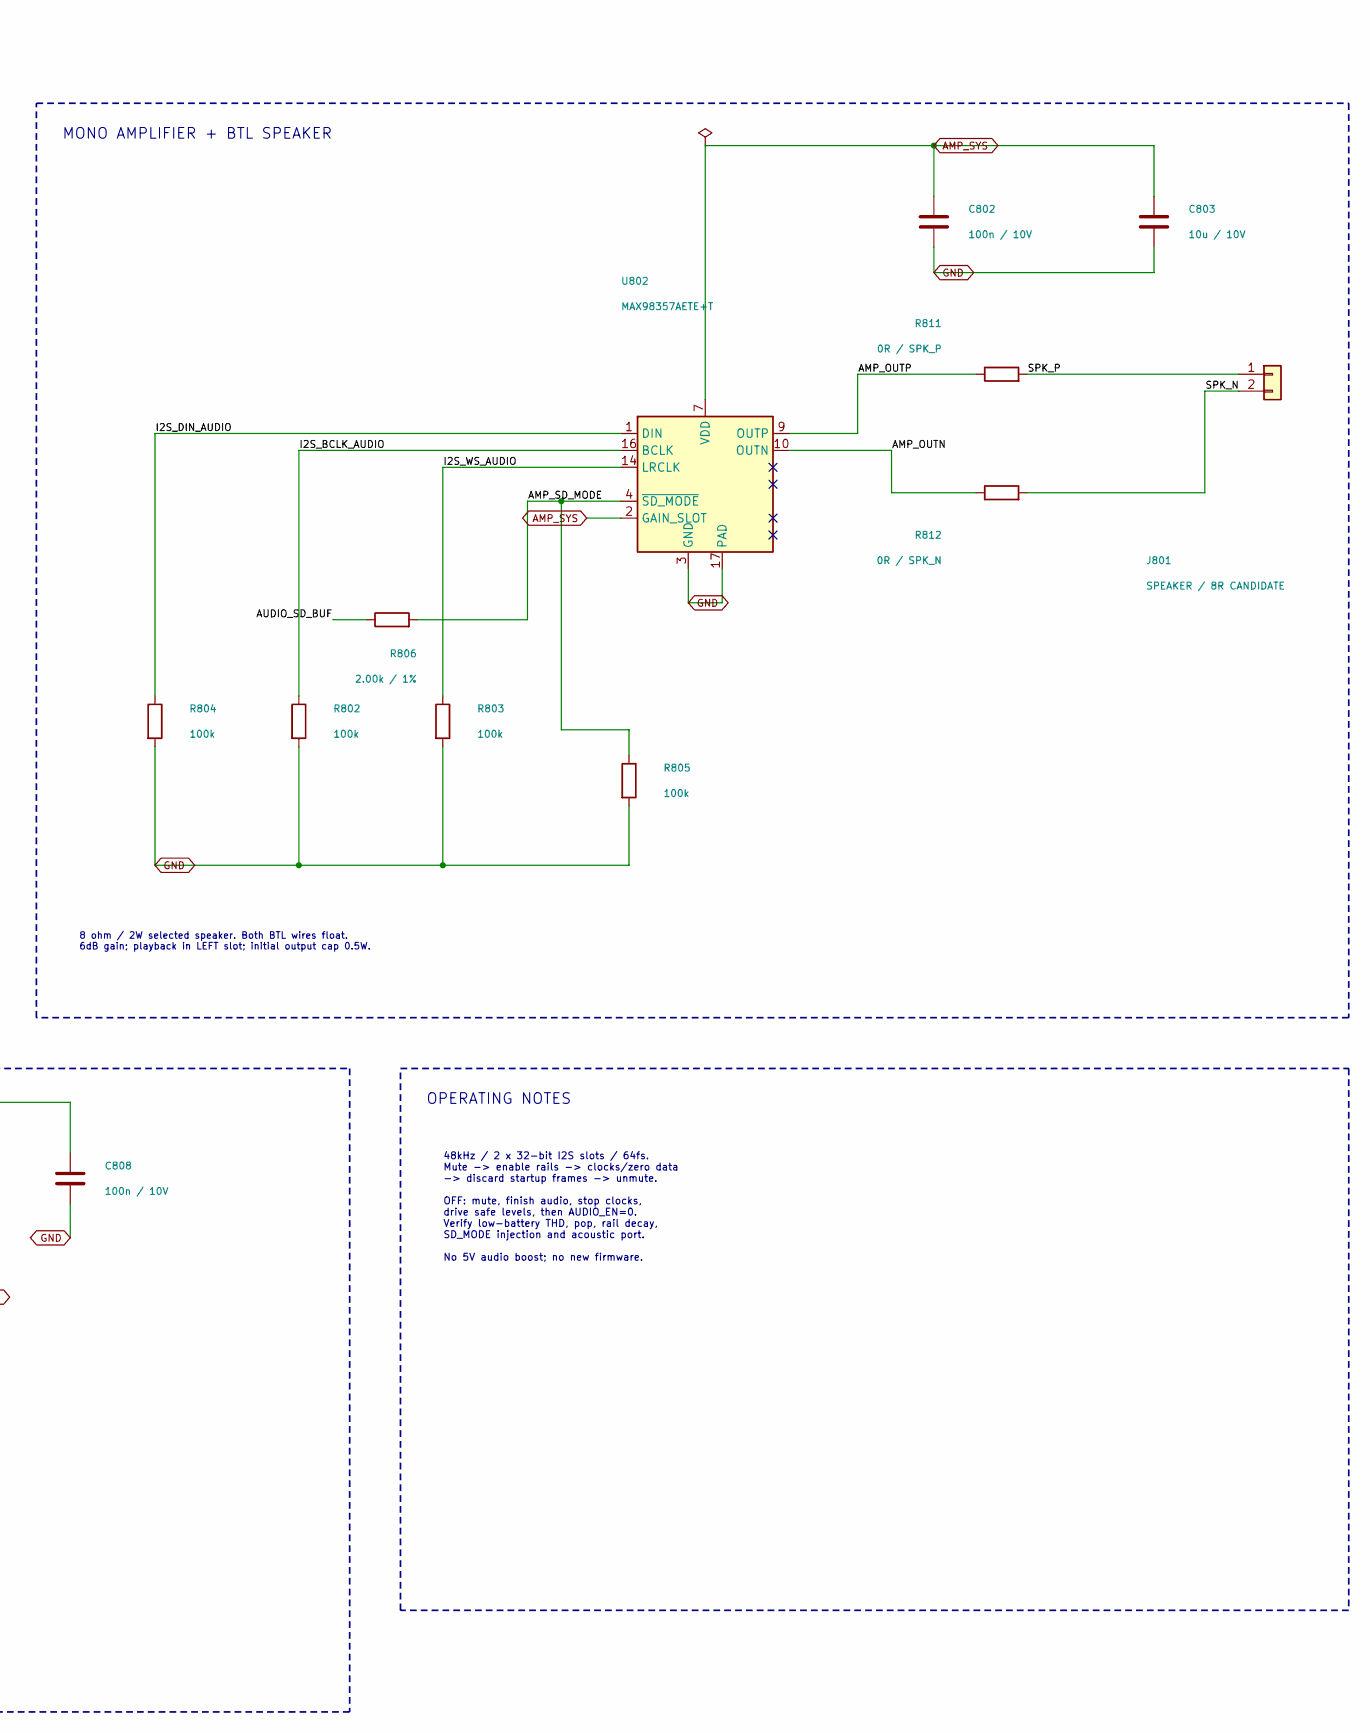
[picture p83: schematic AUDIO.kicad_sch, AUDIO / I2S INPUT ISOLATION / MONO PLAYBACK + MIC, part in row 1, column 2]

Parts:
C801, C802, C804, C806, C808: 100n / 10V; C_0603_1608Metric
C803: 10u / 10V; C_0805_2012Metric
C805: 1u / 16V; C_0603_1608Metric
J801: SPEAKER / 8R CANDIDATE; PhoenixContact_MKDS-1-2-3.5_1751248_1x02_P3.50mm_Horizontal
R802, R803, R804, R805, R813: 100k; R_0603_1608Metric
R806: 2.00k / 1%; R_0603_1608Metric
R808, R809, R810: 22R; R_0603_1608Metric
R811: 0R / SPK_P; R_0805_2012Metric
R812: 0R / SPK_N; R_0805_2012Metric
U801: Nexperia 74LVC125APW; TSSOP-14_4.4x5mm_P0.65mm
U802: MAX98357AETE+T; Analog_MAX98357A_T1633-4_3x3mm_P0.5mm_EP1.23mm
U803: DMM-4026-B-I2S-R; PUI_DMM_4026_B_I2S_R_7Pad_NPTH0.60
U804: TI SN74LVC1G125DBVR; SOT-23-5
U805: TI SN74LVC1G14DBVR; SOT-23-5

Connections:
3V3_AON: C808.1, U804.5 (VCC); also elsewhere on the board
/AUDIO/AMP_OUTN: R812.1, U802.10 (OUTN)
/AUDIO/AMP_OUTP: R811.1, U802.9 (OUTP)
/AUDIO/AMP_SD_MODE: R805.1, R806.2, U802.4 (~SD_MODE)
/AUDIO/AUDIO_BCLK_BUF: R808.1, U801.3 (1Y)
/AUDIO/AUDIO_DIN_BUF: R810.1, U801.8 (3Y)
/AUDIO/AUDIO_OE_N: U801.1 (~1OE), U801.4 (~2OE), U801.10 (~3OE), U801.13 (~4OE), U805.4 (Y_INV)
/AUDIO/AUDIO_SD_BUF: R806.1, U801.11 (4Y)
/AUDIO/AUDIO_WS_BUF: R809.1, U801.6 (2Y)
/AUDIO/I2S_BCLK_AUDIO: R802.1, R808.2, U802.16 (BCLK), U803.6 (SCK)
/AUDIO/I2S_DIN_AUDIO: R804.1, R810.2, U802.1 (DIN)
/AUDIO/I2S_WS_AUDIO: R803.1, R809.2, U802.14 (LRCLK), U803.5 (WS)
/AUDIO/MIC_SD_RAW: R813.1, U803.7 (SD), U804.2 (A)
/AUDIO/SPK_N: J801.2, R812.2
/AUDIO/SPK_P: J801.1, R811.2
AMP_SHUTDOWN: U801.12 (4A); also elsewhere on the board
AMP_SYS: C802.1, C803.1, U802.2 (GAIN_SLOT), U802.7 (VDD), U802.8 (VDD); also elsewhere on the board
AUDIO_EN: U805.2 (A_ST); also elsewhere on the board
GND: C801.2, C802.2, C803.2, C804.2, C805.2, C806.2, C808.2, R802.2, R803.2, R804.2, R805.2, R813.2, U801.7 (GND), U802.3 (GND), U802.11 (GND), U802.15 (GND), U802.17 (PAD), U803.1 (LR), U803.2 (CONFIG), U803.4 (GND), U804.1 (~OE), U804.3 (GND), U805.3 (GND); also elsewhere on the board
I2S_BCLK: U801.2 (1A); also elsewhere on the board
I2S_WS: U801.5 (2A); also elsewhere on the board
MIC_3V3: C801.1, C804.1, C805.1, C806.1, U801.14 (VCC), U803.3 (VDD), U805.5 (VCC); also elsewhere on the board
MIC_DATA: U804.4 (Y); also elsewhere on the board
SPEAKER_DATA: U801.9 (3A); also elsewhere on the board

Notes on the sheet:
AUDIO / CONNECTED FUNCTIONAL MODULES
OUTPUT ISOLATION + ENABLE
MONO AMPLIFIER + BTL SPEAKER
MICROPHONE + DATA RETURN
OPERATING NOTES
AUDIO_EN drives all four /OE pins. U801/U805 powered from MIC_3V3; exact Ioff-rated vendor.
8 ohm / 2W selected speaker. Both BTL wires float. 6dB gain; playback in LEFT slot; initial output cap 0.5W.
LR and CONFIG strapped LOW. SD pull-down before AON return buffer.
48kHz / 2 x 32-bit I2S slots / 64fs. Mute -> enable rails -> clocks/zero data -> discard startup frames -> unmute. OFF: mute, finish audio, stop clocks, drive safe levels, then AUDIO_EN=0. Verify low-battery THD, pop, rail decay, SD_MODE injection and acoustic port. No 5V audio boost; no new firmwa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
