xiaobaoaaaaaa/ESPaperPlay-V2/hardware/devboard-r0/ESPaperPlay_Devboard.kicad_pcb

## KiCad design hardware/devboard-r0/ESPaperPlay_Devboard.kicad_pcb (continued)

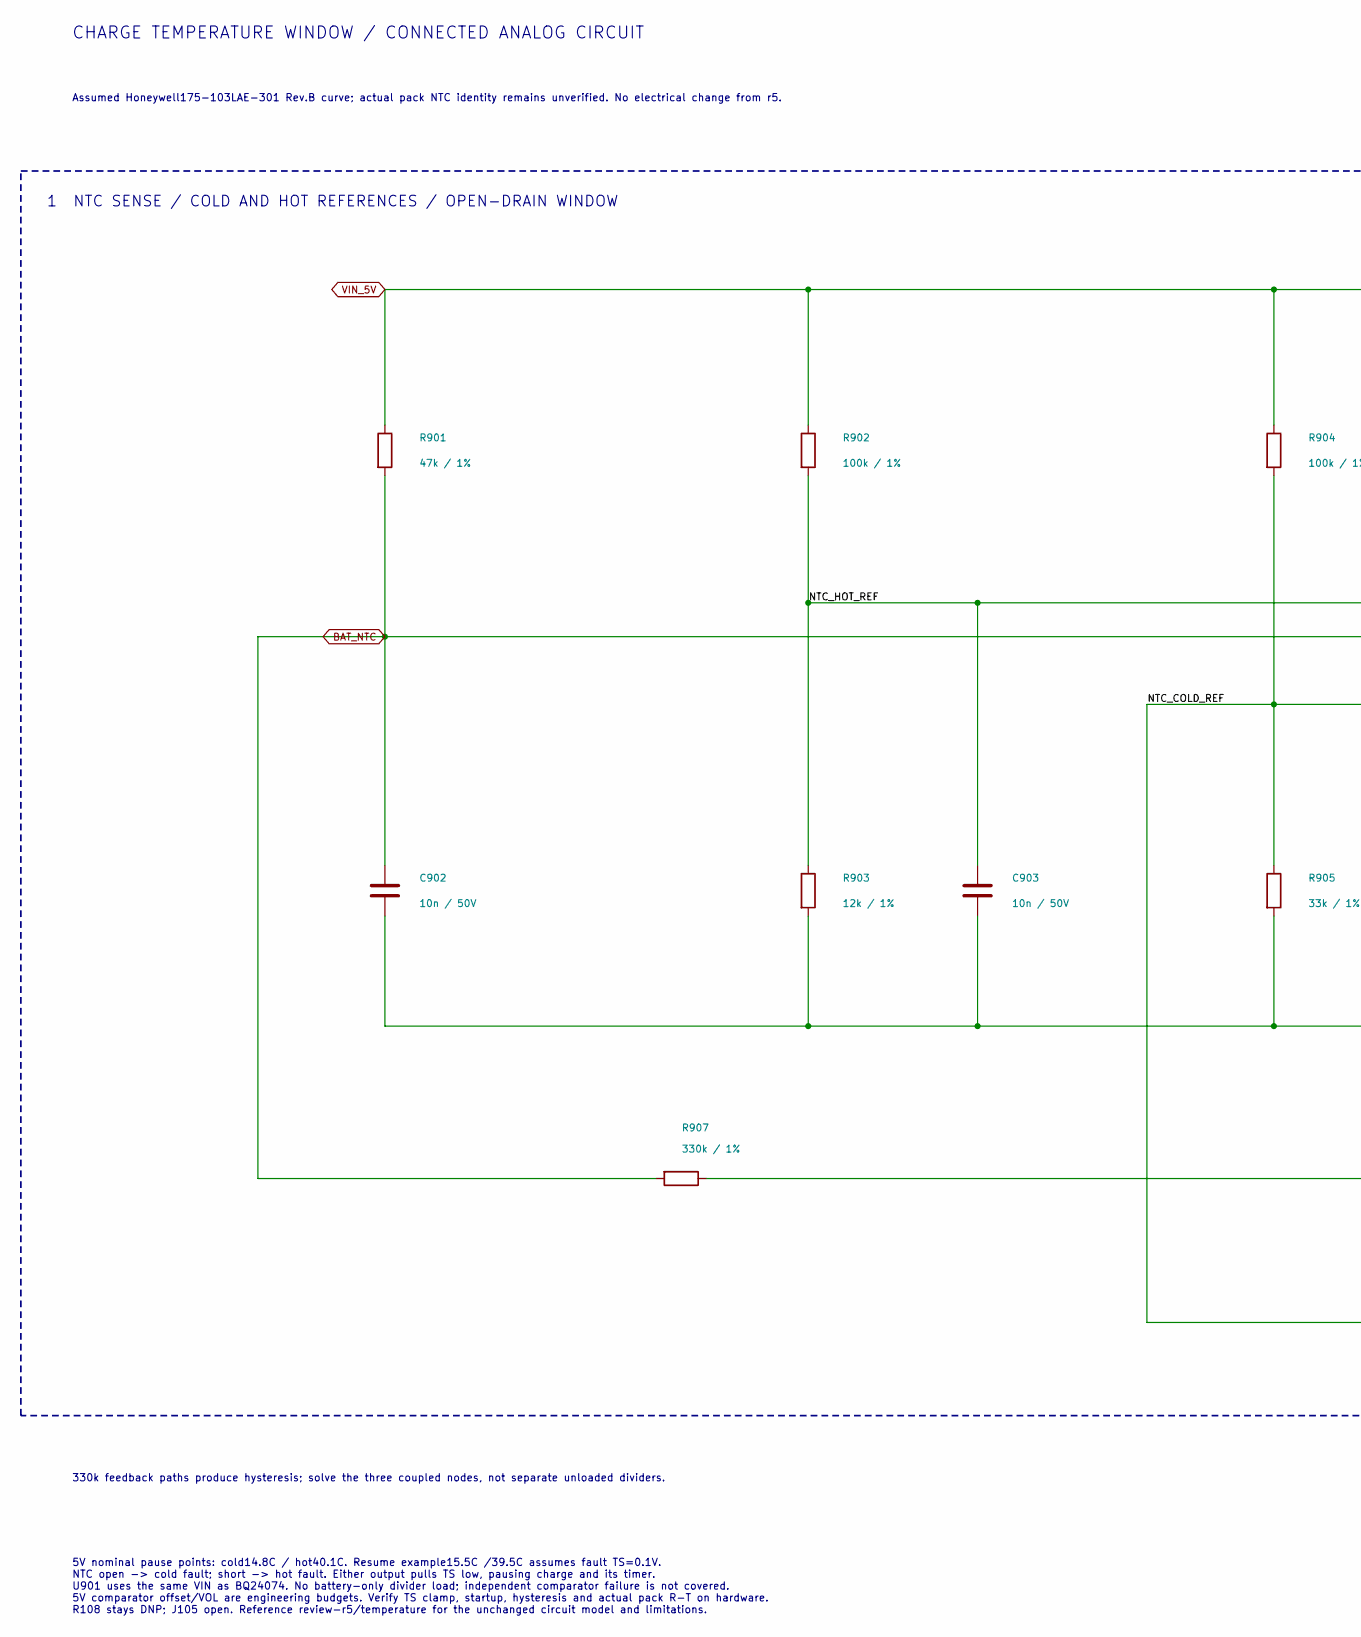
[picture p84: schematic CHARGE_TEMP.kicad_sch, Battery temperature window / TS pause, part in row 1, column 1]

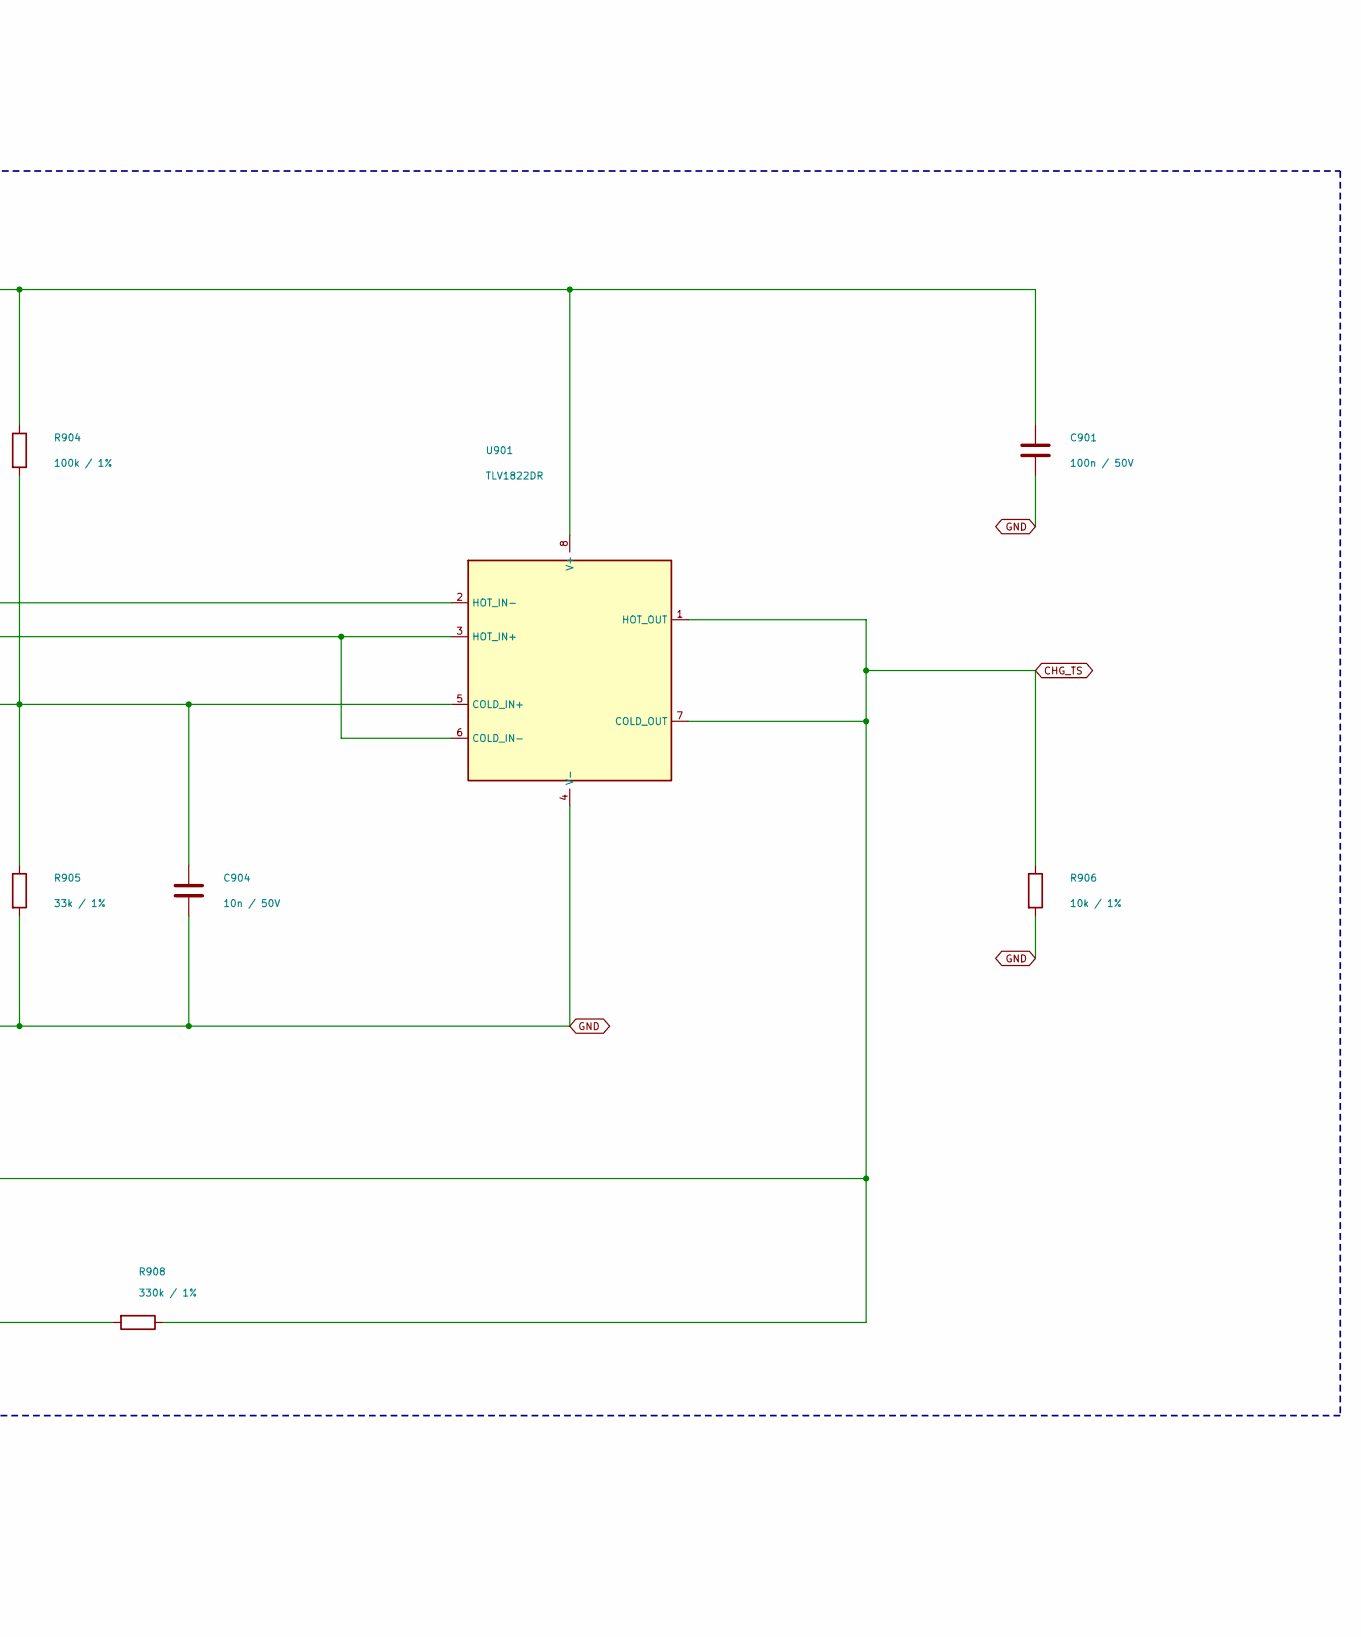
[picture p85: schematic CHARGE_TEMP.kicad_sch, Battery temperature window / TS pause, part in row 1, column 2]

Parts:
C901: 100n / 50V; C_0603_1608Metric
C902, C903, C904: 10n / 50V; C_0603_1608Metric
R901: 47k / 1%; R_0603_1608Metric
R902, R904: 100k / 1%; R_0603_1608Metric
R903: 12k / 1%; R_0603_1608Metric
R905: 33k / 1%; R_0603_1608Metric
R906: 10k / 1%; R_0603_1608Metric
R907, R908: 330k / 1%; R_0603_1608Metric
U901: TLV1822DR; TI_D0008A_SOIC8

Connections:
/CHARGE_TEMP/NTC_COLD_REF: C904.1, R904.2, R905.1, R908.2, U901.5 (COLD_IN+)
/CHARGE_TEMP/NTC_HOT_REF: C903.1, R902.2, R903.1, U901.2 (HOT_IN-)
BAT_NTC: C902.1, R901.2, R907.2, U901.3 (HOT_IN+), U901.6 (COLD_IN-); also elsewhere on the board
CHG_TS: R906.1, R907.1, R908.1, U901.1 (HOT_OUT), U901.7 (COLD_OUT); also elsewhere on the board
GND: C901.2, C902.2, C903.2, C904.2, R903.2, R905.2, R906.2, U901.4 (V-); also elsewhere on the board
VIN_5V: C901.1, R901.1, R902.1, R904.1, U901.8 (V+); also elsewhere on the board

Notes on the sheet:
CHARGE TEMPERATURE WINDOW / CONNECTED ANALOG CIRCUIT
Assumed Honeywell175-103LAE-301 Rev.B curve; actual pack NTC identity remains unverified. No electrical change from r5.
1 NTC SENSE / COLD AND HOT REFERENCES / OPEN-DRAIN WINDOW
330k feedback paths produce hysteresis; solve the three coupled nodes, not separate unloaded dividers.
5V nominal pause points: cold14.8C / hot40.1C. Resume example15.5C /39.5C assumes fault TS=0.1V. NTC open -> cold fault; short -> hot fault. Either output pulls TS low, pausing charge and its timer. U901 uses the same VIN as BQ24074. No battery-only divider load; independent comparator failure is n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

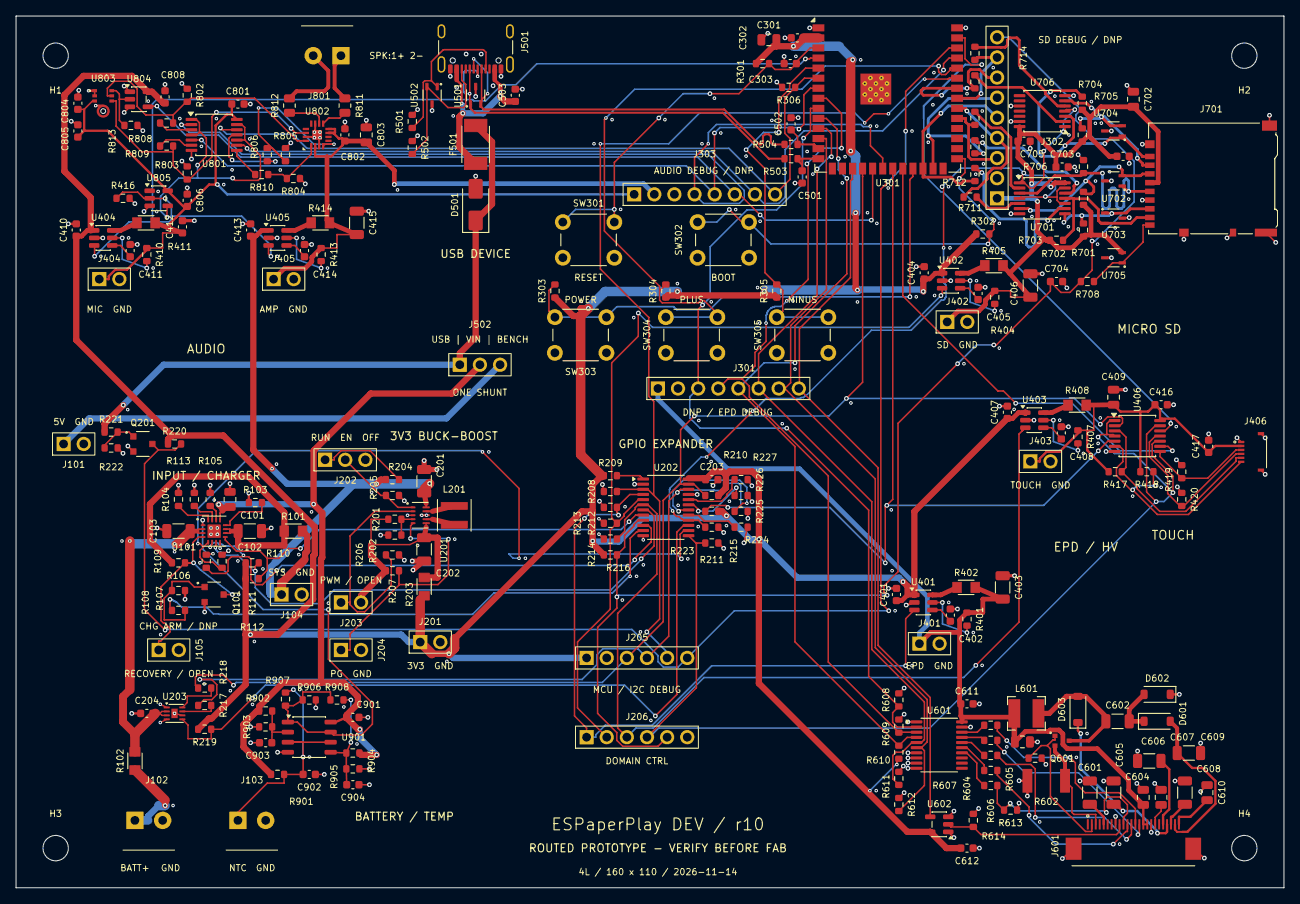
[picture p86: board ESPaperPlay_Devboard.kicad_pcb from above]

Board: 4 copper layers, 160.0 x 110.0 mm, 240 parts (0 on the bottom side), 156 nets.

Other parts of the board:
H1, H2, H3, H4: M3 NPTH; MountingHole_3.2mm_M3
