xiaobaoaaaaaa/ESPaperPlay-V2/(commit log)

2026-11-06 chore: initialize standalone ESPaperPlay V2 baseline
    [AUDIO.kicad_sch, CHARGE_TEMP.kicad_sch, EPD_DISPLAY.kicad_sch, ESPaperPlay_BOM_Review_r3.xlsx, ESPaperPlay_BOM_Review_r4.xlsx, ESPaperPlay_Devboard.kicad_pcb, ESPaperPlay_Devboard.kicad_sch, MCU_CORE.kicad_sch]
2026-11-06 Complete r8 PCB routing and native verification
    [ESPaperPlay_Devboard.kicad_pcb]
2026-11-11 Prepare r9 manufacturing review and DIY assembly package
    [ESPaperPlay_Devboard-B_Cu.gbl, ESPaperPlay_Devboard-B_Mask.gbs, ESPaperPlay_Devboard-B_Silkscreen.gbo, ESPaperPlay_Devboard-DIY-F_Paste.gtp, ESPaperPlay_Devboard-Edge_Cuts.gm1, ESPaperPlay_Devboard-F_Cu.gtl, ESPaperPlay_Devboard-F_Mask.gts, ESPaperPlay_Devboard-F_Silkscreen.gto]
2026-11-14 Resolve r10 PCB near-pad via clearances and fabrication process
    [ESPaperPlay_Devboard-B_Cu.gbl, ESPaperPlay_Devboard-B_Mask.gbs, ESPaperPlay_Devboard-B_Silkscreen.gbo, ESPaperPlay_Devboard-DIY-F_Paste.gtp, ESPaperPlay_Devboard-Edge_Cuts.gm1, ESPaperPlay_Devboard-F_Cu.gtl, ESPaperPlay_Devboard-F_Mask.gts, ESPaperPlay_Devboard-F_Silkscreen.gto]
2026-11-14 Prepare r10 first batch fabrication requirements and two-board assembly
